Blunk-electronic/TRAIN-Z/README.md

# TRAIN-Z
A open hardware and software embedded Z80 computer
Please find more colorful details at
http://www.blunk-electronic.de/train-z/
