Blunk-electronic/TRAIN-Z/hardware/bus_monitor/verilog/ise/main_summary.html

Z80_IF Project Status
Project File: | Z80_IF.ise | Implementation State: | Fitted
Module Name: | main | Errors: | No Errors
Target Device: | xc3s400-5pq208 | Warnings: | 7 Warnings
Product Version: | ISE 11.1 | Routing Results:
Design Goal: | Balanced | Timing Constraints:
Design Strategy: | Xilinx Default (unlocked) | Final Timing Score:

Detailed Reports | | | | | | [-]
Report Name | Status | Generated | Errors | Warnings | Infos
Synthesis Report | Current | Tue Sep 25 10:21:02 2012 | 0 | 7 Warnings | 0
Translation Report | Current | Tue Sep 25 10:21:07 2012 | 0 | 0 | 0
CPLD Fitter Report (Text) | Current | Tue Sep 25 10:21:10 2012 | 0 | 1 Warning | 0
Power Report

Secondary Reports | | | [-]
Report Name | Status | Generated
Post-Fit Simulation Model Report

Date Generated: 01/20/2015 - 09:17:47
