Blunk-electronic/TRAIN-Z/doc/pdf/um_bm_en.pdf

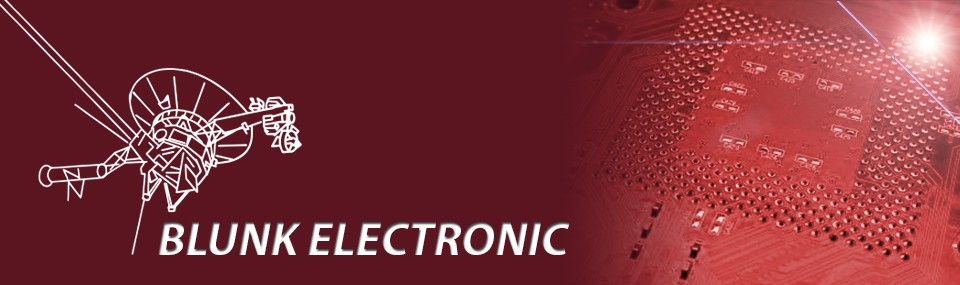
[picture p53: figure]

### PRODUCT BRIEF Self-Assembly Kit

# Z80 Bus Monitor & Cycle Stepper User Manual

## Please read carefully before power up !

Doc. Version 2013-10-28-1
Author: Mario Blunk

Firmware Version: V1.1
Hardware Version: V1.1

Blunk electronic at www.trainz.de (http://www.train-z.de/)

## Table of Contents

### 1 Preface

With the objective of improving System TRAIN-Z (http://www.train-z.de/train-z) toward a development system a bus monitor in connection with a cycle stepper circuitry was an immanent user demand. So a peripheral extension with these components has been designed. The whole unit, further on just referred to as Bus Monitor, fits on a single euro sized fourlayer board (160 x 100 mm). See Photo 1. It is fully programmable via any hardware description language like Verilog or VHDL. The HDL-design presented here has been written in Verilog on the Xilinx (http://www.xilinx.com/) System ISE.

System TRAIN-Z does not aim to compete with the

powerful and sophisticated embedded computer systems of today.

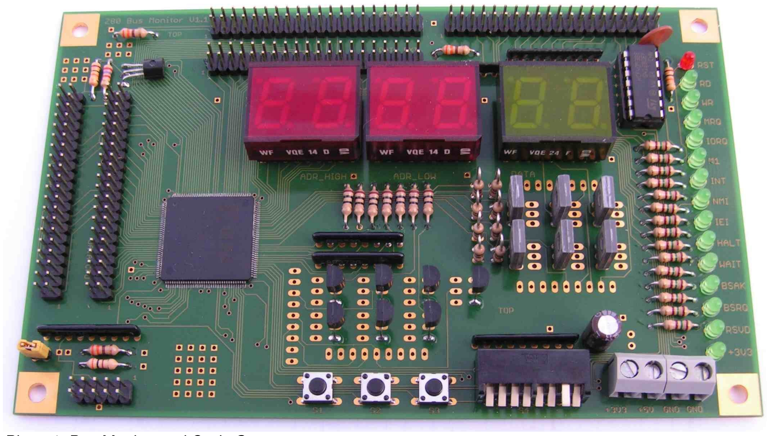
[picture p54: figure]

Blunk electronic at www.trainz.de (http://www.train-z.de/) | 3

Photo 1: Bus Monitor and Cycle Stepper

What is the Bus Monitor good for ?

Single Step Z80 mnemonics execution (Please have the listfile handy.)

Address, Data and Control signal Debugging

PIO mode to control user specific hardware

Level-Shifter from 5V Z80 world to 3,3V peripheral world

Direct mounting on top of System TRAIN-Z via standoffs.

### 2 Hardware

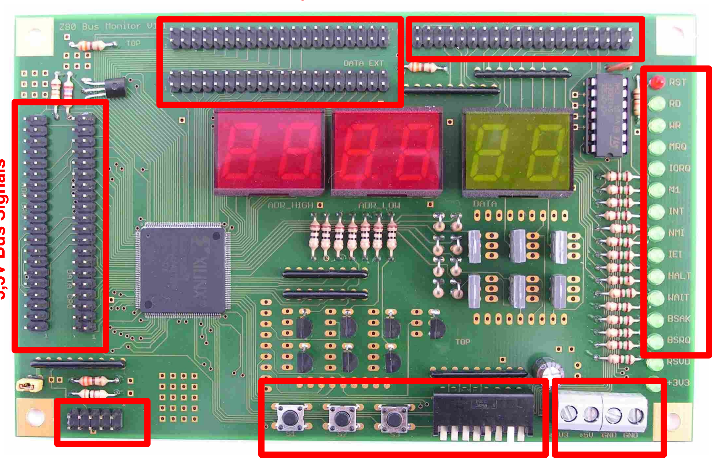
[picture p55: figure]

4 | Blunk electronic at www.trainz.de (http://www.train-z.de/)

Photo 2: Bus Monitor Top View

3,3V Bus Signals | PIO & DEBUG
Push-Buttons & Mode Switch | 3,3V power in JTAG

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
ntrol L

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
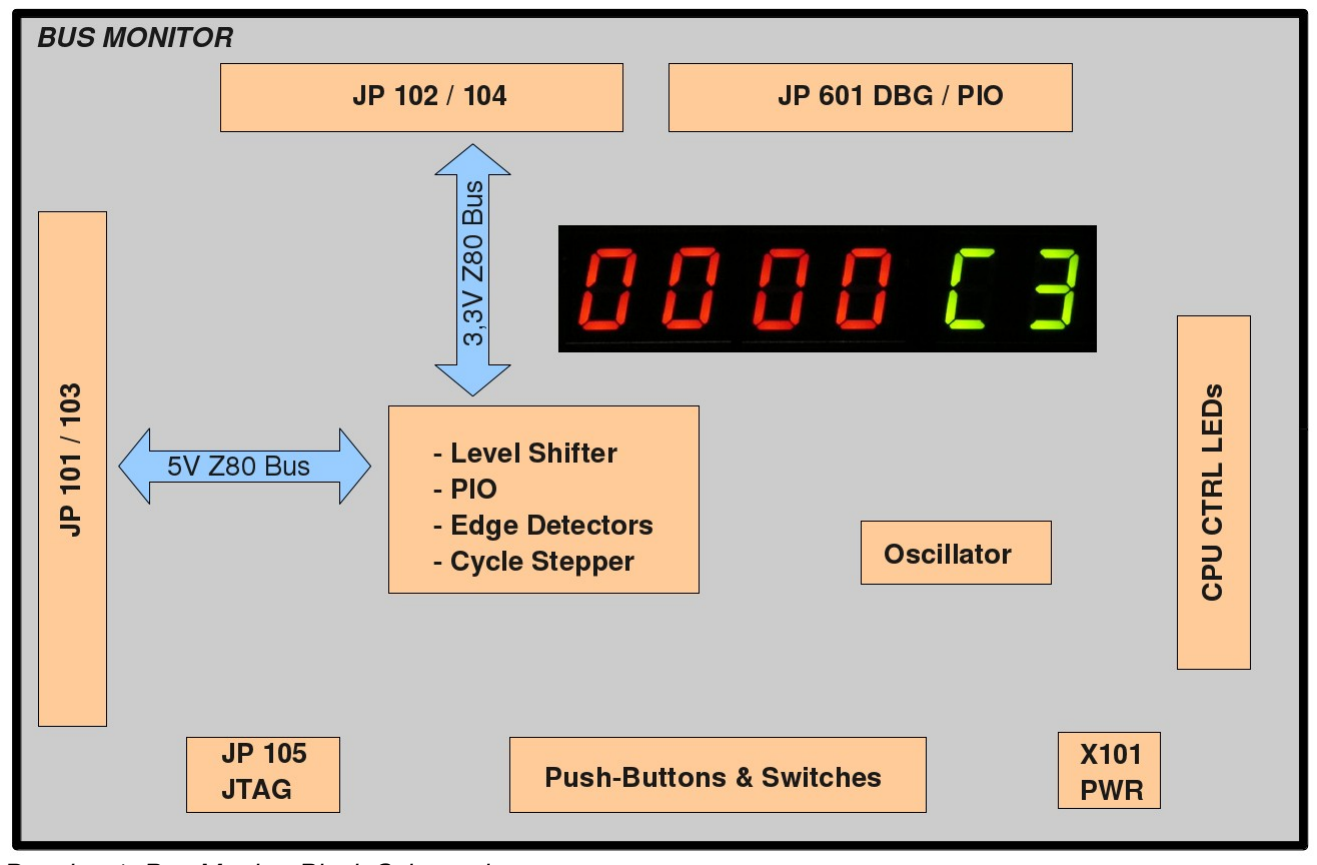
[picture p56: figure]

Drawing 1: Bus Monitor Block Schematic

2.1 Z80-System Bus Connectors

All 5V-signals of the system bus coming from the Z80 CPU are connected to JP101 and JP103. JP101 holds the data bus D[7..0], JP103 holds the address bus A[15..0]. The control signals are distributed on both JP101 and JP103. Drawing 2 shows the their pins. If ribbon cables get plugged on both of them the result is a GND signal between two bus signals. Most suitable are IDE-ribbon cables used in many PCs (Photo 3 page 6). Table 1 on page 7 and Table 2 on page 8 give the signals connected to JP101 and JP103.

All 3,3V-signals of the system bus going to the peripherals are connected to JP102 and JP104.

If not noted otherwise, the DC input/output specifications of these pins are to be found in the XC95288XL datasheet at www.xilinx.com.

Note: All wires of the IDE-ribbon cables must be accessible.

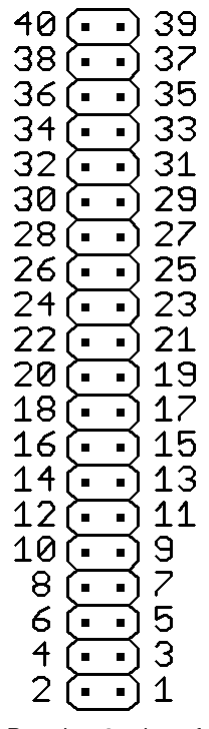
[picture p57: figure]

Drawing 2: pins of
JP101 / JP102 and
JP103 / JP104

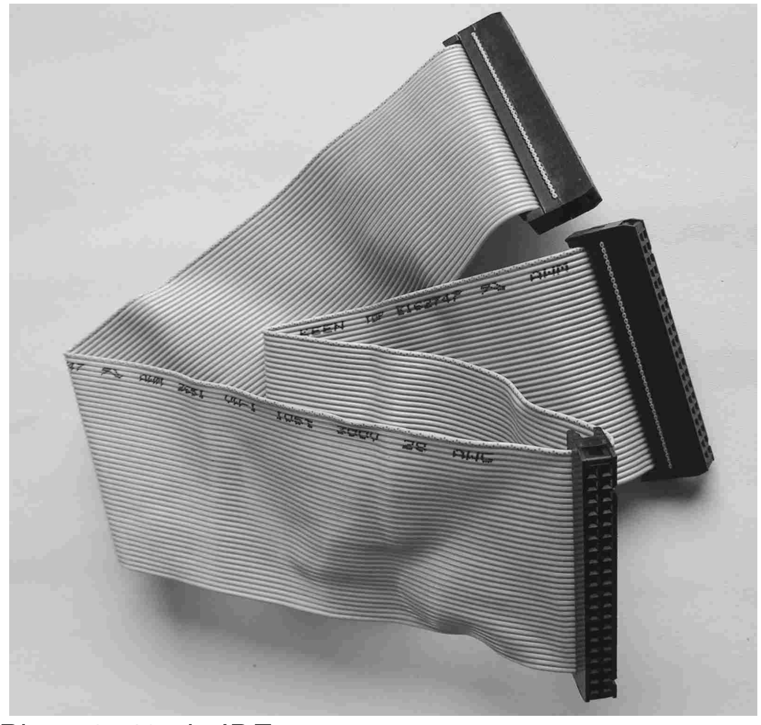
[picture p58: figure]

Photo 3: 40 pin IDE connector

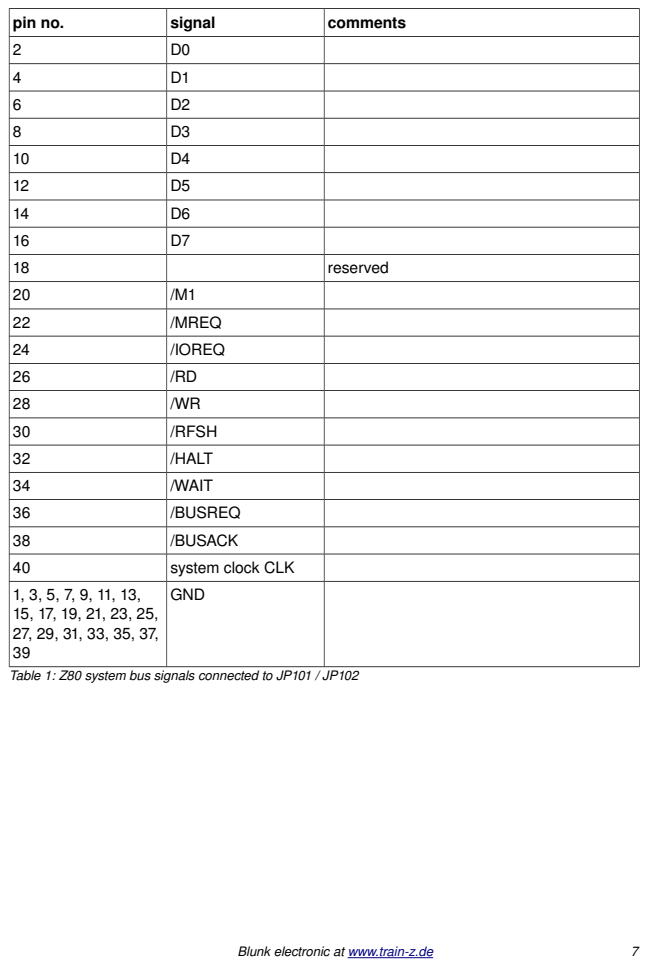
[picture p59: page 7]

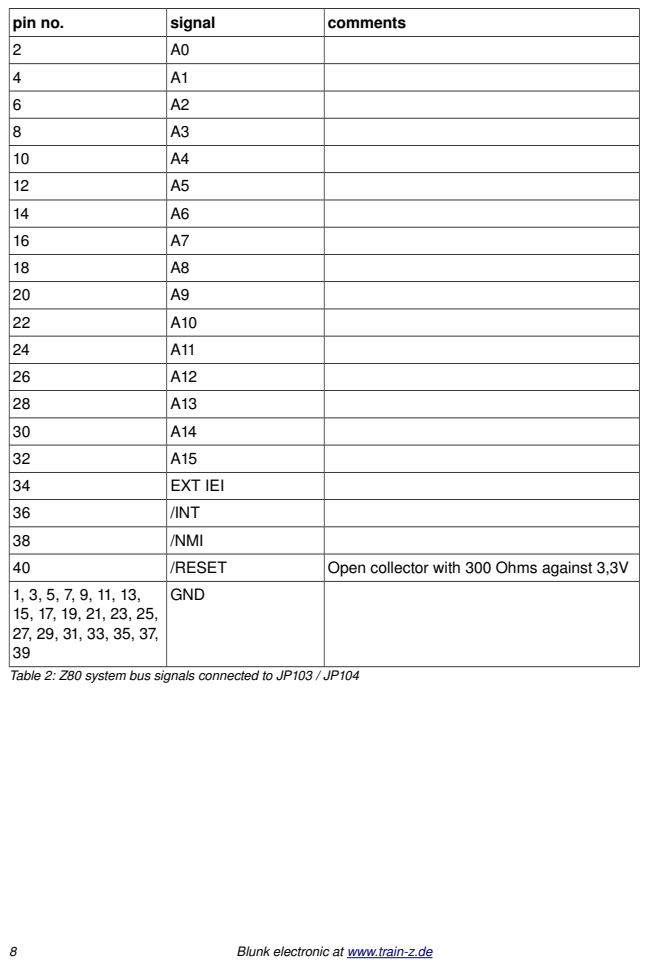
[picture p60: page 8]
pin no.; signal; comments; EXT IEI; /INT; /NMI; /RESET; Open collector with 300 Ohms against 3,3V; GND; Table 2: Z80 system bus signals connected to JP103 / JP104

2.2 PIO and Debug Connector

The eight 3,3V PIO channels are to be found at JP601. Furtheron signals for debugging, schmitttrigger in/outputs and
/CPU_RESET are accessible there.

If not noted otherwise, the DC input/output specifications of these pins are to be found in the XC95288XL datasheet at www.xilinx.com.

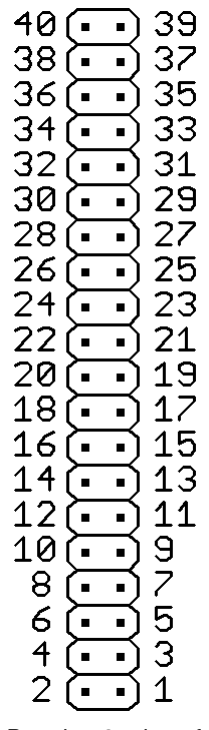
[picture p61: figure]

Drawing 3: pins of
JP601

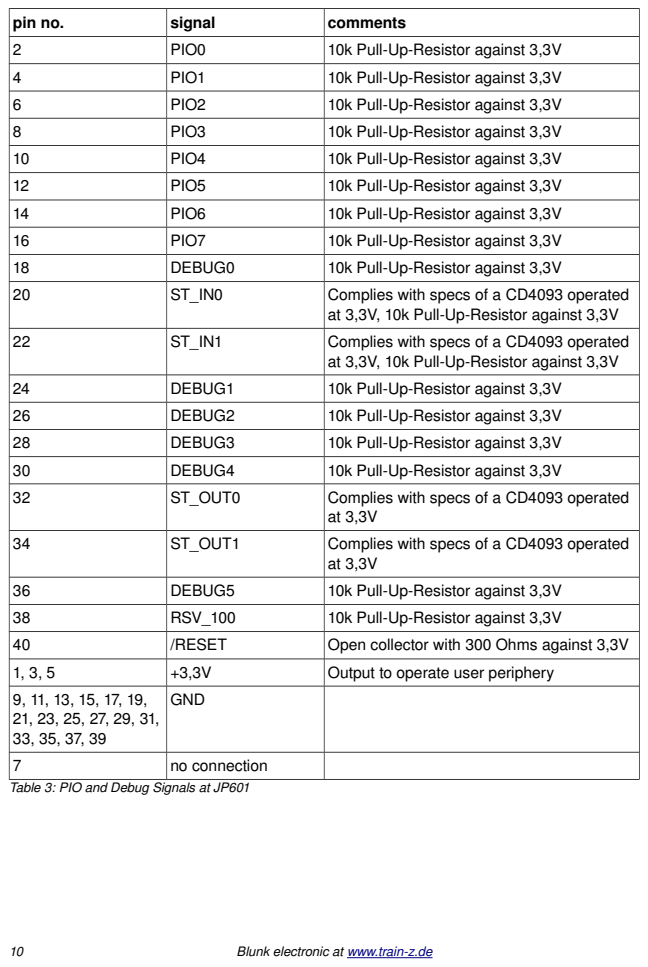
[picture p62: page 10]
pin no.; signal; comments; PIO0; 10k Pull-Up-Resistor against 3,3V; PIO1; PIO2; PIO3; PIO4; PIO5; PIO6; PIO7; DEBUG0; Complies with specs of a CD4093 operated; DEBUG1; DEBUG2; DEBUG3; DEBUG4; ST_OUT0; ST_OUT1; DEBUG5; RSV_100; /RESET; Open collector with 300 Ohms against 3,3V; Output to operate user periphery; GND; no connection

at 3,3V, 10k Pull-Up-Resistor against 3,3V

Table 3: PIO and Debug Signals at JP601

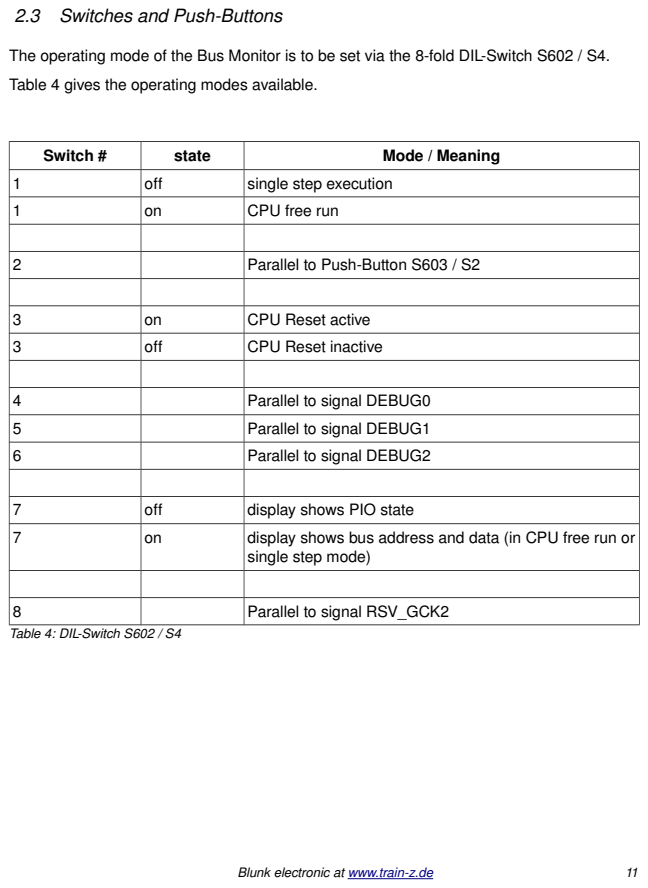
[picture p63: page 11]
Switch #; state; Mode / Meaning; off; single step execution; CPU free run; Parallel to Push-Button S603 / S2; CPU Reset active; CPU Reset inactive; Parallel to signal DEBUG0; Parallel to signal DEBUG1; Parallel to signal DEBUG2; display shows PIO state; display shows bus address and data (in CPU free run or; Parallel to signal RSV_GCK2

2.3 Switches and Push-Buttons

The operating mode of the Bus Monitor is to be set via the 8-fold DIL-Switch S602 / S4.
Table 4 gives the operating modes available.

single step mode)

Table 4: DIL-Switch S602 / S4

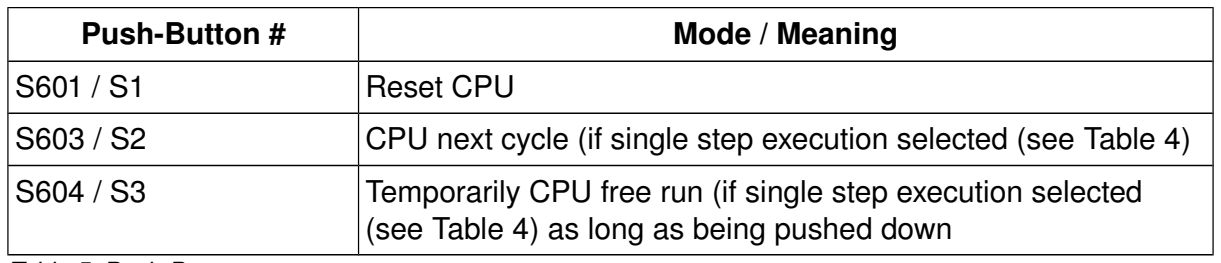
[picture p64: figure]
Push-Button #; Mode / Meaning; Reset CPU

S603 / S2 | CPU next cycle (if single step execution selected (see Table 4)
S604 / S3 | Temporarily CPU free run (if single step execution selected (see Table 4) as long as being pushed down

Table 5: Push-Buttons

2.4 Display

The Z80 Address and Data Bus or the PIO content may be displayed via the 6 digit LED displays DIS302, DIS301 (red) and DIS303 (green). In Bus Monitor mode the red displays show the current state of the address bus while the green display shows the data bus content.

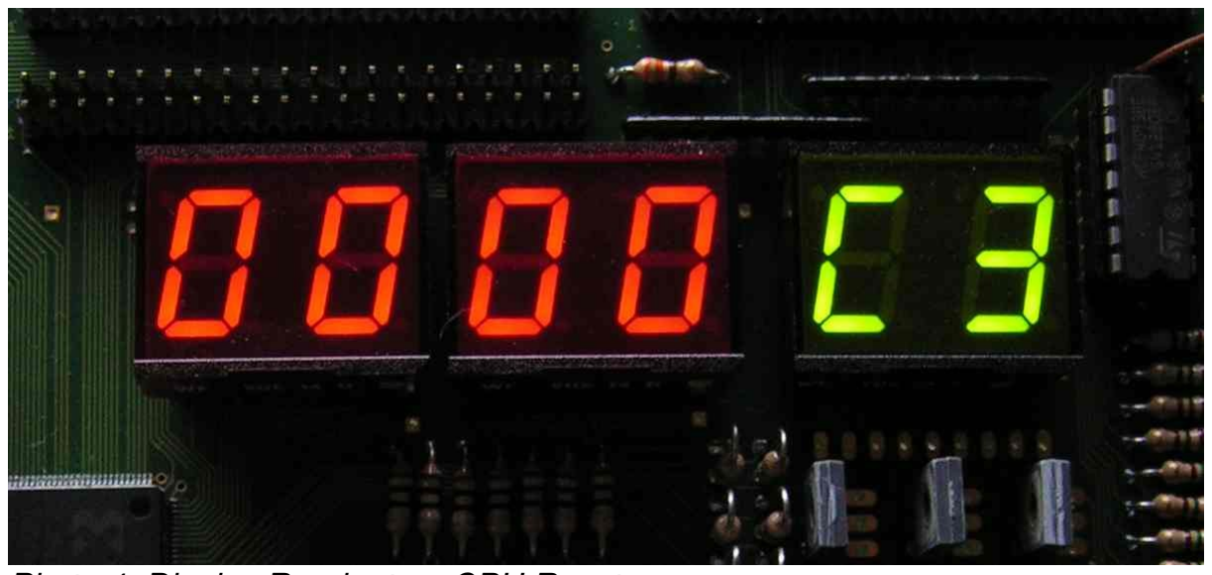
[picture p65: figure]

In PIO mode there are three eight bit wide output registers at I/O addresses 50h through 52h. They can be written at by CPU OUT commands any time. If switch 7 of S602 / S4 is off, the register content is displayed (see Table 4). Reading from these locations via the CPU IN commands is also possible any time. DIS302 and DIS301 show the content of the I/O addresses 51h and 52h.

Photo 4: Display Readout on CPU Reset

Adr[15:8] or
I/O Adr. 52h

Adr[7:0] or
I/O Adr. 51h

Data[7:0] or
I/O Adr. 50h

The output of the register at location 50h is of opendrain characteristic and is connected to JP601 (see Table 3 on page 10). The very bit of this register set to H may serve as input channel to read the status of the PIO signals at JP601. DIS303 (green) shows the content of that register.

As this is a selfassembly kit, the displays need to be soldered or plugged by the user.

2.5 CPU control LEDs

These green LEDs indicate High-Low transitions (or negative edges) occurring on the Z80 control signals. On edge detection the LED affected flashes for about 0,1 seconds. See Photo 2 on page 4. The meaning of the LEDs is self explaining.

Note: The status of the CPU REFRESH signal is not displayed via an LED.

2.6 JTAG / IEEE 1149.1

To program the CPLD the IEEE1149.1 signals are accessible via JP105 .SeeTable 6.


Pin | Meaning | comments
1 | TCK
3 | TMS
5 | TDI | default
7 | TDO
10 | Vref | Required Xilinx Programming Cable

2, 4, 6, 8 GND
Table 6: JTAG signals

NOTE: Some boundary scan masters may not require a reference voltage or may even get damaged if this voltage is provided by the Bus Monitor.

To disconnect the reference voltage provided by the Bus Monitor from JP105, please

Drawing 4: pins of
JP105 remove the jumper from JP106.

2.7 Schematics and Assembly Drawings

As these drawings are updated from time to time they are not included in this document. Please find them at:

# http://www.trainz.de/trainz/hw (http://www.train-z.de/train-z/hw)

2.8 Power Supply

The operating voltage of +3,3V into X101. Please refer to the assembly drawing for labeling of X101. The green LED D101 displays the presence of the operating voltage.

Table 7: power consumption MMU

## Warning:

The board does NOT provide any protection against overvoltage or wrong connecting of the power lines !

The tolerance of the +3,3V operating voltage must meet the specifications given in the Xilinx XC95288XL datasheet !
Beyond this limits malfunctions or damage of the board may occur.

### 3 Self Assembly Shipment Option

You may order just the bare boards of the Bus Monitor without any devices soldered on it.

### 4 RoHS conformity

The Bus Monitor board without the displays is RoHS compliant.

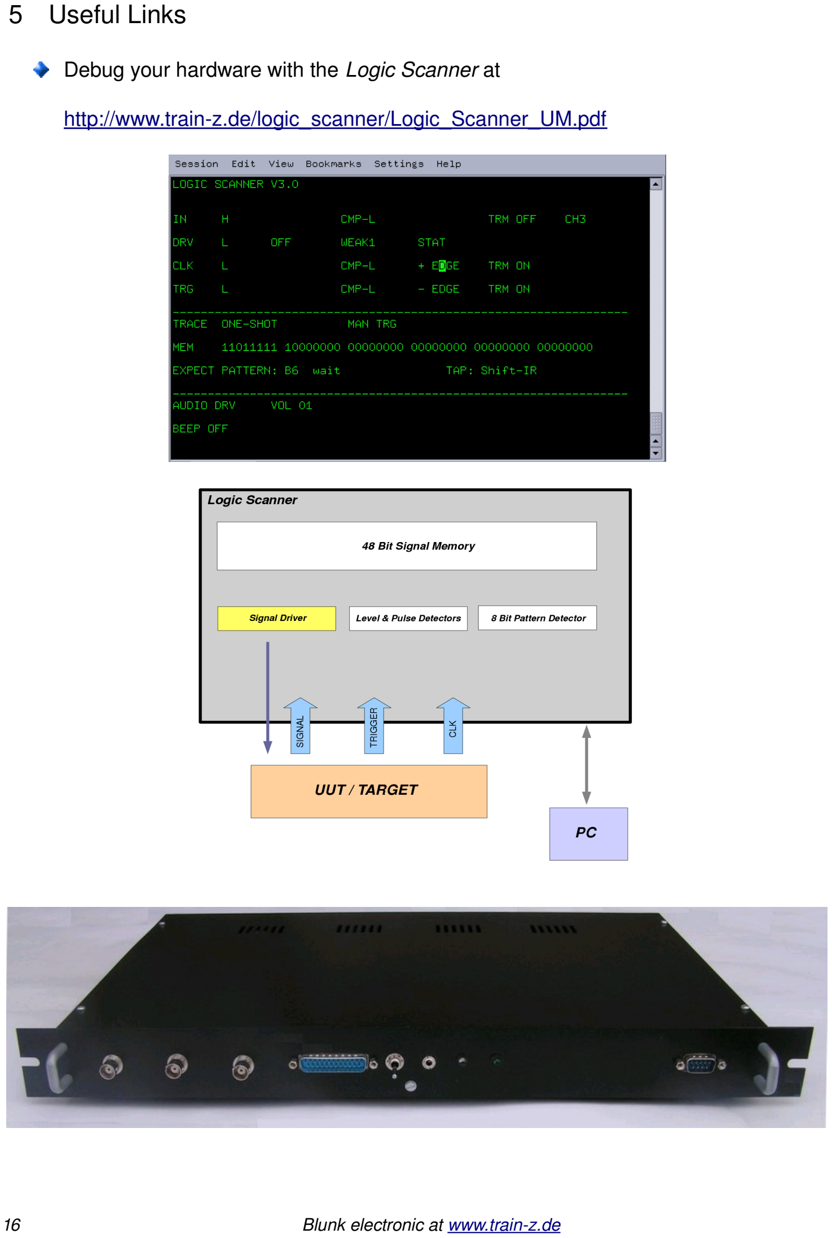
[picture p66: page 16]

### 5 Useful Links

Debug your hardware with the Logic Scanner at

http://www.trainz.de/logic_scanner/Logic_Scanner_UM.pdf (http://www.train-z.de/logic_scanner/Logic_Scanner_UM.pdf)

A complete embedded Z80 system can be found at

http://www.trainz.de/trainz (http://www.train-z.de/train-z)

The Free and Open Productivity

Suite LibreOffice at http://www.libreoffice.org

Z80 Verilog and VHDL Cores at http://www.castinc.com (http://www.cast-inc.com/) and http://opencores.org

Z80 Application Notes at http://www.trainz.de/trainz/index.html (http://www.train-z.de/train-z/index.html)

EAGLE an affordable and very efficient
schematics and layout tool at
http://www.cadsoftusa.com/

### 6 Disclaimer

This manual is believed to be accurate and reliable. I do not assume responsibility for any errors which may appear in this document. I reserve the right to change devices or specifications detailed herein at any time without notice, and do not make any commitment to update the information contained herein. I do not assume responsibility for any design errors which may appear in the hardware nor in the software of this product nor for modifications made by the user. This product is not authorized for use as critical component in life support devices or systems.

Specifications mentioned in this manual are subject to change without notice.

My Boss is a Jewish Carpenter

Blunk electronic / Oolder Mario Blunk / Buchfinkenweg 5 / 99097 Erfurt / Germany +49 (0) 176 2904 5855 / http://www.trainz.de (http://www.train-z.de/)

© 2013 Mario Blunk | Printed in Germany
