Blunk-electronic/TRAIN-Z/doc/drawings/bus_monitor.jpg

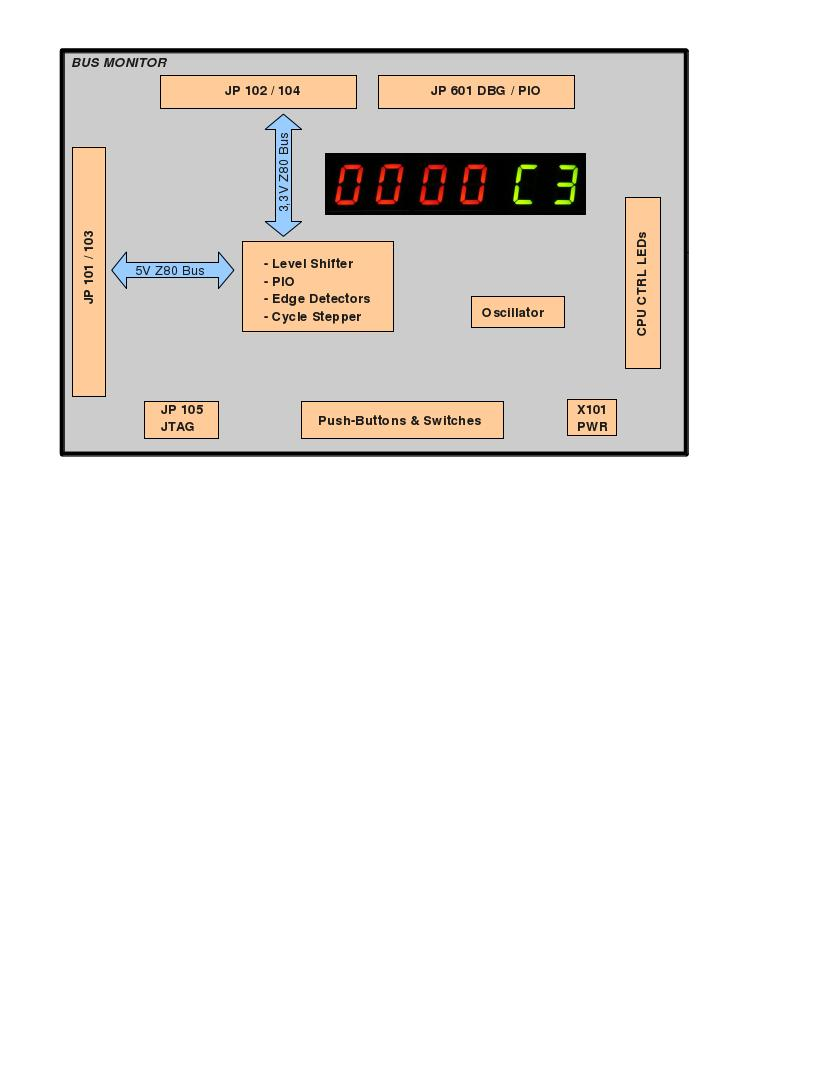
doc/drawings/bus_monitor.jpg
