Blunk-electronic/TRAIN-Z/doc/drawings/jp_2x7.png

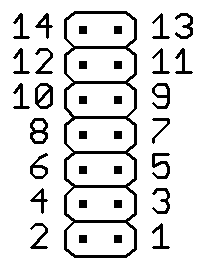
doc/drawings/jp_2x7.png
