Blunk-electronic/TRAIN-Z/doc/drawings/jp_2x8.png

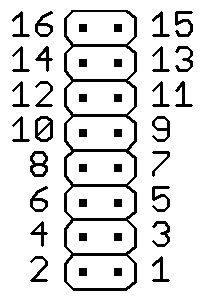
doc/drawings/jp_2x8.png
