Blunk-electronic/TRAIN-Z/doc/drawings/jp_2x9.png

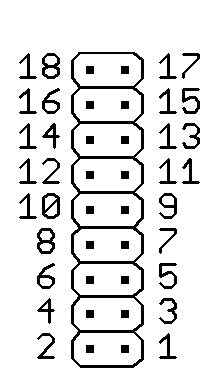
doc/drawings/jp_2x9.png
