Blunk-electronic/TRAIN-Z/doc/drawings/jp_2x10.png

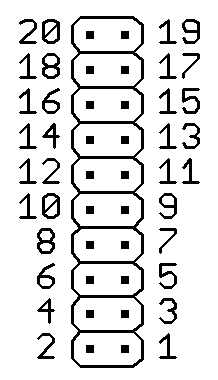
doc/drawings/jp_2x10.png
