Blunk-electronic/TRAIN-Z/doc/drawings/jp_2x17.png

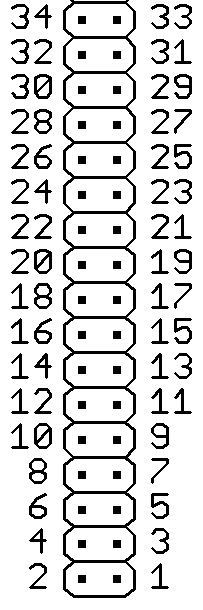
doc/drawings/jp_2x17.png
