Blunk-electronic/TRAIN-Z/hardware/bus_monitor/pdf/Z80_BMO_V1.2.pdf

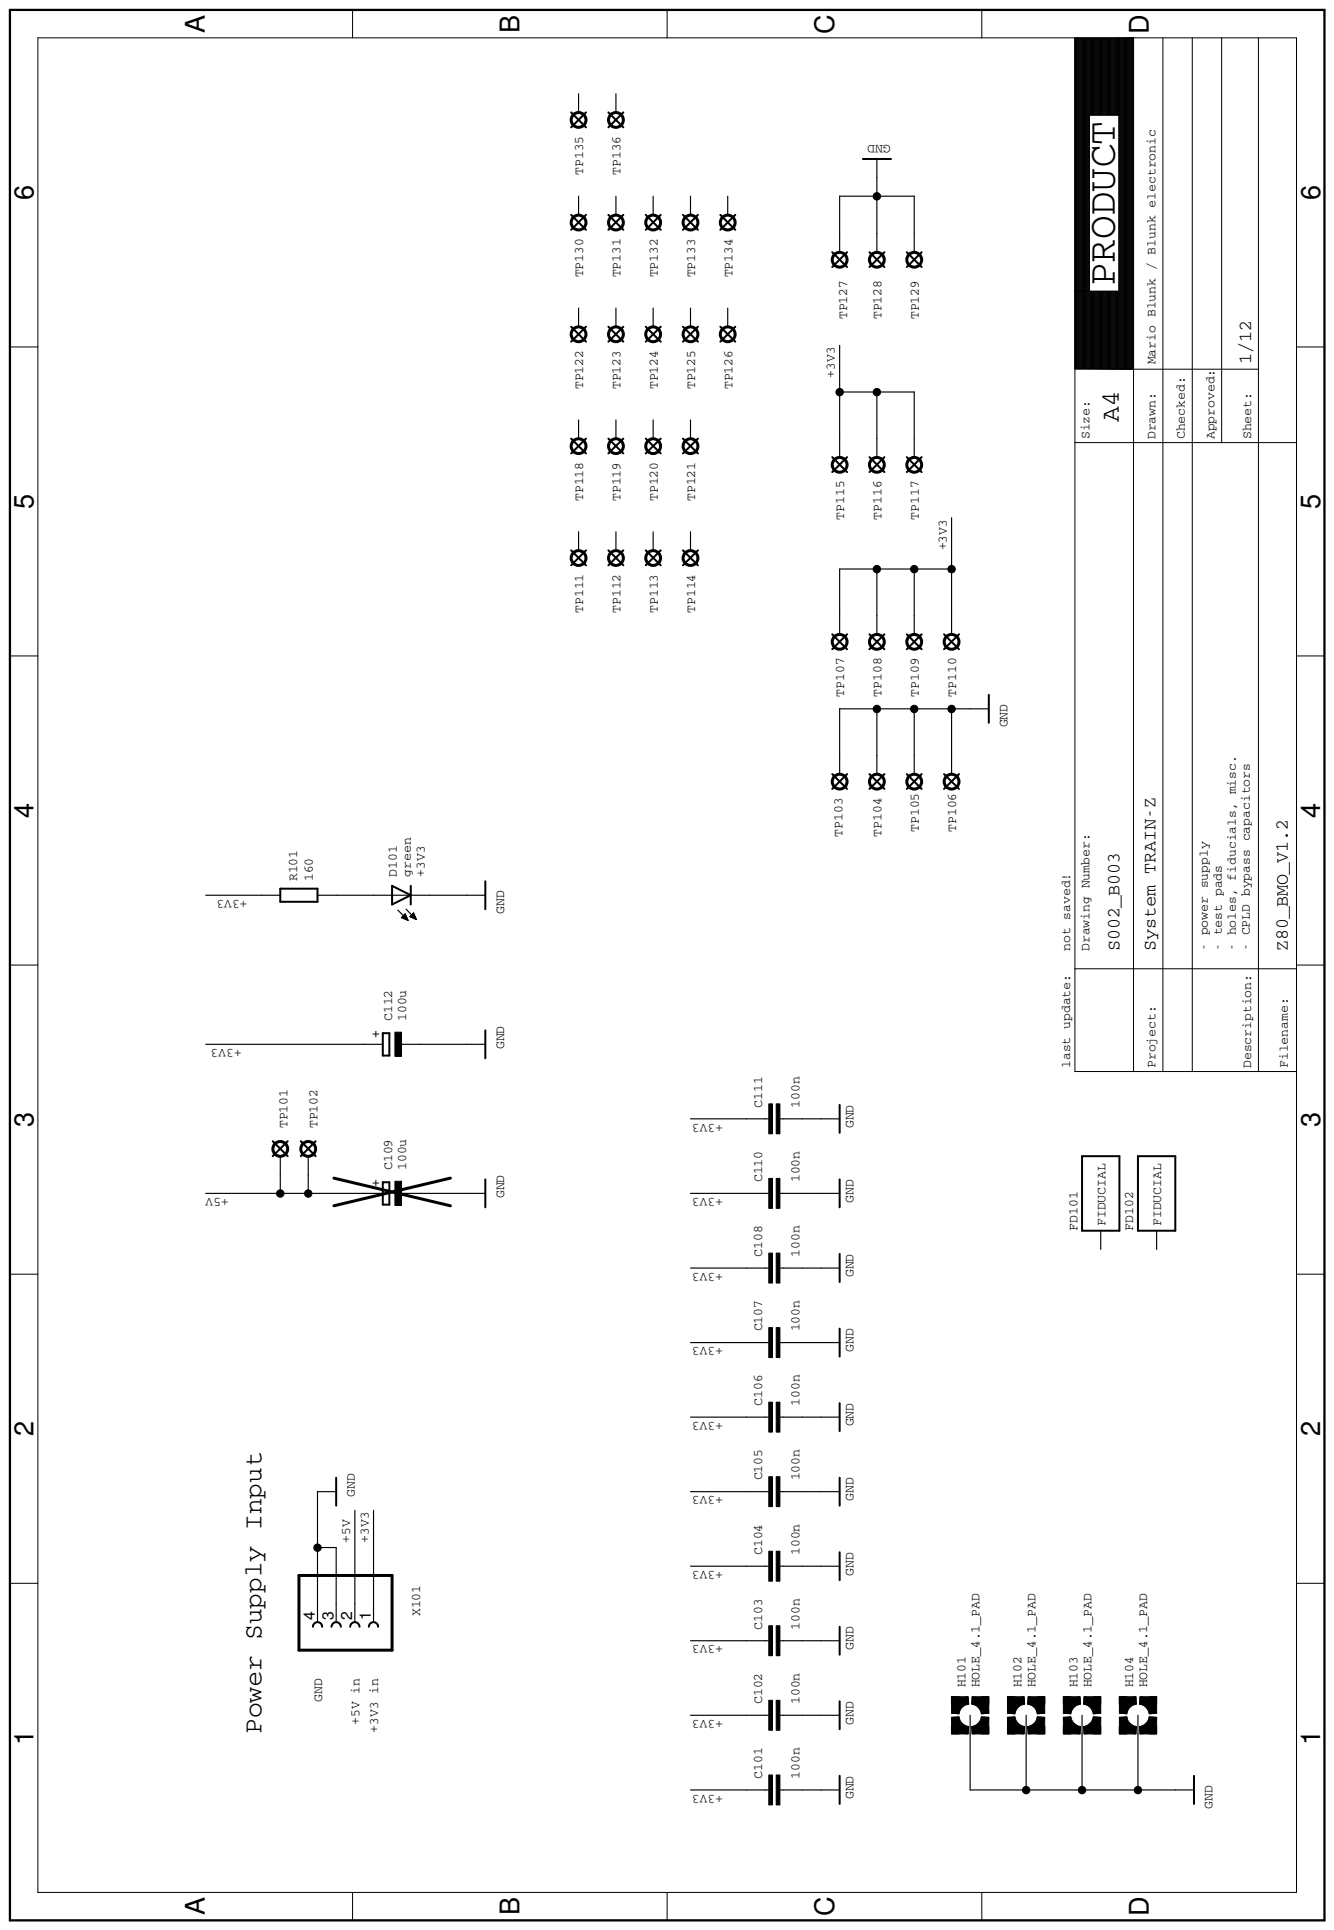
[picture p73: page 1]

+3V3 in +5V in GND 100u GND 100u GND HOLE_4.1_PAD HOLE_4.1_PAD HOLE_4.1_PAD HOLE_4.1_PAD GND green +3V3 160 GND DNG GND Power Supply Input GND 100n GND 100n GND 100n GND 100n GND 100n GND 100n GND 100n GND 100n GND 100n GND 100n GND C112 C109 H101 H102 H103 H104 D101 R101 TP115 TP116 TP117 TP112 TP113 TP118 TP119 TP120 TP121 TP122 TP123 TP124 TP125 TP126 TP130 TP131 TP132 TP133 TP134 TP128 TP127 TP111 TP129 TP114 TP135 TP136 TP103 TP104 TP105 TP106 TP107 TP108 TP109 TP110 TP102 TP101 FD102 FD101 X101 4321C103 C104 C105 C106 C107 C108 C101 C102 C110 C111 3V3+ 3V3+ +3V3 +3V3 +3V3 3V3+ 3V3+ 3V3+ 3V3+ 3V3+ 3V3+ 3V3+ 3V3+ 3V3+ 3V3+ V5+ +5V - power supply - test pads - holes, fiducials, misc. - CPLD bypass capacitors ++ Z80_BMO_V1.2 1/12 ABCD 1 2 3 4 5 6 ABCD 1 2 3 4 5 6 Size: A4 Drawing Number: Checked: Description: Filename: Project: Sheet: Approved: System TRAIN-Z PRODUCT Mario Blunk / Blunk electronic Drawn: last update: not saved! S002_B003 FIDUCIAL FIDUCIAL

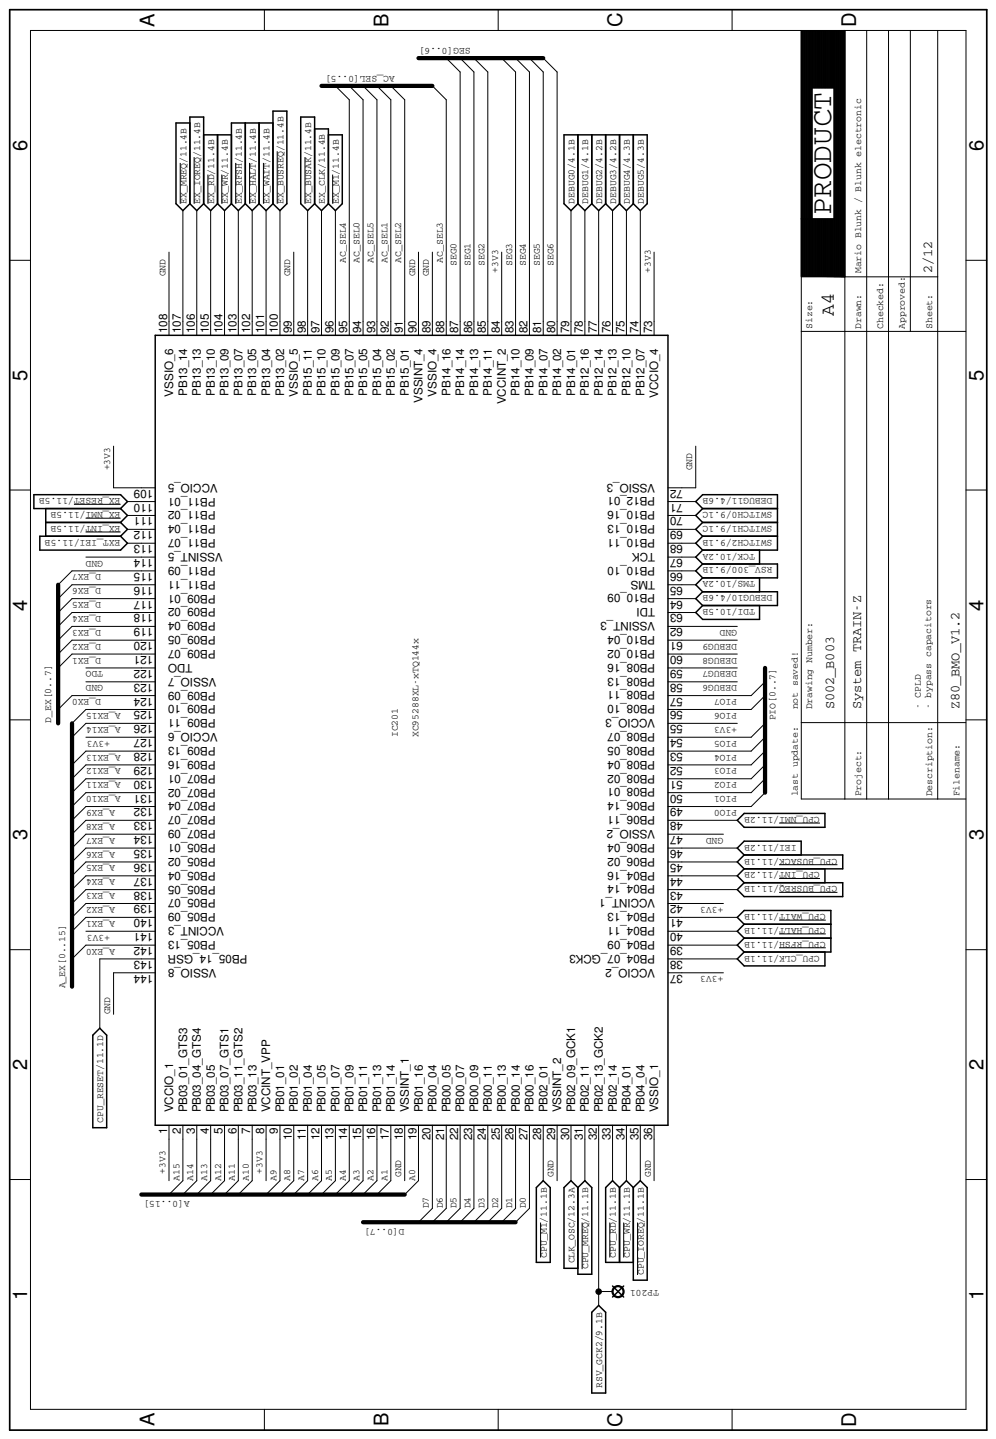
[picture p74: page 2]

Mario Blunk / Blunk electronic Drawn:

last update: not saved! S002_B003

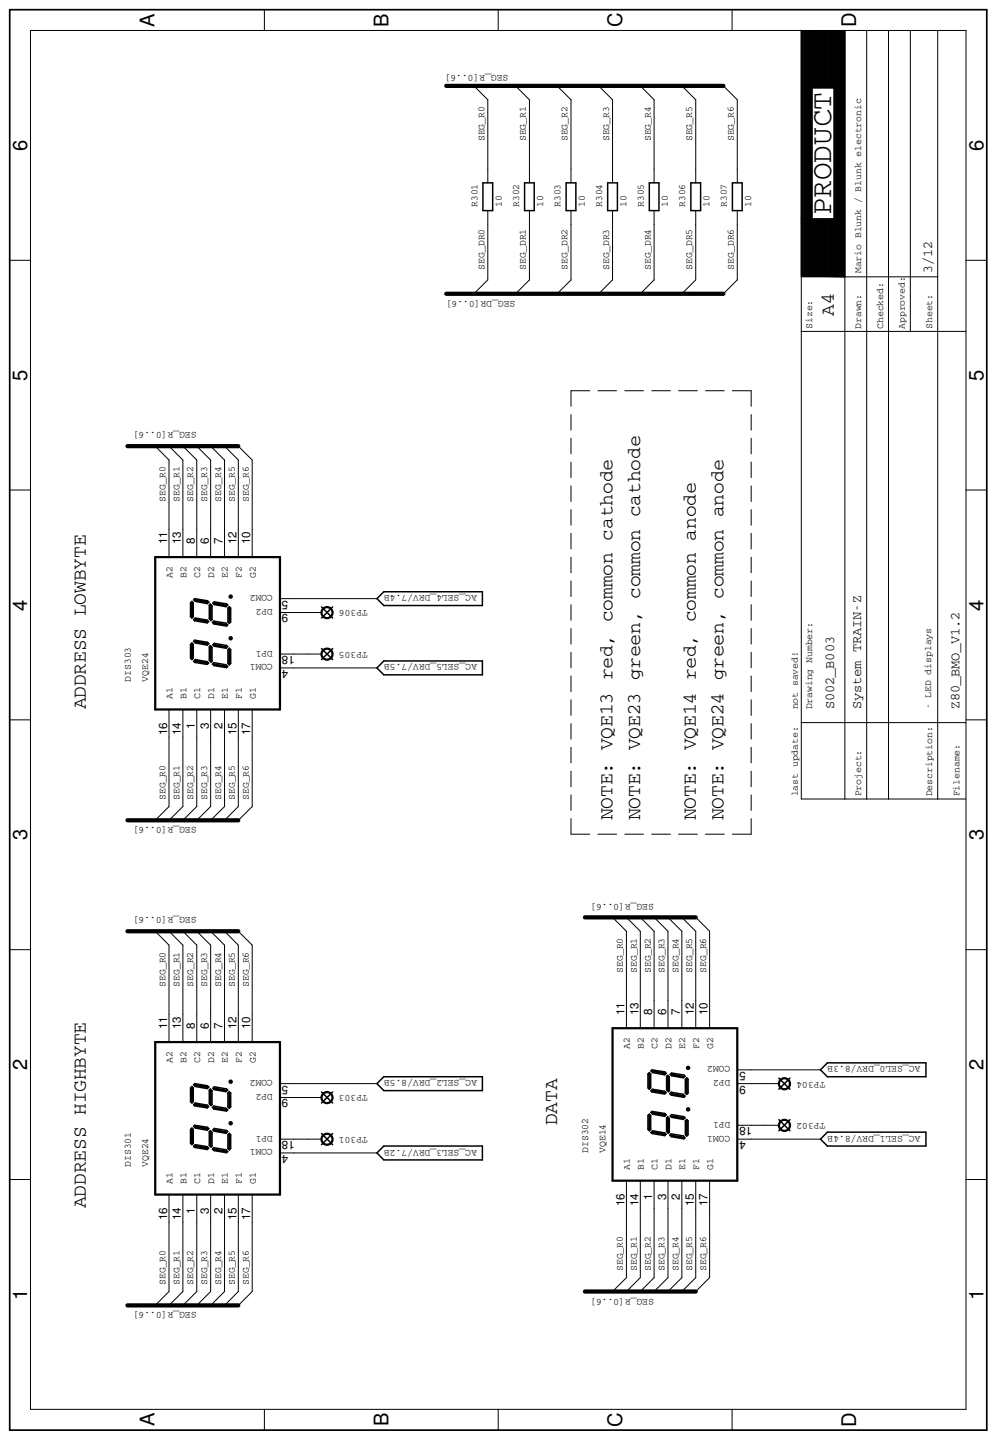
[picture p75: page 3]

Mario Blunk / Blunk electronic Drawn:

last update: not saved! S002_B003

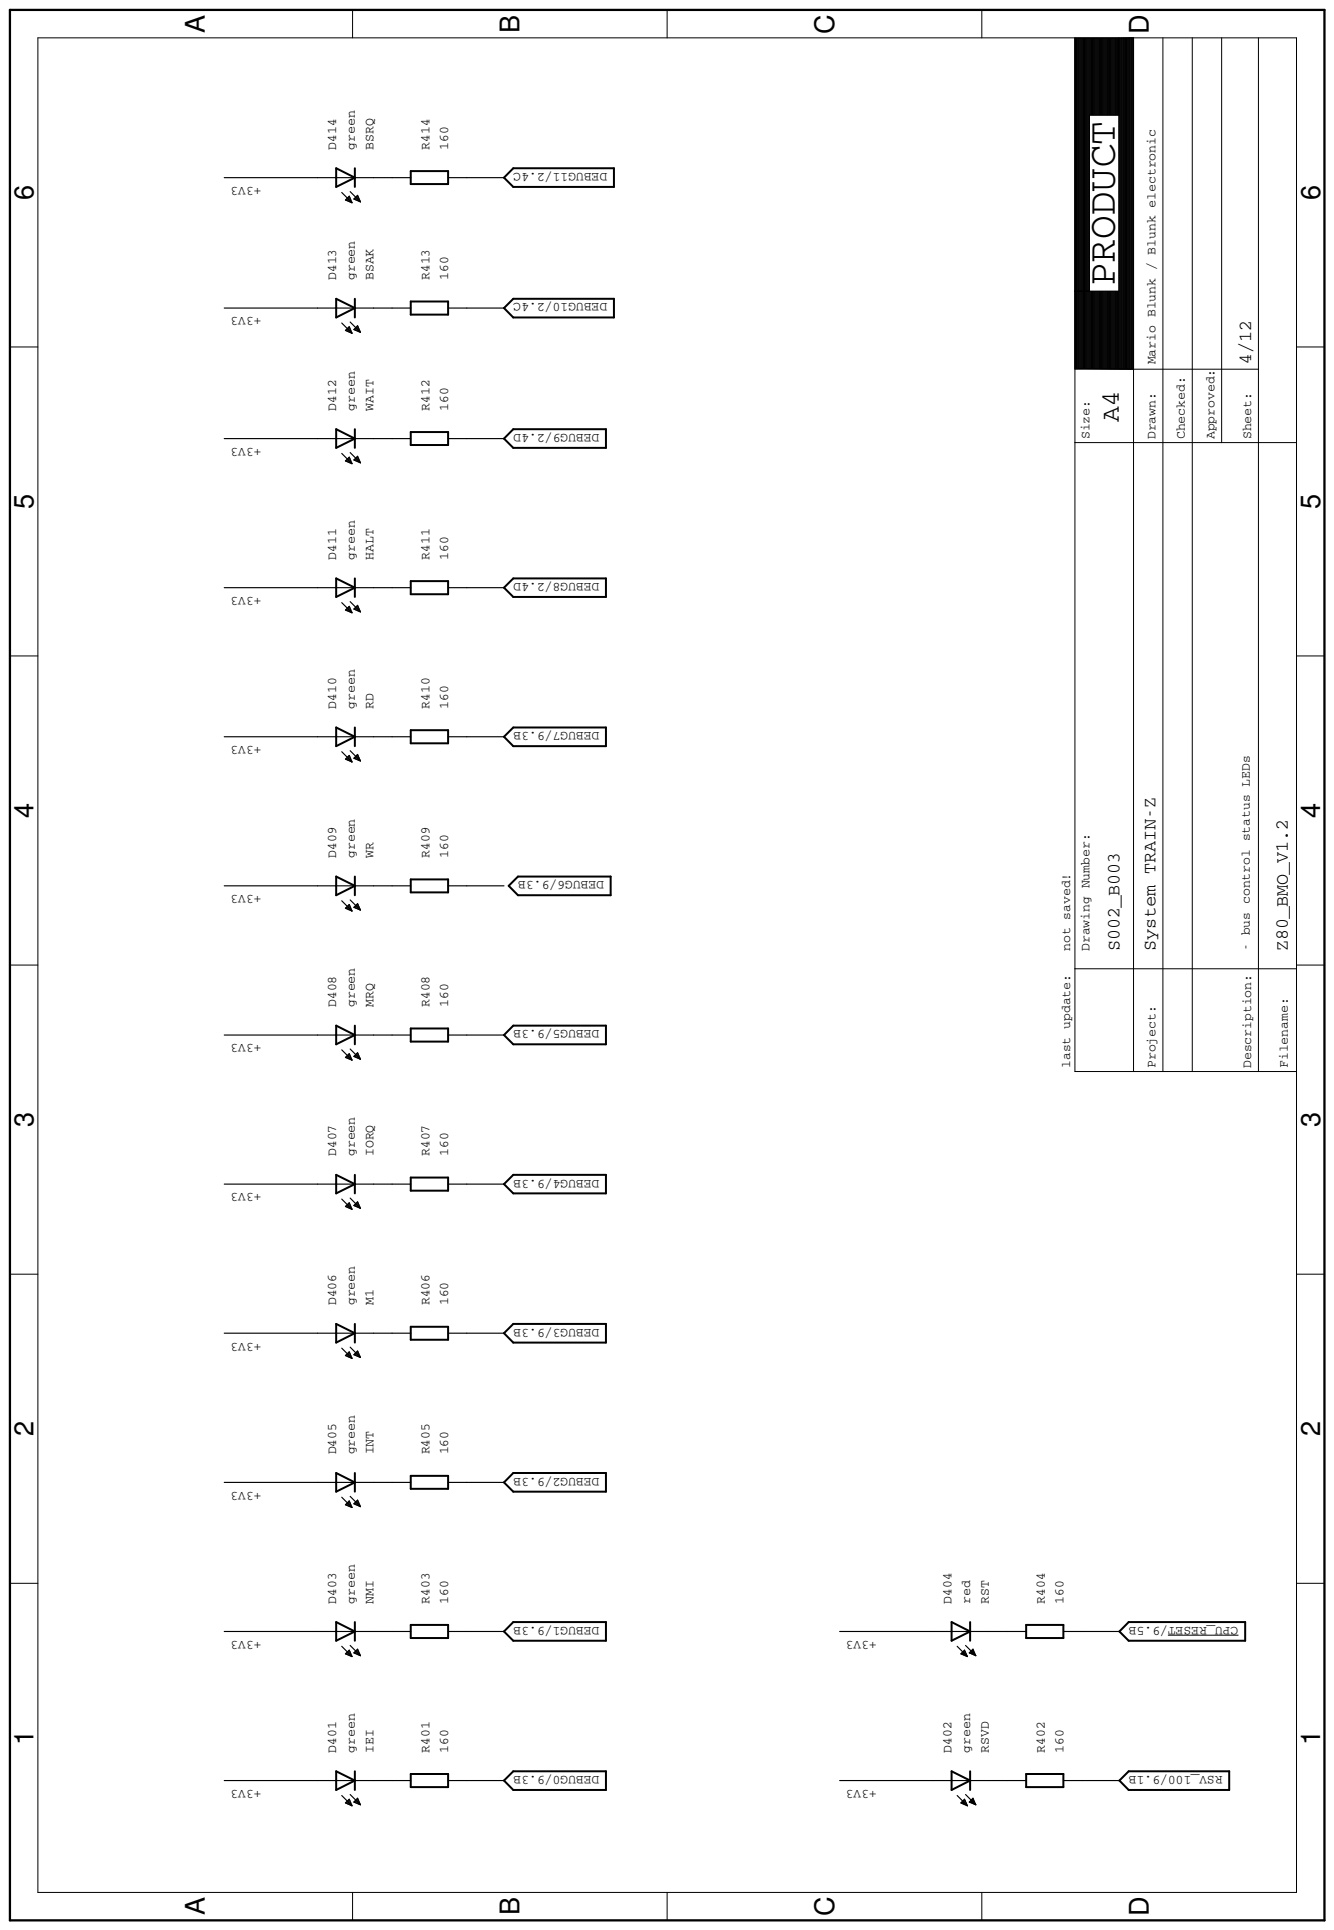
[picture p76: page 4]

160 green IEI 160 green NMI 160 green INT 160 green M1 160 green IORQ 160 green MRQ 160 green WR 160 green RD 160 green HALT 160 green WAIT 160 green BSAK 160 green BSRQ 160 green RSVD 160 red RST R401 D401 R403 D403 R405 D405 R406 D406 R407 D407 R408 D408 R409 D409 R410 D410 R411 D411 R412 D412 R413 D413 R414 D414 R402 D402 R404 D404 3V3+ 3V3+ 3V3+ 3V3+ 3V3+ 3V3+ 3V3+ 3V3+ 3V3+ 3V3+ 3V3+ 3V3+ 3V3+ 3V3+ B3.9/0GUBED B3.9/1GUBED B3.9/2GUBED B3.9/3GUBED B3.9/4GUBED B3.9/5GUBED B3.9/6GUBED B3.9/7GUBED D4.2/8GUBED D4.2/9GUBED C4.2/01GUBED C4.2/11GUBED B1.9/001_VSR B5.9/TESER_UPC - bus control status LEDs Z80_BMO_V1.2 4/12 ABCD 1 2 3 4 5 6 ABCD 1 2 3 4 5 6 Size: A4 Drawing Number: Checked: Description: Filename: Project: Sheet: Approved: System TRAIN-Z PRODUCT Mario Blunk / Blunk electronic Drawn: last update: not saved! S002_B003

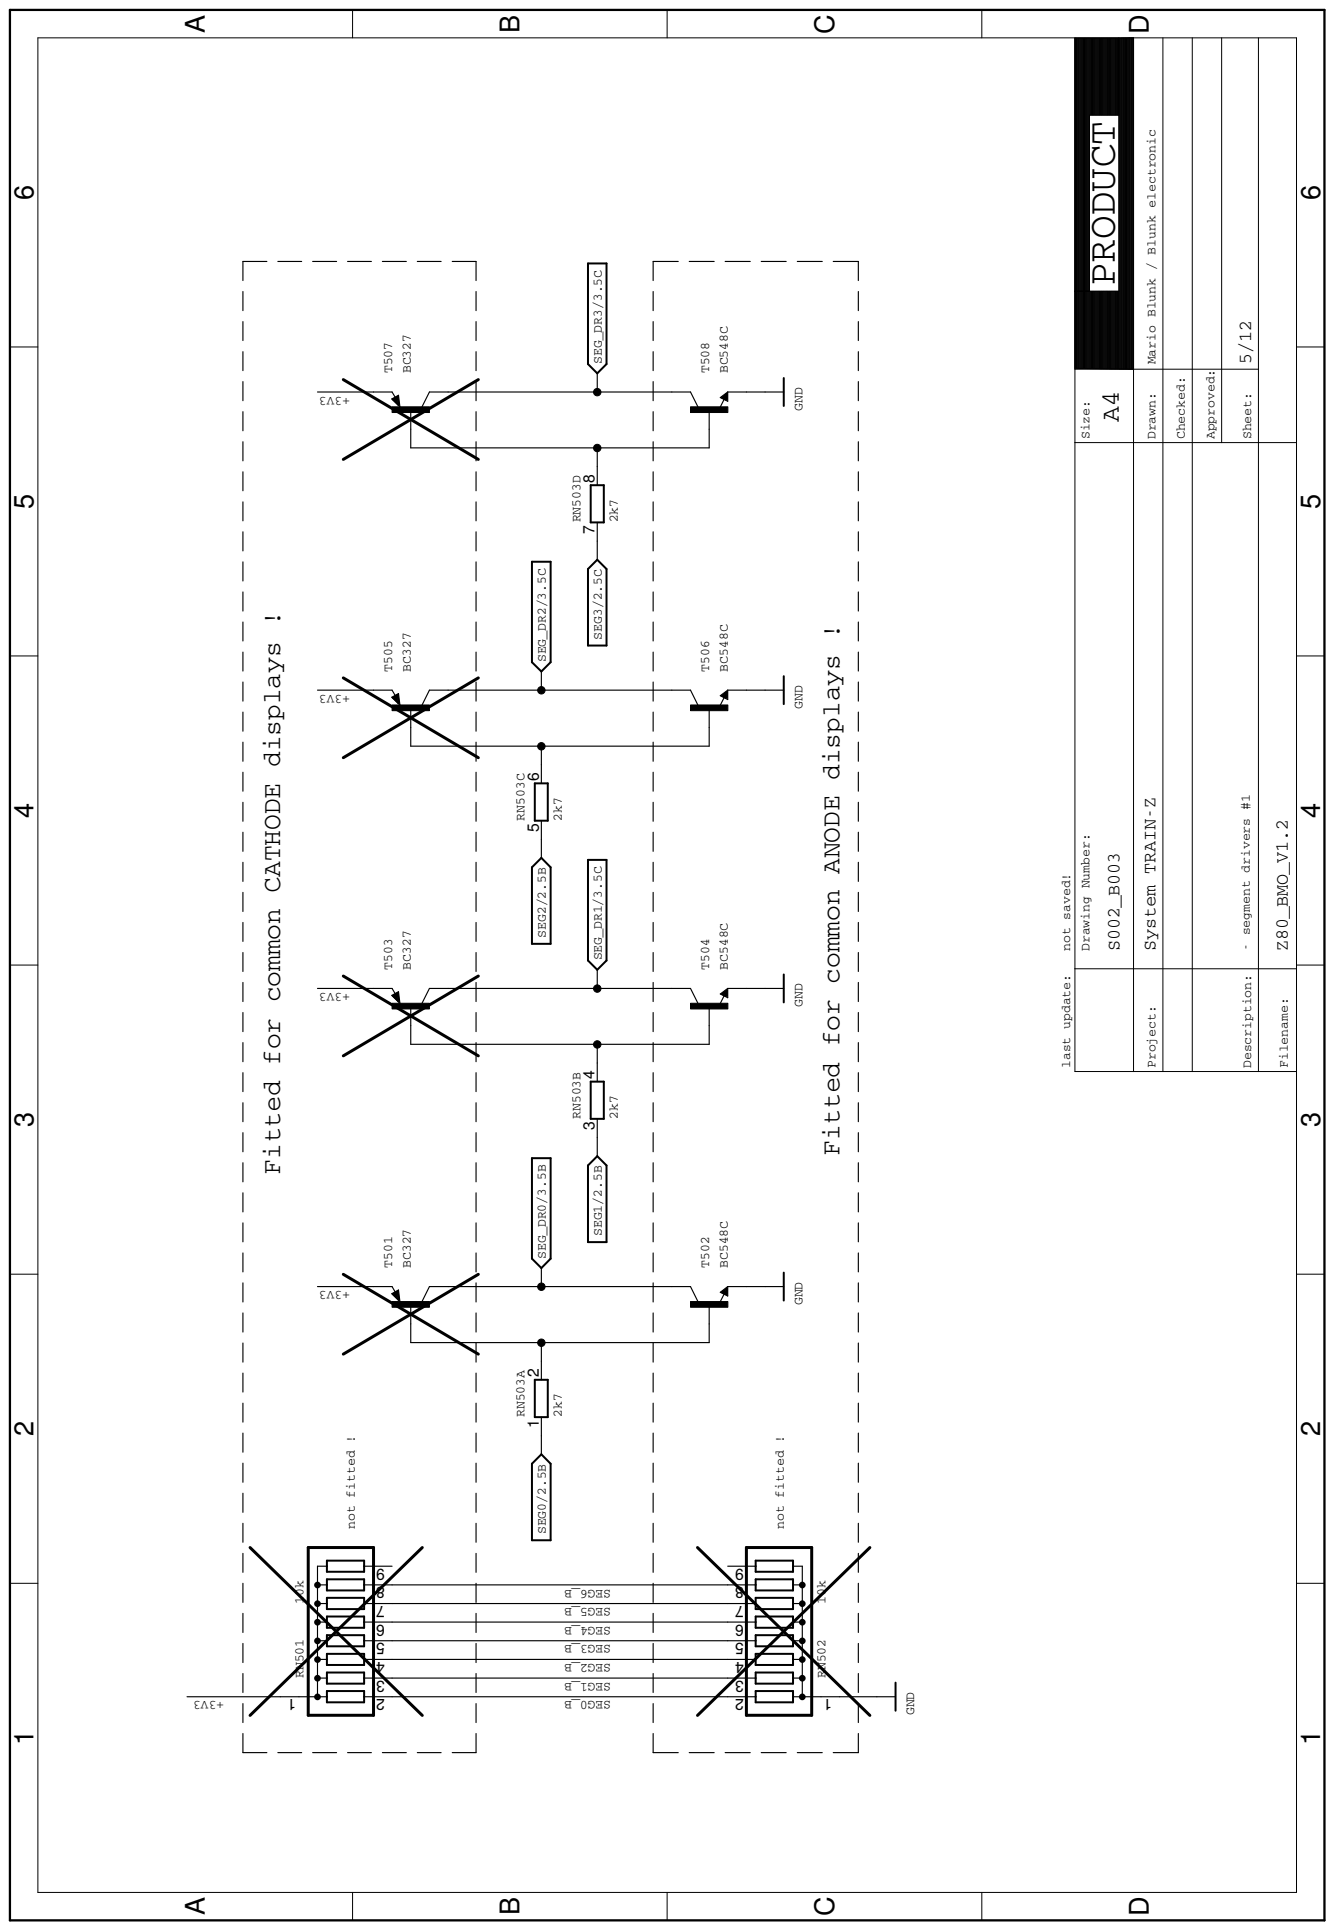
[picture p77: page 5]

Fitted for com on ANODE displays ! Fitted for com on CATHODE displays ! not fitted ! not fitted ! BC548C BC327 GND 2k7 2k7 2k7 2k7 10k 10k GND BC548C BC327 GND BC548C BC327 GND BC548C BC327 GND T502 T501 1 2 RN503A 3 4 RN503B 5 6 RN503C 7 8 RN503D 1 23456789 RN501 2 1 3456789 RN502 T504 T503 T506 T505 T508 T507 SEG_DR3/3.5C SEG_DR2/3.5C SEG_DR1/3.5C SEG_DR0/3.5B B_0GES 3V3+ 3V3+ 3V3+ 3V3+ 3V3+ SEG0/2.5B B_1GES B_2GES B_3GES B_4GES B_5GES B_6GESSEG1/2.5B SEG2/2.5B SEG3/2.5C - segment drivers #1 Z80_BMO_V1.2 5/12 ABCD 1 2 3 4 5 6 ABCD 1 2 3 4 5 6 Size: A4 Drawing Number: Checked: Description: Filename: Project: Sheet: Approved: System TRAIN-Z PRODUCT Mario Blunk / Blunk electronic Drawn: last update: not saved! S002_B003

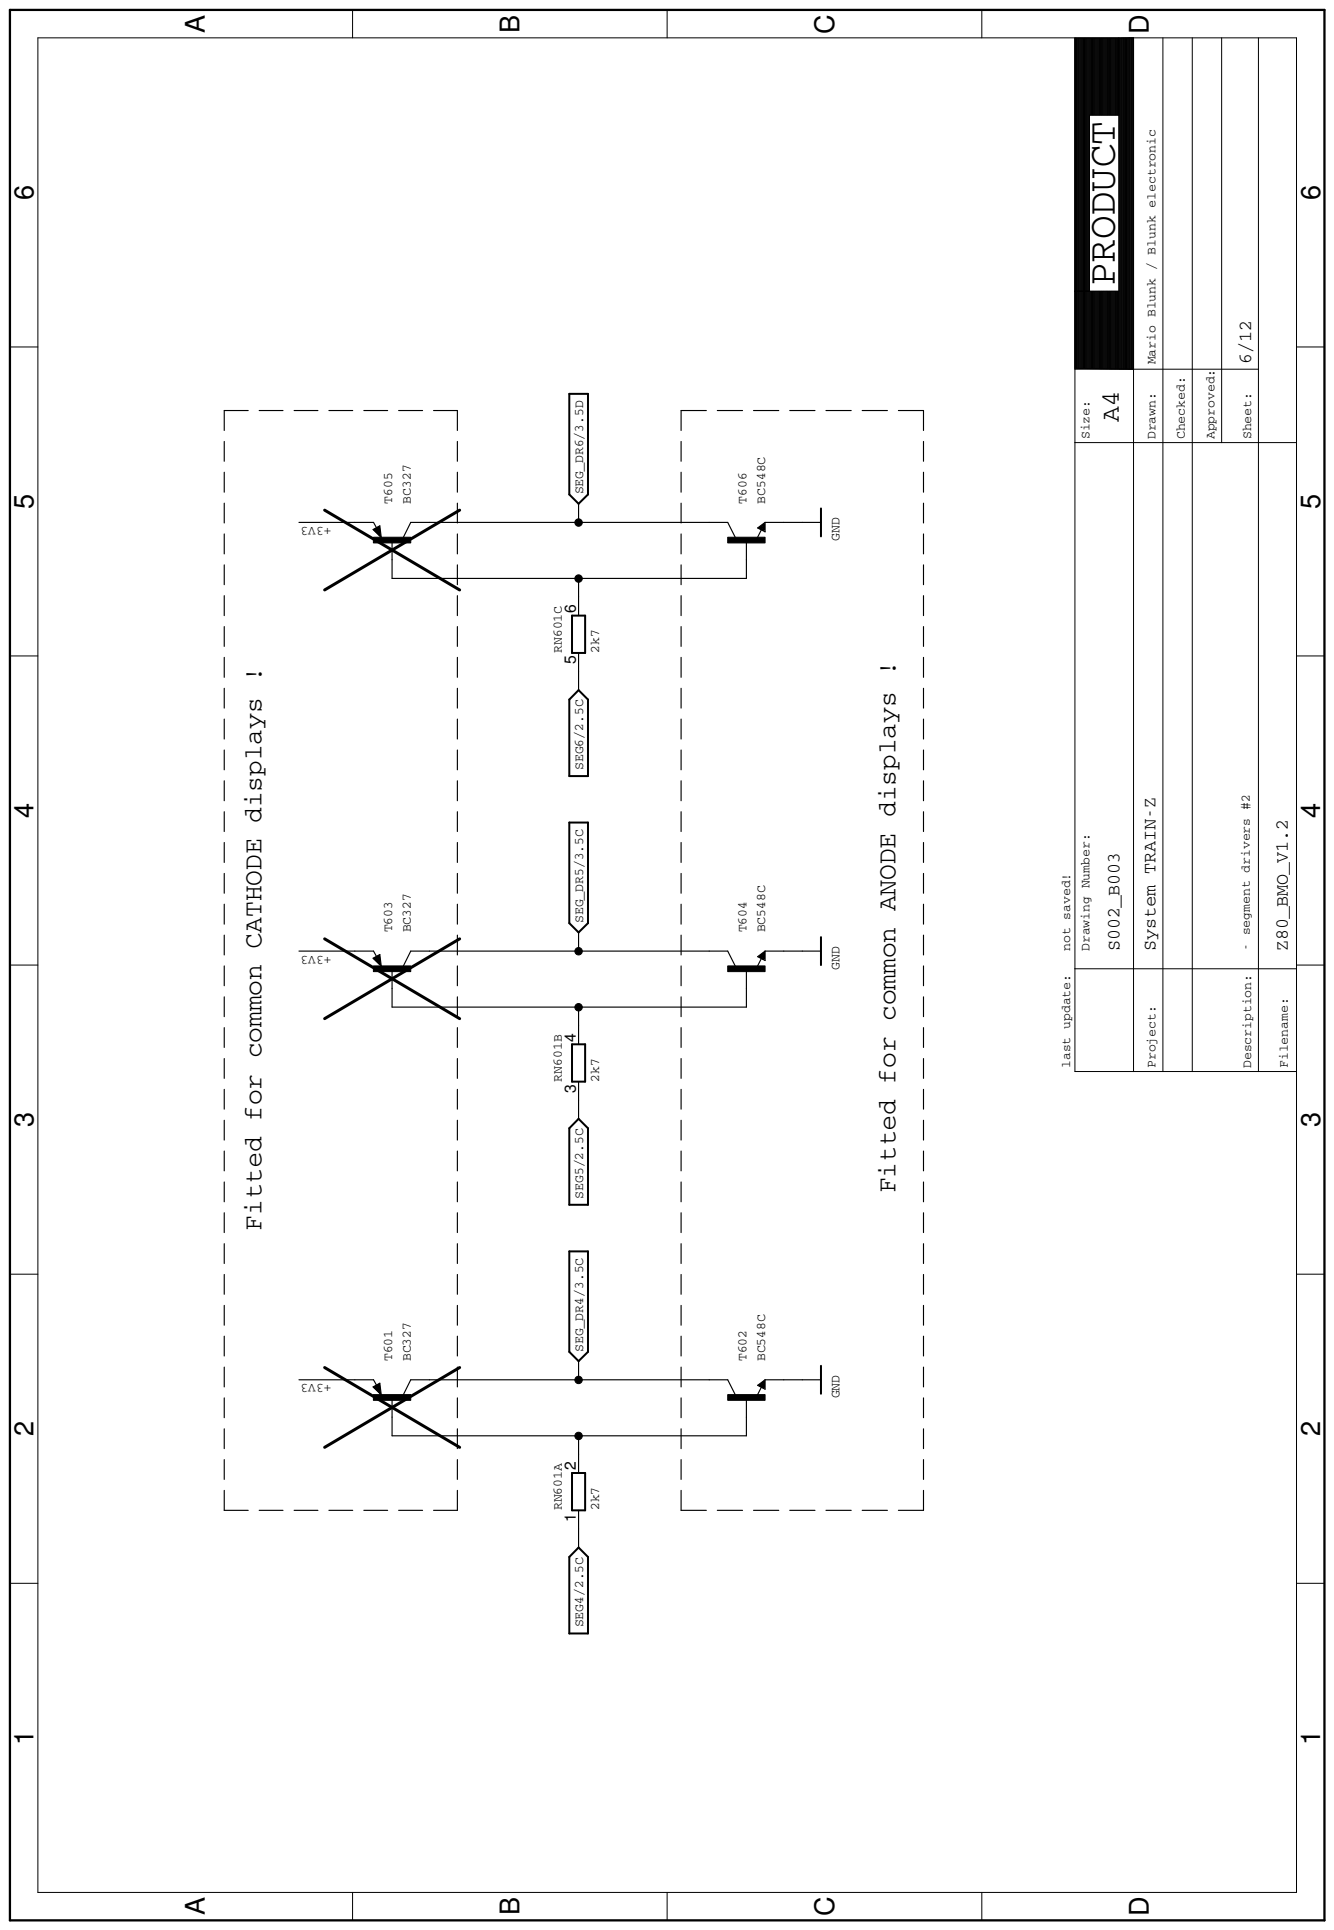
[picture p78: page 6]

Fitted for com on ANODE displays ! Fitted for com on CATHODE displays ! BC548C BC327 GND 2k7 BC548C BC327 GND BC548C BC327 GND 2k7 2k7 T602 T601 1 2 RN601A T604 T603 T606 T605 3 4 RN601B 5 6 RN601C SEG_DR6/3.5D SEG_DR5/3.5C SEG_DR4/3.5C 3V3+ 3V3+ 3V3+ SEG4/2.5C SEG5/2.5C SEG6/2.5C - segment drivers #2 Z80_BMO_V1.2 6/12 ABCD 1 2 3 4 5 6 ABCD 1 2 3 4 5 6 Size: A4 Drawing Number: Checked: Description: Filename: Project: Sheet: Approved: System TRAIN-Z PRODUCT Mario Blunk / Blunk electronic Drawn: last update: not saved! S002_B003

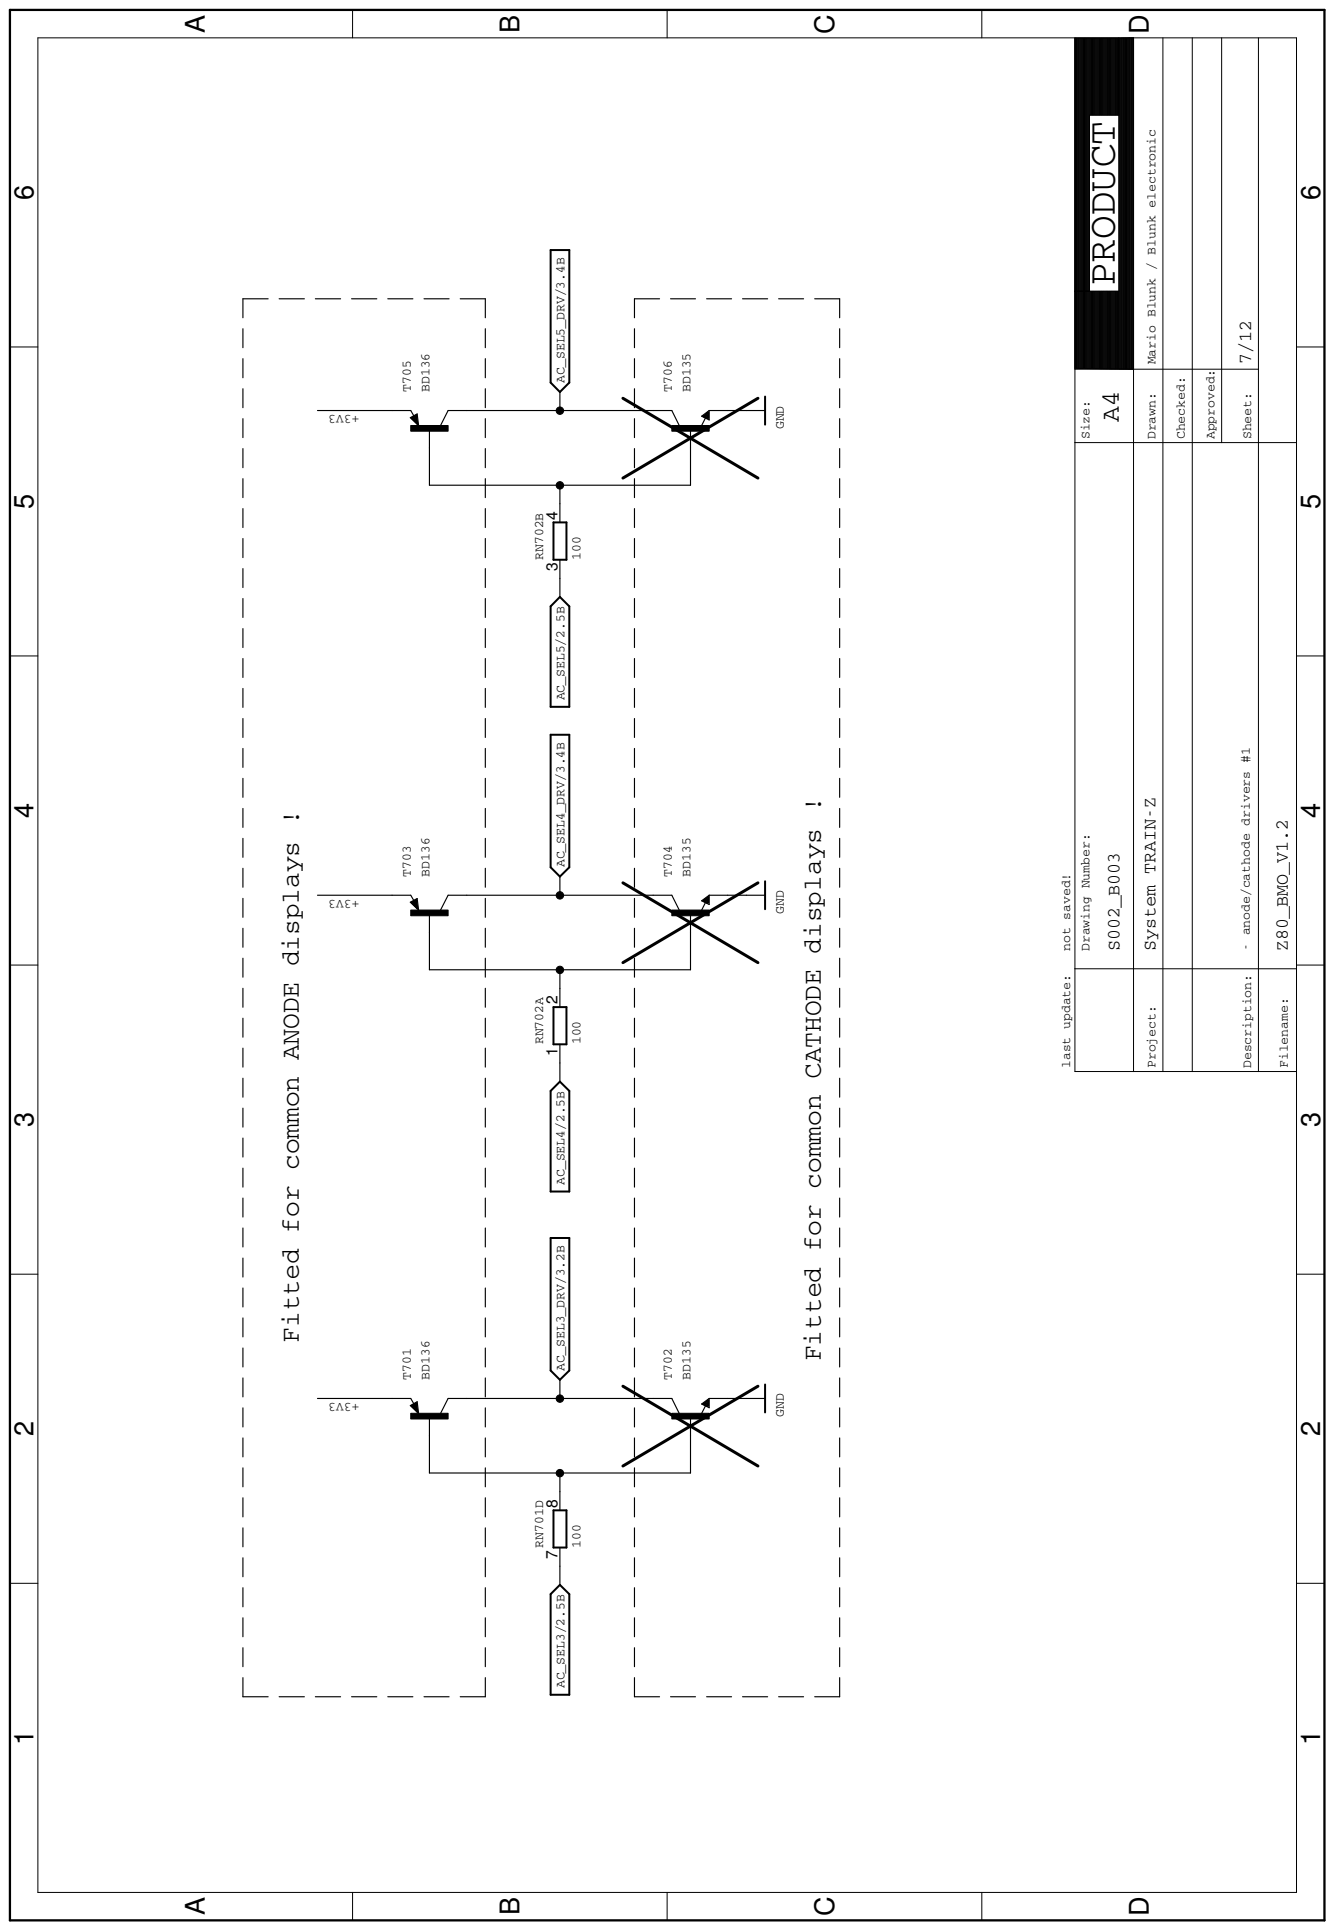
[picture p79: page 7]

Fitted for com on ANODE displays ! Fitted for com on CATHODE displays ! 100 BD135 BD136 GND BD135 BD136 GND BD135 BD136 GND 100 100 7 8 RN701D T702 T701 T704 T703 T706 T705 1 2 RN702A 3 4 RN702B 3V3+ 3V3+ 3V3+ AC_SEL3/2.5B AC_SEL4/2.5B AC_SEL5/2.5B AC_SEL3_DRV/3.2B AC_SEL4_DRV/3.4B AC_SEL5_DRV/3.4B - anode/cathode drivers #1 Z80_BMO_V1.2 7/12 ABCD 1 2 3 4 5 6 ABCD 1 2 3 4 5 6 Size: A4 Drawing Number: Checked: Description: Filename: Project: Sheet: Approved: System TRAIN-Z PRODUCT Mario Blunk / Blunk electronic Drawn: last update: not saved! S002_B003

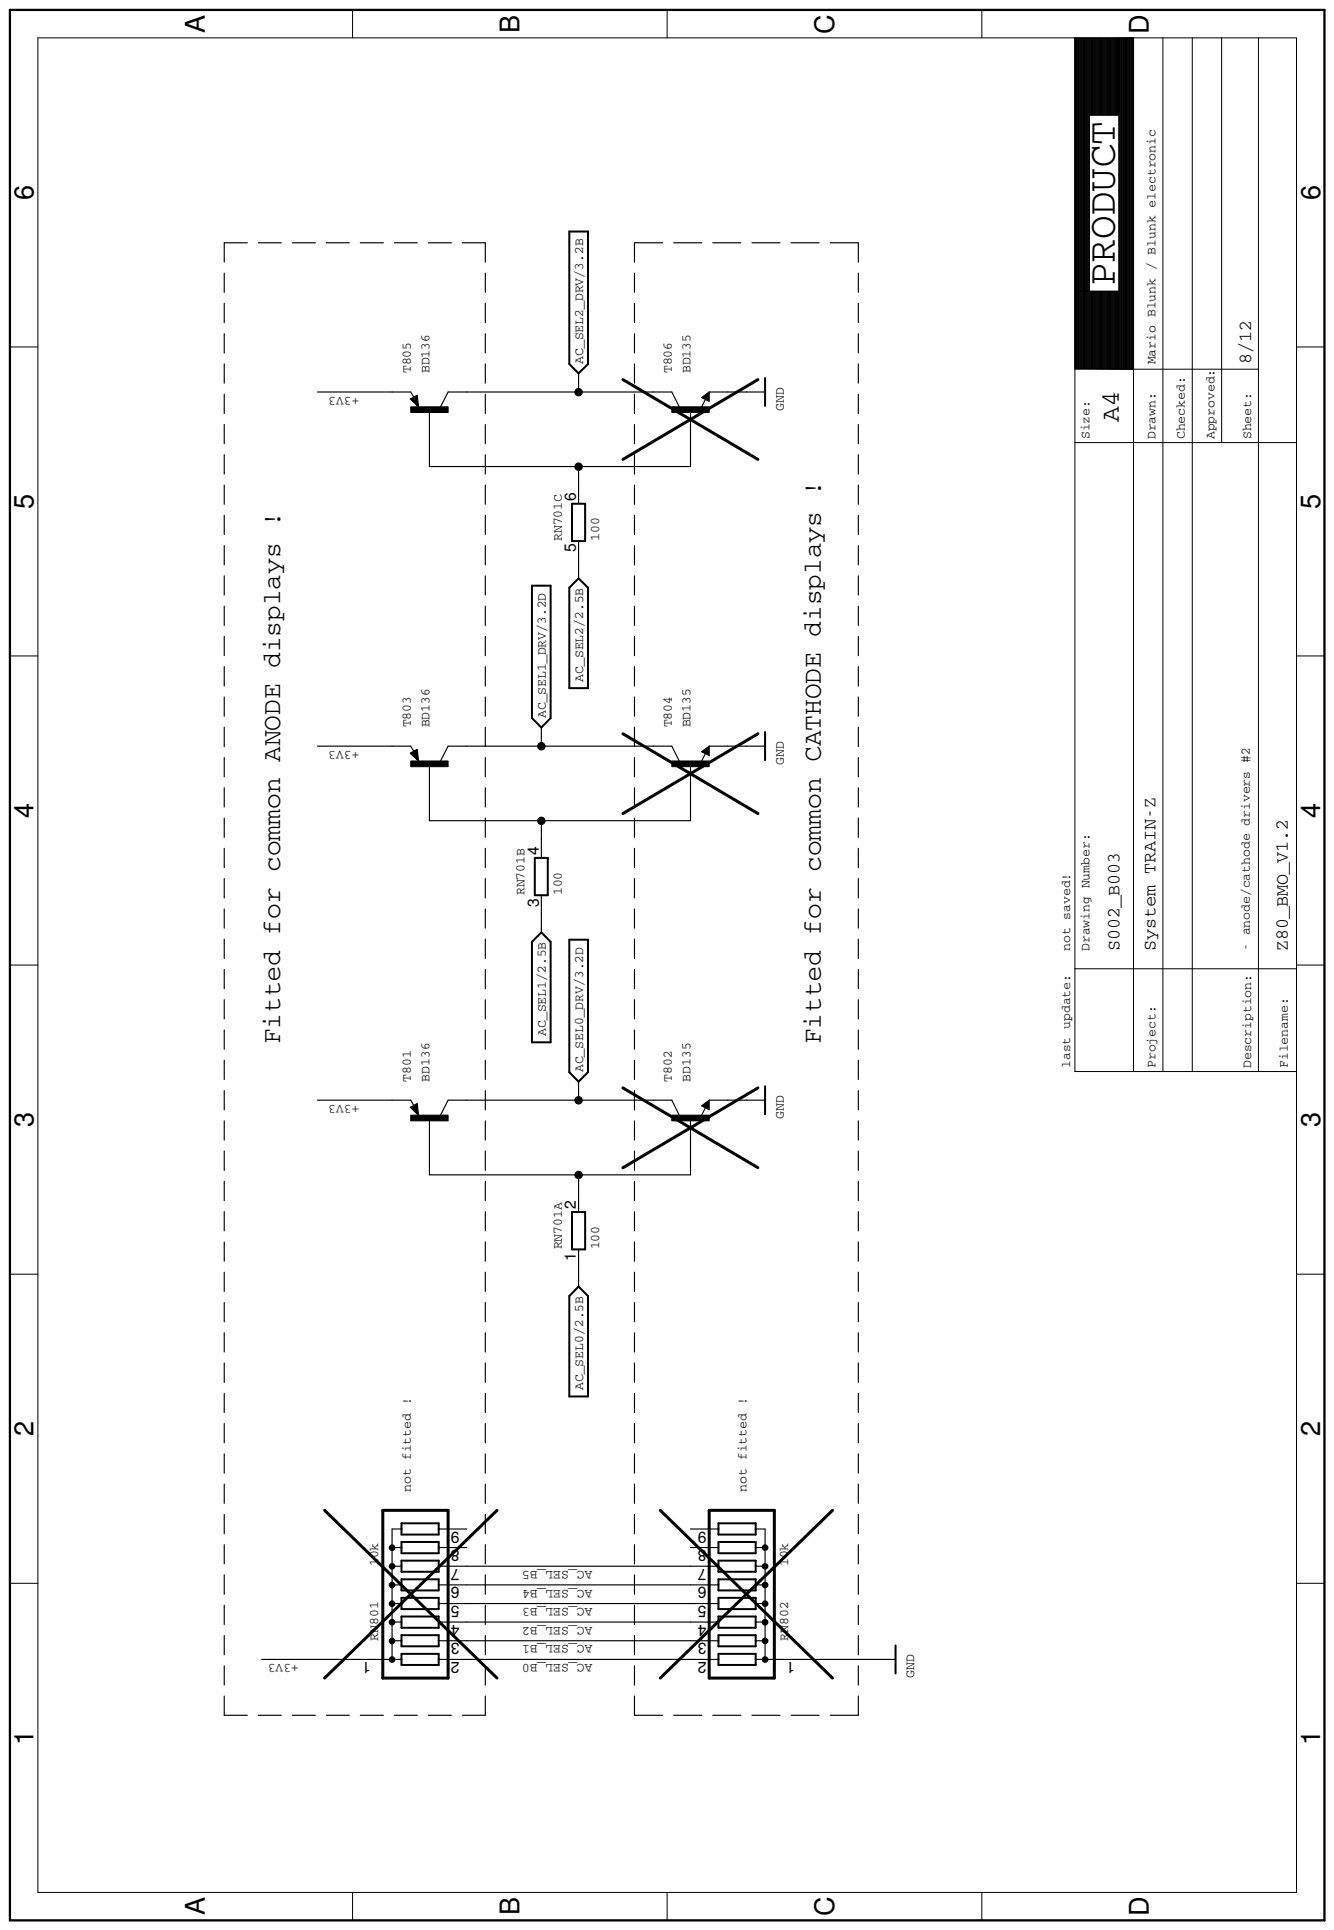
[picture p80: page 8]

Fitted for com on ANODE displays ! Fitted for com on CATHODE displays ! BD135 BD136 GND 100 100 100 10k 10k GND BD135 BD136 GND BD135 BD136 GND T802 T801 1 2 RN701A 3 4 RN701B 5 6 RN701C 1 23456789 RN801 2 1 3456789 RN802 T804 T803 T806 T805 3V3+ 3V3+ 3V3+ 3V3+ AC_SEL0_DRV/3.2D 0B_LES_CAAC_SEL0/2.5B AC_SEL1/2.5B AC_SEL2/2.5B 1B_LES_CA 2B_LES_CA 3B_LES_CA 4B_LES_CA 5B_LES_CA AC_SEL1_DRV/3.2D AC_SEL2_DRV/3.2B - anode/cathode drivers #2 Z80_BMO_V1.2 8/12 ABCD 1 2 3 4 5 6 ABCD 1 2 3 4 5 6 Size: A4 Drawing Number: Checked: Description: Filename: Project: Sheet: Approved: System TRAIN-Z PRODUCT Mario Blunk / Blunk electronic Drawn: last update: not saved! S002_B003 not fitted ! not fitted !

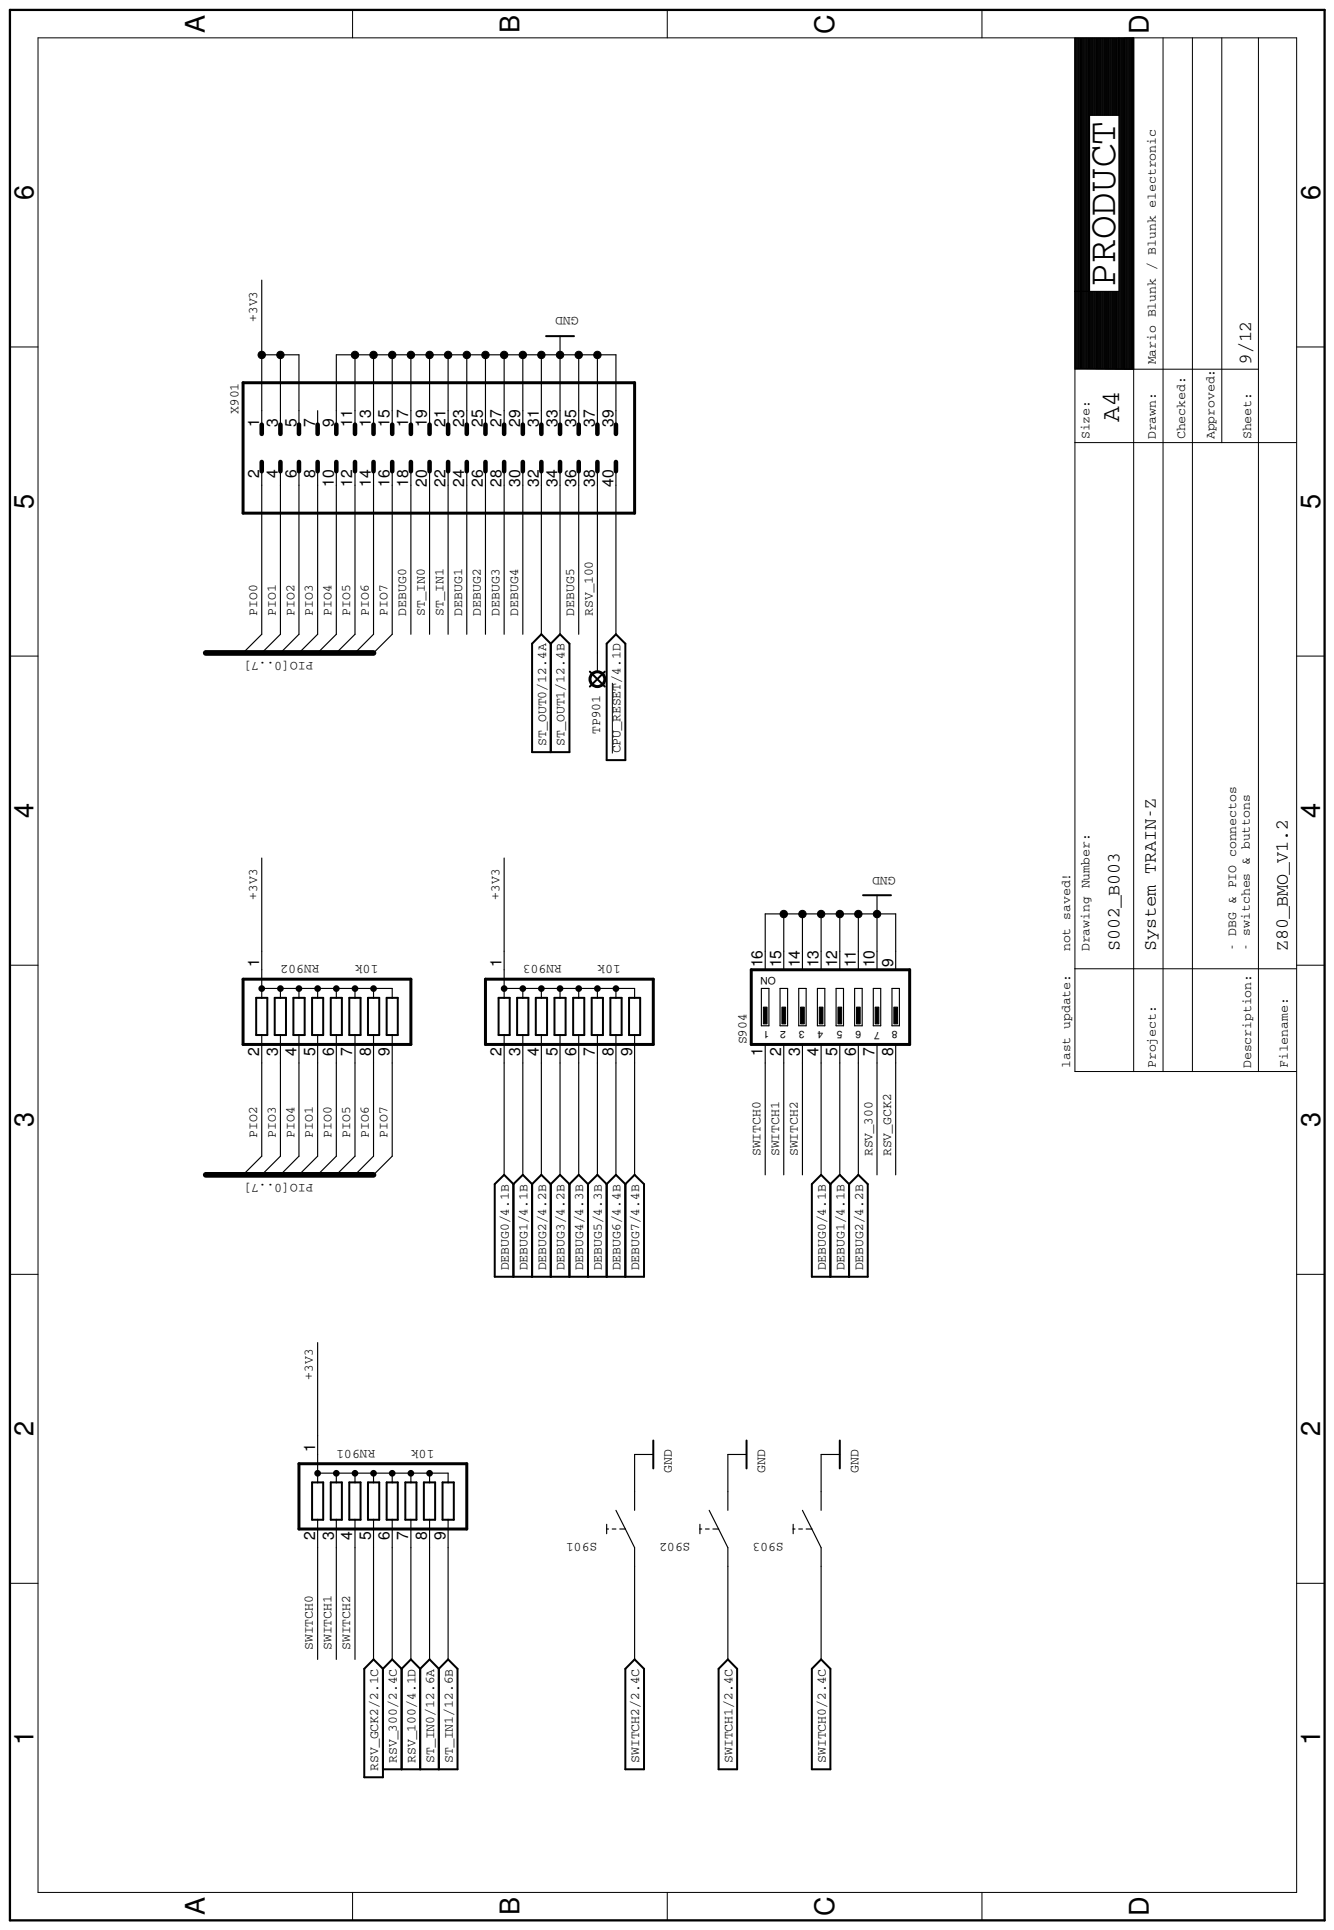
[picture p81: page 9]

GND GND GNDk01 DNG k01 k01 DNG 1 23456789 109NR 1 2 3 4 5 6 7 8 9 10 11 12 13 14 15 16 17 18 19 20 21 22 23 24 25 26 27 28 29 30 31 32 33 34 35 36 37 38 39 40 X901 TP901 1 23456789 209NR 1 23456789 309NR 12345678 190111213141516 S904 109S 209S 309S ]7..0[OIP ]7..0[OIP SWITCH2/2.4C SWITCH2 SWITCH2 SWITCH1/2.4C SWITCH1 SWITCH1 SWITCH0/2.4C SWITCH0 SWITCH0 +3V3 +3V3 +3V3 +3V3 PIO0 PIO0 PIO1 PIO1 PIO2 PIO2 PIO3 PIO3 PIO4 PIO4 PIO5 PIO5 PIO6 PIO6 PIO7 PIO7 DEBUG0 DEBUG0/4.1B DEBUG0/4.1B DEBUG1/4.1B DEBUG1 DEBUG1/4.1B DEBUG2/4.2B DEBUG2 DEBUG2/4.2B DEBUG3/4.2B DEBUG3 DEBUG4/4.3B DEBUG4 DEBUG5/4.3B DEBUG5 DEBUG6/4.4B DEBUG7/4.4B CPU_RESET/4.1D ST_IN0 ST_IN0/12.6A ST_IN1 ST_IN1/12.6B RSV_100 RSV_100/4.1D ST_OUT0/12.4A ST_OUT1/12.4B RSV_GCK2 RSV_GCK2/2.1C RSV_300 RSV_300/2.4C - DBG & PIO connectos - switches & buttons NO1 2 3 4 5 6 7 8 Z80_BMO_V1.2 9/12 ABCD 1 2 3 4 5 6 ABCD 1 2 3 4 5 6 Size: A4 Drawing Number: Checked: Description: Filename: Project: Sheet: Approved: System TRAIN-Z PRODUCT Mario Blunk / Blunk electronic Drawn: last update: not saved! S002_B003

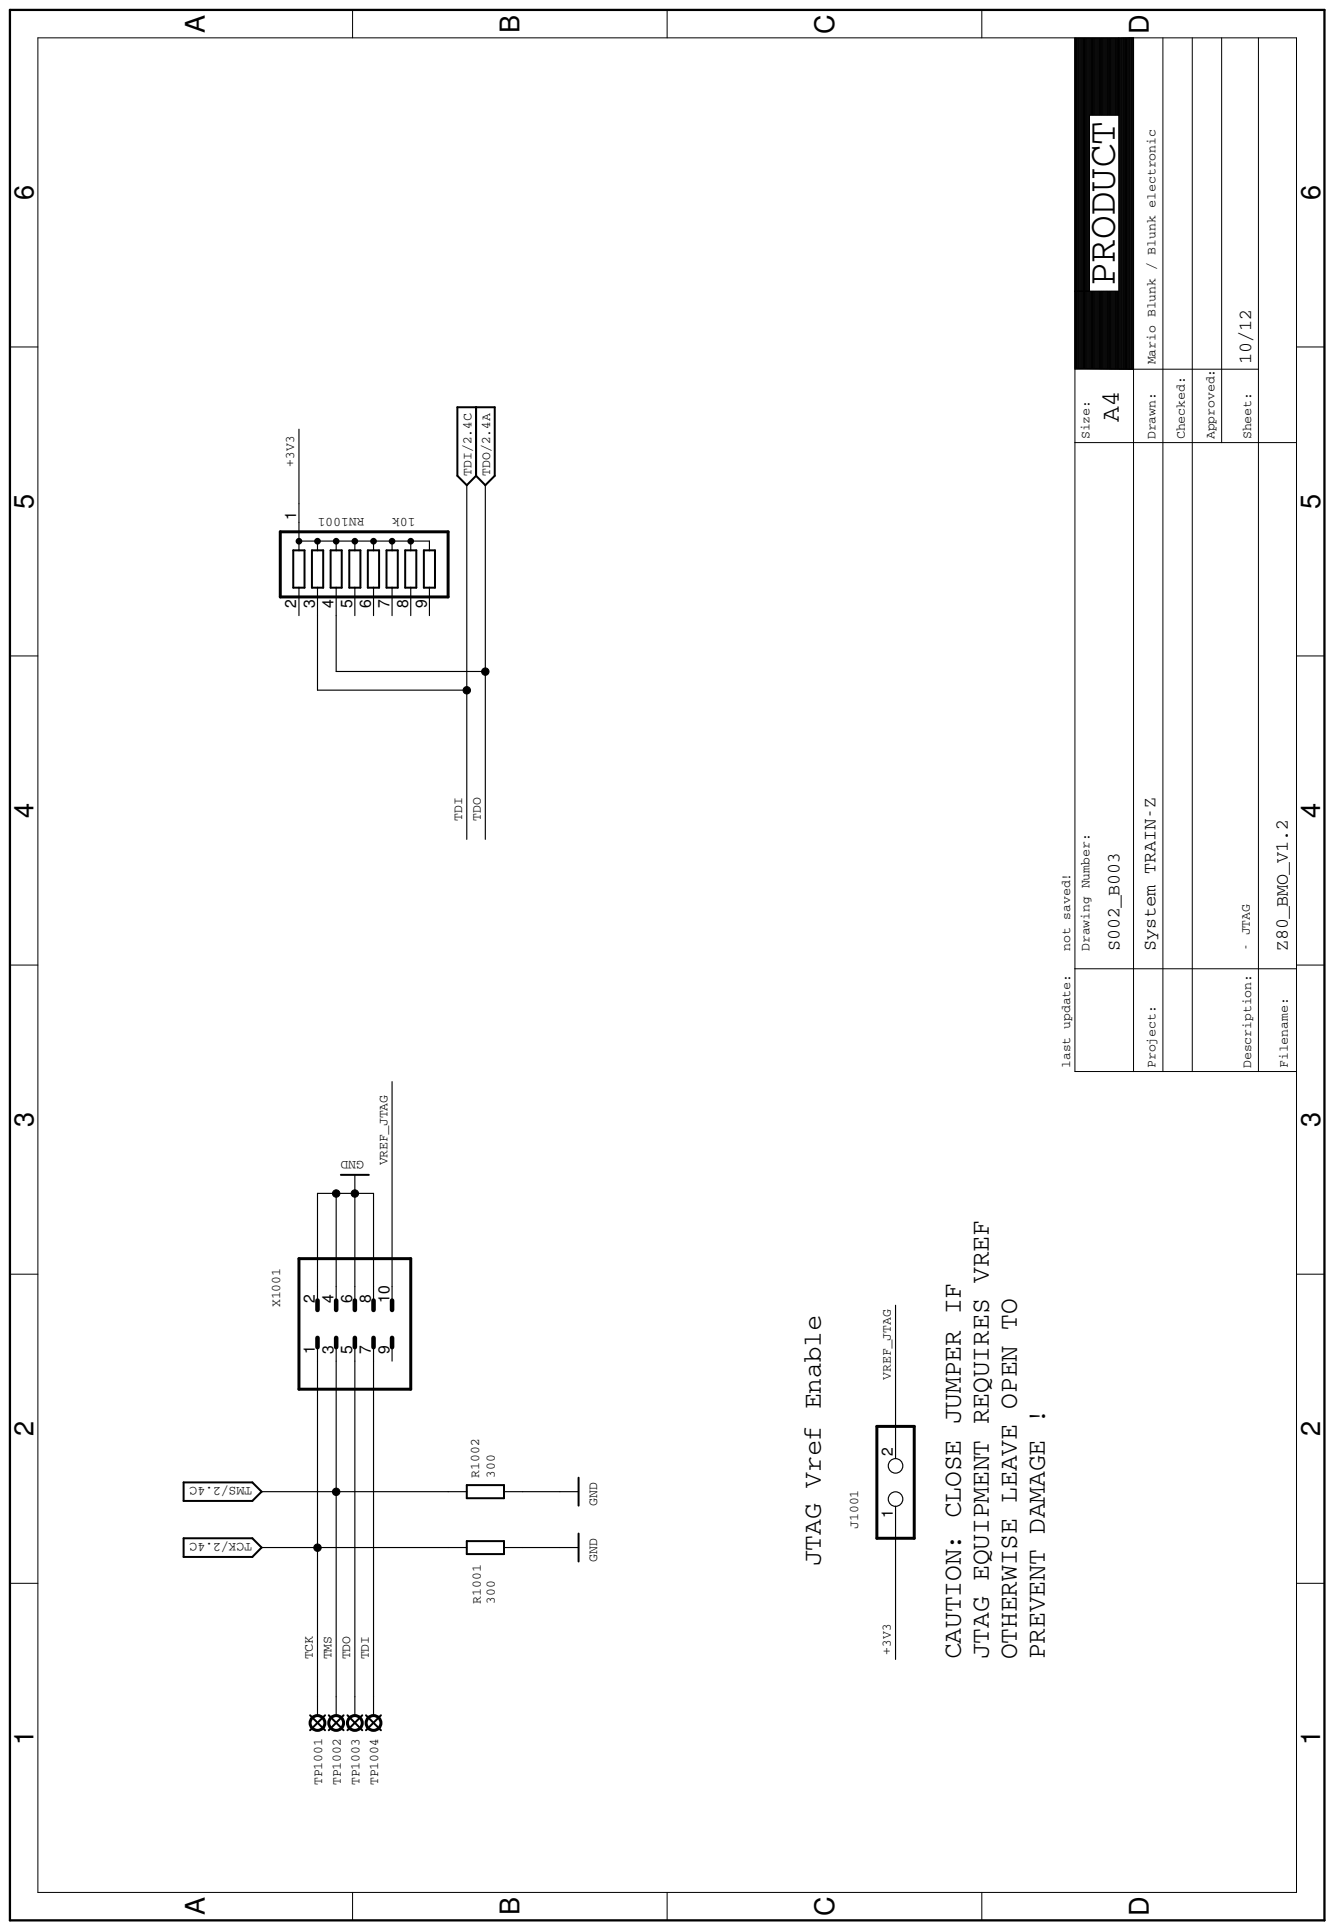
[picture p82: page 10]

CAUTION: CLOSE JUMPER IF JTAG EQUIPMENT REQUIRES VREF OTHERWISE LEAVE OPEN TO PREVENT DAMAGE ! DNG 300 300 GND GND k01 JTAG Vref Enable R1001 R1002 1 23456789 1001NR TP1001 TP1002 TP1003 TP1004 X1001 1 2 3 4 5 6 7 8 9 10 J1001 1 2 TDO TDO TDO/2.4A TCK C4.2/KCT TMS C4.2/SMT VREF_JTAG VREF_JTAG +3V3 +3V3 TDI TDI TDI/2.4C - JTAG Z80_BMO_V1.2 10/12 ABCD 1 2 3 4 5 6 ABCD 1 2 3 4 5 6 Size: A4 Drawing Number: Checked: Description: Filename: Project: Sheet: Approved: System TRAIN-Z PRODUCT Mario Blunk / Blunk electronic Drawn: last update: not saved! S002_B003

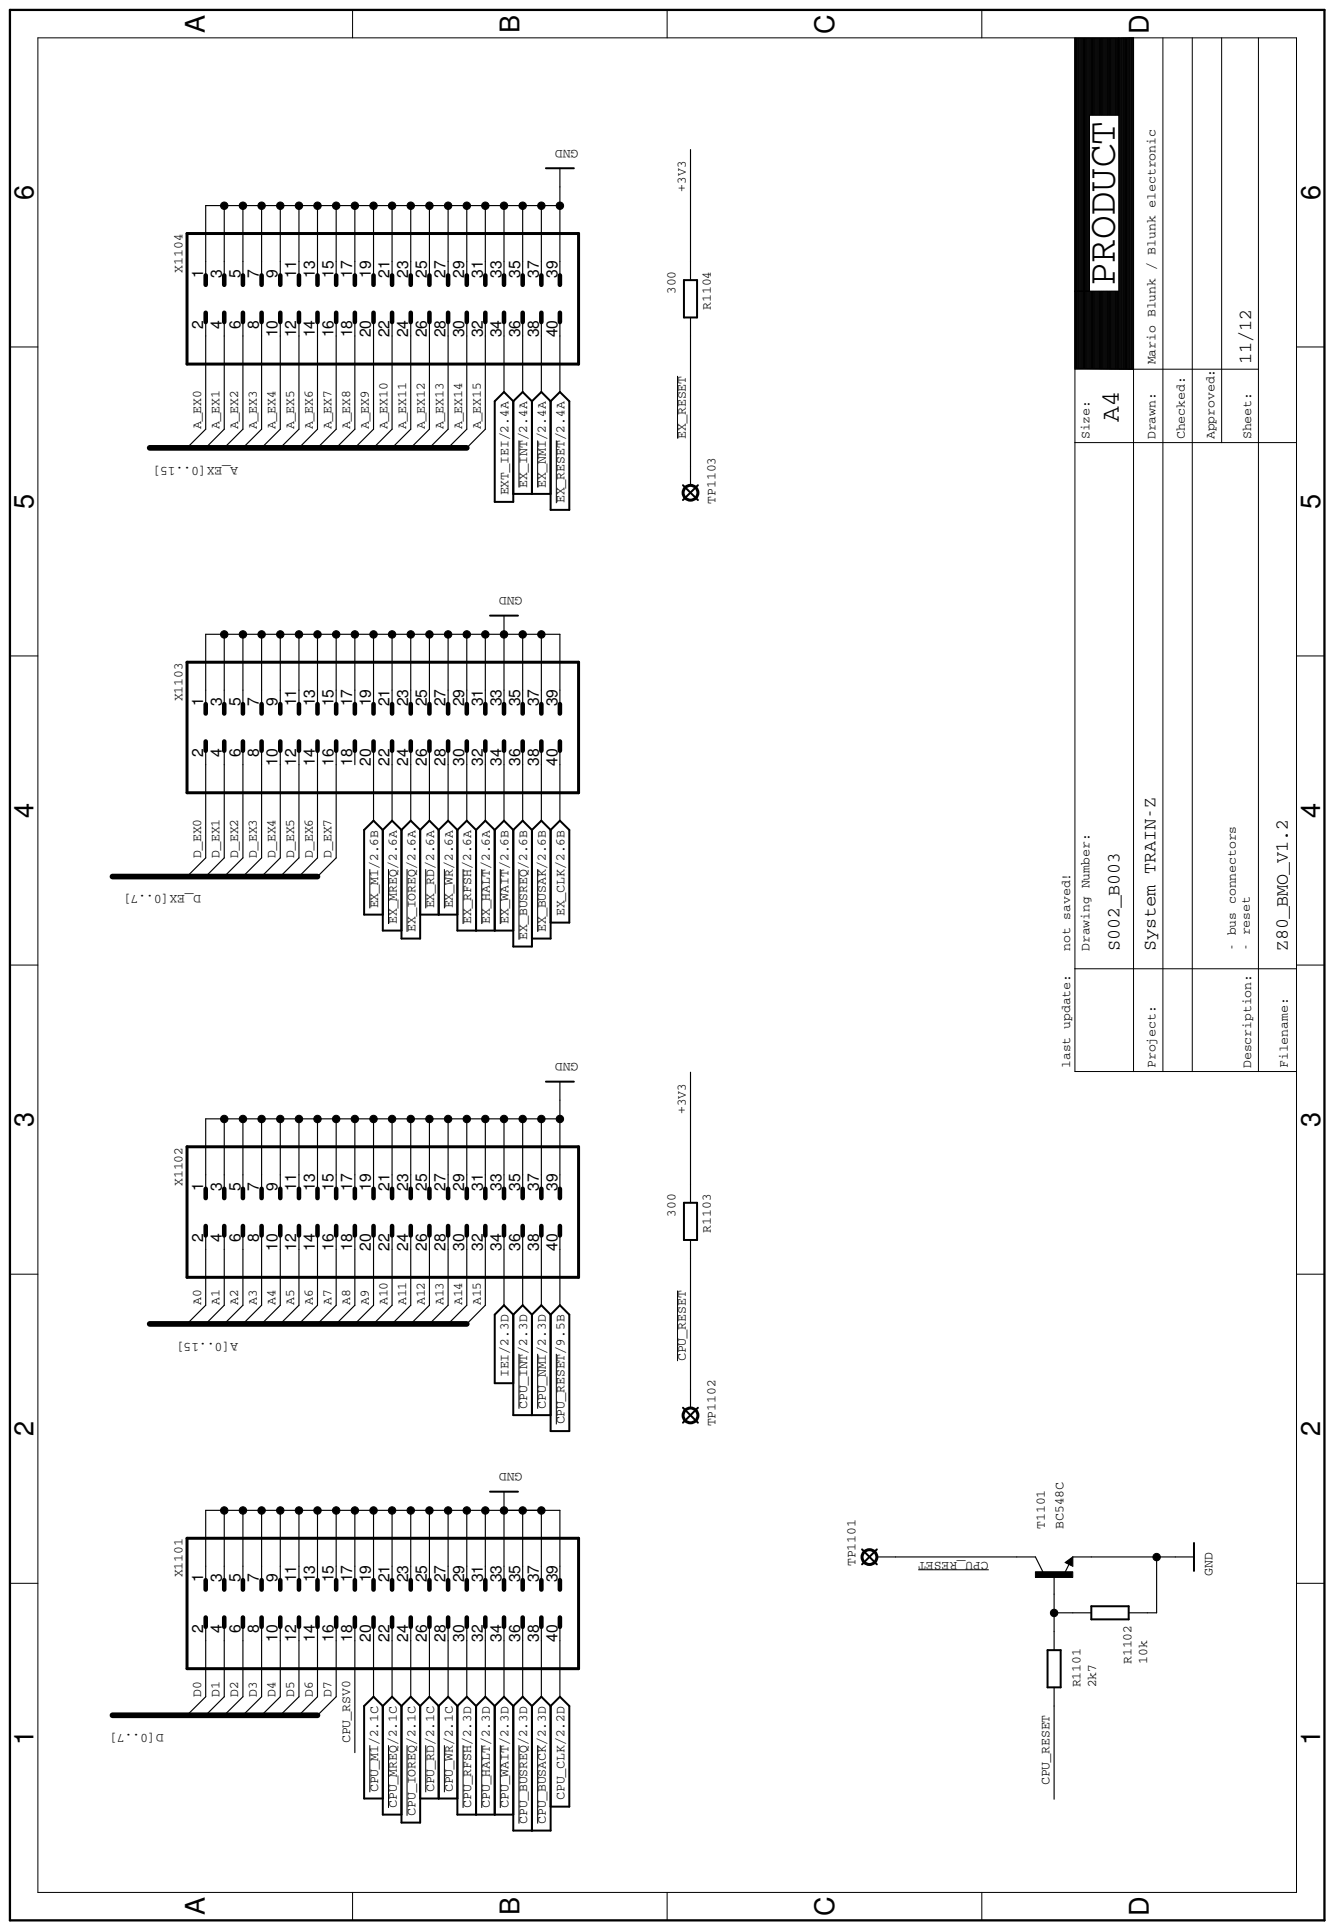
[picture p83: page 11]

DNG DNG DNG DNG 300 GND 2k710k BC548C 300 1 2 3 4 5 6 7 8 9 10 11 12 13 14 15 16 17 18 19 20 21 22 23 24 25 26 27 28 29 30 31 32 33 34 35 36 37 38 39 40 X1102 1 2 3 4 5 6 7 8 9 10 11 12 13 14 15 16 17 18 19 20 21 22 23 24 25 26 27 28 29 30 31 32 33 34 35 36 37 38 39 40 X1101 1 2 3 4 5 6 7 8 9 10 11 12 13 14 15 16 17 18 19 20 21 22 23 24 25 26 27 28 29 30 31 32 33 34 35 36 37 38 39 40 X1104 1 2 3 4 5 6 7 8 9 10 11 12 13 14 15 16 17 18 19 20 21 22 23 24 25 26 27 28 29 30 31 32 33 34 35 36 37 38 39 40 X1103 R1104 R1101R1102 TP1101 TP1103 T1101 R1103 TP1102 ]7..0[D ]51..0[A ]7..0[XE_D ]51..0[XE_A D0D1D2D3D4D5D6D7 A0A1A2A3A4A5A6A7A8A9A10 CPU_IOREQ/2.1C CPU_M1/2.1C CPU_MREQ/2.1C CPU_RD/2.1C CPU_WR/2.1C CPU_RFSH/2.3D CPU_HALT/2.3D CPU_WAIT/2.3D CPU_INT/2.3D CPU_NMI/2.3D CPU_RESET/9.5B TESER_UPC CPU_RESET CPU_BUSREQ/2.3D CPU_BUSACK/2.3D CPU_CLK/2.2D EXT_IEI/2.4A A15 A14 A13 A12 A11 CPU_RSV0 +3V3 +3V3 D_EX0 D_EX1 D_EX2 D_EX3 D_EX4 D_EX5 D_EX6 D_EX7 EX_M1/2.6B EX_MREQ/2.6A EX_IOREQ/2.6A EX_RD/2.6A EX_WR/2.6A EX_RFSH/2.6A EX_HALT/2.6A EX_WAIT/2.6B EX_BUSREQ/2.6B EX_BUSAK/2.6B EX_CLK/2.6B A_EX0 A_EX1 A_EX2 A_EX3 A_EX4 A_EX5 A_EX6 A_EX7 A_EX8 A_EX9 A_EX10 A_EX11 A_EX12 A_EX13 A_EX14 A_EX15 EX_INT/2.4A EX_NMI/2.4A EX_RESET/2.4A EX_RESET IEI/2.3D CPU_RESET - bus connectors - reset Z80_BMO_V1.2 11/12 ABCD 1 2 3 4 5 6 ABCD 1 2 3 4 5 6 Size: A4 Drawing Number: Checked: Description: Filename: Project: Sheet: Approved: System TRAIN-Z PRODUCT Mario Blunk / Blunk electronic Drawn: last update: not saved! S002_B003

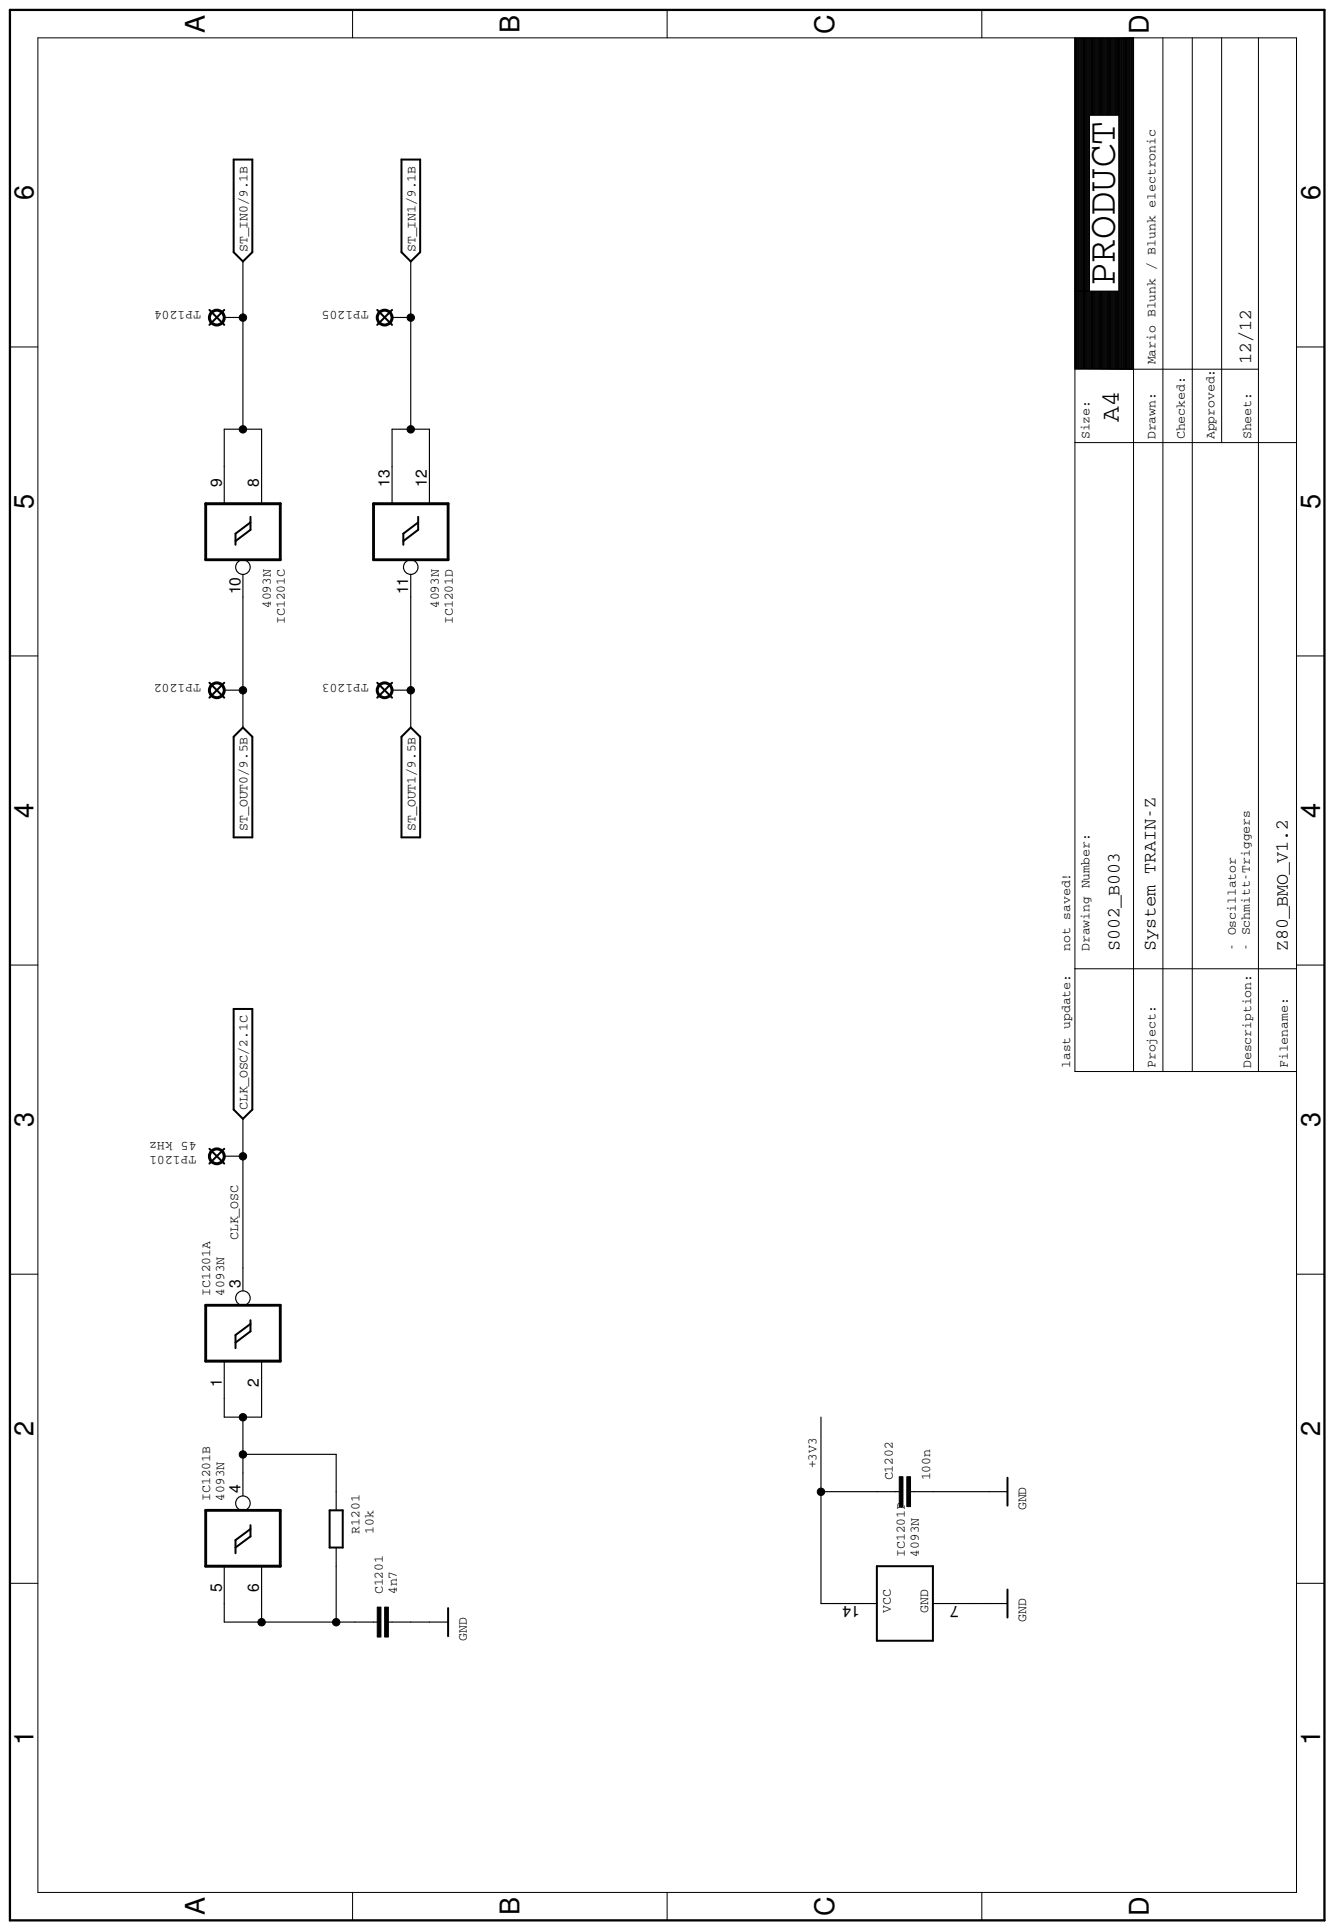
[picture p84: page 12]

zHk 54 GND 100n GND 10k GND 4n7 4093N 4093N 4093N 4093N 4093N C1202 2021PT 3021PT 4021PT 5021PTR1201 1021PT C1201 12 3IC1201A 56 4IC1201B 98 10 IC1201C 1213 11 IC1201D 41 7 IC1201P +3V3 ST_IN0/9.1B ST_IN1/9.1B ST_OUT0/9.5B ST_OUT1/9.5B CLK_OSC CLK_OSC/2.1C - Oscillator - Schmitt-Triggers VCC GND Z80_BMO_V1.2 12/12 ABCD 1 2 3 4 5 6 ABCD 1 2 3 4 5 6 Size: A4 Drawing Number: Checked: Description: Filename: Project: Sheet: Approved: System TRAIN-Z PRODUCT Mario Blunk / Blunk electronic Drawn: last update: not saved! S002_B003
