Blunk-electronic/TRAIN-Z/hardware/computer/pdf/MAIN_V093r3_bot_assy.pdf

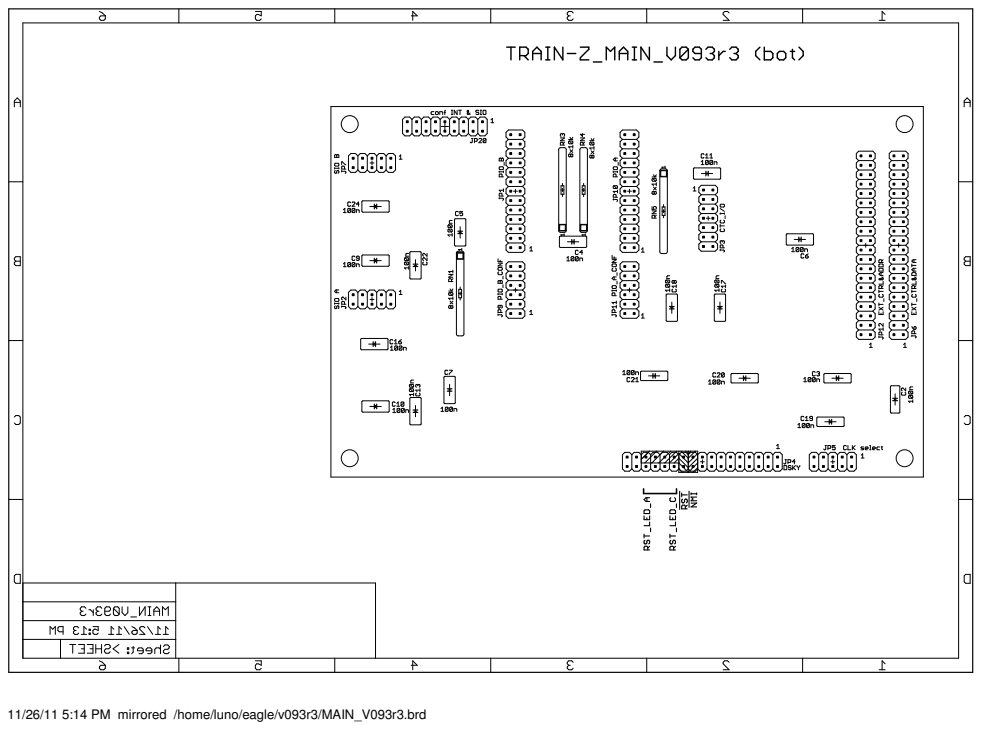
[picture p85: page 1]

11/26/11 5:14 PM mirrored /home/luno/eagle/v093r3/MAIN_V093r3.brd
