Blunk-electronic/TRAIN-Z/hardware/computer/pdf/MAIN_V093r3_sch.pdf

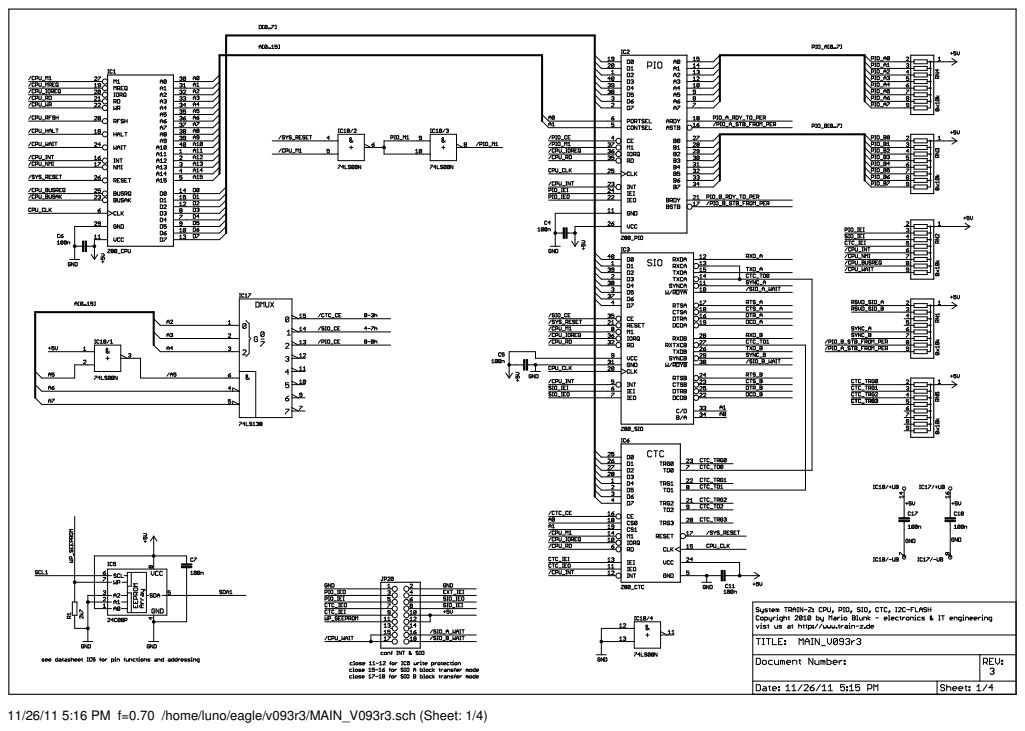
[picture p86: page 1]

11/26/11 5:16 PM f=0.70 /home/luno/eagle/v093r3/MAIN_V093r3.sch (Sheet: 1/4)

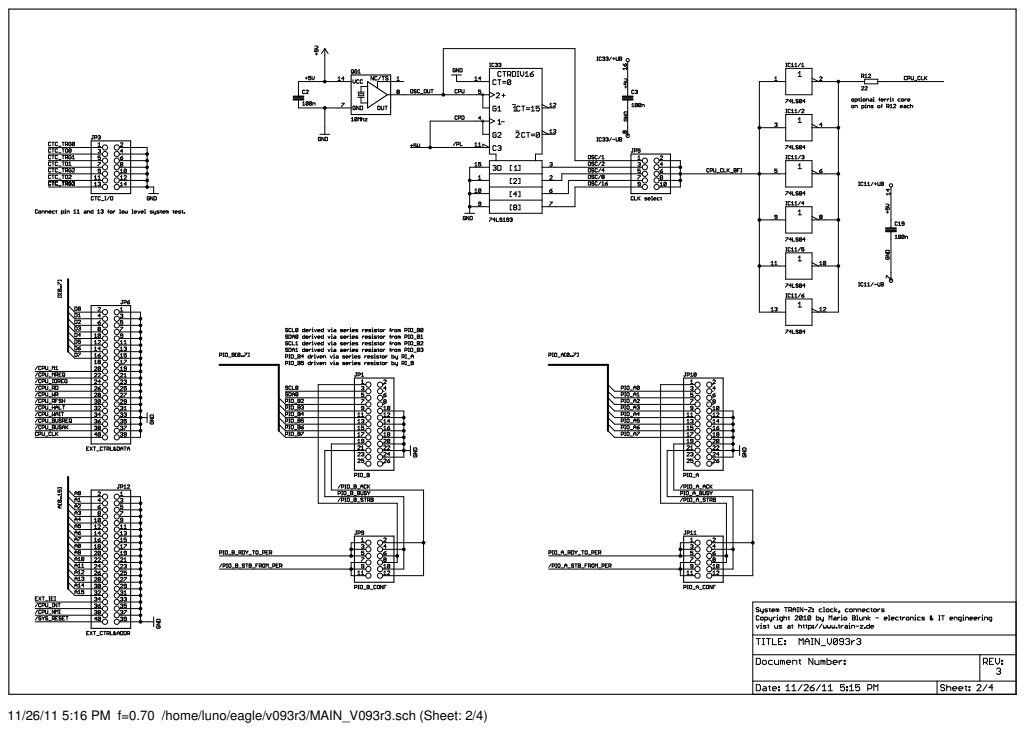
[picture p87: page 2]

11/26/11 5:16 PM f=0.70 /home/luno/eagle/v093r3/MAIN_V093r3.sch (Sheet: 2/4)

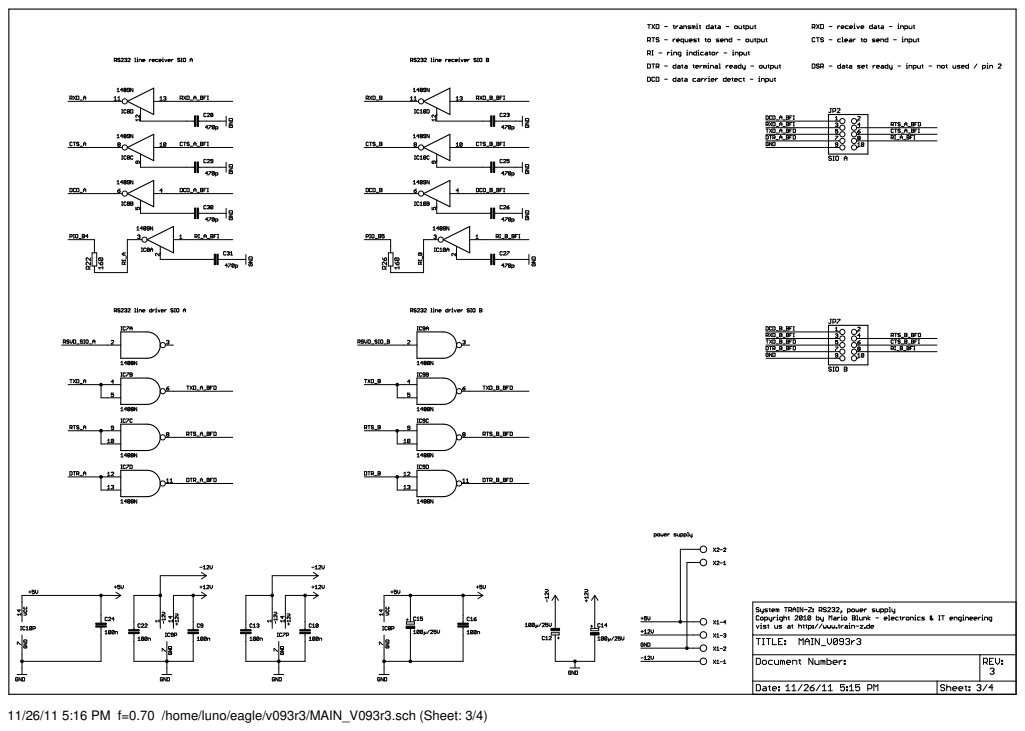
[picture p88: page 3]

11/26/11 5:16 PM f=0.70 /home/luno/eagle/v093r3/MAIN_V093r3.sch (Sheet: 3/4)

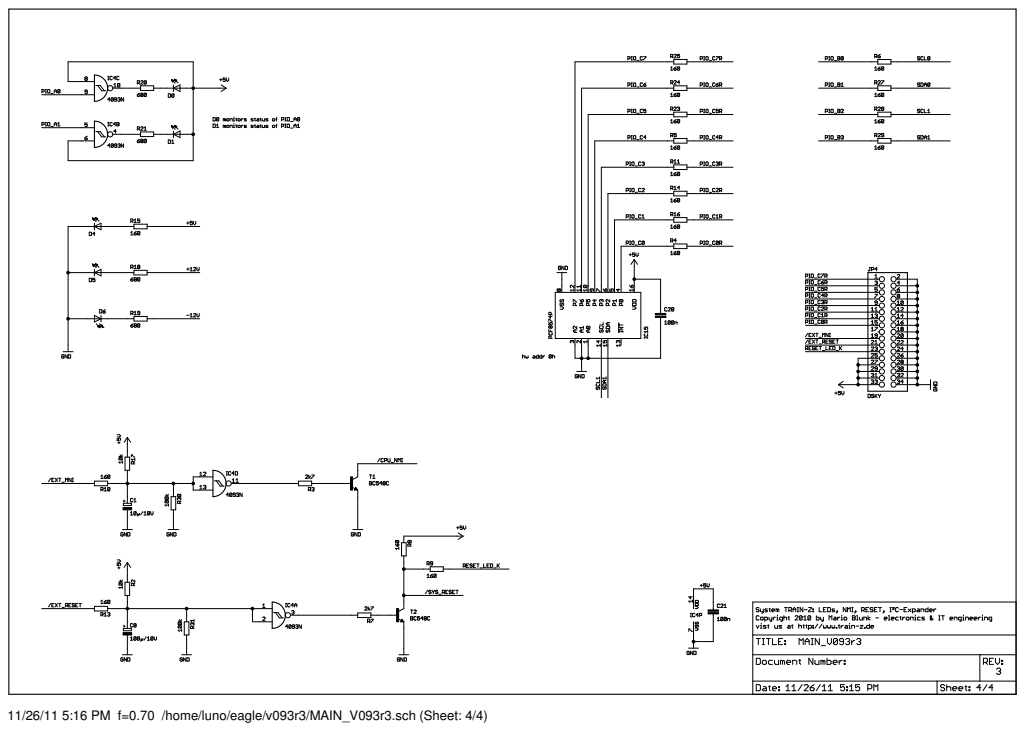
[picture p89: page 4]

11/26/11 5:16 PM f=0.70 /home/luno/eagle/v093r3/MAIN_V093r3.sch (Sheet: 4/4)
