Blunk-electronic/TRAIN-Z/hardware/computer/pdf/MAIN_V093r3_top_assy.pdf

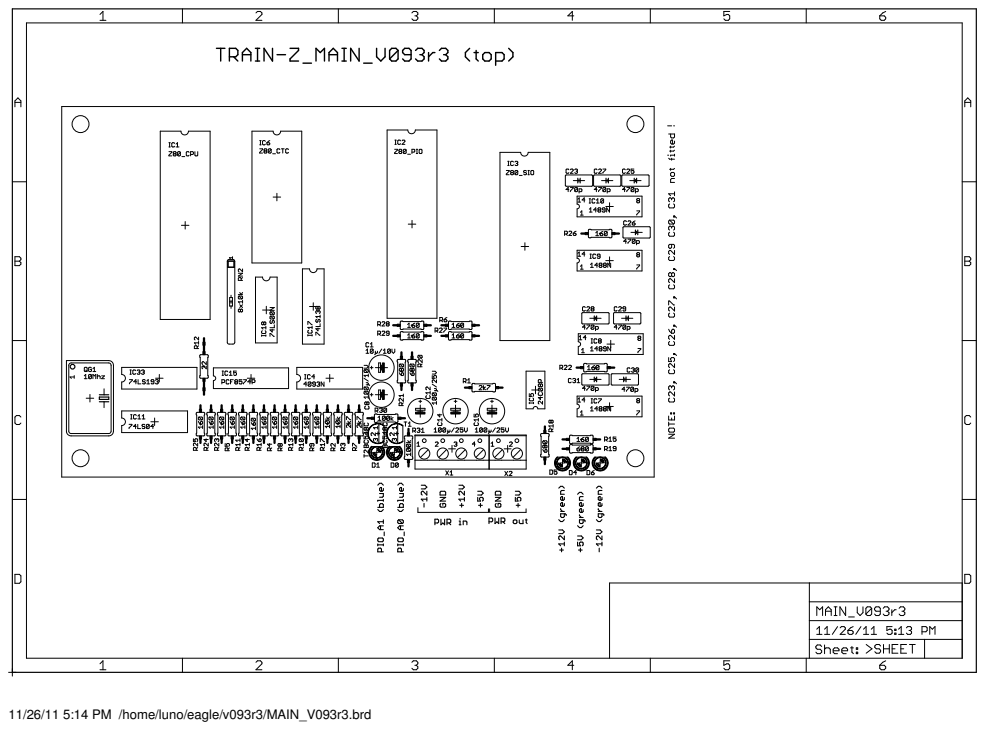
[picture p90: page 1]

11/26/11 5:14 PM /home/luno/eagle/v093r3/MAIN_V093r3.brd
