Blunk-electronic/TRAIN-Z/hardware/computer/pdf/MAIN_V093r4_bot_assy.pdf

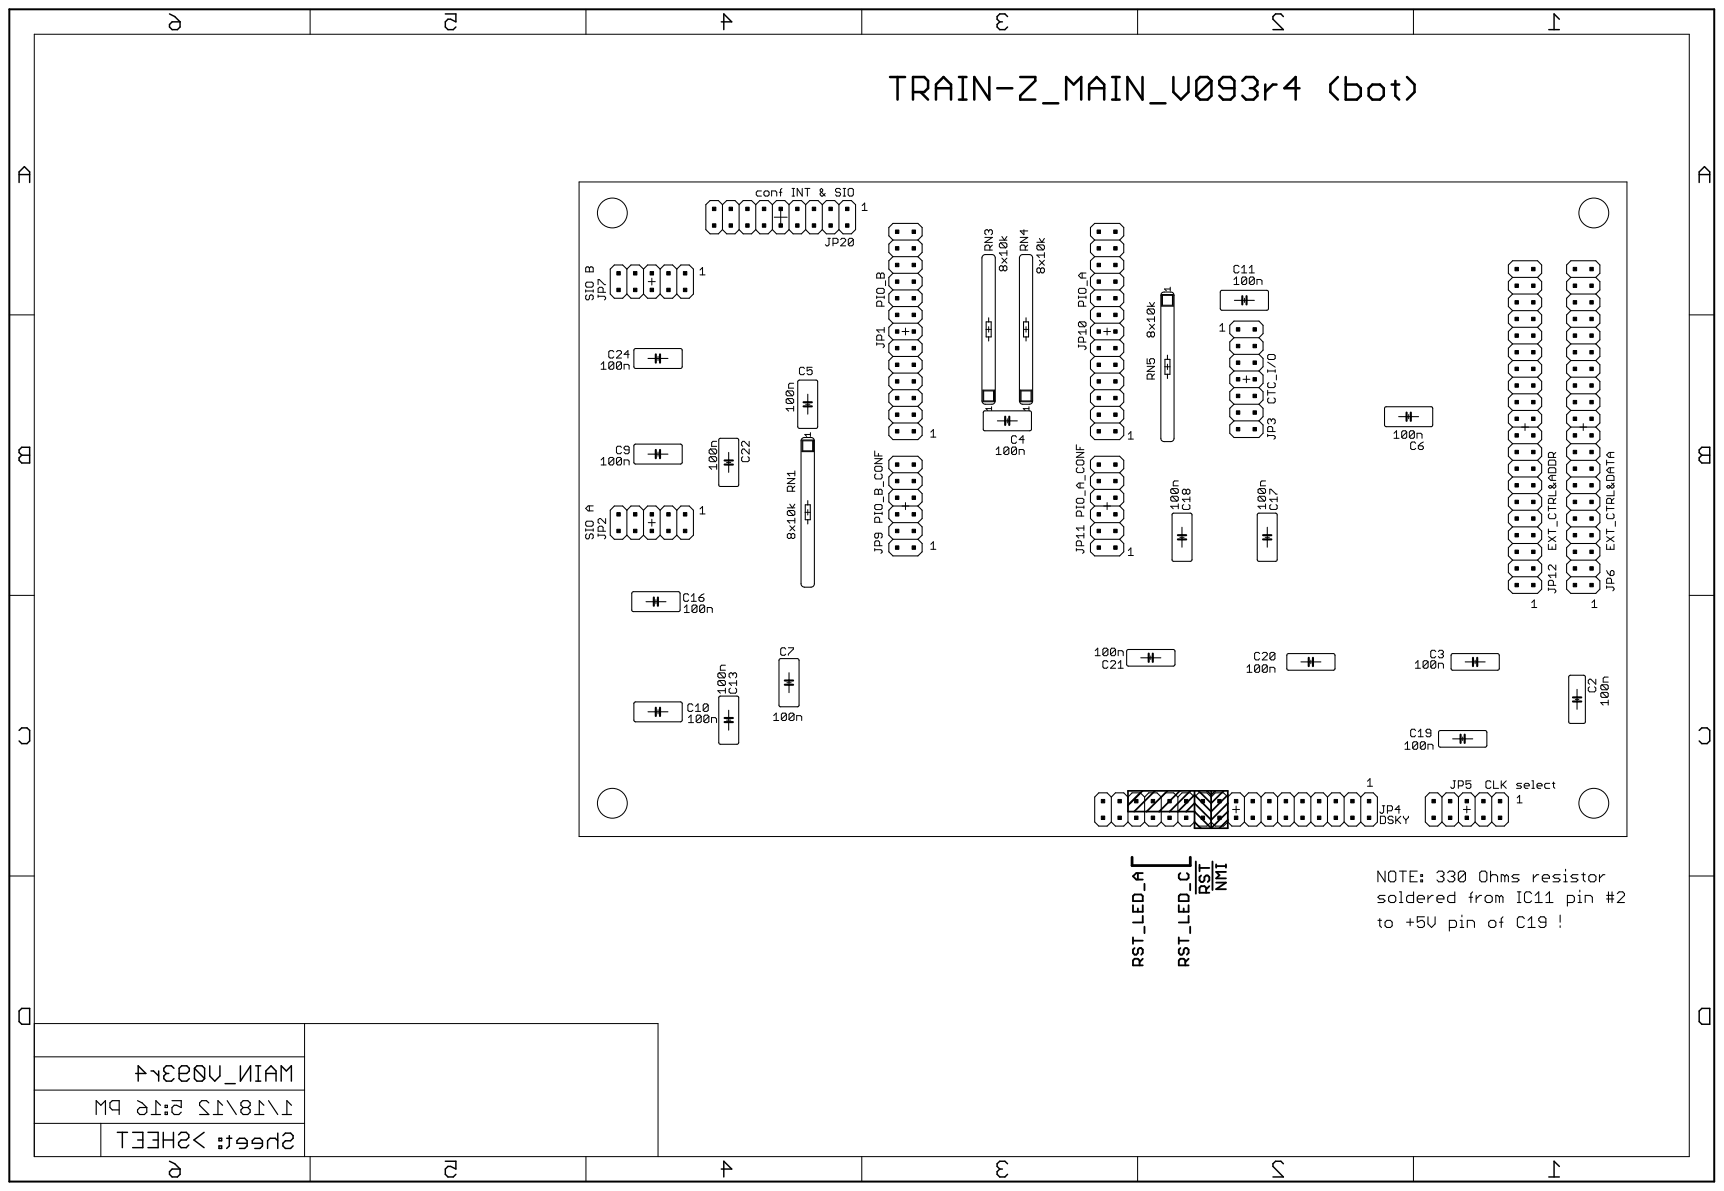
[picture p91: page 1]
