Blunk-electronic/TRAIN-Z/hardware/computer/pdf/MAIN_V093r4_sch.pdf

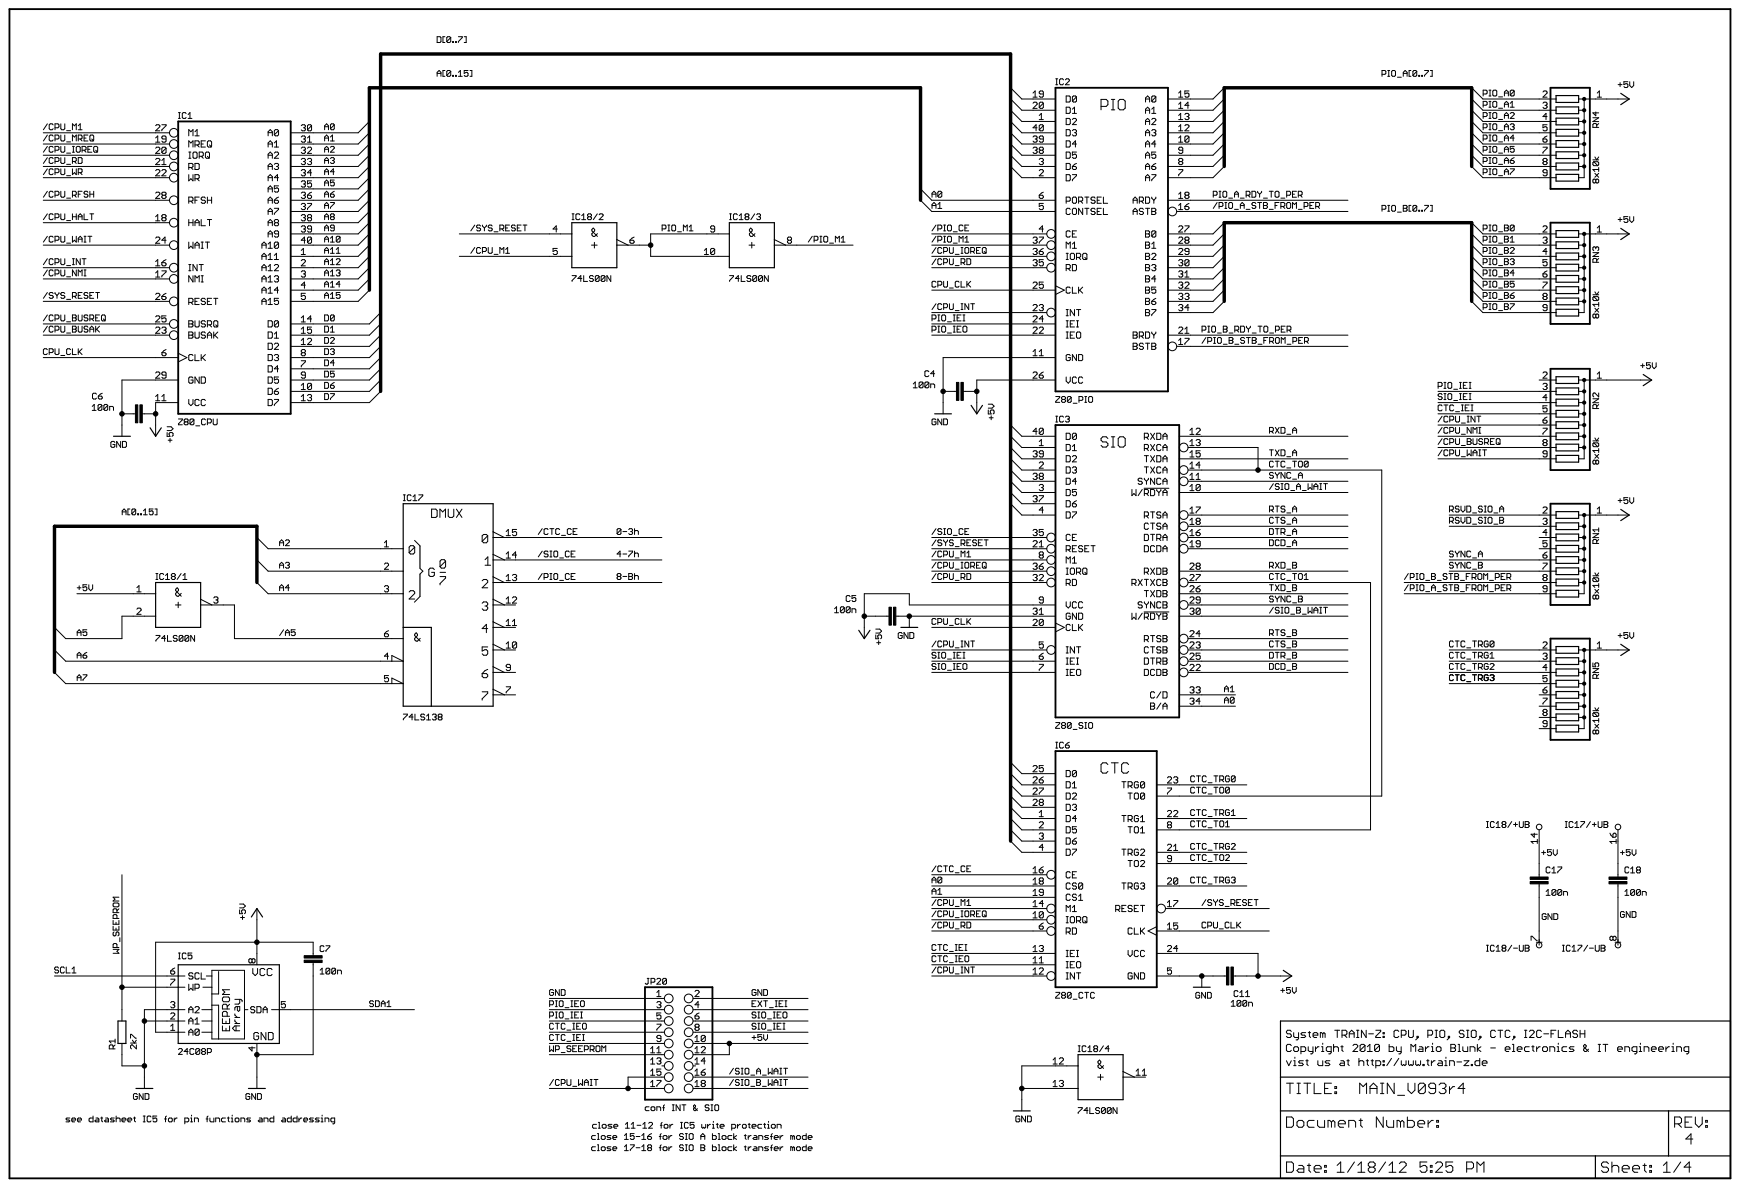
[picture p92: page 1]

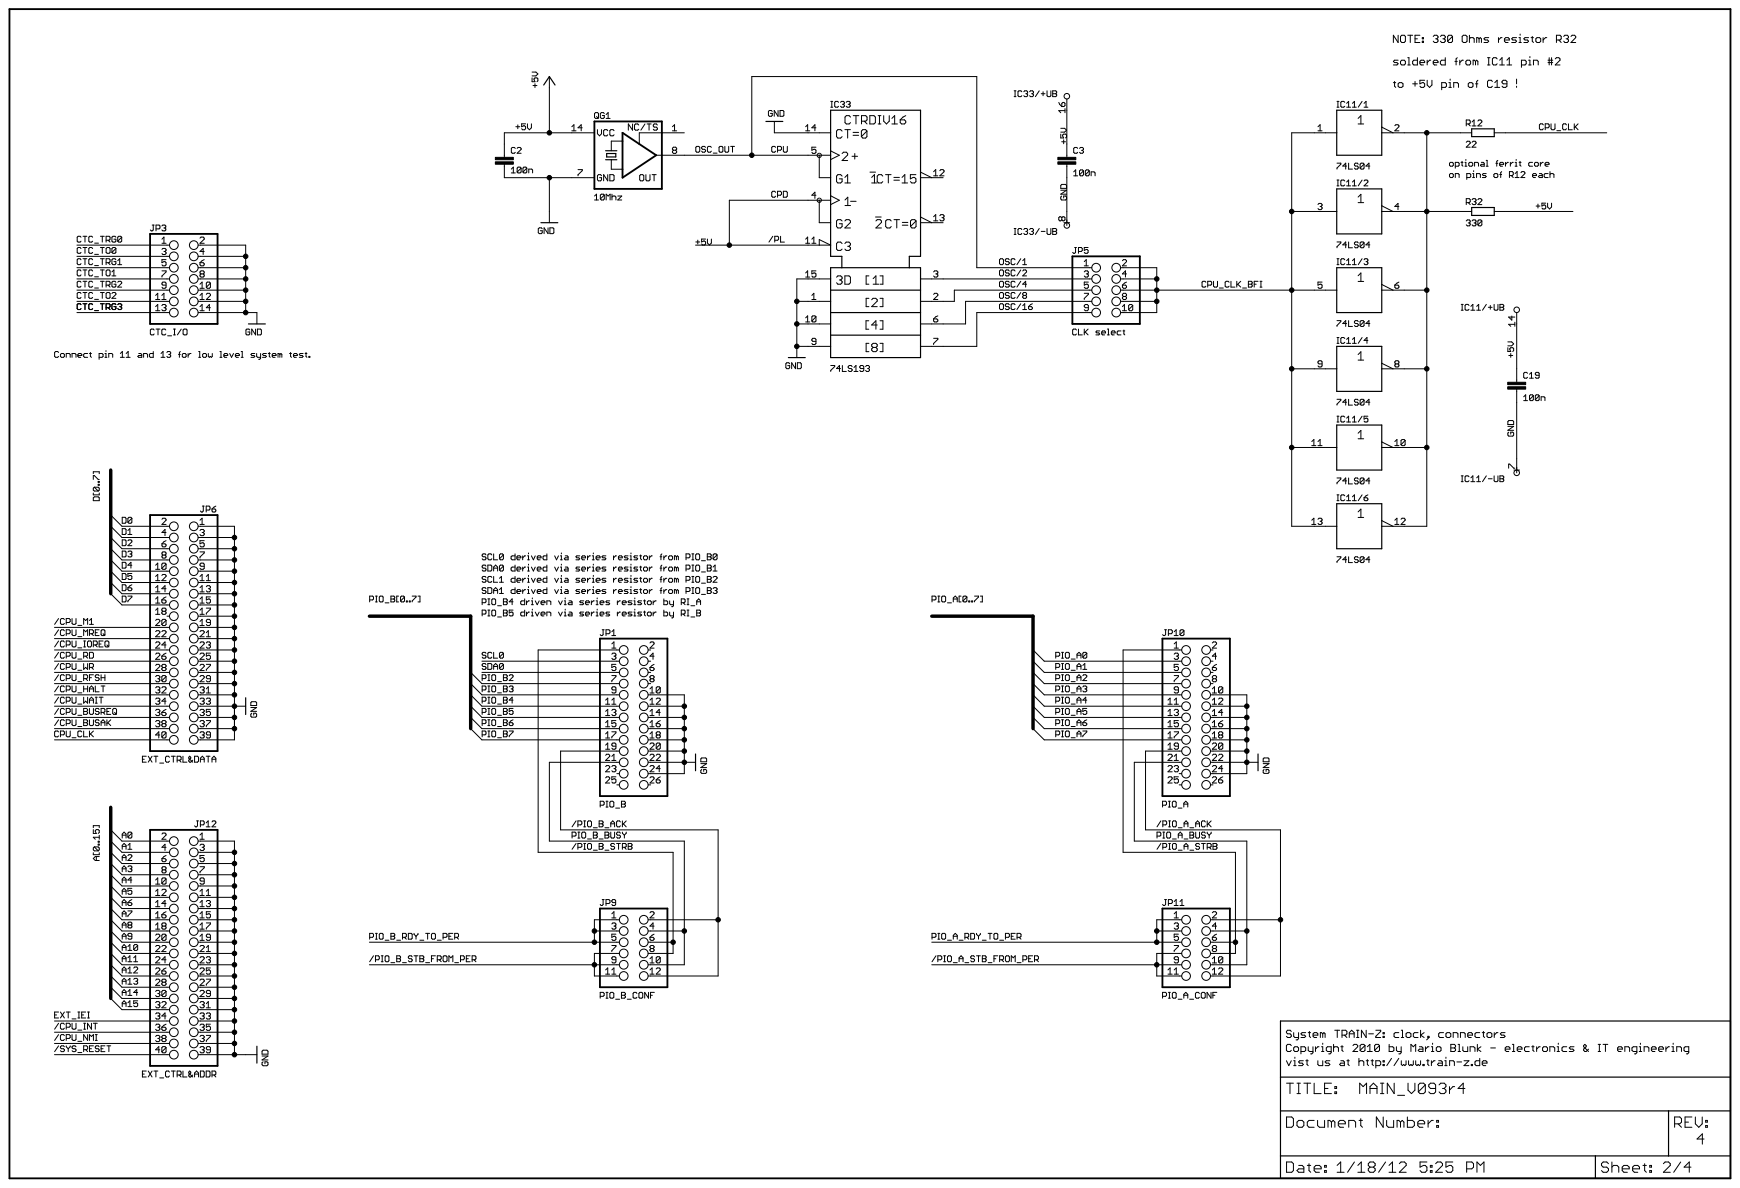
[picture p93: page 2]

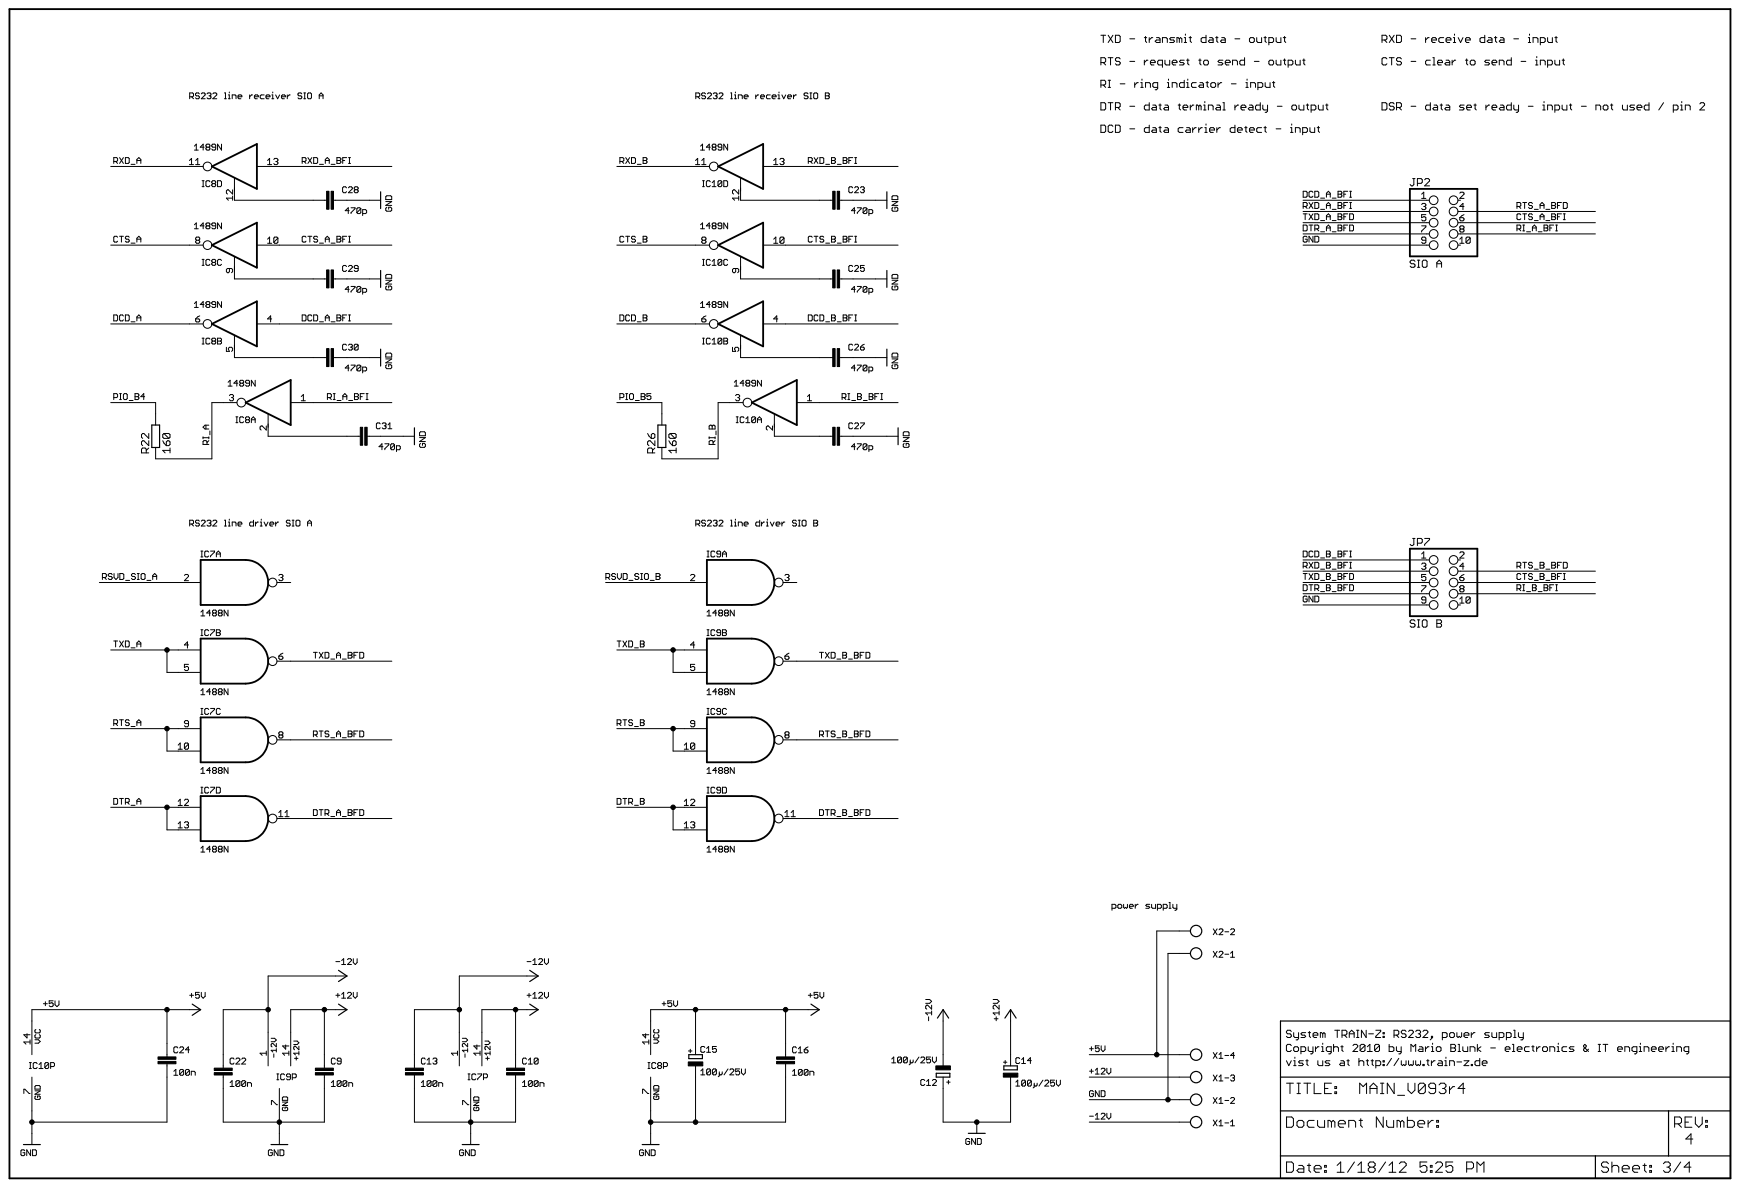
[picture p94: page 3]

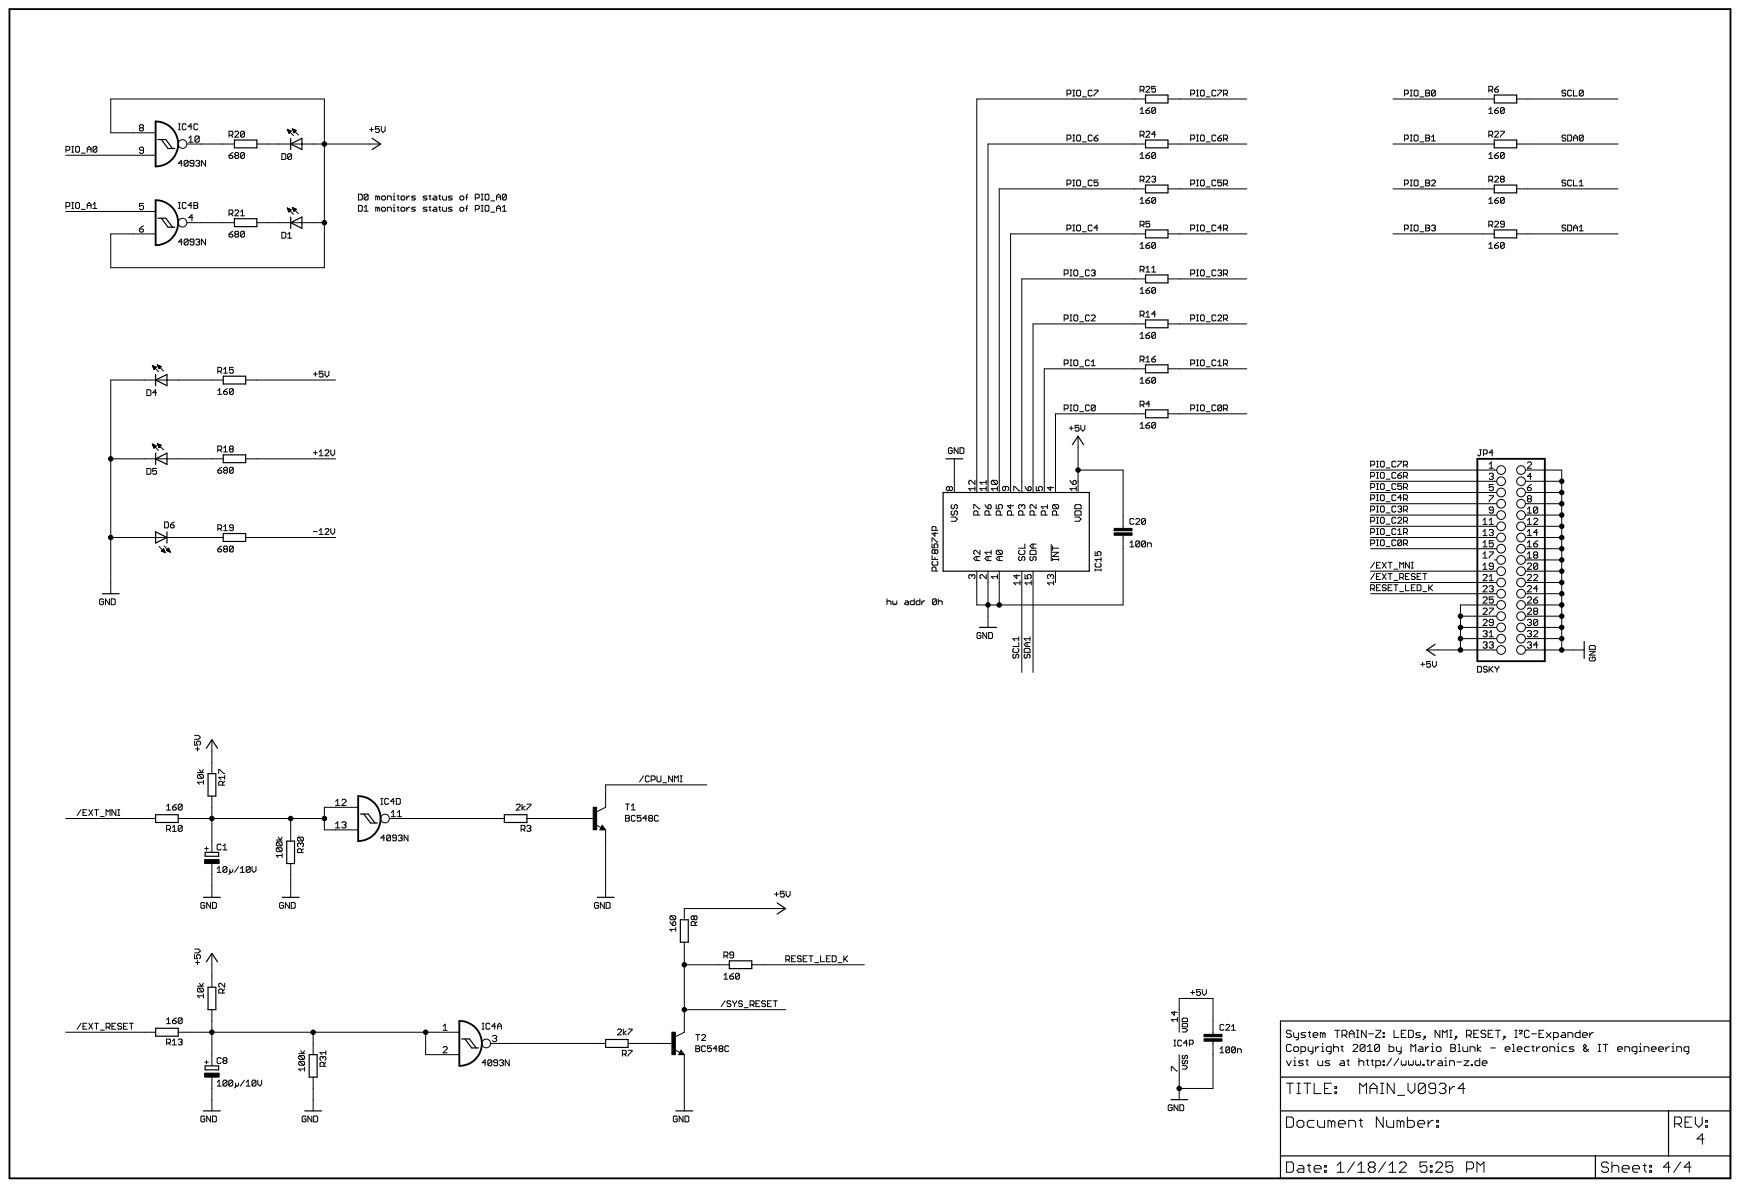
[picture p95: page 4]
