Blunk-electronic/TRAIN-Z/hardware/computer/pdf/MAIN_V093r4_top_assy.pdf

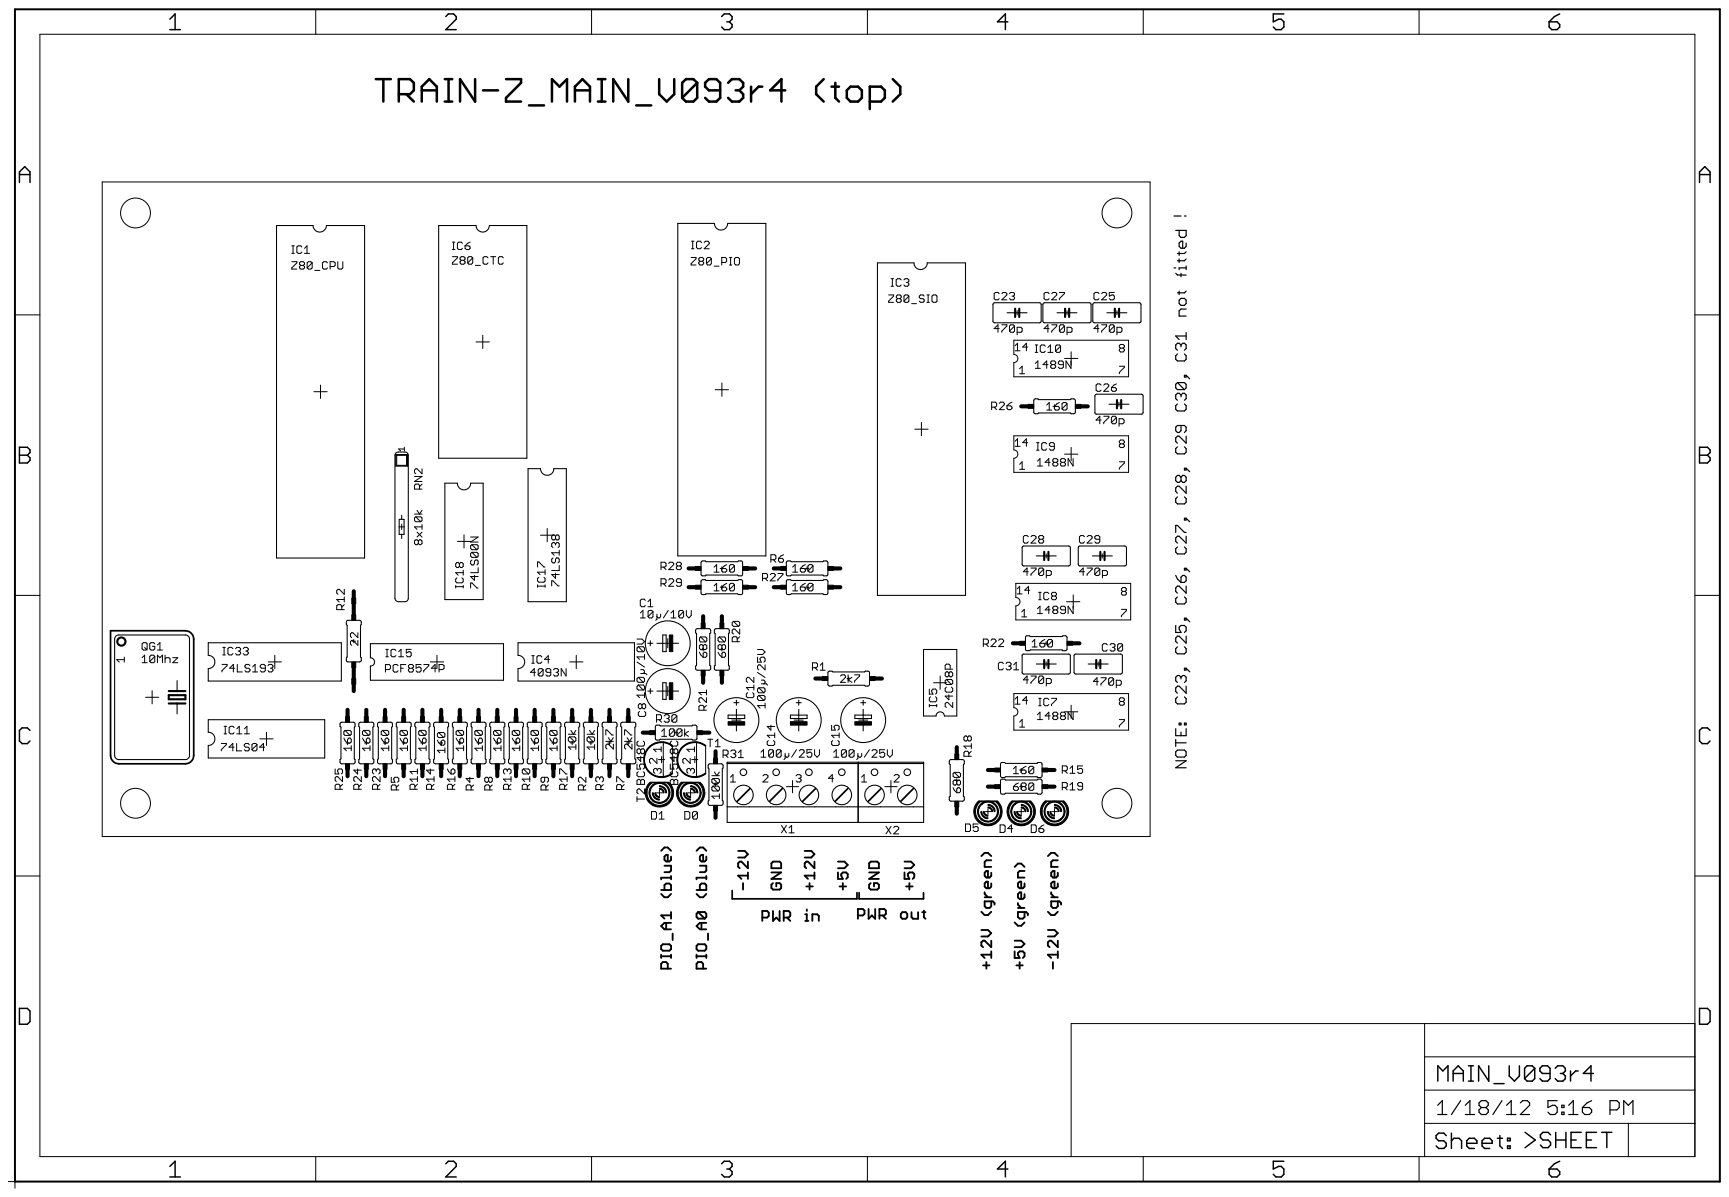
[picture p96: page 1]
