Blunk-electronic/TRAIN-Z/hardware/computer/pdf/MMU_V101r3_bot_assy.pdf

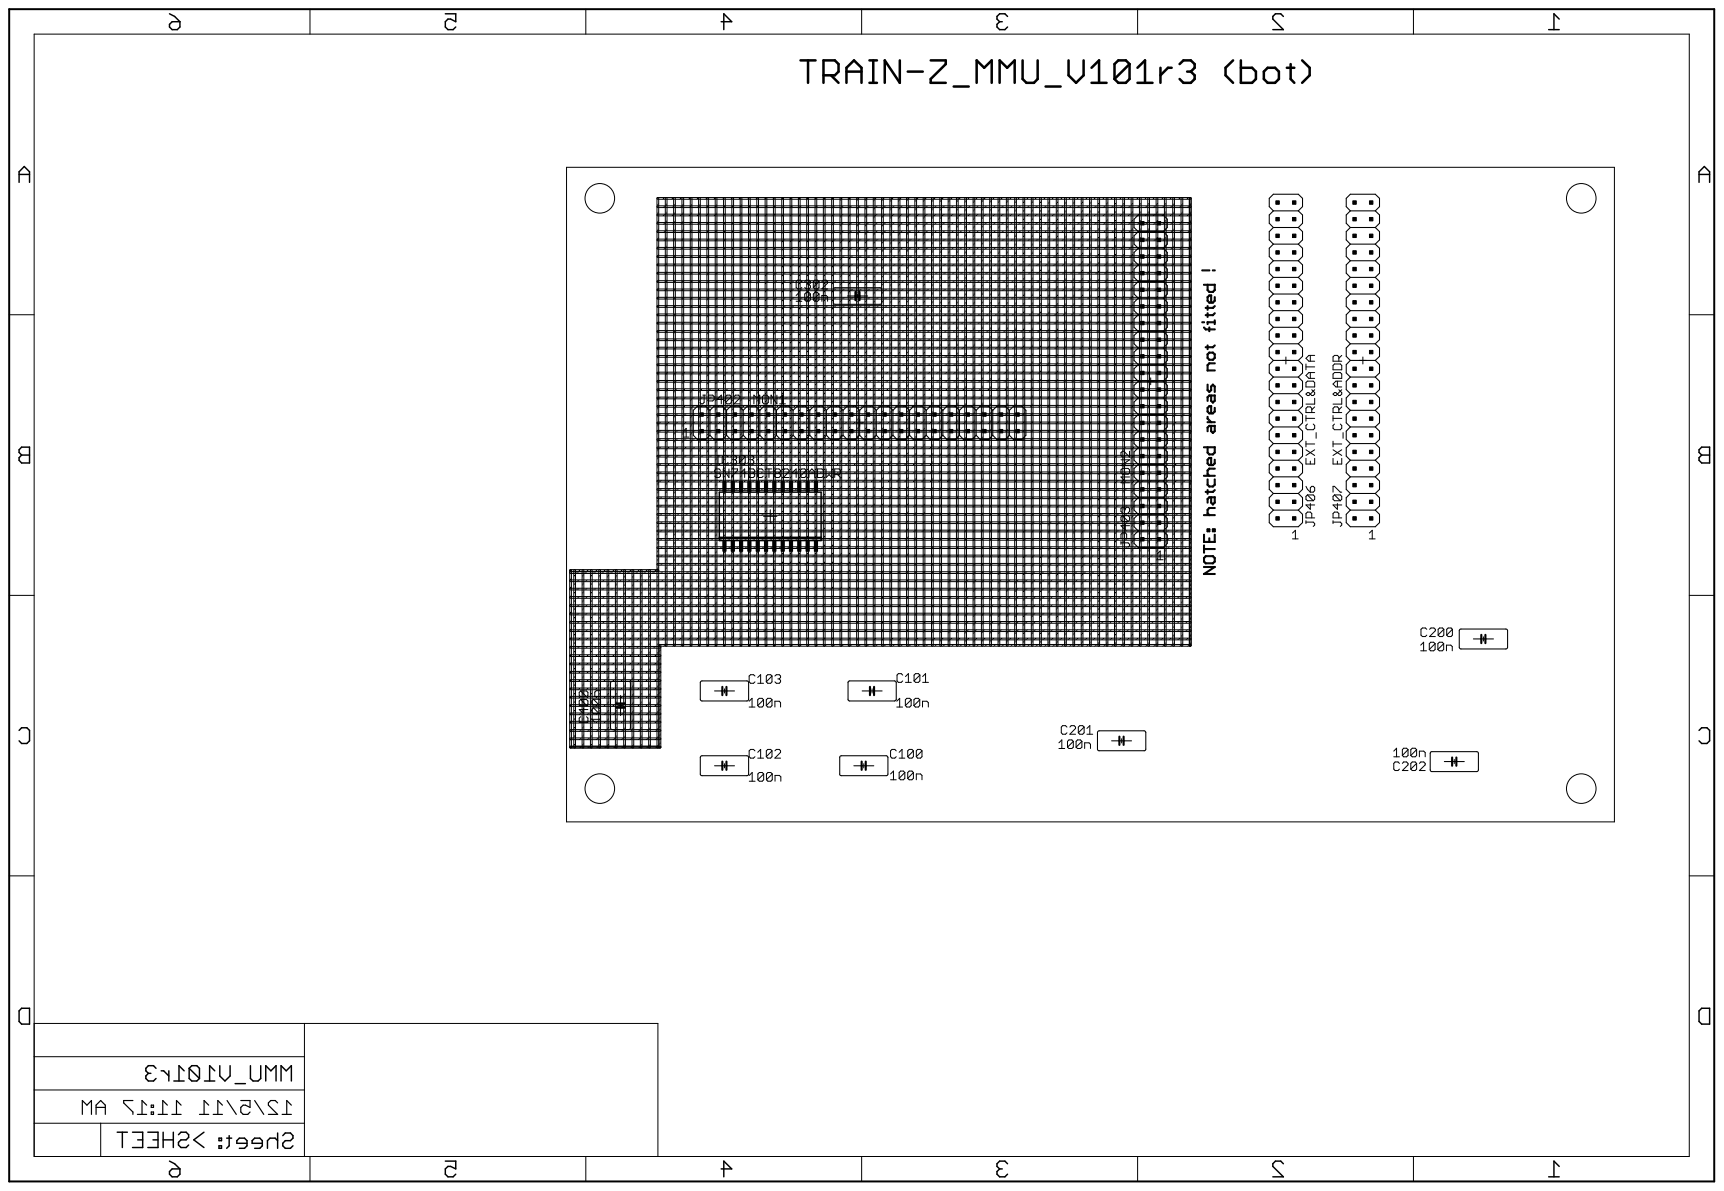
[picture p97: page 1]
