Blunk-electronic/TRAIN-Z/hardware/computer/pdf/MMU_V101r3_sch.pdf

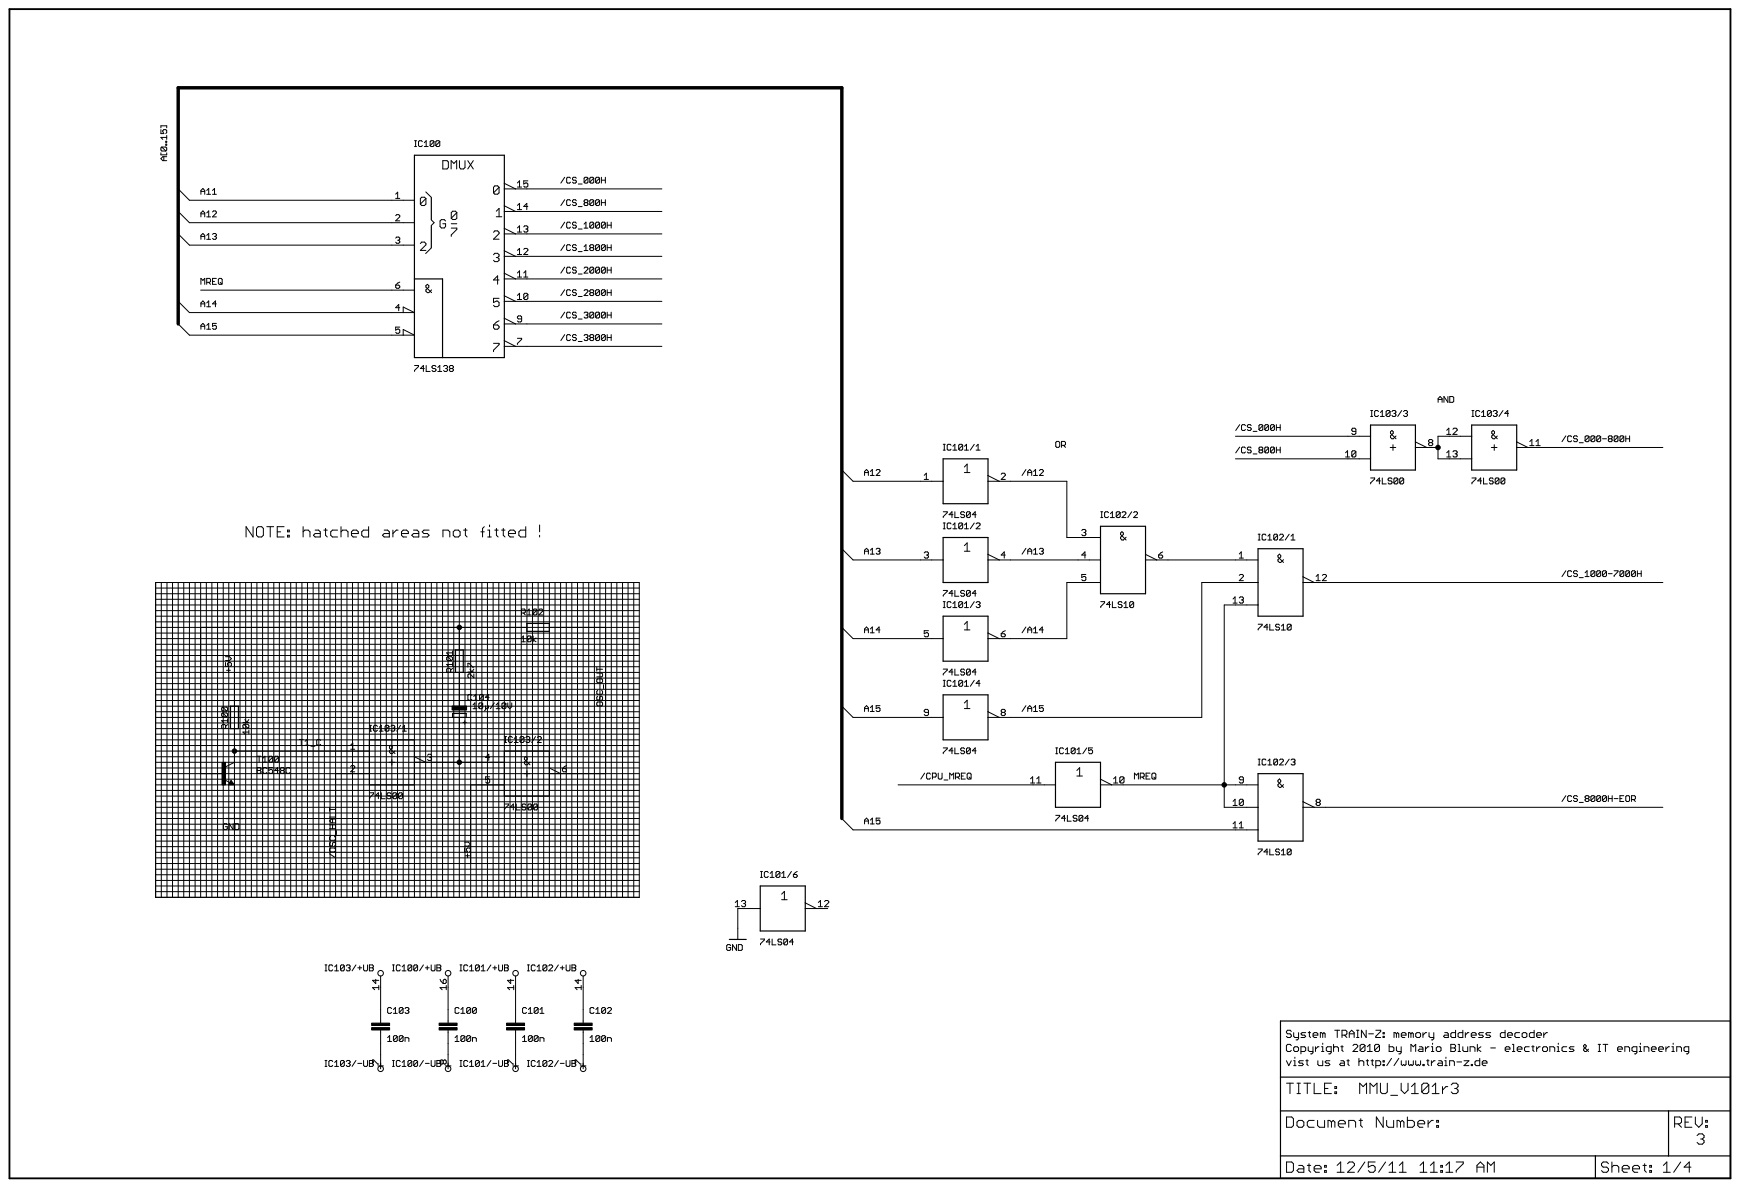
[picture p98: page 1]

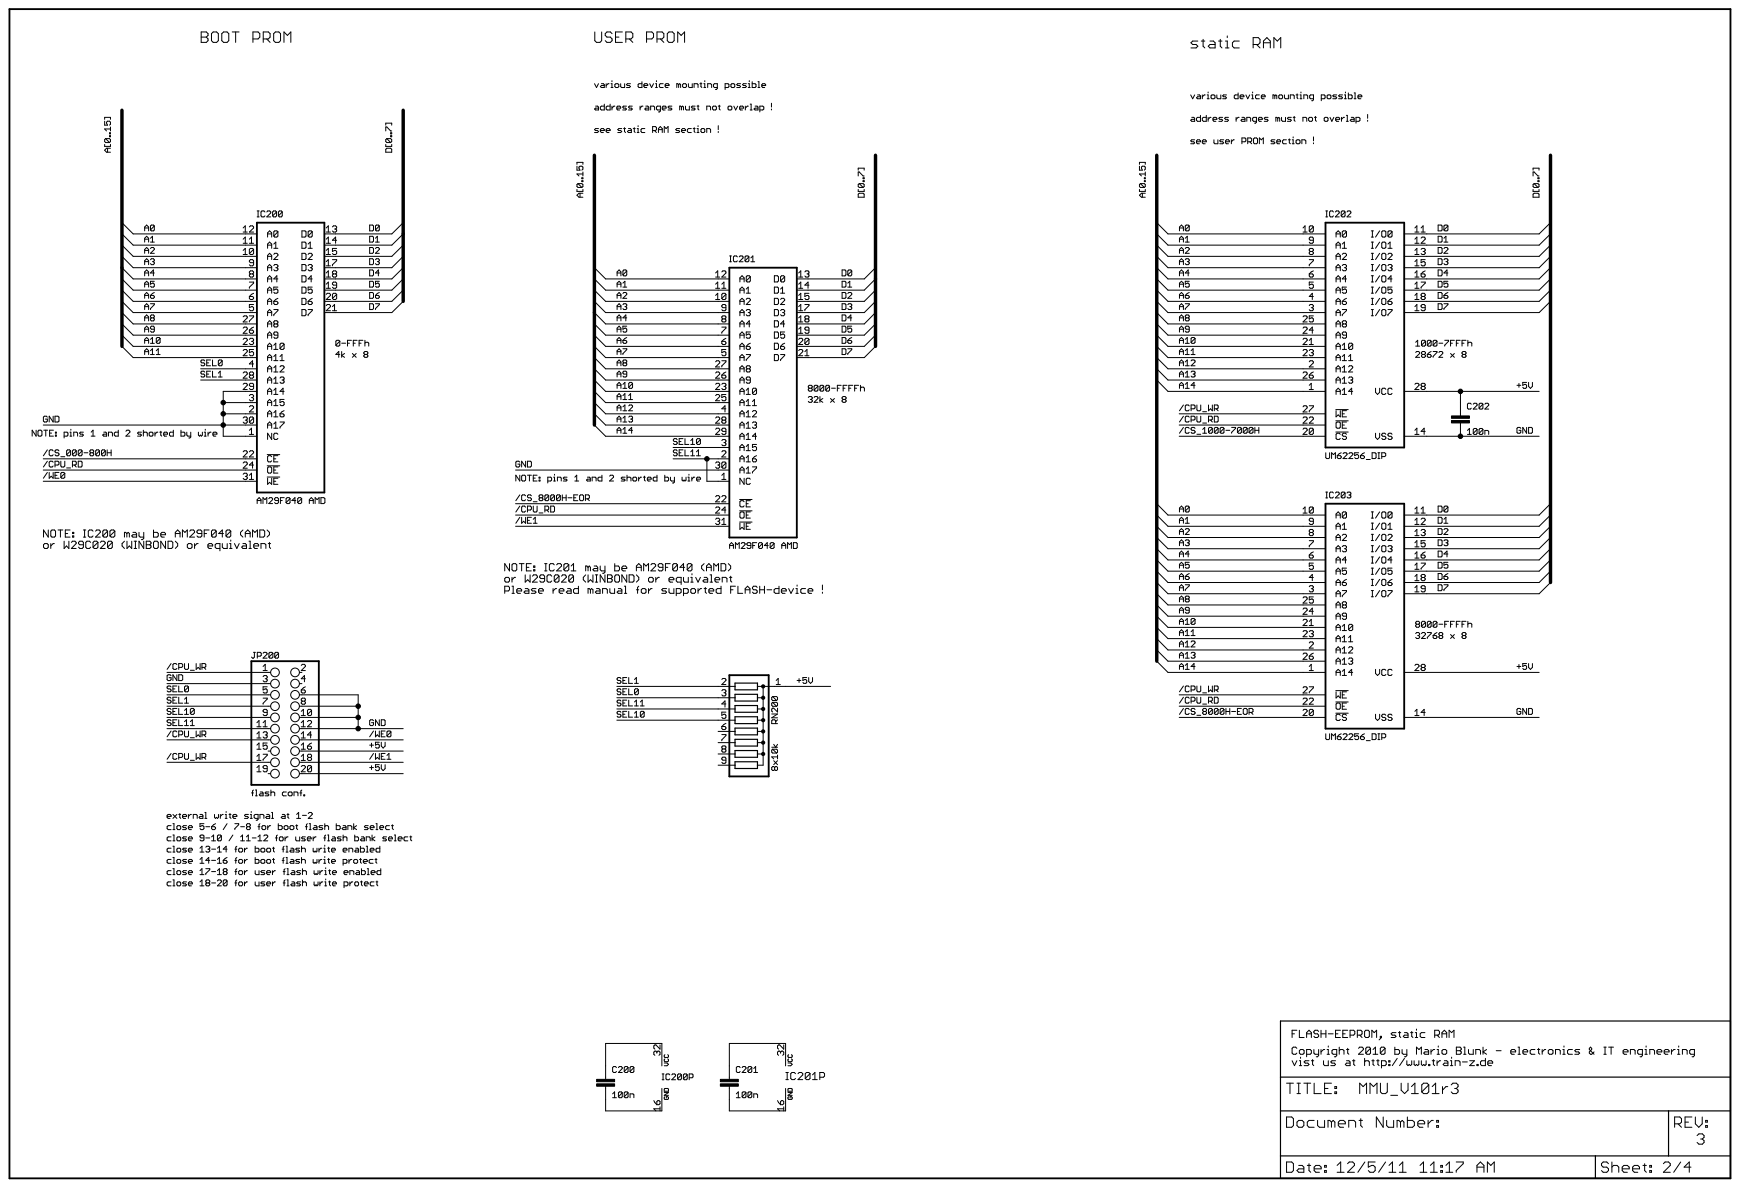
[picture p99: page 2]

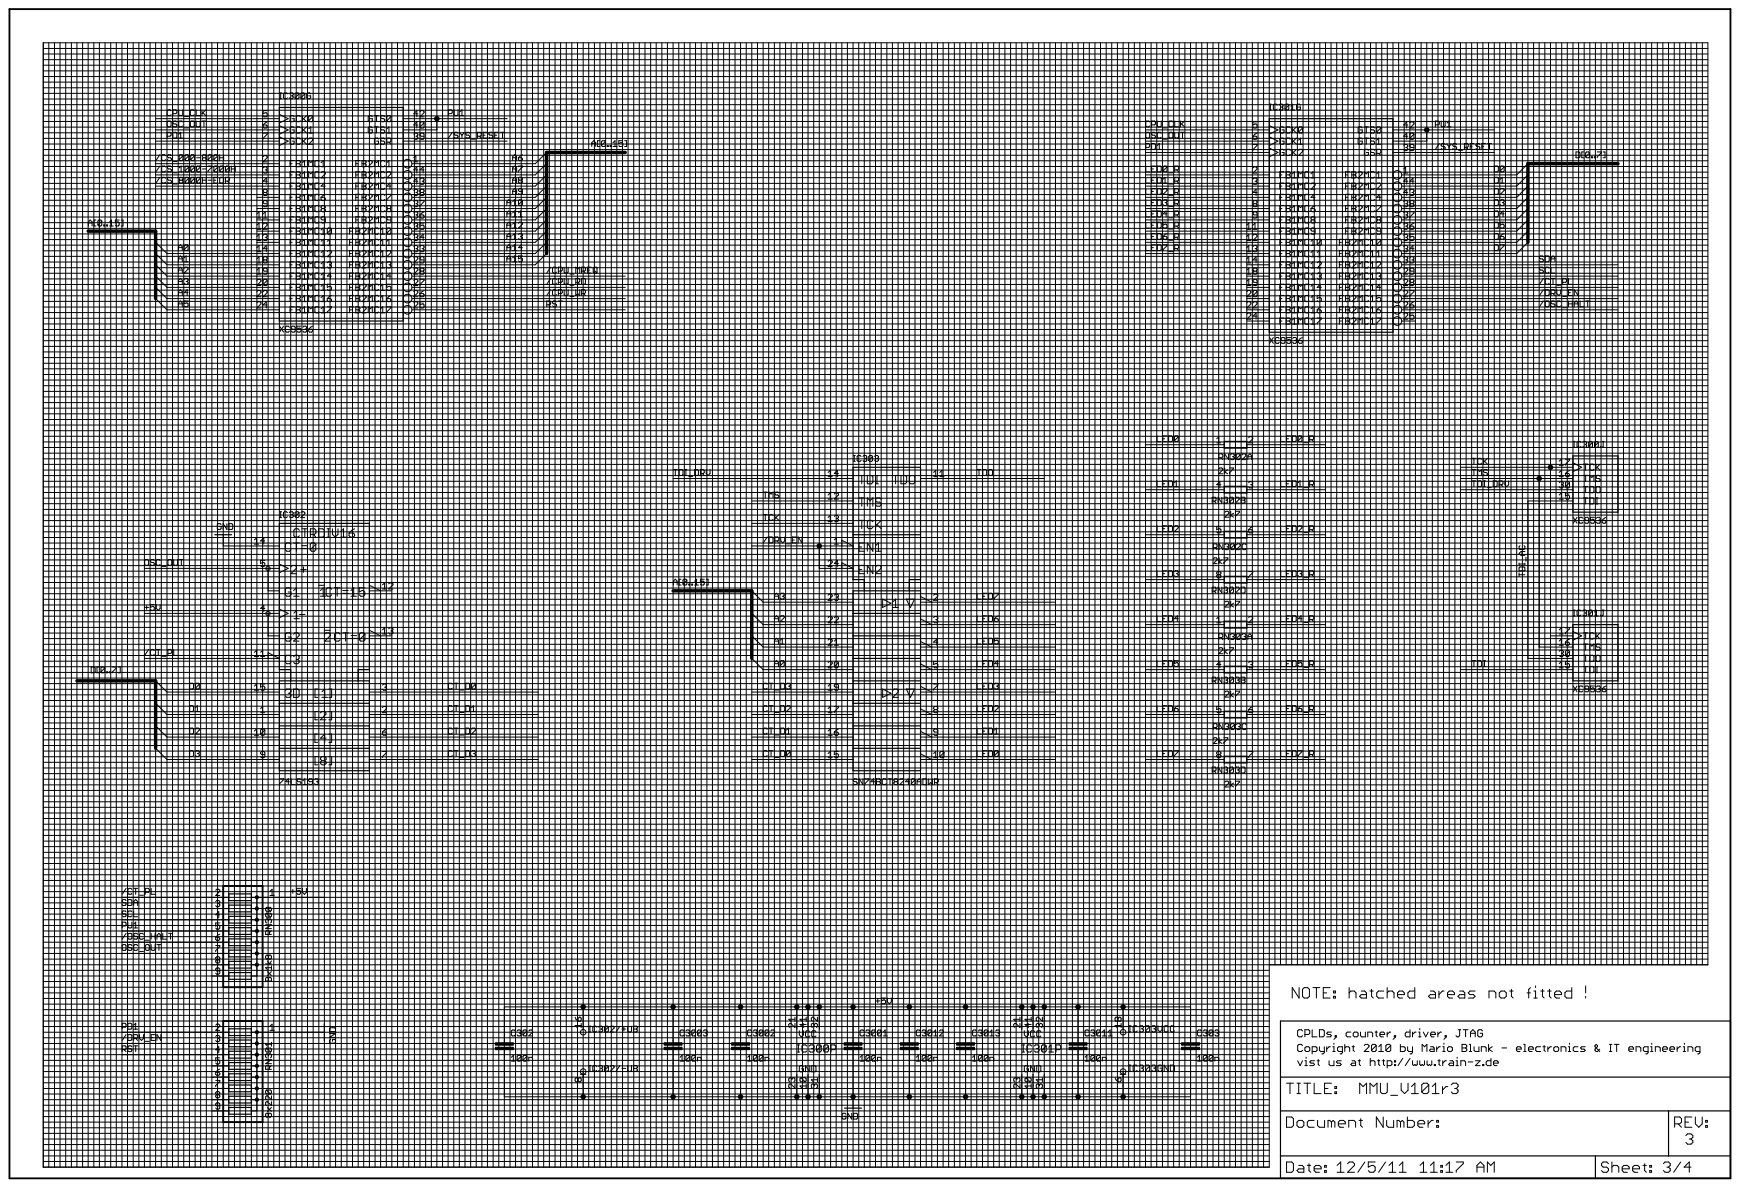
[picture p100: page 3]

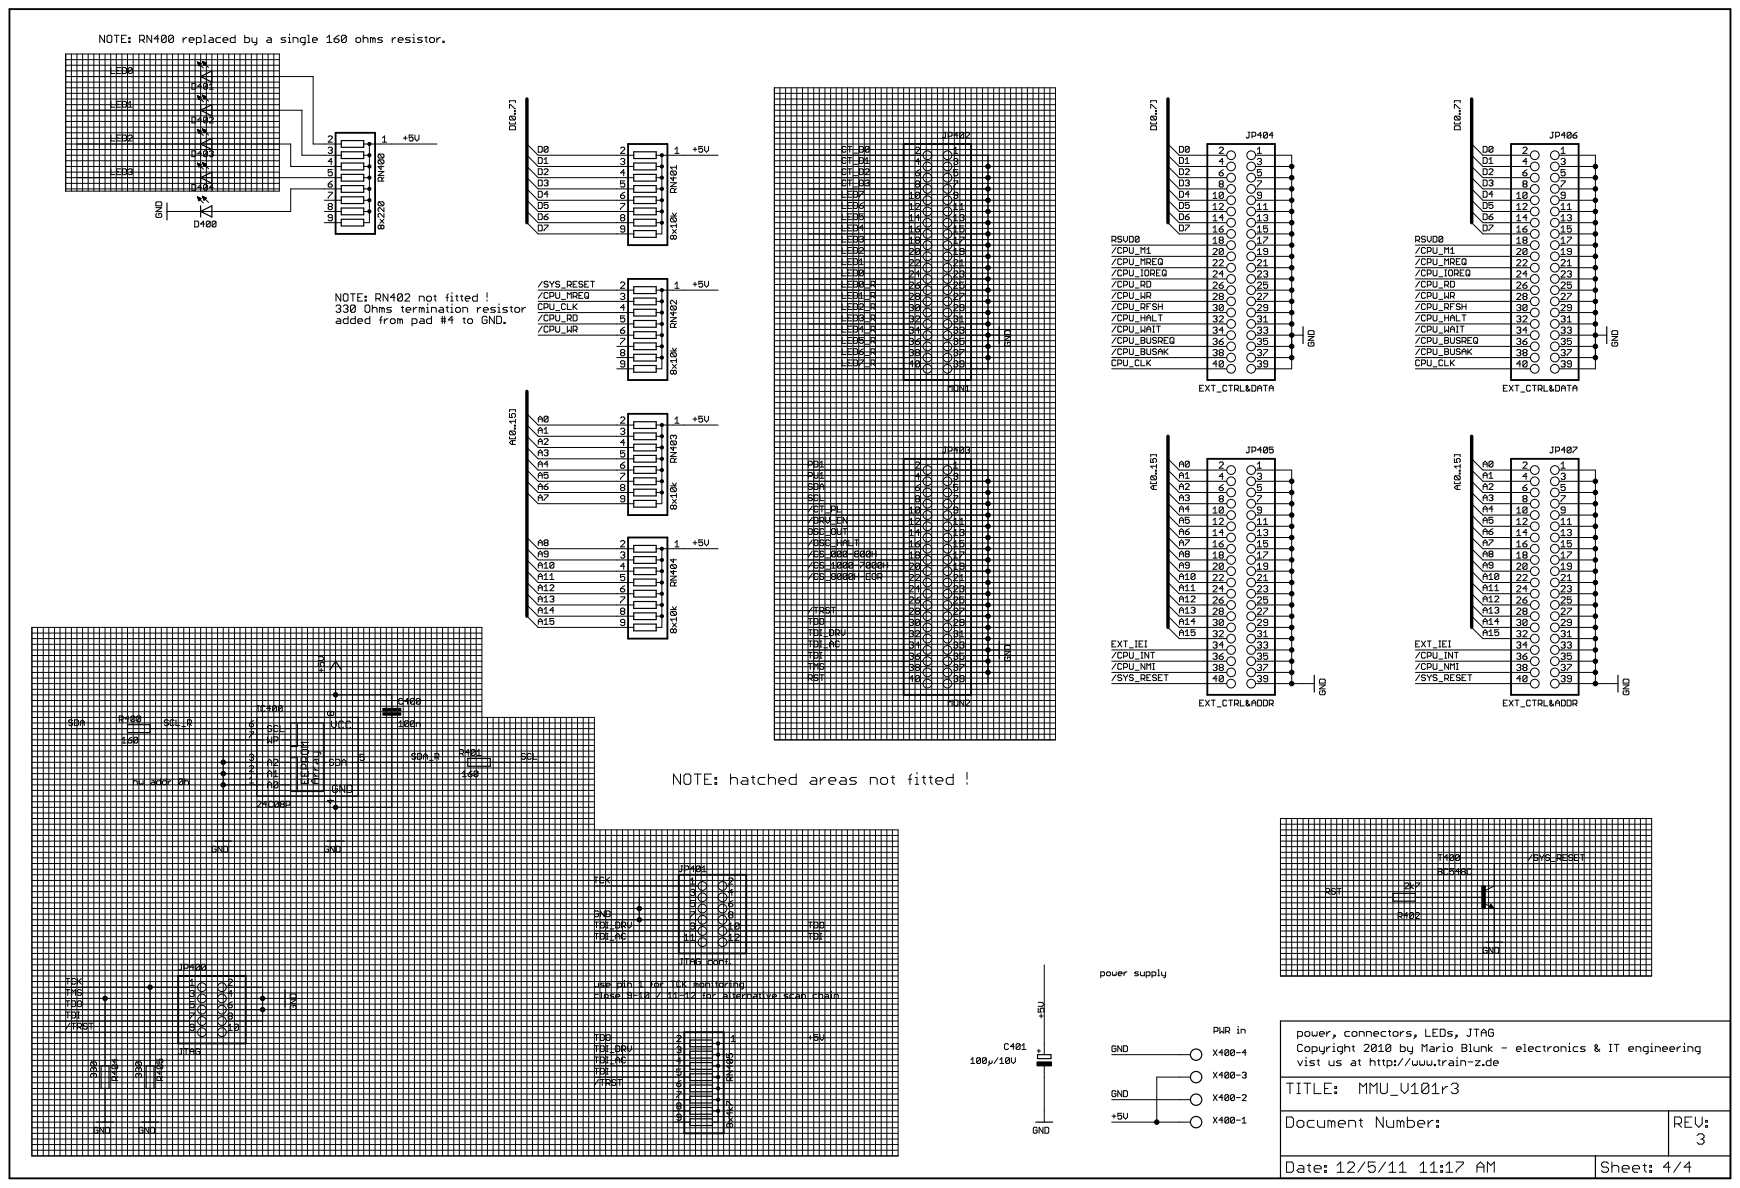
[picture p101: page 4]
