Blunk-electronic/TRAIN-Z/hardware/computer/pdf/MMU_V101r3_top_assy.pdf

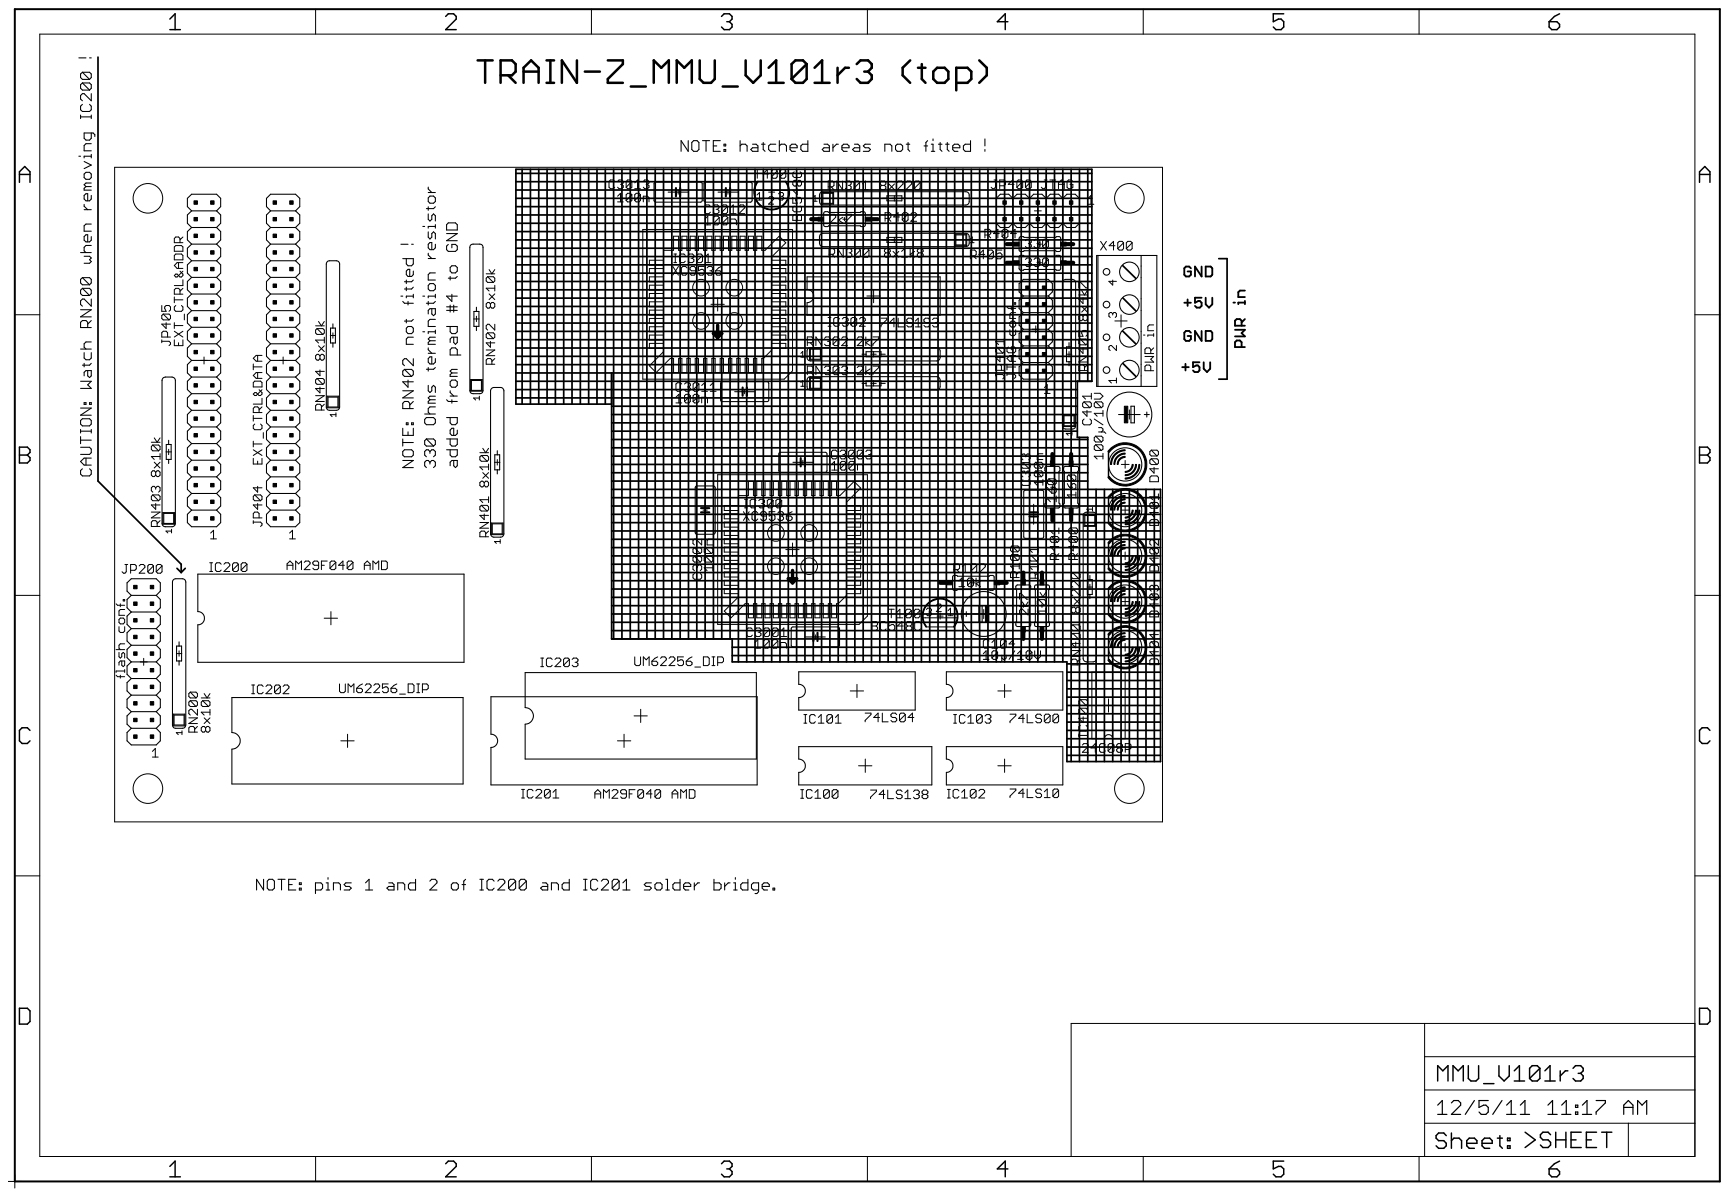
[picture p102: page 1]
