Blunk-electronic/TRAIN-Z/hardware/computer/pdf/MMU_V101r4_bot_assy.pdf

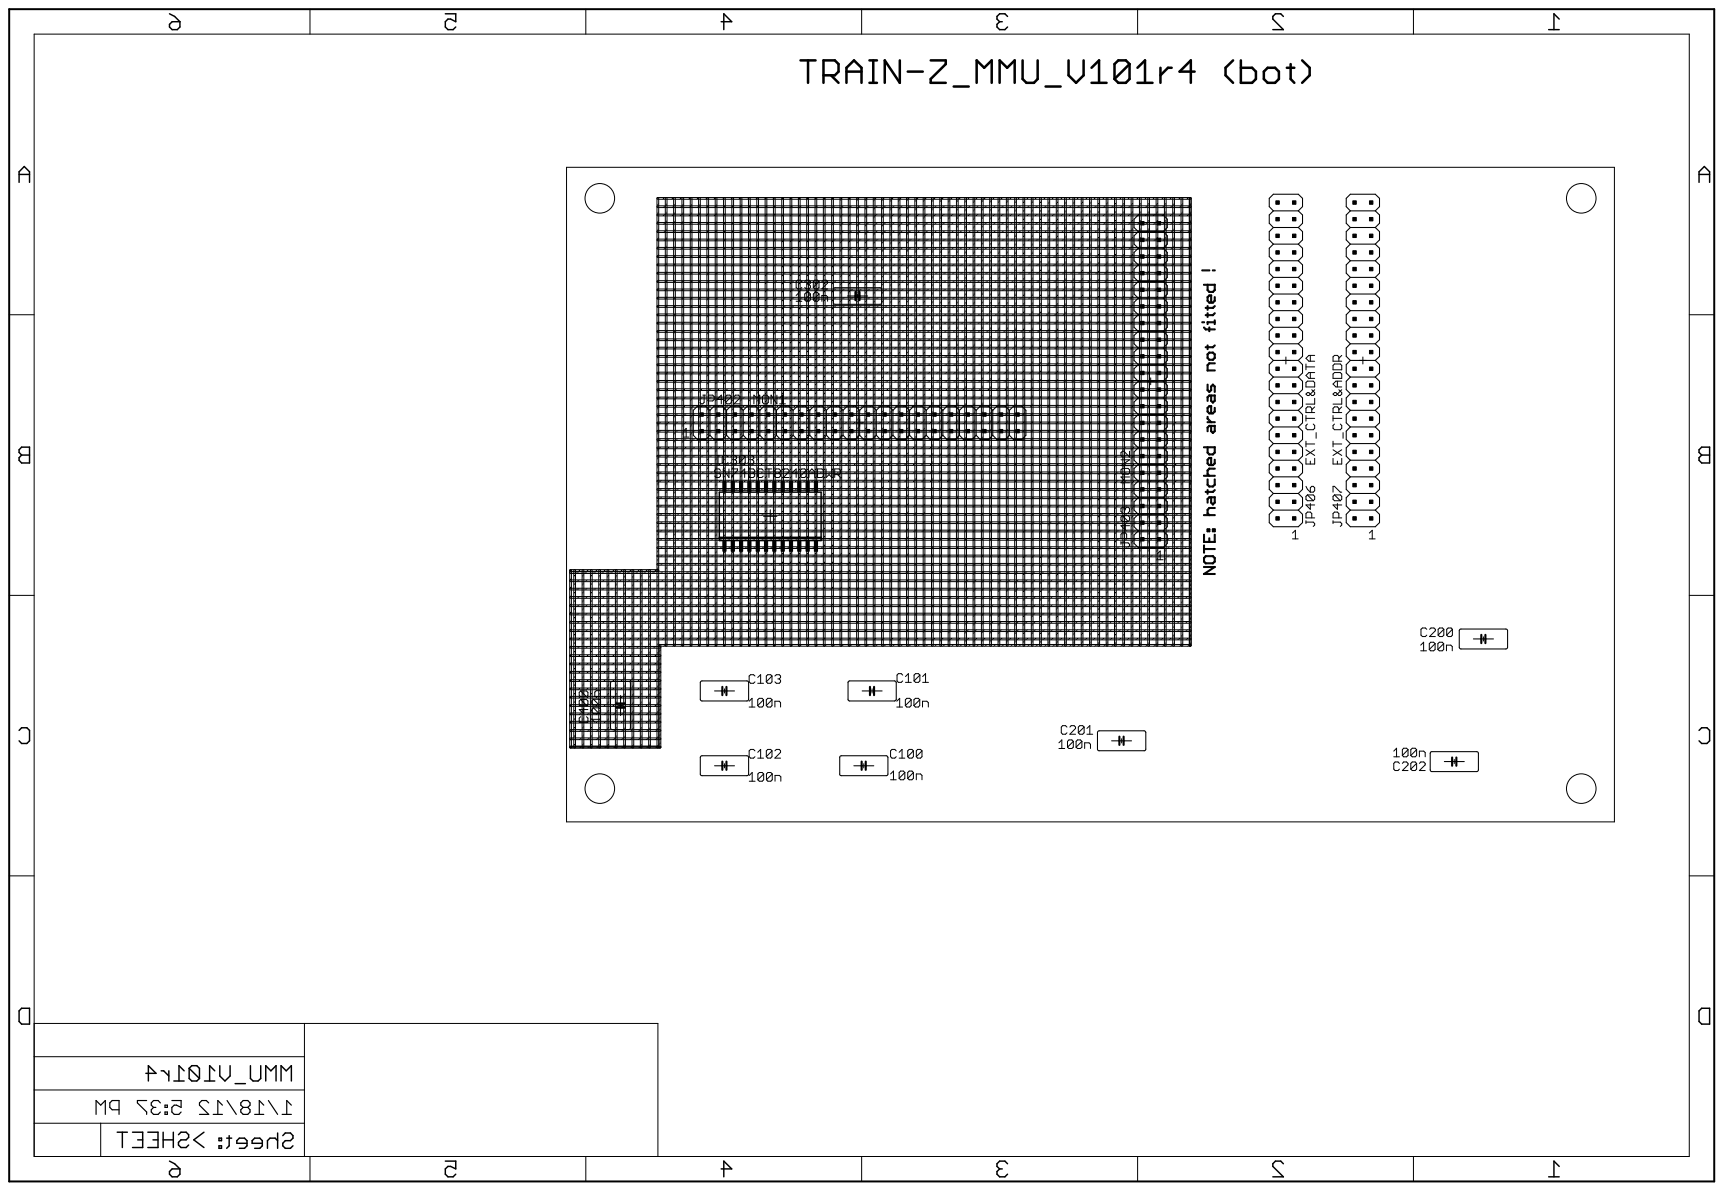
[picture p103: page 1]
