Blunk-electronic/TRAIN-Z/hardware/computer/pdf/MMU_V101r4_sch.pdf

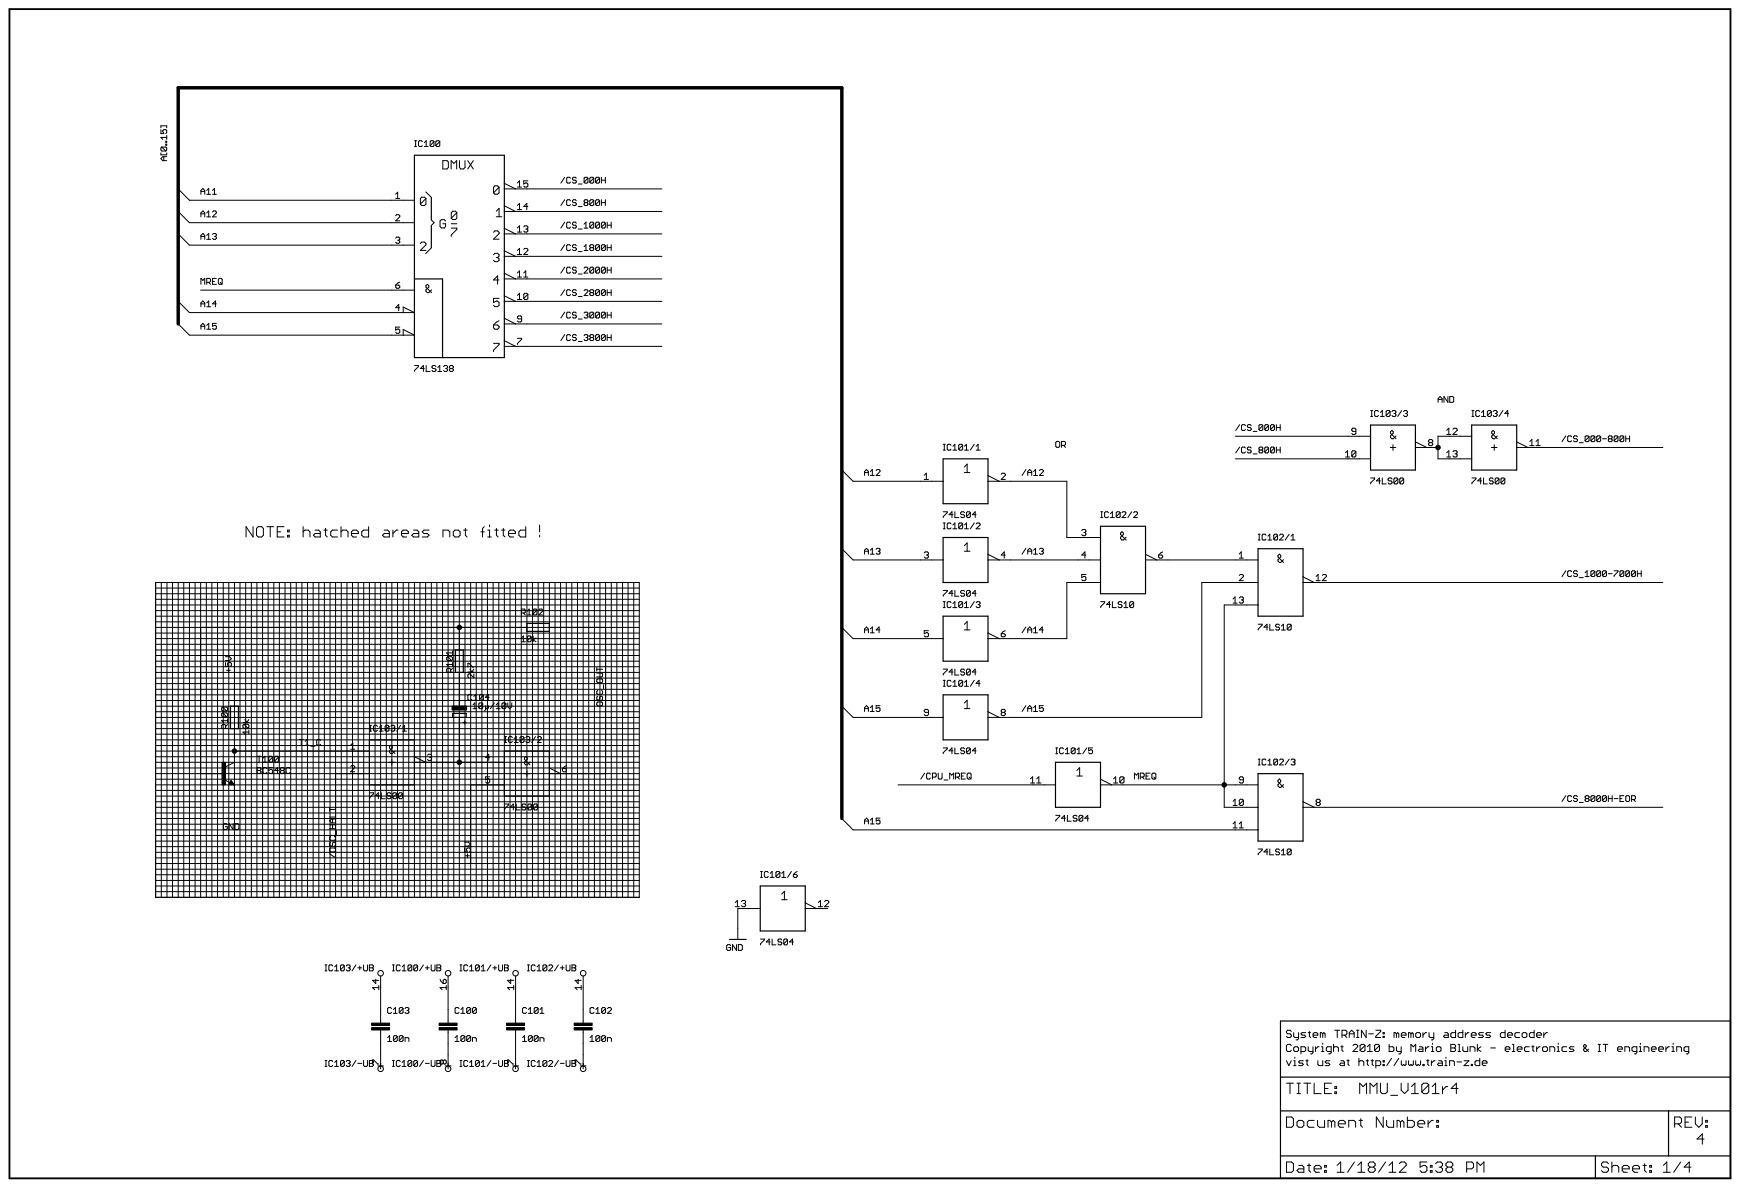
[picture p104: page 1]

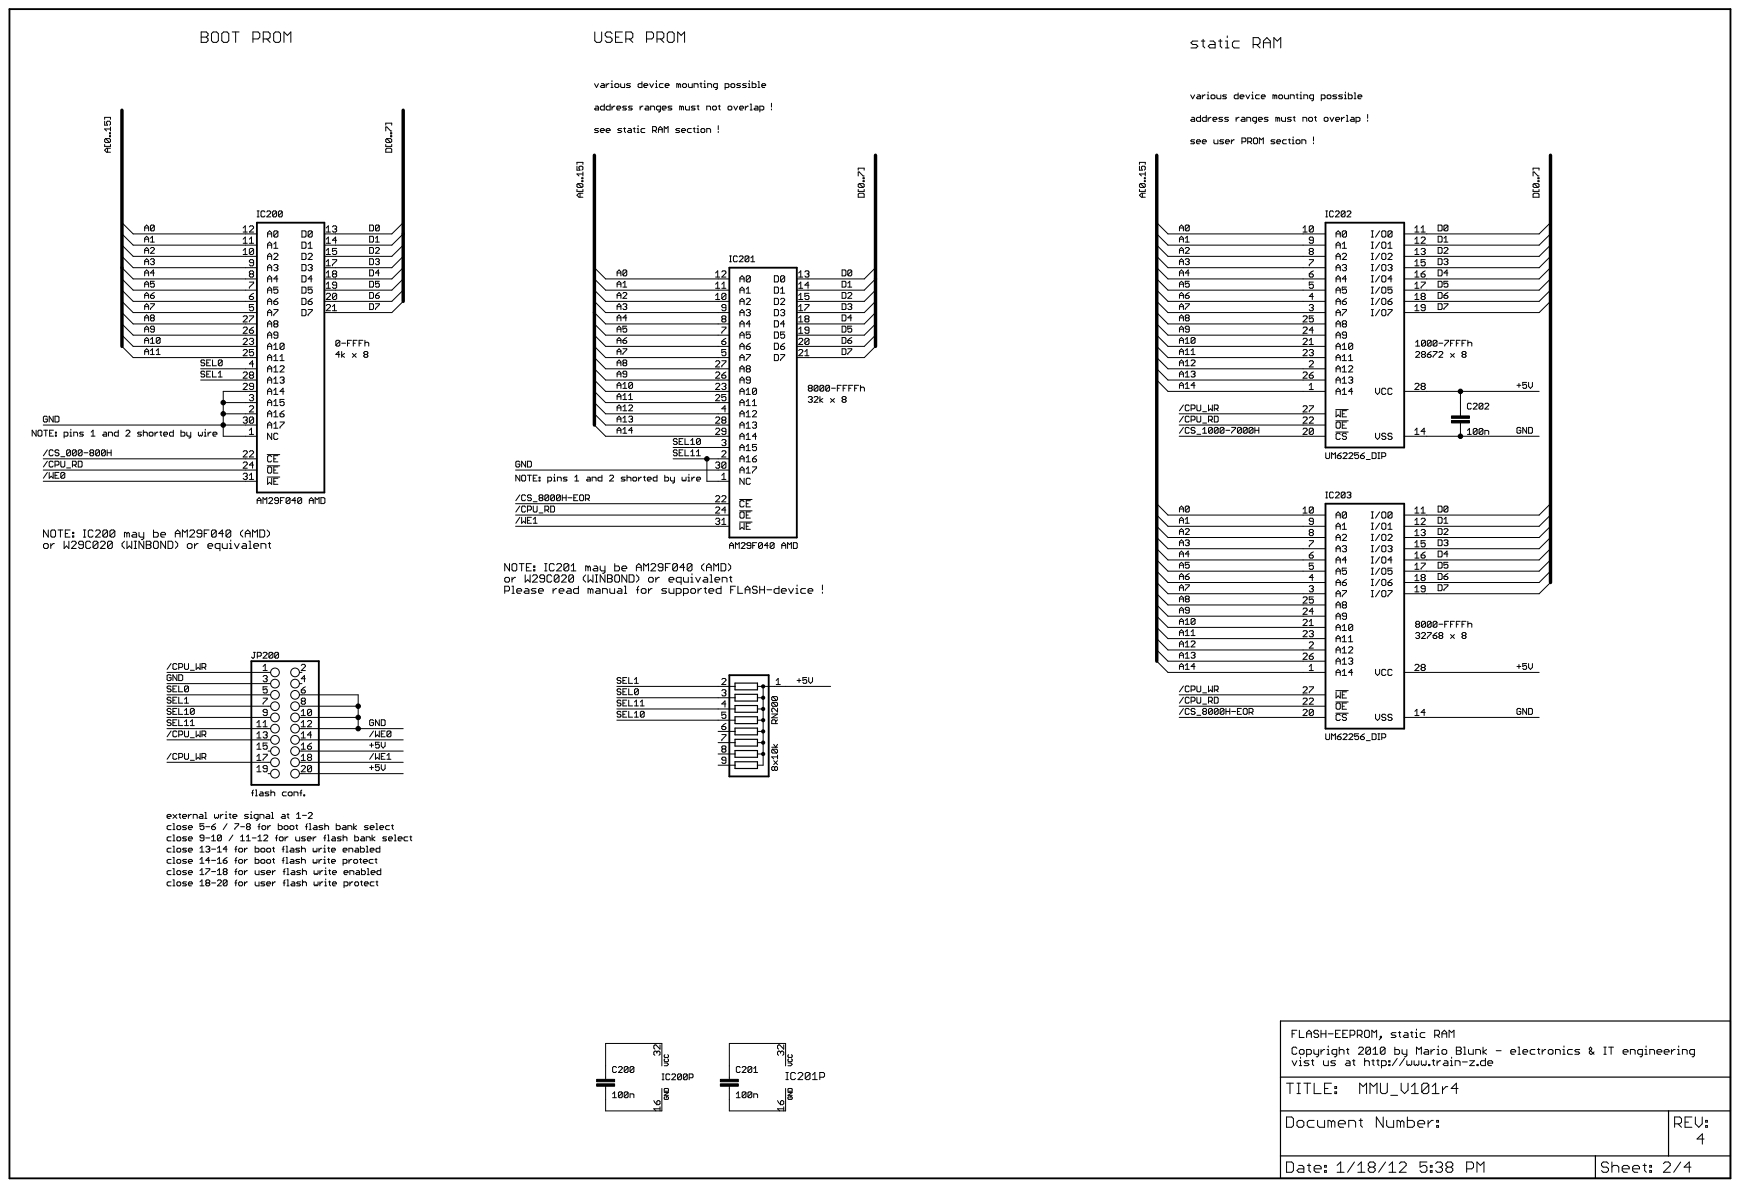
[picture p105: page 2]

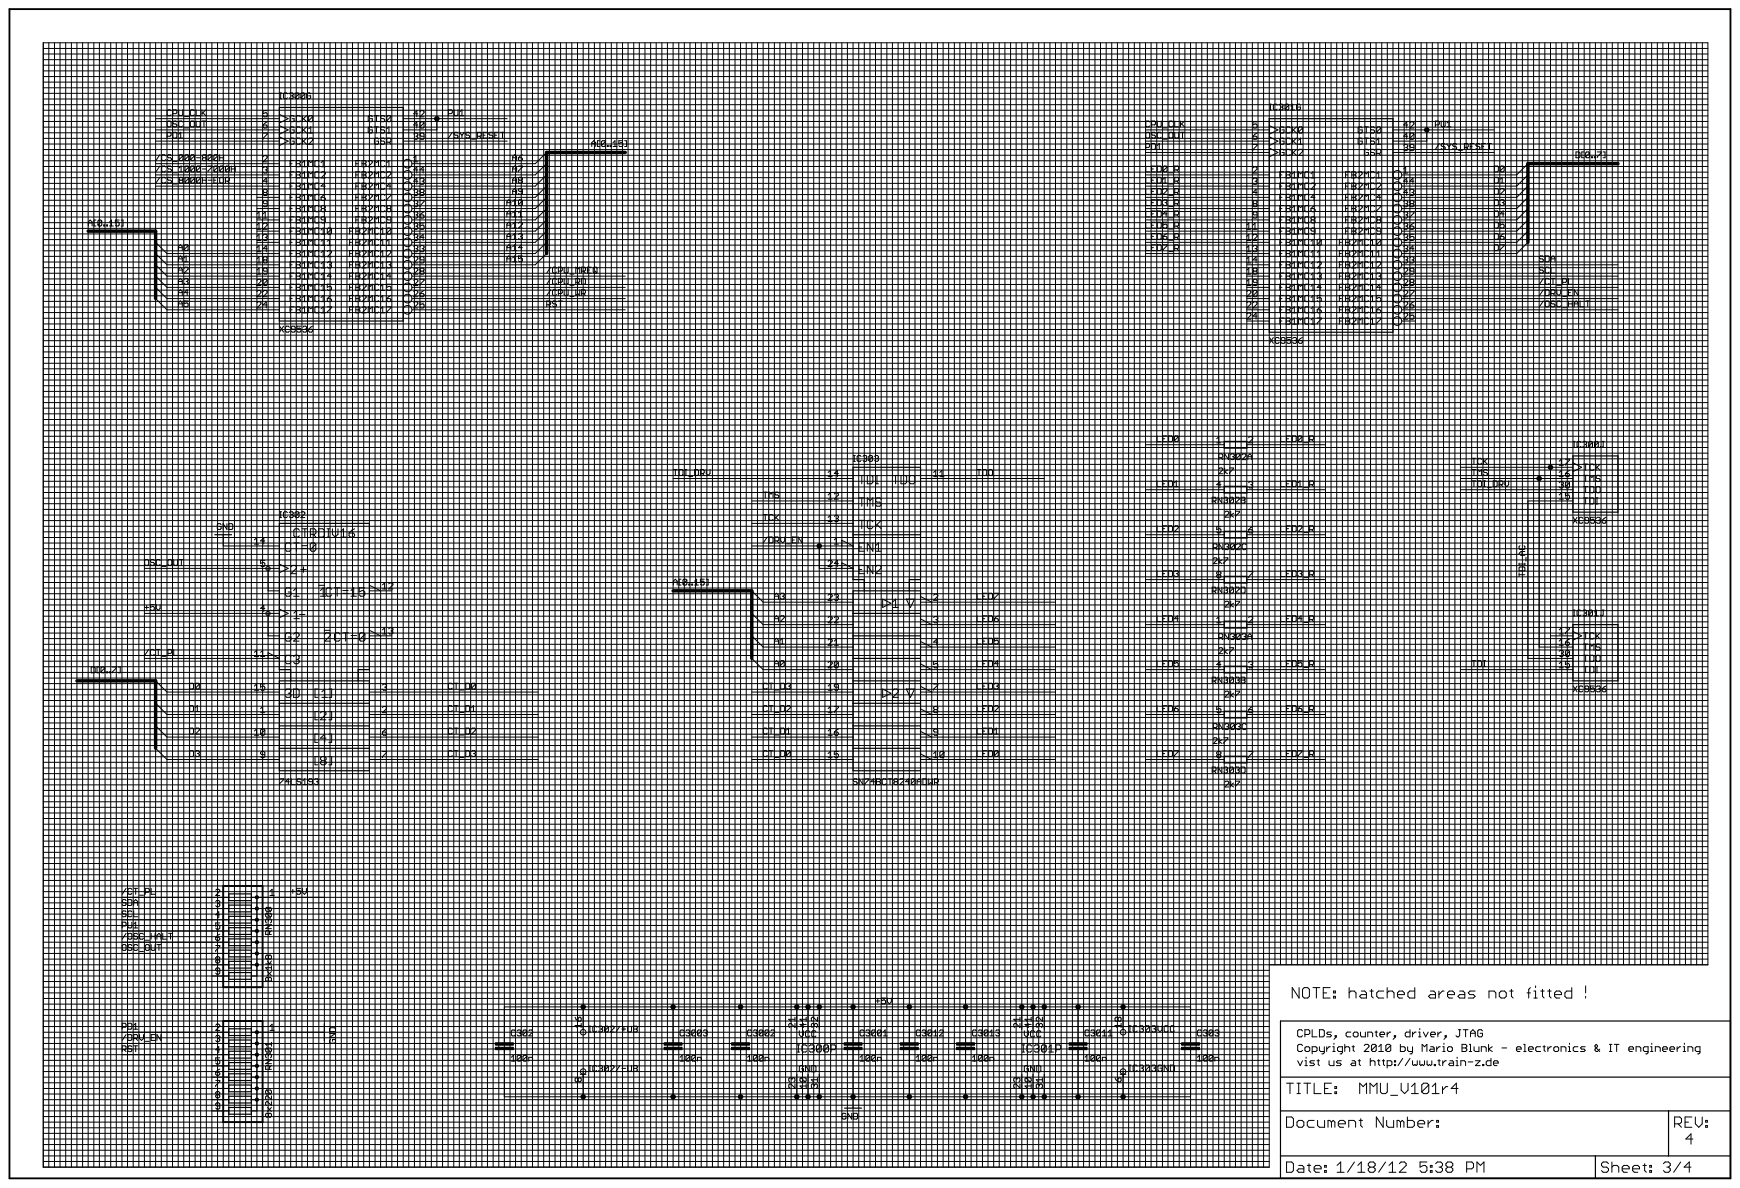
[picture p106: page 3]

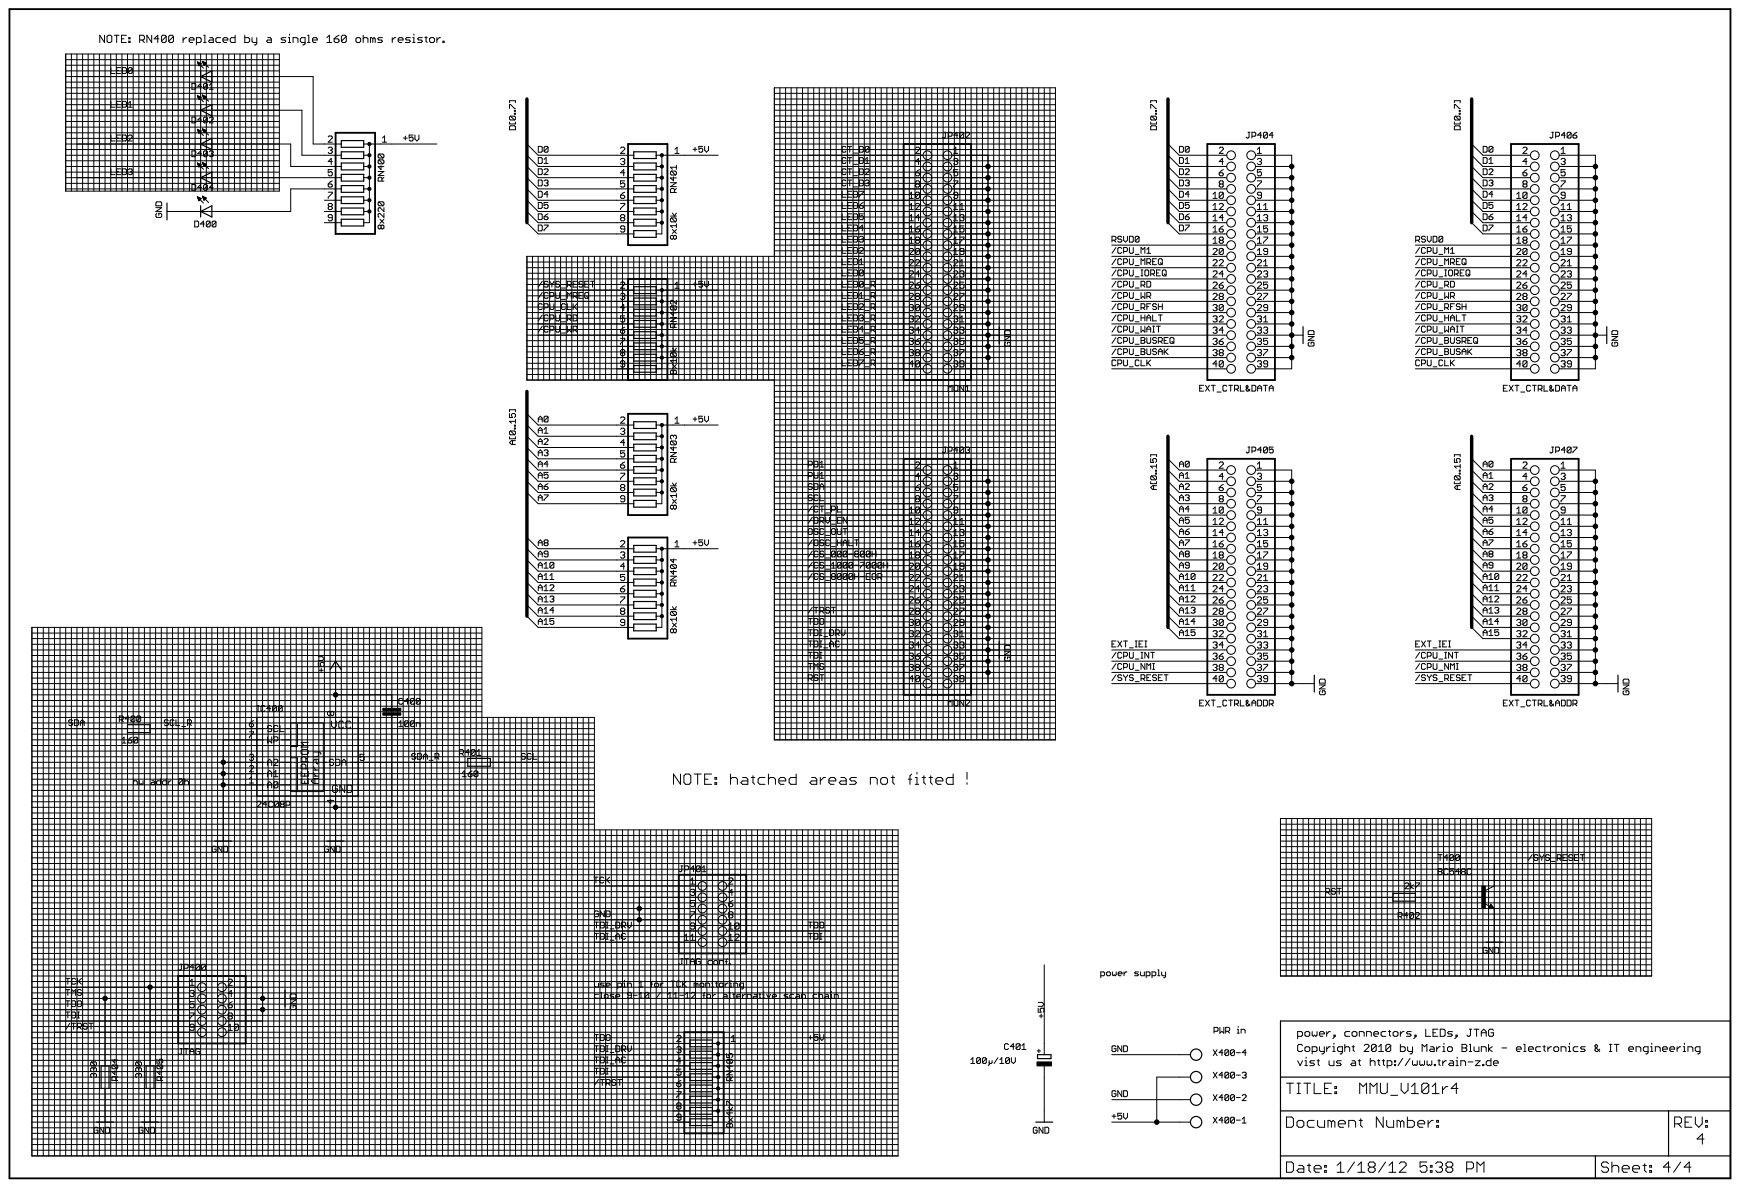
[picture p107: page 4]
