Blunk-electronic/TRAIN-Z/hardware/computer/pdf/MMU_V101r4_top_assy.pdf

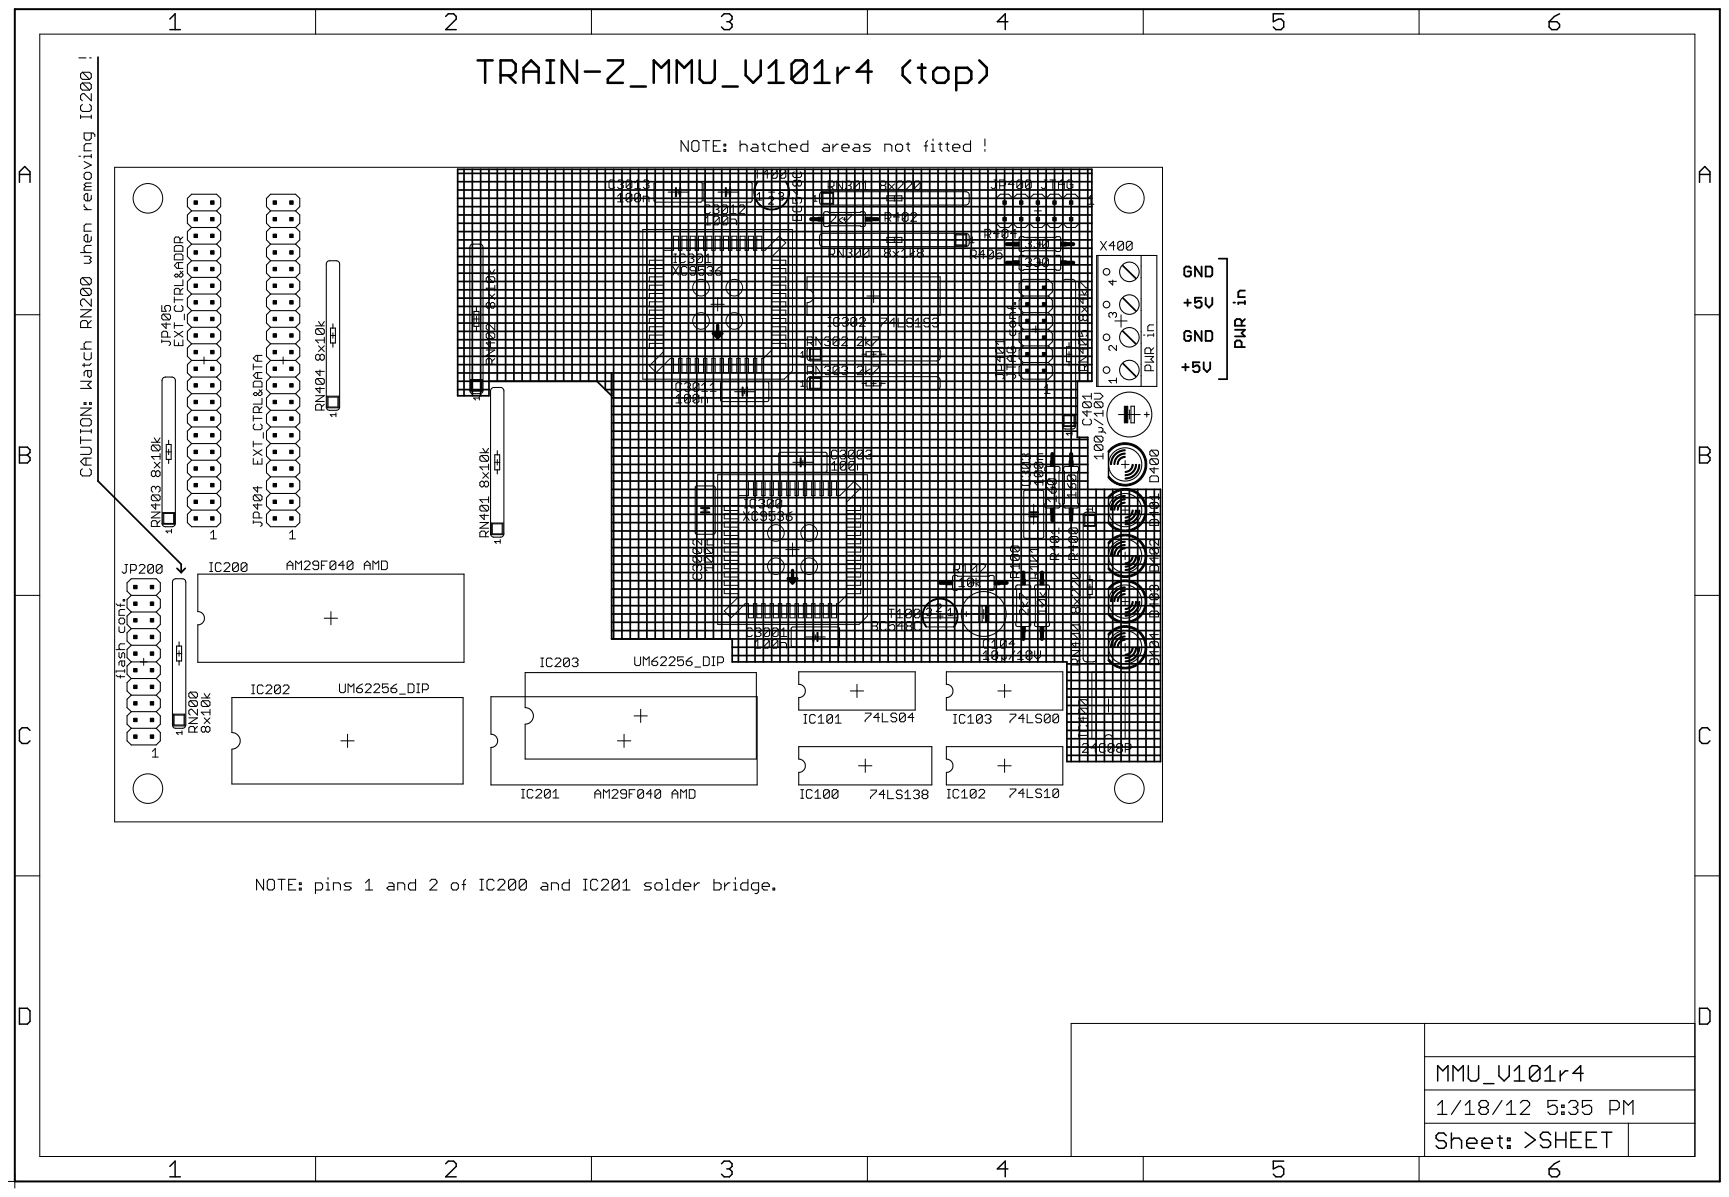
[picture p108: page 1]
