Blunk-electronic/TRAIN-Z/hardware/computer/eagle/mmu/v101r4/MMU_V101r4.brd

## EAGLE design hardware/computer/eagle/mmu/v101r4/MMU_V101r4.brd (2015-09-25)

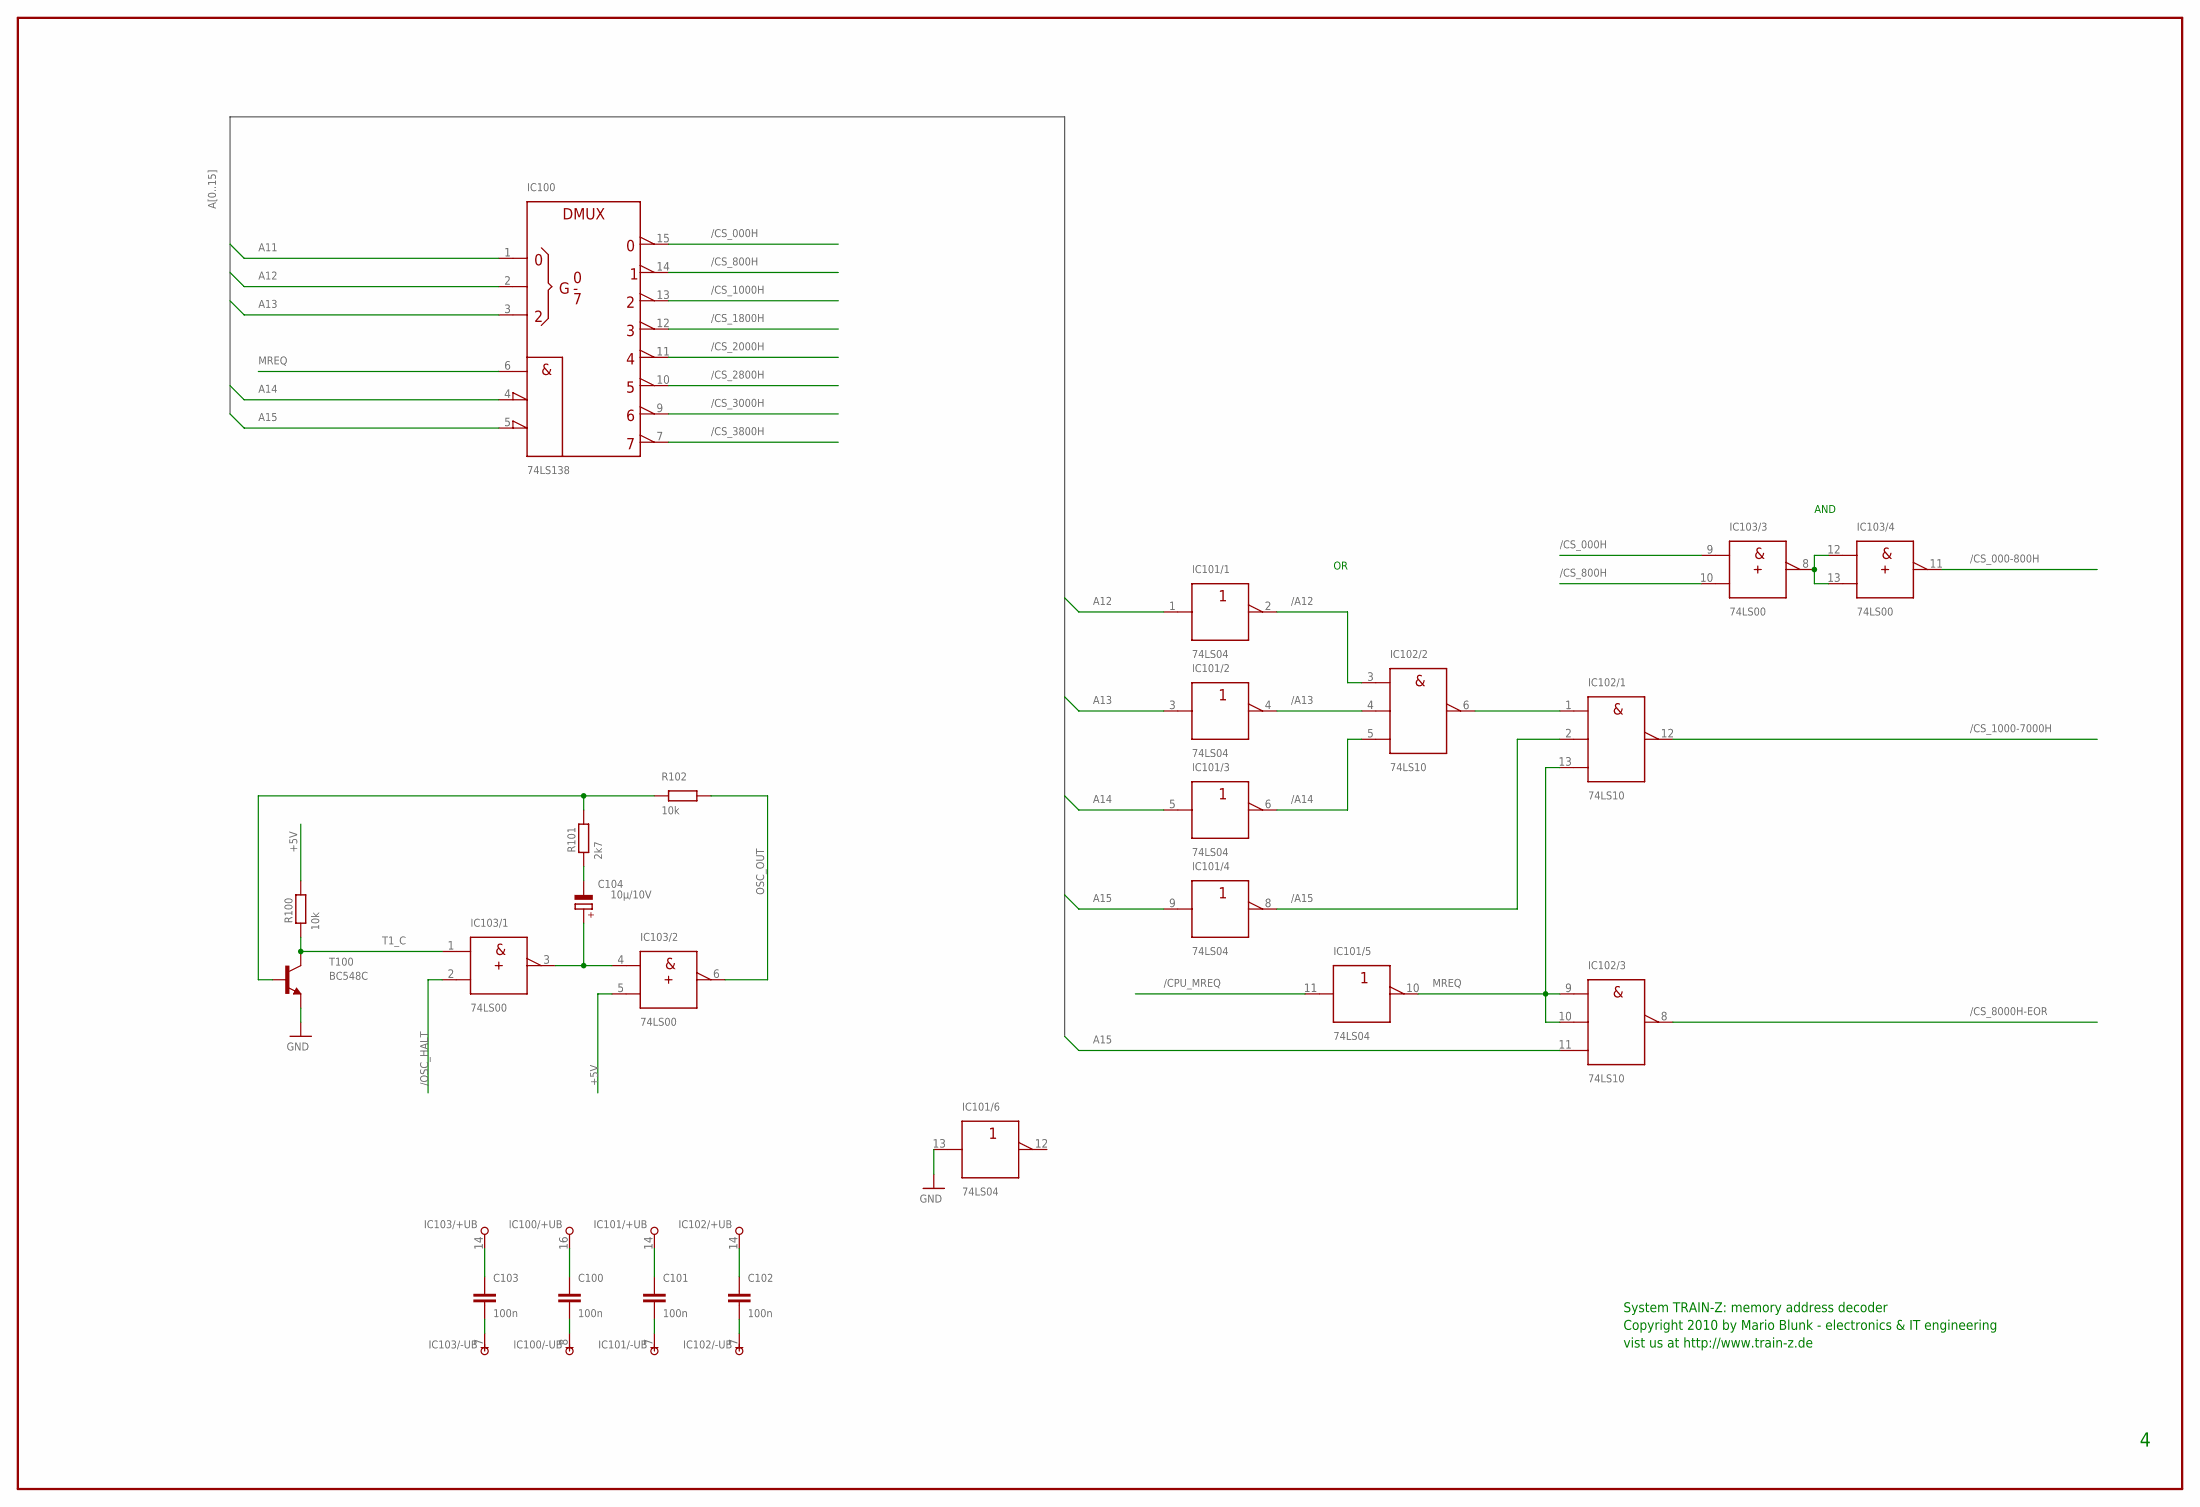
[picture p109: schematic MMU_V101r4.sch, sheet 1]

Parts:
C100, C101, C102, C103: 100n; C050-030X075
C104: 10µ/10V; E2,5-7
IC100: 74LS138; DIL16
IC101: 74LS04; DIL14
IC102: 74LS10; DIL14
IC103: 74LS00; DIL14
R100, R102: 10k; 0207/10
R101: 2k7; 0207/10
T100: BC548C; TO92

Connections:
+5V: C100.1, C101.1, C102.1, C103.1, IC100.16 (+UB), IC101.14 (+UB), IC102.14 (+UB), IC103.5 (B), IC103.14 (+UB), R100.2; also elsewhere on the board
/A12: IC101.2 (Y), IC102.3 (A)
/A13: IC101.4 (Y), IC102.4 (B)
/A14: IC101.6 (Y), IC102.5 (C)
/A15: IC101.8 (Y), IC102.2 (B)
/CPU_MREQ: IC101.11 (A); also elsewhere on the board
/CS_000-800H: IC103.11 (Y); also elsewhere on the board
/CS_000H: IC100.15 (Y0), IC103.9 (A)
/CS_800H: IC100.14 (Y1), IC103.10 (B)
/CS_1000-7000H: IC102.12 (Y); also elsewhere on the board
/CS_1000H: IC100.13 (Y2)
/CS_1800H: IC100.12 (Y3)
/CS_2000H: IC100.11 (Y4)
/CS_2800H: IC100.10 (Y5)
/CS_3000H: IC100.9 (Y6)
/CS_3800H: IC100.7 (Y7)
/CS_8000H-EOR: IC102.8 (Y); also elsewhere on the board
/OSC_HALT: IC103.2 (B); also elsewhere on the board
A11: IC100.1 (A); also elsewhere on the board
A12: IC100.2 (B), IC101.1 (A); also elsewhere on the board
A12ORA13ORA14: IC102.1 (A), IC102.6 (Y)
A13: IC100.3 (C), IC101.3 (A); also elsewhere on the board
A14: IC100.4 (!G2A), IC101.5 (A); also elsewhere on the board
A15: IC100.5 (!G2B), IC101.9 (A), IC102.11 (C); also elsewhere on the board
C14+: C104.+, IC103.3 (Y), IC103.4 (A)
C14-: C104.-, R101.1
CS_000-800H: IC103.8 (Y), IC103.12 (A), IC103.13 (B)
GND: C100.2, C101.2, C102.2, C103.2, IC100.8 (-UB), IC101.7 (-UB), IC101.13 (A), IC102.7 (-UB), IC103.7 (-UB), T100.1 (E); also elsewhere on the board
MREQ: IC100.6 (G1), IC101.10 (Y), IC102.9 (A), IC102.10 (B), IC102.13 (C)
OSC_OUT: IC103.6 (Y), R102.2; also elsewhere on the board
T1_B: R101.2, R102.1, T100.2 (B)
T1_C: IC103.1 (A), R100.1, T100.3 (C)

Notes on the sheet:
AND
System TRAIN-Z: memory address decoder
Copyright 2010 by Mario Blunk - electronics & IT engineering
vist us at http://www.train-z.de

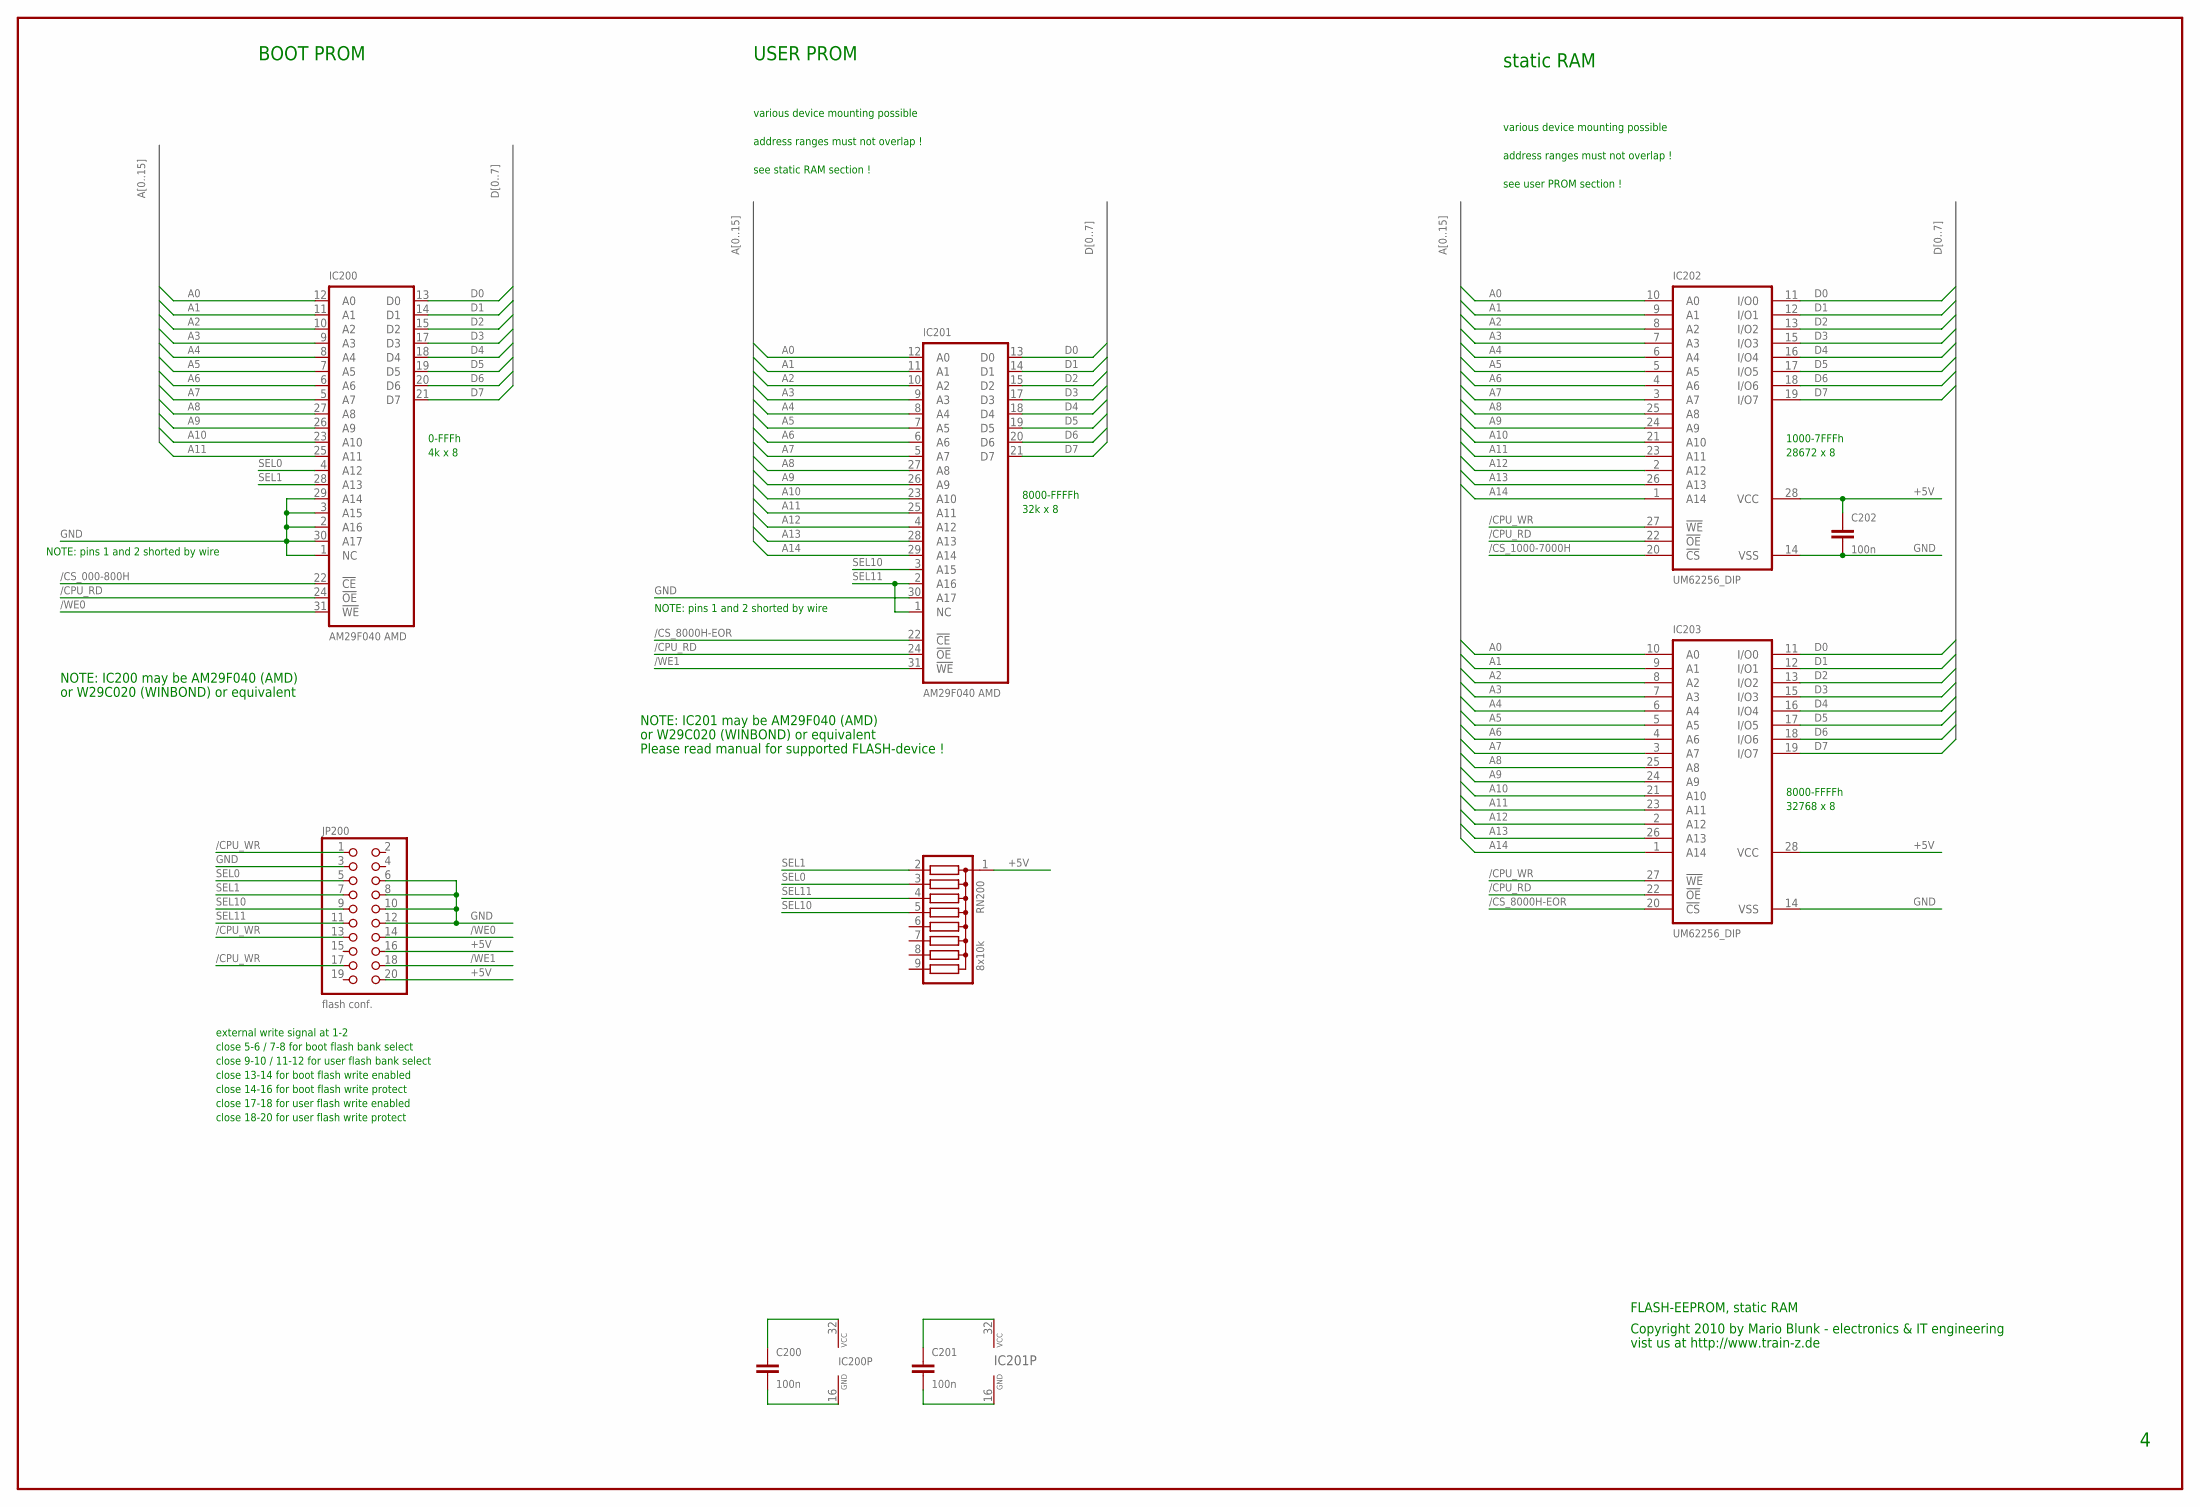
[picture p110: schematic MMU_V101r4.sch, sheet 2]

Parts:
C200, C201, C202: 100n; C050-030X075
IC200, IC201: AM29F040 AMD; DIL32
IC202, IC203: UM62256_DIP; DIL28-6
JP200: flash conf.; 2X10
RN200: 8x10k; SIL9

Connections:
+5V: C200.1, C201.1, C202.1, IC200.32 (VCC), IC201.32 (VCC), IC202.28 (VCC), IC203.28 (VCC), JP200.16, JP200.20, RN200.1; also elsewhere on the board
/CPU_RD: IC200.24 (!OE), IC201.24 (!OE), IC202.22 (!OE), IC203.22 (!OE); also elsewhere on the board
/CPU_WR: IC202.27 (!WE), IC203.27 (!WE), JP200.1, JP200.13, JP200.17; also elsewhere on the board
/CS_000-800H: IC200.22 (!CE); also elsewhere on the board
/CS_1000-7000H: IC202.20 (!CS); also elsewhere on the board
/CS_8000H-EOR: IC201.22 (!CE), IC203.20 (!CS); also elsewhere on the board
/WE0: IC200.31 (!WE), JP200.14
/WE1: IC201.31 (!WE), JP200.18
A0: IC200.12 (A0), IC201.12 (A0), IC202.10 (A0), IC203.10 (A0); also elsewhere on the board
A1: IC200.11 (A1), IC201.11 (A1), IC202.9 (A1), IC203.9 (A1); also elsewhere on the board
A2: IC200.10 (A2), IC201.10 (A2), IC202.8 (A2), IC203.8 (A2); also elsewhere on the board
A3: IC200.9 (A3), IC201.9 (A3), IC202.7 (A3), IC203.7 (A3); also elsewhere on the board
A4: IC200.8 (A4), IC201.8 (A4), IC202.6 (A4), IC203.6 (A4); also elsewhere on the board
A5: IC200.7 (A5), IC201.7 (A5), IC202.5 (A5), IC203.5 (A5); also elsewhere on the board
A6: IC200.6 (A6), IC201.6 (A6), IC202.4 (A6), IC203.4 (A6); also elsewhere on the board
A7: IC200.5 (A7), IC201.5 (A7), IC202.3 (A7), IC203.3 (A7); also elsewhere on the board
A8: IC200.27 (A8), IC201.27 (A8), IC202.25 (A8), IC203.25 (A8); also elsewhere on the board
A9: IC200.26 (A9), IC201.26 (A9), IC202.24 (A9), IC203.24 (A9); also elsewhere on the board
A10: IC200.23 (A10), IC201.23 (A10), IC202.21 (A10), IC203.21 (A10); also elsewhere on the board
A11: IC200.25 (A11), IC201.25 (A11), IC202.23 (A11), IC203.23 (A11); also elsewhere on the board
A12: IC201.4 (A12), IC202.2 (A12), IC203.2 (A12); also elsewhere on the board
A13: IC201.28 (A13), IC202.26 (A13), IC203.26 (A13); also elsewhere on the board
A14: IC201.29 (A14), IC202.1 (A14), IC203.1 (A14); also elsewhere on the board
D0: IC200.13 (D0), IC201.13 (D0), IC202.11 (I/O0), IC203.11 (I/O0); also elsewhere on the board
D1: IC200.14 (D1), IC201.14 (D1), IC202.12 (I/O1), IC203.12 (I/O1); also elsewhere on the board
D2: IC200.15 (D2), IC201.15 (D2), IC202.13 (I/O2), IC203.13 (I/O2); also elsewhere on the board
D3: IC200.17 (D3), IC201.17 (D3), IC202.15 (I/O3), IC203.15 (I/O3); also elsewhere on the board
D4: IC200.18 (D4), IC201.18 (D4), IC202.16 (I/O4), IC203.16 (I/O4); also elsewhere on the board
D5: IC200.19 (D5), IC201.19 (D5), IC202.17 (I/O5), IC203.17 (I/O5); also elsewhere on the board
D6: IC200.20 (D6), IC201.20 (D6), IC202.18 (I/O6), IC203.18 (I/O6); also elsewhere on the board
D7: IC200.21 (D7), IC201.21 (D7), IC202.19 (I/O7), IC203.19 (I/O7); also elsewhere on the board
GND: C200.2, C201.2, C202.2, IC200.1 (NC), IC200.2 (A16), IC200.3 (A15), IC200.16 (GND), IC200.29 (A14), IC200.30 (A17), IC201.16 (GND), IC201.30 (A17), IC202.14 (VSS), IC203.14 (VSS), JP200.3, JP200.6, JP200.8, JP200.10, JP200.12; also elsewhere on the board
SEL0: IC200.4 (A12), JP200.5, RN200.3
SEL1: IC200.28 (A13), JP200.7, RN200.2
SEL10: IC201.3 (A15), JP200.9, RN200.5
SEL11: IC201.1 (NC), IC201.2 (A16), JP200.11, RN200.4

Notes on the sheet:
0-FFFh
4k x 8
BOOT PROM
USER PROM
various device mounting possible
address ranges must not overlap !
see static RAM section !
FLASH-EEPROM, static RAM
close 9-10 / 11-12 for user flash bank select
8000-FFFFh
32k x 8
see user PROM section !
1000-7FFFh
28672 x 8
32768 x 8
close 5-6 / 7-8 for boot flash bank select
static RAM
external write signal at 1-2
close 13-14 for boot flash write enabled
close 14-16 for boot flash write protect
close 17-18 for user flash write enabled
close 18-20 for user flash write protect
NOTE: pins 1 and 2 shorted by wire
Please read manual for supported FLASH-device !
NOTE: IC200 may be AM29F040 (AMD)
or W29C020 (WINBOND) or equivalent
NOTE: IC201 may be AM29F040 (AMD)
Copyright 2010 by Mario Blunk - electronics & IT engineering
vist us at http://www.train-z.de

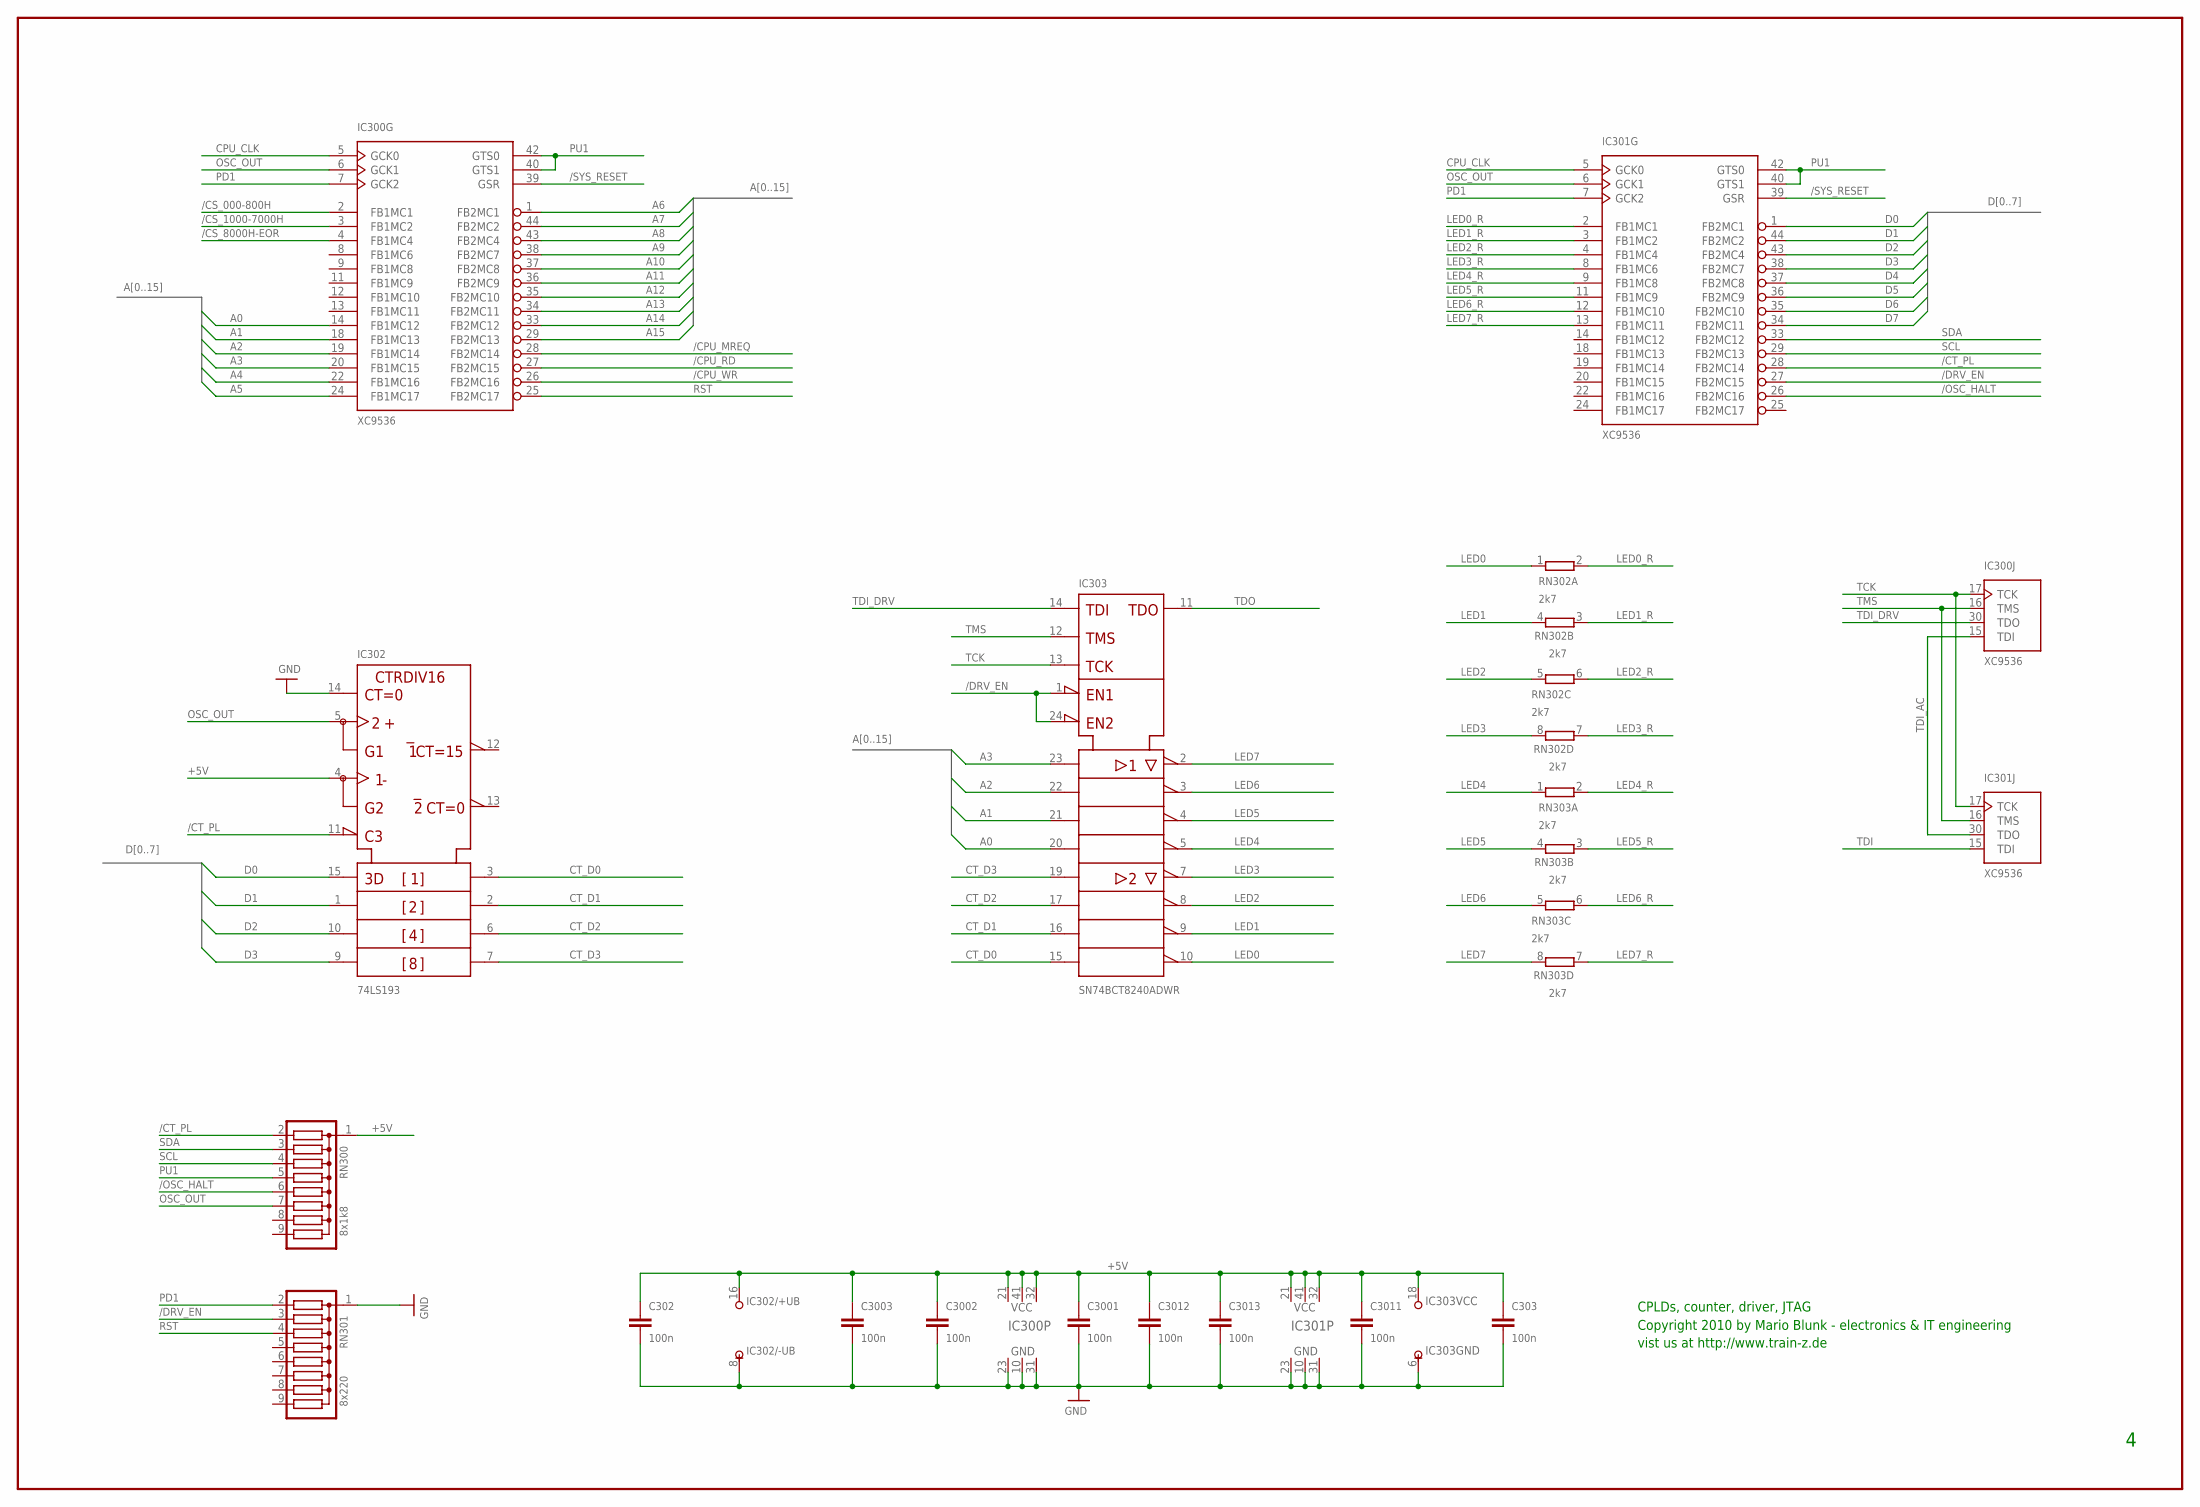
[picture p111: schematic MMU_V101r4.sch, sheet 3]

Parts:
C302: 100n; C050-025X075
C303, C3001, C3002, C3003, C3011, C3012, C3013: 100n; C050-030X075
IC300, IC301: XC9536; PLCC-S44
IC302: 74LS193; DIL16
IC303: SN74BCT8240ADWR; SOIC24
RN300: 8x1k8; SIL9
RN301: 8x220; SIL9
RN302, RN303: 2k7; SIL8

Connections:
+5V: C302.1, C303.1, C3001.1, C3002.1, C3003.1, C3011.1, C3012.1, C3013.1, IC300.21 (VCC), IC300.32 (VCC), IC300.41 (VCC), IC301.21 (VCC), IC301.32 (VCC), IC301.41 (VCC), IC302.4 (DOWN), IC302.16 (+UB), IC303.18 (+UB), RN300.1; also elsewhere on the board
/CPU_MREQ: IC300.28 (FB2MC14); also elsewhere on the board
/CPU_RD: IC300.27 (FB2MC15); also elsewhere on the board
/CPU_WR: IC300.26 (FB2MC16); also elsewhere on the board
/CS_000-800H: IC300.2 (FB1MC1); also elsewhere on the board
/CS_1000-7000H: IC300.3 (FB1MC2); also elsewhere on the board
/CS_8000H-EOR: IC300.4 (FB1MC4); also elsewhere on the board
/CT_PL: IC301.28 (FB2MC14), IC302.11 (!LOAD), RN300.2; also elsewhere on the board
/DRV_EN: IC301.27 (FB2MC15), IC303.1 (/EN1), IC303.24 (/EN2), RN301.3; also elsewhere on the board
/OSC_HALT: IC301.26 (FB2MC16), RN300.6; also elsewhere on the board
/SYS_RESET: IC300.39 (GSR), IC301.39 (GSR); also elsewhere on the board
A0: IC300.14 (FB1MC12), IC303.20 (A4); also elsewhere on the board
A1: IC300.18 (FB1MC13), IC303.21 (A3); also elsewhere on the board
A2: IC300.19 (FB1MC14), IC303.22 (A2); also elsewhere on the board
A3: IC300.20 (FB1MC15), IC303.23 (A1); also elsewhere on the board
A4: IC300.22 (FB1MC16); also elsewhere on the board
A5: IC300.24 (FB1MC17); also elsewhere on the board
A6: IC300.1 (FB2MC1); also elsewhere on the board
A7: IC300.44 (FB2MC2); also elsewhere on the board
A8: IC300.43 (FB2MC4); also elsewhere on the board
A9: IC300.38 (FB2MC7); also elsewhere on the board
A10: IC300.37 (FB2MC8); also elsewhere on the board
A11: IC300.36 (FB2MC9); also elsewhere on the board
A12: IC300.35 (FB2MC10); also elsewhere on the board
A13: IC300.34 (FB2MC11); also elsewhere on the board
A14: IC300.33 (FB2MC12); also elsewhere on the board
A15: IC300.29 (FB2MC13); also elsewhere on the board
CPU_CLK: IC300.5 (GCK0), IC301.5 (GCK0); also elsewhere on the board
CT_D0: IC302.3 (QA), IC303.15 (A8); also elsewhere on the board
CT_D1: IC302.2 (QB), IC303.16 (A7); also elsewhere on the board
CT_D2: IC302.6 (QC), IC303.17 (A6); also elsewhere on the board
CT_D3: IC302.7 (QD), IC303.19 (A5); also elsewhere on the board
D0: IC301.1 (FB2MC1), IC302.15 (A); also elsewhere on the board
D1: IC301.44 (FB2MC2), IC302.1 (B); also elsewhere on the board
D2: IC301.43 (FB2MC4), IC302.10 (C); also elsewhere on the board
D3: IC301.38 (FB2MC7), IC302.9 (D); also elsewhere on the board
D4: IC301.37 (FB2MC8); also elsewhere on the board
D5: IC301.36 (FB2MC9); also elsewhere on the board
D6: IC301.35 (FB2MC10); also elsewhere on the board
D7: IC301.34 (FB2MC11); also elsewhere on the board
GND: C302.2, C303.2, C3001.2, C3002.2, C3003.2, C3011.2, C3012.2, C3013.2, IC300.10 (GND), IC300.23 (GND), IC300.31 (GND), IC301.10 (GND), IC301.23 (GND), IC301.31 (GND), IC302.8 (-UB), IC302.14 (CLR), IC303.6 (-UB), RN301.1; also elsewhere on the board
LED0: IC303.10 (/Y8), RN302.1; also elsewhere on the board
LED0_R: IC301.2 (FB1MC1), RN302.2; also elsewhere on the board
LED1: IC303.9 (/Y7), RN302.4 (2); also elsewhere on the board
LED1_R: IC301.3 (FB1MC2), RN302.3 (1); also elsewhere on the board
LED2: IC303.8 (/Y6), RN302.5 (1); also elsewhere on the board
LED2_R: IC301.4 (FB1MC4), RN302.6 (2); also elsewhere on the board
LED3: IC303.7 (/Y5), RN302.8 (2); also elsewhere on the board
LED3_R: IC301.8 (FB1MC6), RN302.7 (1); also elsewhere on the board
LED4: IC303.5 (/Y4), RN303.1; also elsewhere on the board
LED4_R: IC301.9 (FB1MC8), RN303.2; also elsewhere on the board
LED5: IC303.4 (/Y3), RN303.4 (2); also elsewhere on the board
LED5_R: IC301.11 (FB1MC9), RN303.3 (1); also elsewhere on the board
LED6: IC303.3 (/Y2), RN303.5 (1); also elsewhere on the board
LED6_R: IC301.12 (FB1MC10), RN303.6 (2); also elsewhere on the board
LED7: IC303.2 (/Y1), RN303.8 (2); also elsewhere on the board
LED7_R: IC301.13 (FB1MC11), RN303.7 (1); also elsewhere on the board
OSC_OUT: IC300.6 (GCK1), IC301.6 (GCK1), IC302.5 (UP), RN300.7; also elsewhere on the board
PD1: IC300.7 (GCK2), IC301.7 (GCK2), RN301.2; also elsewhere on the board
PU1: IC300.40 (GTS1), IC300.42 (GTS0), IC301.40 (GTS1), IC301.42 (GTS0), RN300.5; also elsewhere on the board
RST: IC300.25 (FB2MC17), RN301.4; also elsewhere on the board
SCL: IC301.29 (FB2MC13), RN300.4; also elsewhere on the board
SDA: IC301.33 (FB2MC12), RN300.3; also elsewhere on the board
TCK: IC300.17 (TCK), IC301.17 (TCK), IC303.13 (TCK); also elsewhere on the board
TDI: IC301.15 (TDI); also elsewhere on the board
TDI_AC: IC300.15 (TDI), IC301.30 (TDO); also elsewhere on the board
TDI_DRV: IC300.30 (TDO), IC303.14 (TDI); also elsewhere on the board
TDO: IC303.11 (TDO); also elsewhere on the board
TMS: IC300.16 (TMS), IC301.16 (TMS), IC303.12 (TMS); also elsewhere on the board

Notes on the sheet:
CPLDs, counter, driver, JTAG
Copyright 2010 by Mario Blunk - electronics & IT engineering
vist us at http://www.train-z.de
