Blunk-electronic/TRAIN-Z/hardware/computer/eagle/mmu/v101r4/MMU_V101r4.brd

## EAGLE design hardware/computer/eagle/mmu/v101r4/MMU_V101r4.brd (continued)

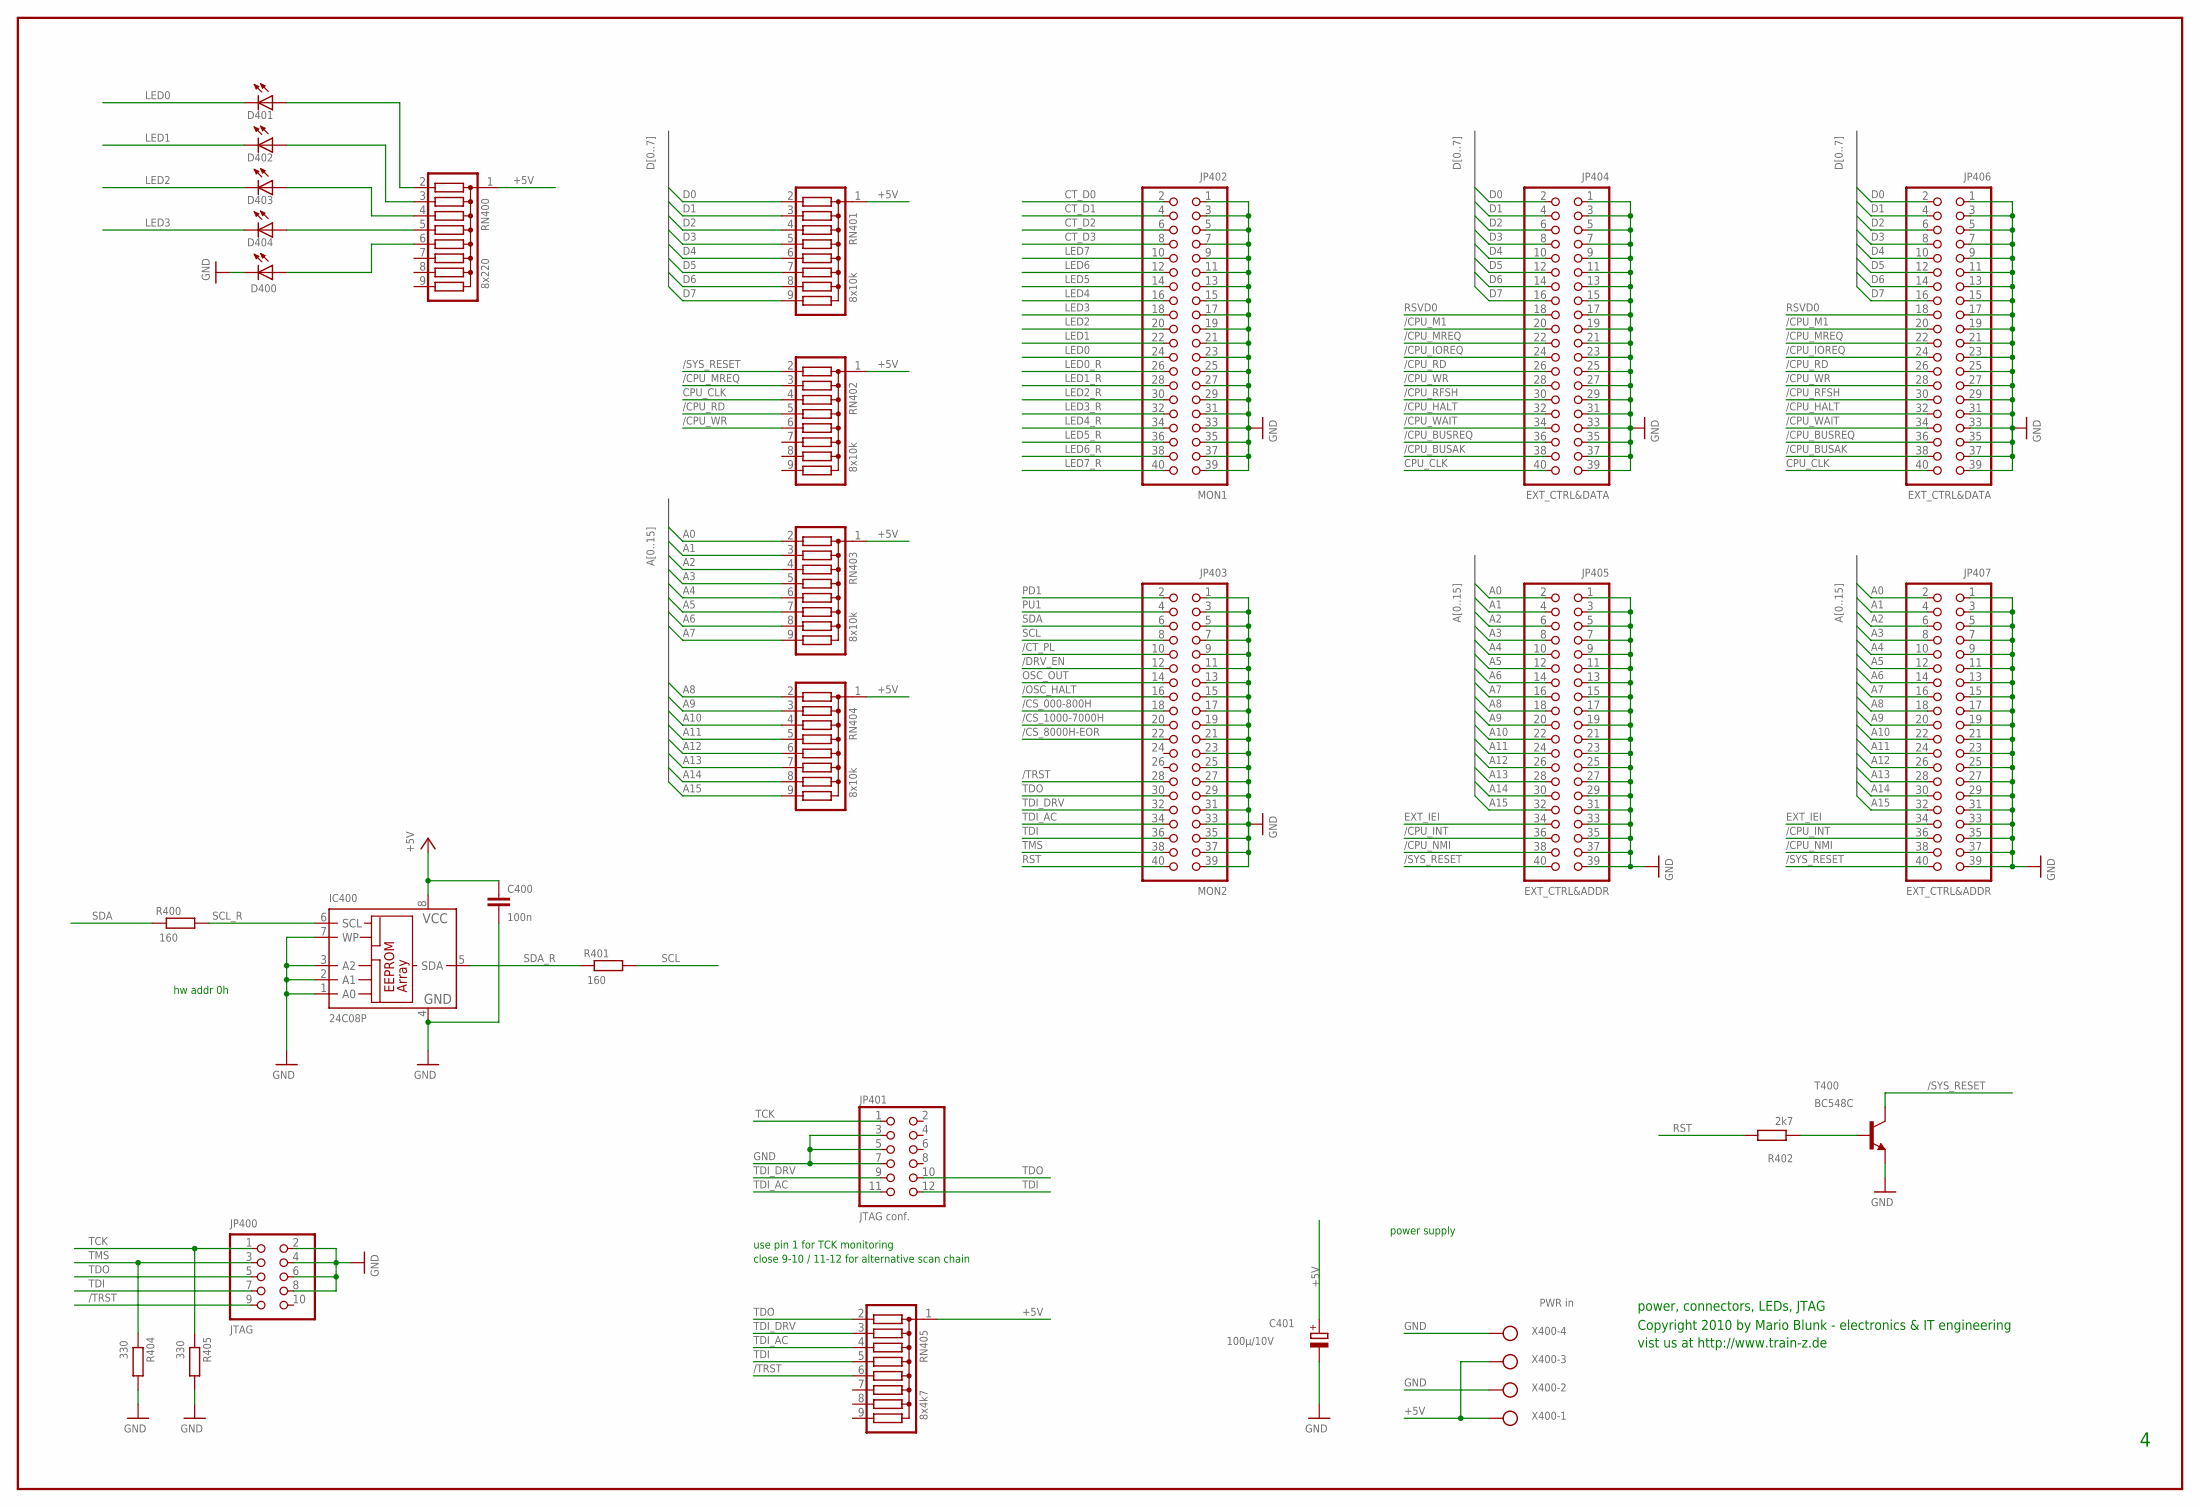
[picture p112: schematic MMU_V101r4.sch, sheet 4]

Parts:
C400: 100n; C050-030X075
C401: 100µ/10V; E2,5-7
D400, D401, D402, D403, D404: LED5MM
IC400: 24C08P; DIL8
JP400: JTAG; 2X05
JP401: JTAG conf.; 2X06
JP402: MON1; 2X20
JP403: MON2; 2X20
JP404, JP406: EXT_CTRL&DATA; 2X20
JP405, JP407: EXT_CTRL&ADDR; 2X20
R400, R401: 160; 0207/10
R402: 2k7; 0207/10
R404, R405: 330; 0207/10
RN400: 8x220; SIL9
RN401, RN402, RN403, RN404: 8x10k; SIL9
RN405: 8x4k7; SIL9
T400: BC548C; TO92
X400: PWR in; W237-4

Connections:
+5V: C400.1, C401.+, IC400.8 (VCC), RN400.1, RN401.1, RN402.1, RN403.1, RN404.1, RN405.1, X400.1, X400.3; also elsewhere on the board
/CPU_BUSAK: JP404.38, JP406.38
/CPU_BUSREQ: JP404.36, JP406.36
/CPU_HALT: JP404.32, JP406.32
/CPU_INT: JP405.36, JP407.36
/CPU_IOREQ: JP404.24, JP406.24
/CPU_M1: JP404.20, JP406.20
/CPU_MREQ: JP404.22, JP406.22, RN402.3; also elsewhere on the board
/CPU_NMI: JP405.38, JP407.38
/CPU_RD: JP404.26, JP406.26, RN402.5; also elsewhere on the board
/CPU_RFSH: JP404.30, JP406.30
/CPU_WAIT: JP404.34, JP406.34
/CPU_WR: JP404.28, JP406.28, RN402.6; also elsewhere on the board
/CS_000-800H: JP403.18; also elsewhere on the board
/CS_1000-7000H: JP403.20; also elsewhere on the board
/CS_8000H-EOR: JP403.22; also elsewhere on the board
/CT_PL: JP403.10; also elsewhere on the board
/DRV_EN: JP403.12; also elsewhere on the board
/OSC_HALT: JP403.16; also elsewhere on the board
/SYS_RESET: JP405.40, JP407.40, RN402.2, T400.3 (C); also elsewhere on the board
/TRST: JP400.9, JP403.28, RN405.6
A0: JP405.2, JP407.2, RN403.2; also elsewhere on the board
A1: JP405.4, JP407.4, RN403.3; also elsewhere on the board
A2: JP405.6, JP407.6, RN403.4; also elsewhere on the board
A3: JP405.8, JP407.8, RN403.5; also elsewhere on the board
A4: JP405.10, JP407.10, RN403.6; also elsewhere on the board
A5: JP405.12, JP407.12, RN403.7; also elsewhere on the board
A6: JP405.14, JP407.14, RN403.8; also elsewhere on the board
A7: JP405.16, JP407.16, RN403.9; also elsewhere on the board
A8: JP405.18, JP407.18, RN404.2; also elsewhere on the board
A9: JP405.20, JP407.20, RN404.3; also elsewhere on the board
A10: JP405.22, JP407.22, RN404.4; also elsewhere on the board
A11: JP405.24, JP407.24, RN404.5; also elsewhere on the board
A12: JP405.26, JP407.26, RN404.6; also elsewhere on the board
A13: JP405.28, JP407.28, RN404.7; also elsewhere on the board
A14: JP405.30, JP407.30, RN404.8; also elsewhere on the board
A15: JP405.32, JP407.32, RN404.9; also elsewhere on the board
CPU_CLK: JP404.40, JP406.40, RN402.4; also elsewhere on the board
CT_D0: JP402.2; also elsewhere on the board
CT_D1: JP402.4; also elsewhere on the board
CT_D2: JP402.6; also elsewhere on the board
CT_D3: JP402.8; also elsewhere on the board
D0: JP404.2, JP406.2, RN401.2; also elsewhere on the board
D1: JP404.4, JP406.4, RN401.3; also elsewhere on the board
D2: JP404.6, JP406.6, RN401.4; also elsewhere on the board
D3: JP404.8, JP406.8, RN401.5; also elsewhere on the board
D4: JP404.10, JP406.10, RN401.6; also elsewhere on the board
D4_A: D400.A, RN400.6
D5: JP404.12, JP406.12, RN401.7; also elsewhere on the board
D6: JP404.14, JP406.14, RN401.8; also elsewhere on the board
D7: JP404.16, JP406.16, RN401.9; also elsewhere on the board
EXT_IEI: JP405.34, JP407.34
GND: C400.2, C401.-, D400.K (C), IC400.1 (A0), IC400.2 (A1), IC400.3 (A2), IC400.4 (GND), IC400.7 (WP), JP400.2, JP400.4, JP400.6, JP400.8, JP401.3, JP401.5, JP401.7, JP402.1, JP402.3, JP402.5, JP402.7, JP402.9, JP402.11, JP402.13, JP402.15, JP402.17, JP402.19, JP402.21, JP402.23, JP402.25, JP402.27, JP402.29, JP402.31, JP402.33, JP402.35, JP402.37, JP402.39, JP403.1, JP403.3, JP403.5, JP403.7, JP403.9, JP403.11, JP403.13, JP403.15, JP403.17, JP403.19, JP403.21, JP403.23, JP403.25, JP403.27, JP403.29, JP403.31, JP403.33, JP403.35, JP403.37, JP403.39, JP404.1, JP404.3, JP404.5, JP404.7, JP404.9, JP404.11, JP404.13, JP404.15, JP404.17, JP404.19, JP404.21, JP404.23, JP404.25, JP404.27, JP404.29, JP404.31, JP404.33, JP404.35, JP404.37, JP404.39, JP405.1, JP405.3, JP405.5, JP405.7, JP405.9, JP405.11, JP405.13, JP405.15, JP405.17, JP405.19, JP405.21, JP405.23, JP405.25, JP405.27, JP405.29, JP405.31, JP405.33, JP405.35, JP405.37, JP405.39, JP406.1, JP406.3, JP406.5, JP406.7, JP406.9, JP406.11, JP406.13, JP406.15, JP406.17, JP406.19, JP406.21, JP406.23, JP406.25, JP406.27, JP406.29, JP406.31, JP406.33, JP406.35, JP406.37, JP406.39, JP407.1, JP407.3, JP407.5, JP407.7, JP407.9, JP407.11, JP407.13, JP407.15, JP407.17, JP407.19, JP407.21, JP407.23, JP407.25, JP407.27, JP407.29, JP407.31, JP407.33, JP407.35, JP407.37, JP407.39, R404.2, R405.2, T400.1 (E), X400.2, X400.4; also elsewhere on the board
LED0: D401.K (C), JP402.24; also elsewhere on the board
LED0_K: D401.A, RN400.2
LED0_R: JP402.26; also elsewhere on the board
LED1: D402.K (C), JP402.22; also elsewhere on the board
LED1_K: D402.A, RN400.3
LED1_R: JP402.28; also elsewhere on the board
LED2: D403.K (C), JP402.20; also elsewhere on the board
LED2_K: D403.A, RN400.4
LED2_R: JP402.30; also elsewhere on the board
LED3: D404.K (C), JP402.18; also elsewhere on the board
LED3_K: D404.A, RN400.5
LED3_R: JP402.32; also elsewhere on the board
LED4: JP402.16; also elsewhere on the board
LED4_R: JP402.34; also elsewhere on the board
LED5: JP402.14; also elsewhere on the board
LED5_R: JP402.36; also elsewhere on the board
LED6: JP402.12; also elsewhere on the board
LED6_R: JP402.38; also elsewhere on the board
LED7: JP402.10; also elsewhere on the board
LED7_R: JP402.40; also elsewhere on the board
OSC_OUT: JP403.14; also elsewhere on the board
PD1: JP403.2; also elsewhere on the board
PU1: JP403.4; also elsewhere on the board
RST: JP403.40, R402.2; also elsewhere on the board
RSVD0: JP404.18, JP406.18
SCL: JP403.8, R401.2; also elsewhere on the board
SCL_R: IC400.6 (SCL), R400.2
SDA: JP403.6, R400.1; also elsewhere on the board
SDA_R: IC400.5 (SDA), R401.1
T2_B: R402.1, T400.2 (B)
TCK: JP400.1, JP401.1, R405.1; also elsewhere on the board
TDI: JP400.7, JP401.12, JP403.36, RN405.5; also elsewhere on the board
TDI_AC: JP401.11, JP403.34, RN405.4; also elsewhere on the board
TDI_DRV: JP401.9, JP403.32, RN405.3; also elsewhere on the board
TDO: JP400.5, JP401.10, JP403.30, RN405.2; also elsewhere on the board
TMS: JP400.3, JP403.38, R404.1; also elsewhere on the board

Notes on the sheet:
power, connectors, LEDs, JTAG
power supply
hw addr 0h
close 9-10 / 11-12 for alternative scan chain
use pin 1 for TCK monitoring
Copyright 2010 by Mario Blunk - electronics & IT engineering
vist us at http://www.train-z.de

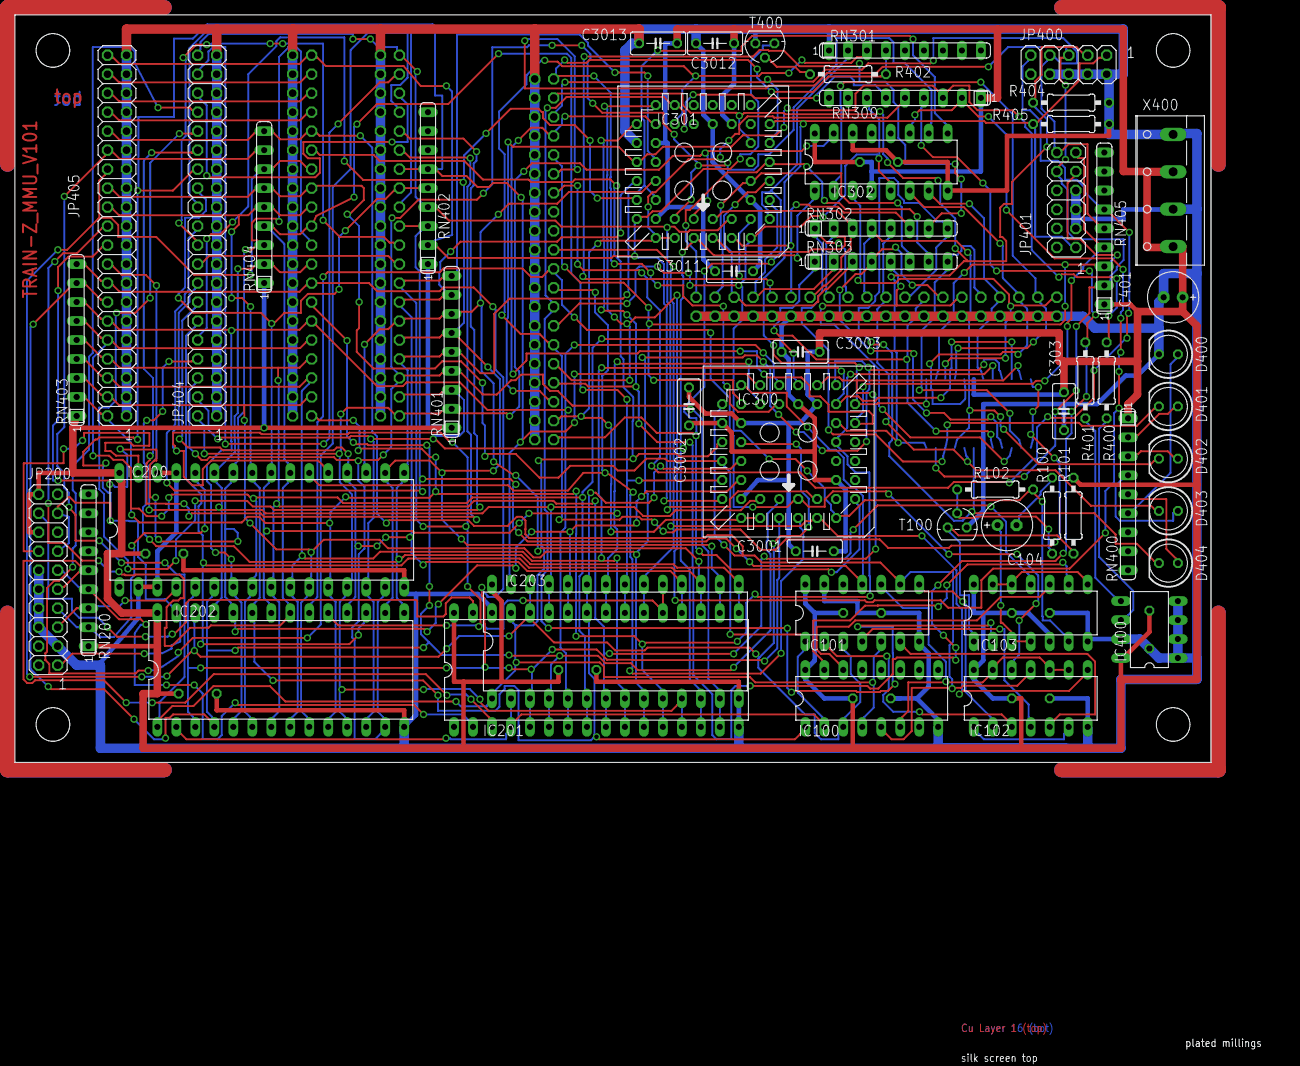
[picture p113: board MMU_V101r4.brd from above]

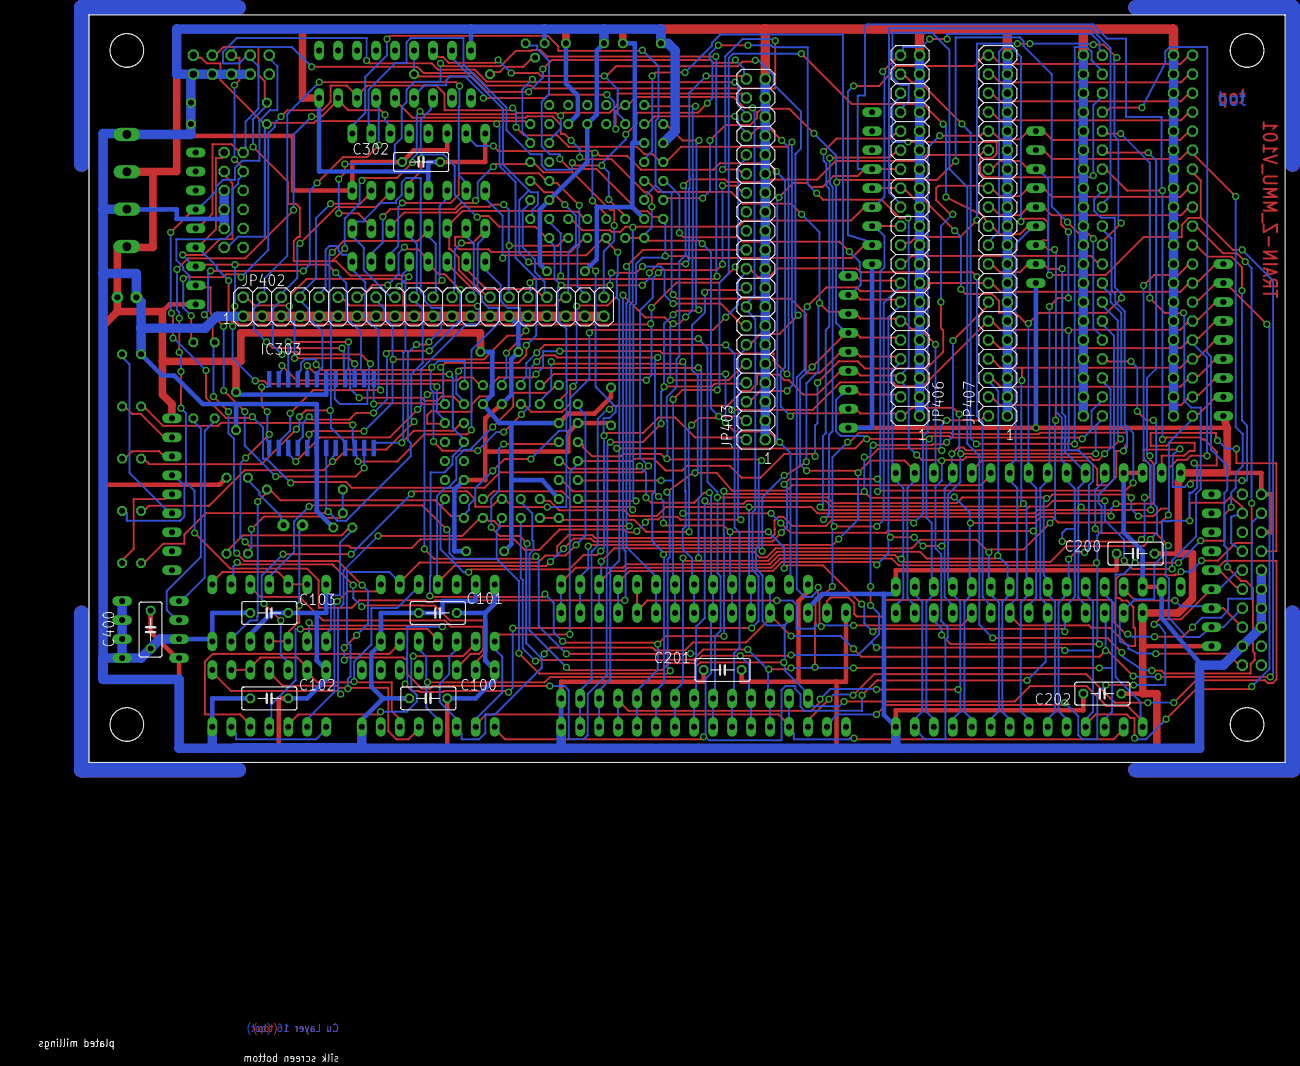
[picture p114: board MMU_V101r4.brd from below]

Board: 2 copper layers, 160.0 x 100.0 mm, 68 parts (14 on the bottom side), 108 nets.

Other parts of the board:
U$1: A4_LANDSCAPE
