Blunk-electronic/TRAIN-Z/hardware/bus_monitor/eagle/Z80_BMO_V1.2.brd

## EAGLE design hardware/bus_monitor/eagle/Z80_BMO_V1.2.brd (2015-09-27)

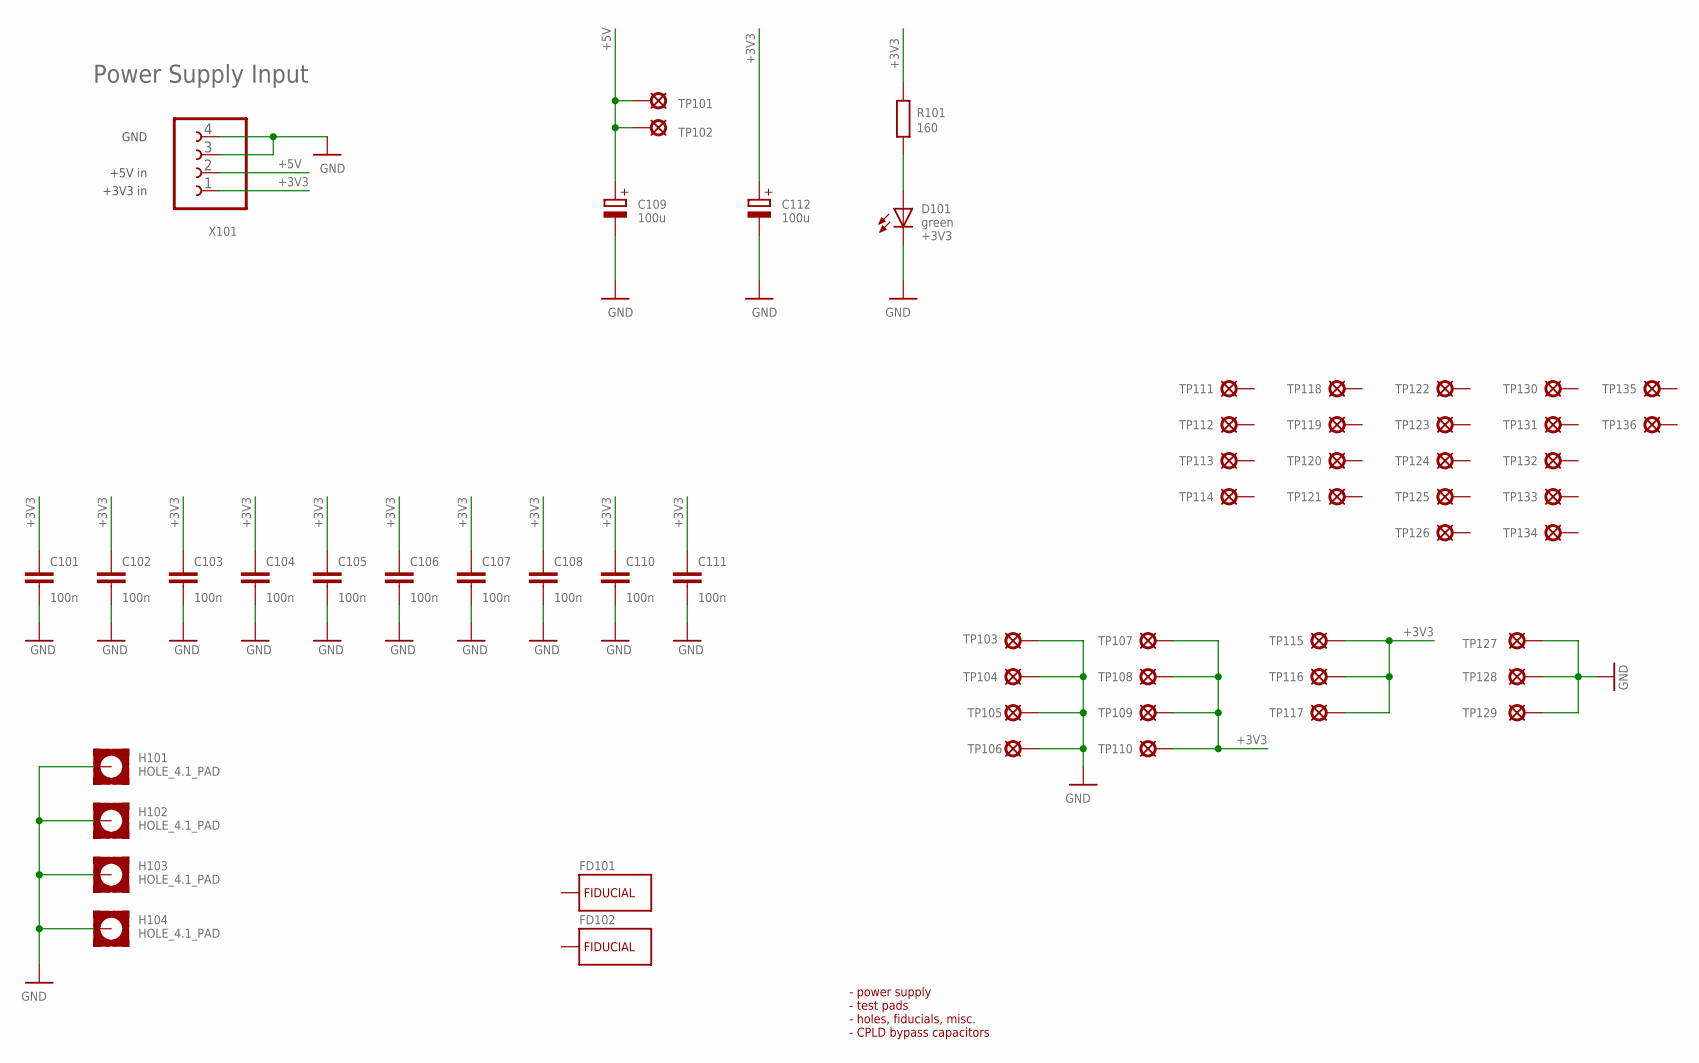
[picture p115: schematic Z80_BMO_V1.2.sch, sheet 1]

Parts:
C101, C102, C103, C104, C105, C106, C107, C108, C110, C111: 100n; S_0805; PART_CODE_BEL C_PAC_S_0805_VAL_100n
C109, C112: 100u; T_RADIAL_7MM_GRID_2.54MM; PART_CODE_BEL C_PAC_T_RADIAL_7mm_GRID_2.54mm_VAL_100u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
D101: green; T_LED_3MM; PART_CODE_BEL LED_PAC_T_3mm_VAL_green
FD101, FD102: FIDUCIAL_CROSSHAIR; CROSSHAIR
H101, H102, H103, H104: HOLE_4.1_PAD; 4.1_PAD
R101: 160; T_0207_GRID10MM; PART_CODE_BEL R_PAC_T_0207_GRID10mm_VAL_160
TP101, TP102, TP103, TP104, TP105, TP106, TP107, TP108, TP109, TP110, TP111, TP112, TP113, TP114, TP115, TP116, TP117, TP118, TP119, TP120, TP121, TP122, TP123, TP124, TP125, TP126, TP127, TP128, TP129, TP130, TP131, TP132, TP133, TP134, TP135, TP136: TEST_POINT_T_SMALL; T_TEST_POINT_SMALL
X101: CLAMP_1X4-T-5MM; T_WIRE_CLAMP_1X4_5MM

Connections:
3V3_LED_A: D101.A, R101.1
+3V3: C101.1, C102.1, C103.1, C104.1, C105.1, C106.1, C107.1, C108.1, C110.1, C111.1, C112.+, R101.2, TP107.1, TP108.1, TP109.1, TP110.1, TP115.1, TP116.1, TP117.1, X101.1; also elsewhere on the board
+5V: C109.+, TP101.1, TP102.1, X101.2
GND: C101.2, C102.2, C103.2, C104.2, C105.2, C106.2, C107.2, C108.2, C109.-, C110.2, C111.2, C112.-, D101.C, H101.H1, H102.H1, H103.H1, H104.H1, TP103.1, TP104.1, TP105.1, TP106.1, TP127.1, TP128.1, TP129.1, X101.3, X101.4; also elsewhere on the board

Notes on the sheet:
+3V3 in
+5V in
GND
- power supply - test pads - holes, fiducials, misc. - CPLD bypass capacitors

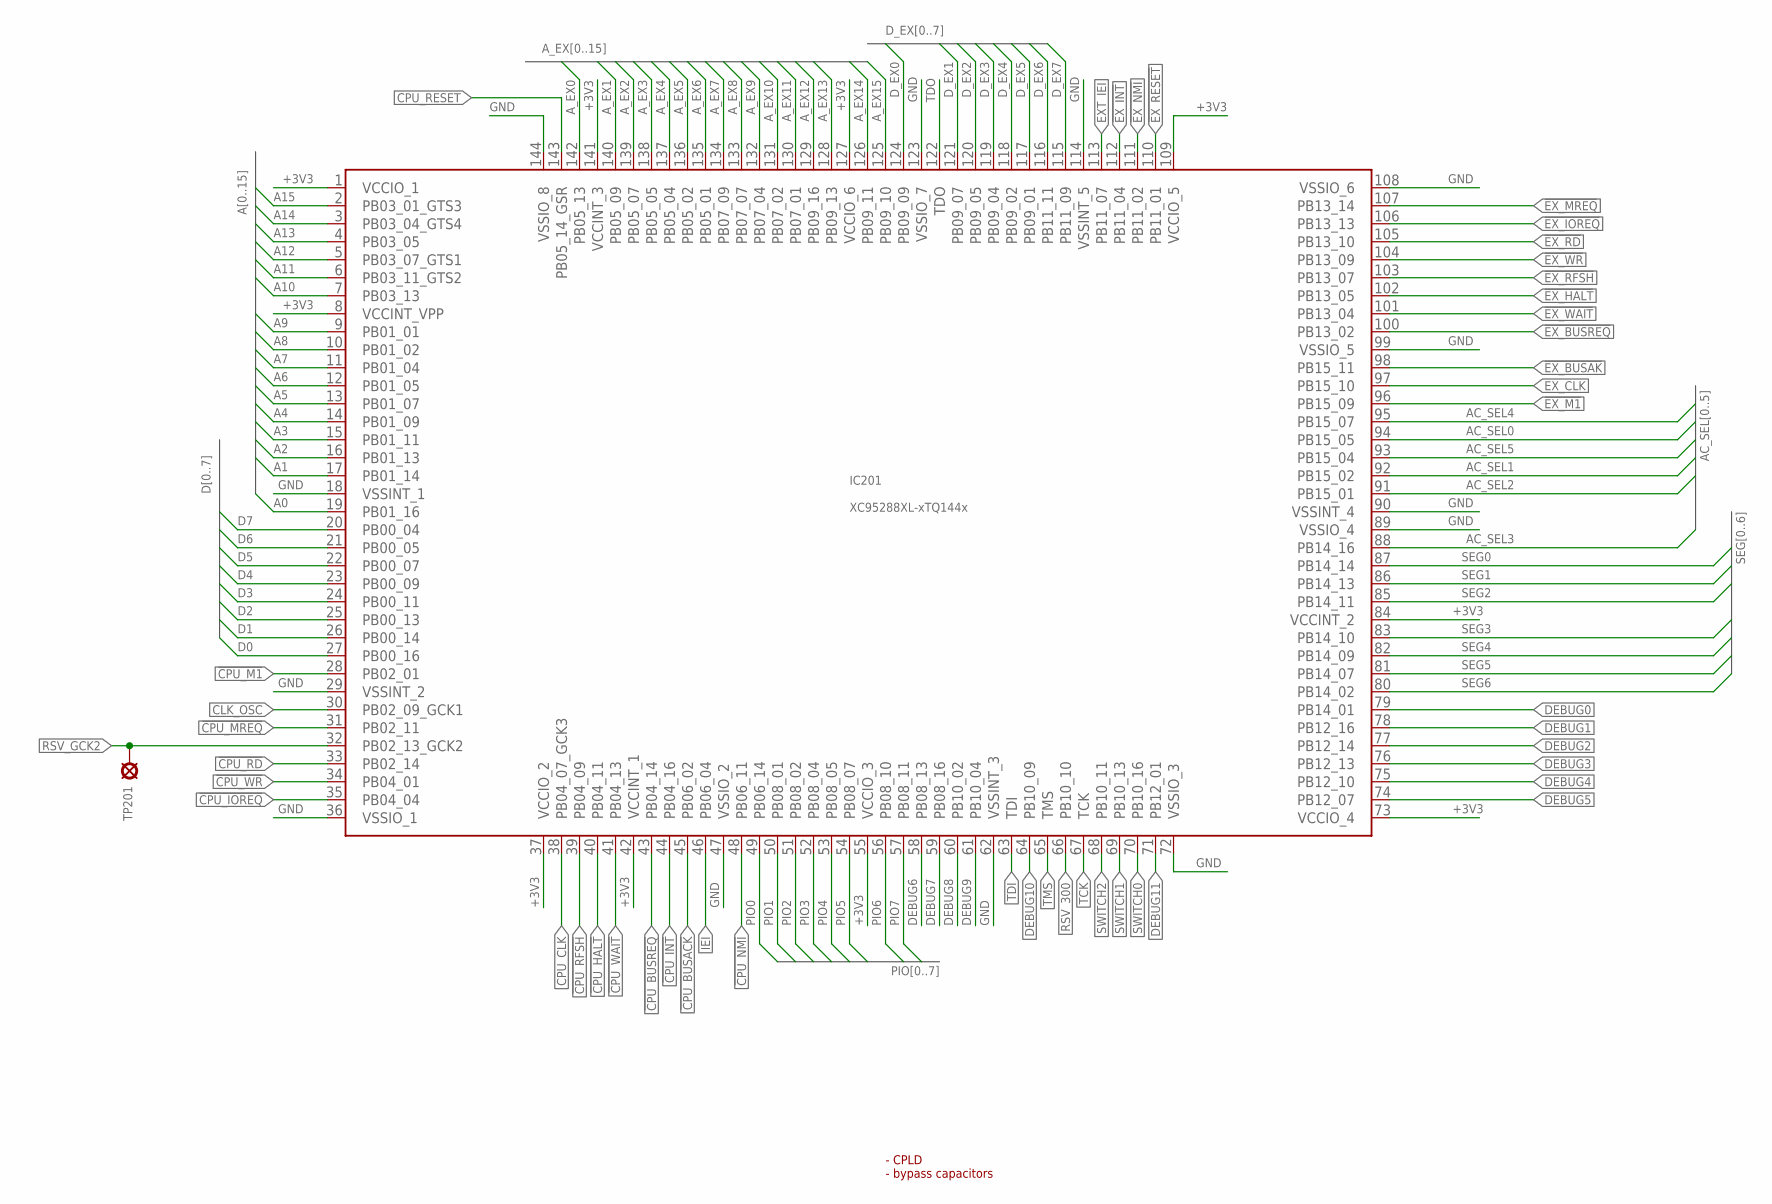
[picture p116: schematic Z80_BMO_V1.2.sch, sheet 2]

Parts:
IC201: XC95288XL-xTQ144x; S_TQFP144
TP201: TEST_POINT_T_SMALL; T_TEST_POINT_SMALL

Connections:
!CPU_BUSACK: IC201.45 (PB06_02); also elsewhere on the board
!CPU_BUSREQ: IC201.43 (PB04_14); also elsewhere on the board
!CPU_HALT: IC201.40 (PB04_11); also elsewhere on the board
!CPU_INT: IC201.44 (PB04_16); also elsewhere on the board
!CPU_IOREQ: IC201.35 (PB04_04); also elsewhere on the board
!CPU_M1: IC201.28 (PB02_01); also elsewhere on the board
!CPU_MREQ: IC201.31 (PB02_11); also elsewhere on the board
!CPU_NMI: IC201.48 (PB06_11); also elsewhere on the board
!CPU_RD: IC201.33 (PB02_14); also elsewhere on the board
!CPU_RFSH: IC201.39 (PB04_09); also elsewhere on the board
!CPU_WAIT: IC201.41 (PB04_13); also elsewhere on the board
!CPU_WR: IC201.34 (PB04_01); also elsewhere on the board
!EX_BUSAK: IC201.98 (PB15_11); also elsewhere on the board
!EX_BUSREQ: IC201.100 (PB13_02); also elsewhere on the board
!EX_HALT: IC201.102 (PB13_05); also elsewhere on the board
!EX_INT: IC201.112 (PB11_04); also elsewhere on the board
!EX_IOREQ: IC201.106 (PB13_13); also elsewhere on the board
!EX_M1: IC201.96 (PB15_09); also elsewhere on the board
!EX_MREQ: IC201.107 (PB13_14); also elsewhere on the board
!EX_NMI: IC201.111 (PB11_02); also elsewhere on the board
!EX_RD: IC201.105 (PB13_10); also elsewhere on the board
!EX_RESET: IC201.110 (PB11_01); also elsewhere on the board
!EX_RFSH: IC201.103 (PB13_07); also elsewhere on the board
!EX_WAIT: IC201.101 (PB13_04); also elsewhere on the board
!EX_WR: IC201.104 (PB13_09); also elsewhere on the board
+3V3: IC201.1 (VCCIO_1), IC201.8 (VCCINT_VPP), IC201.37 (VCCIO_2), IC201.42 (VCCINT_1), IC201.55 (VCCIO_3), IC201.73 (VCCIO_4), IC201.84 (VCCINT_2), IC201.109 (VCCIO_5), IC201.127 (VCCIO_6), IC201.141 (VCCINT_3); also elsewhere on the board
A0: IC201.19 (PB01_16); also elsewhere on the board
A1: IC201.17 (PB01_14); also elsewhere on the board
A2: IC201.16 (PB01_13); also elsewhere on the board
A3: IC201.15 (PB01_11); also elsewhere on the board
A4: IC201.14 (PB01_09); also elsewhere on the board
A5: IC201.13 (PB01_07); also elsewhere on the board
A6: IC201.12 (PB01_05); also elsewhere on the board
A7: IC201.11 (PB01_04); also elsewhere on the board
A8: IC201.10 (PB01_02); also elsewhere on the board
A9: IC201.9 (PB01_01); also elsewhere on the board
A10: IC201.7 (PB03_13); also elsewhere on the board
A11: IC201.6 (PB03_11_GTS2); also elsewhere on the board
A12: IC201.5 (PB03_07_GTS1); also elsewhere on the board
A13: IC201.4 (PB03_05); also elsewhere on the board
A14: IC201.3 (PB03_04_GTS4); also elsewhere on the board
A15: IC201.2 (PB03_01_GTS3); also elsewhere on the board
AC_SEL0: IC201.94 (PB15_05); also elsewhere on the board
AC_SEL1: IC201.92 (PB15_02); also elsewhere on the board
AC_SEL2: IC201.91 (PB15_01); also elsewhere on the board
AC_SEL3: IC201.88 (PB14_16); also elsewhere on the board
AC_SEL4: IC201.95 (PB15_07); also elsewhere on the board
AC_SEL5: IC201.93 (PB15_04); also elsewhere on the board
A_EX0: IC201.142 (PB05_13); also elsewhere on the board
A_EX1: IC201.140 (PB05_09); also elsewhere on the board
A_EX2: IC201.139 (PB05_07); also elsewhere on the board
A_EX3: IC201.138 (PB05_05); also elsewhere on the board
A_EX4: IC201.137 (PB05_04); also elsewhere on the board
A_EX5: IC201.136 (PB05_02); also elsewhere on the board
A_EX6: IC201.135 (PB05_01); also elsewhere on the board
A_EX7: IC201.134 (PB07_09); also elsewhere on the board
A_EX8: IC201.133 (PB07_07); also elsewhere on the board
A_EX9: IC201.132 (PB07_04); also elsewhere on the board
A_EX10: IC201.131 (PB07_02); also elsewhere on the board
A_EX11: IC201.130 (PB07_01); also elsewhere on the board
A_EX12: IC201.129 (PB09_16); also elsewhere on the board
A_EX13: IC201.128 (PB09_13); also elsewhere on the board
A_EX14: IC201.126 (PB09_11); also elsewhere on the board
A_EX15: IC201.125 (PB09_10); also elsewhere on the board
CLK_OSC: IC201.30 (PB02_09_GCK1); also elsewhere on the board
CPU_CLK: IC201.38 (PB04_07_GCK3); also elsewhere on the board
CPU_RESET: IC201.143 (PB05_14_GSR); also elsewhere on the board
D0: IC201.27 (PB00_16); also elsewhere on the board
D1: IC201.26 (PB00_14); also elsewhere on the board
D2: IC201.25 (PB00_13); also elsewhere on the board
D3: IC201.24 (PB00_11); also elsewhere on the board
D4: IC201.23 (PB00_09); also elsewhere on the board
D5: IC201.22 (PB00_07); also elsewhere on the board
D6: IC201.21 (PB00_05); also elsewhere on the board
D7: IC201.20 (PB00_04); also elsewhere on the board
DEBUG0: IC201.79 (PB14_01); also elsewhere on the board
DEBUG1: IC201.78 (PB12_16); also elsewhere on the board
DEBUG2: IC201.77 (PB12_14); also elsewhere on the board
DEBUG3: IC201.76 (PB12_13); also elsewhere on the board
DEBUG4: IC201.75 (PB12_10); also elsewhere on the board
DEBUG5: IC201.74 (PB12_07); also elsewhere on the board
DEBUG6: IC201.58 (PB08_13); also elsewhere on the board
DEBUG7: IC201.59 (PB08_16); also elsewhere on the board
DEBUG8: IC201.60 (PB10_02); also elsewhere on the board
DEBUG9: IC201.61 (PB10_04); also elsewhere on the board
DEBUG10: IC201.64 (PB10_09); also elsewhere on the board
DEBUG11: IC201.71 (PB12_01); also elsewhere on the board
D_EX0: IC201.124 (PB09_09); also elsewhere on the board
D_EX1: IC201.121 (PB09_07); also elsewhere on the board
D_EX2: IC201.120 (PB09_05); also elsewhere on the board
D_EX3: IC201.119 (PB09_04); also elsewhere on the board
D_EX4: IC201.118 (PB09_02); also elsewhere on the board
D_EX5: IC201.117 (PB09_01); also elsewhere on the board
D_EX6: IC201.116 (PB11_11); also elsewhere on the board
D_EX7: IC201.115 (PB11_09); also elsewhere on the board
EXT_IEI: IC201.113 (PB11_07); also elsewhere on the board
EX_CLK: IC201.97 (PB15_10); also elsewhere on the board
GND: IC201.18 (VSSINT_1), IC201.29 (VSSINT_2), IC201.36 (VSSIO_1), IC201.47 (VSSIO_2), IC201.62 (VSSINT_3), IC201.72 (VSSIO_3), IC201.89 (VSSIO_4), IC201.90 (VSSINT_4), IC201.99 (VSSIO_5), IC201.108 (VSSIO_6), IC201.114 (VSSINT_5), IC201.123 (VSSIO_7), IC201.144 (VSSIO_8); also elsewhere on the board
IEI: IC201.46 (PB06_04); also elsewhere on the board
PIO0: IC201.49 (PB06_14); also elsewhere on the board
PIO1: IC201.50 (PB08_01); also elsewhere on the board
PIO2: IC201.51 (PB08_02); also elsewhere on the board
PIO3: IC201.52 (PB08_04); also elsewhere on the board
PIO4: IC201.53 (PB08_05); also elsewhere on the board
PIO5: IC201.54 (PB08_07); also elsewhere on the board
PIO6: IC201.56 (PB08_10); also elsewhere on the board
PIO7: IC201.57 (PB08_11); also elsewhere on the board
RSV_300: IC201.66 (PB10_10); also elsewhere on the board
RSV_GCK2: IC201.32 (PB02_13_GCK2), TP201.1; also elsewhere on the board
SEG0: IC201.87 (PB14_14); also elsewhere on the board
SEG1: IC201.86 (PB14_13); also elsewhere on the board
SEG2: IC201.85 (PB14_11); also elsewhere on the board
SEG3: IC201.83 (PB14_10); also elsewhere on the board
SEG4: IC201.82 (PB14_09); also elsewhere on the board
SEG5: IC201.81 (PB14_07); also elsewhere on the board
SEG6: IC201.80 (PB14_02); also elsewhere on the board
SWITCH0: IC201.70 (PB10_16); also elsewhere on the board
SWITCH1: IC201.69 (PB10_13); also elsewhere on the board
SWITCH2: IC201.68 (PB10_11); also elsewhere on the board
TCK: IC201.67 (TCK); also elsewhere on the board
TDI: IC201.63 (TDI); also elsewhere on the board
TDO: IC201.122 (TDO); also elsewhere on the board
TMS: IC201.65 (TMS); also elsewhere on the board

Notes on the sheet:
- CPLD - bypass capacitors

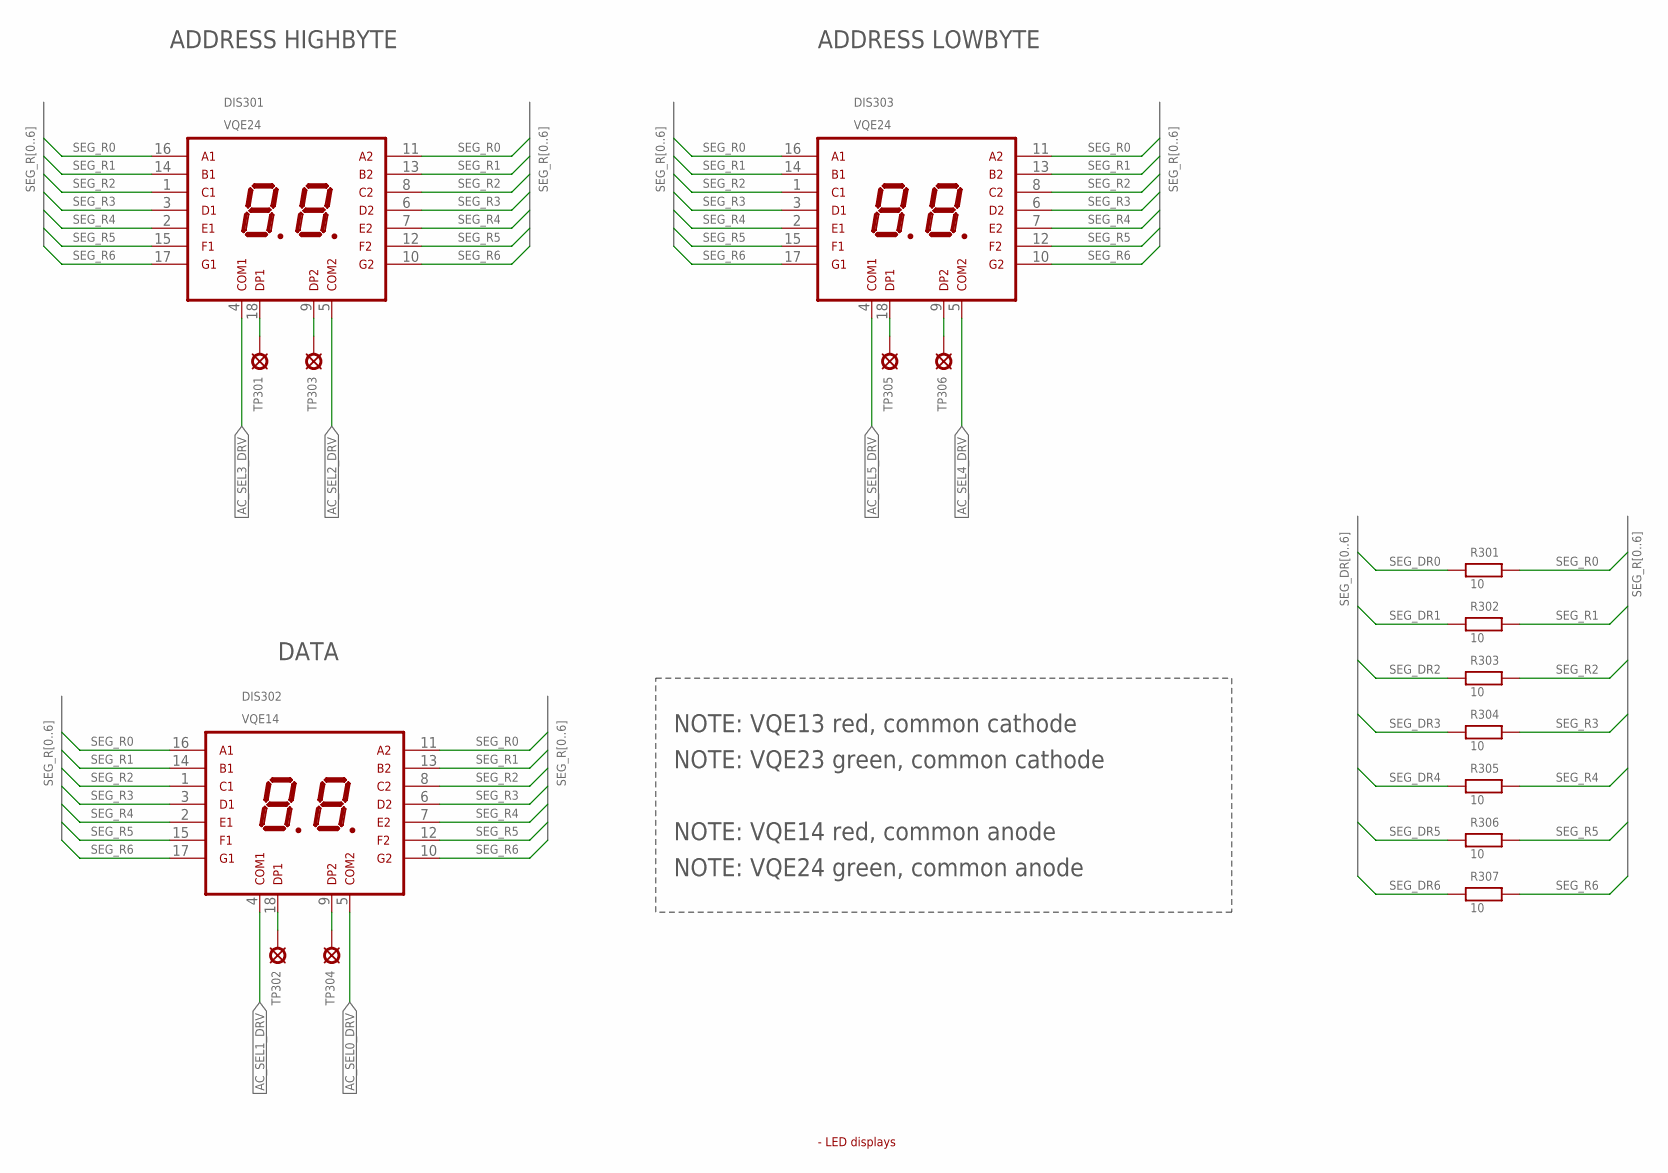
[picture p117: schematic Z80_BMO_V1.2.sch, sheet 3]

Parts:
DIS301, DIS303: VQE24; T_VQE_XX_2DIGIT; PART_CODE_BEL DIS_T_PAC_VQExx_2DIGIT_VAL_VQE24
DIS302: VQE14; T_VQE_XX_2DIGIT; PART_CODE_BEL DIS_T_PAC_VQExx_2DIGIT_VAL_VQE14
R301, R302, R303, R304, R305, R306, R307: 10; T_0207_GRID10MM; PART_CODE_BEL R_PAC_T_0207_GRID10mm_VAL_10
TP301, TP302, TP303, TP304, TP305, TP306: TEST_POINT_T_SMALL; T_TEST_POINT_SMALL

Connections:
AC_SEL0_DRV: DIS302.5 (COM2); also elsewhere on the board
AC_SEL1_DRV: DIS302.4 (COM1); also elsewhere on the board
AC_SEL2_DRV: DIS301.5 (COM2); also elsewhere on the board
AC_SEL3_DRV: DIS301.4 (COM1); also elsewhere on the board
AC_SEL4_DRV: DIS303.5 (COM2); also elsewhere on the board
AC_SEL5_DRV: DIS303.4 (COM1); also elsewhere on the board
unnamed: DIS303.9 (DP2), TP306.1
unnamed: DIS303.18 (DP1), TP305.1
unnamed: DIS301.9 (DP2), TP303.1
unnamed: DIS301.18 (DP1), TP301.1
unnamed: DIS302.9 (DP2), TP304.1
unnamed: DIS302.18 (DP1), TP302.1
SEG_DR0: R301.2; also elsewhere on the board
SEG_DR1: R302.2; also elsewhere on the board
SEG_DR2: R303.2; also elsewhere on the board
SEG_DR3: R304.2; also elsewhere on the board
SEG_DR4: R305.2; also elsewhere on the board
SEG_DR5: R306.2; also elsewhere on the board
SEG_DR6: R307.2; also elsewhere on the board
SEG_R0: DIS301.11 (A2), DIS301.16 (A1), DIS302.11 (A2), DIS302.16 (A1), DIS303.11 (A2), DIS303.16 (A1), R301.1
SEG_R1: DIS301.13 (B2), DIS301.14 (B1), DIS302.13 (B2), DIS302.14 (B1), DIS303.13 (B2), DIS303.14 (B1), R302.1
SEG_R2: DIS301.1 (C1), DIS301.8 (C2), DIS302.1 (C1), DIS302.8 (C2), DIS303.1 (C1), DIS303.8 (C2), R303.1
SEG_R3: DIS301.3 (D1), DIS301.6 (D2), DIS302.3 (D1), DIS302.6 (D2), DIS303.3 (D1), DIS303.6 (D2), R304.1
SEG_R4: DIS301.2 (E1), DIS301.7 (E2), DIS302.2 (E1), DIS302.7 (E2), DIS303.2 (E1), DIS303.7 (E2), R305.1
SEG_R5: DIS301.12 (F2), DIS301.15 (F1), DIS302.12 (F2), DIS302.15 (F1), DIS303.12 (F2), DIS303.15 (F1), R306.1
SEG_R6: DIS301.10 (G2), DIS301.17 (G1), DIS302.10 (G2), DIS302.17 (G1), DIS303.10 (G2), DIS303.17 (G1), R307.1

Notes on the sheet:
DATA
ADDRESS HIGHBYTE
ADDRESS LOWBYTE
NOTE: VQE13 red, common cathode
NOTE: VQE23 green, common cathode
NOTE: VQE14 red, common anode
NOTE: VQE24 green, common anode
- LED displays
