Blunk-electronic/TRAIN-Z/hardware/bus_monitor/eagle/Z80_BMO_V1.2.brd

## EAGLE design hardware/bus_monitor/eagle/Z80_BMO_V1.2.brd (continued)

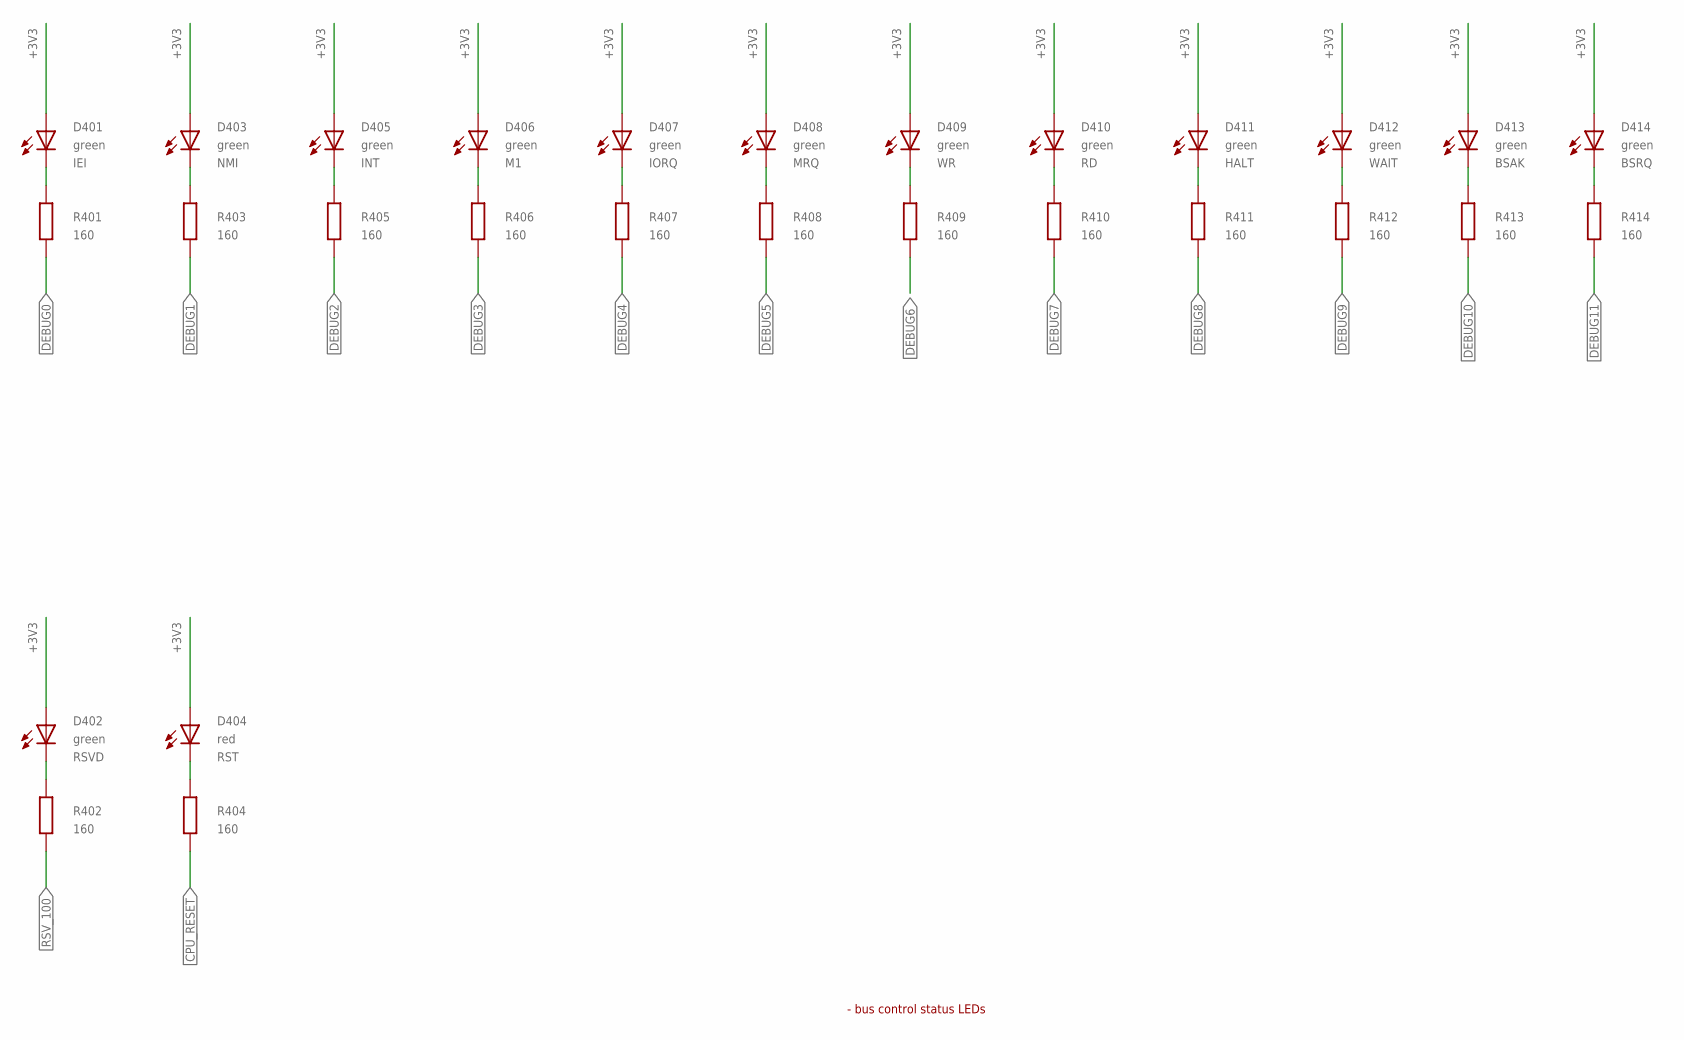
[picture p118: schematic Z80_BMO_V1.2.sch, sheet 4]

Parts:
D401, D402, D403, D405, D406, D407, D408, D409, D410, D411, D412, D413, D414: green; T_LED_3MM; PART_CODE_BEL LED_PAC_T_3mm_VAL_green
D404: red; T_LED_3MM; PART_CODE_BEL LED_PAC_T_3mm_VAL_red
R401, R402, R403, R404, R405, R406, R407, R408, R409, R410, R411, R412, R413, R414: 160; T_0207_GRID10MM; PART_CODE_BEL R_PAC_T_0207_GRID10mm_VAL_160

Connections:
!CPU_RESET: R404.2; also elsewhere on the board
+3V3: D401.A, D402.A, D403.A, D404.A, D405.A, D406.A, D407.A, D408.A, D409.A, D410.A, D411.A, D412.A, D413.A, D414.A; also elsewhere on the board
DEBUG0: R401.2; also elsewhere on the board
DEBUG0_LED: D401.C, R401.1
DEBUG1: R403.2; also elsewhere on the board
DEBUG1_LED: D403.C, R403.1
DEBUG2: R405.2; also elsewhere on the board
DEBUG2_LED: D405.C, R405.1
DEBUG3: R406.2; also elsewhere on the board
DEBUG3_LED: D406.C, R406.1
DEBUG4: R407.2; also elsewhere on the board
DEBUG4_LED: D407.C, R407.1
DEBUG5: R408.2; also elsewhere on the board
DEBUG5_LED: D408.C, R408.1
DEBUG6: R409.2; also elsewhere on the board
DEBUG6_LED: D409.C, R409.1
DEBUG7: R410.2; also elsewhere on the board
DEBUG7_LED: D410.C, R410.1
DEBUG8: R411.2; also elsewhere on the board
DEBUG8_LED: D411.C, R411.1
DEBUG9: R412.2; also elsewhere on the board
DEBUG9_LED: D412.C, R412.1
DEBUG10: R413.2; also elsewhere on the board
DEBUG10_LED: D413.C, R413.1
DEBUG11: R414.2; also elsewhere on the board
DEBUG11_LED: D414.C, R414.1
RST_LED_C: D404.C, R404.1
RSV_100: R402.2; also elsewhere on the board
RSV_100_LED: D402.C, R402.1

Notes on the sheet:
- bus control status LEDs

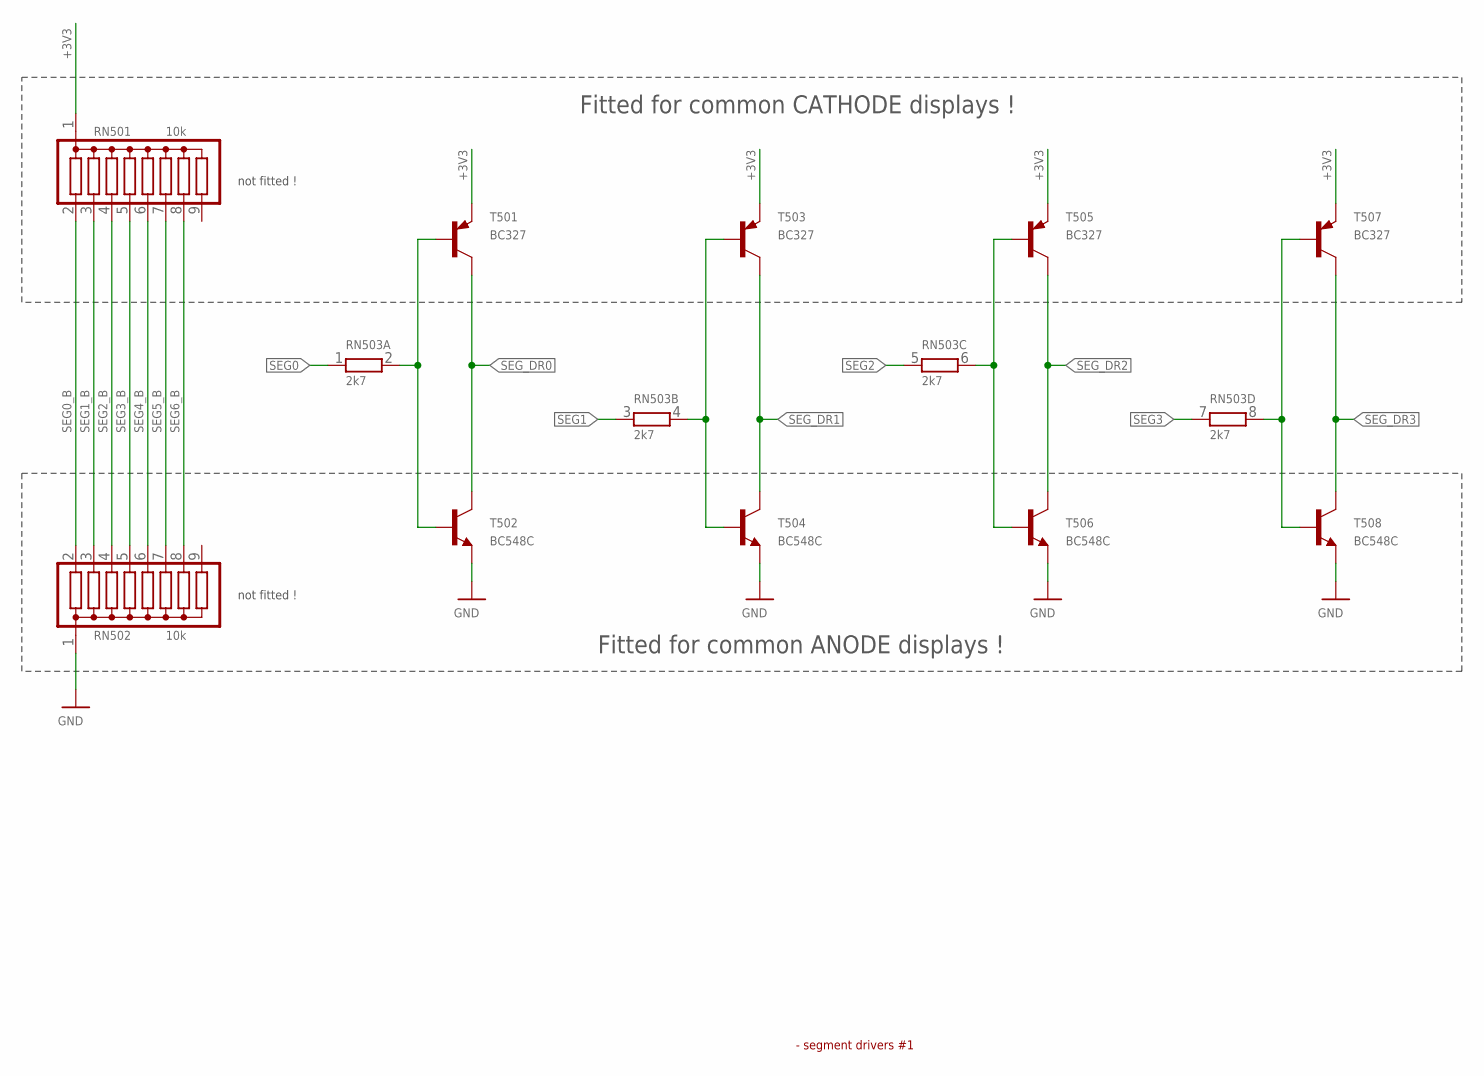
[picture p119: schematic Z80_BMO_V1.2.sch, sheet 5]

Parts:
RN501, RN502: 10k; T_SIL9; PART_CODE_BEL RN_PAC_T_SIL9_VAL_10k
RN503: 2k7; T_SIL8; PART_CODE_BEL RN_PAC_T_SIL8_VAL_2k7
T501, T503, T505, T507: BC327; T_TO92-CBE; PART_CODE_BEL T_PAC_T_TO92-CBE_VAL_BC327
T502, T504, T506, T508: BC548C; T_TO92-CBE; PART_CODE_BEL T_PAC_T_TO92-CBE_VAL_BC548C

Connections:
+3V3: RN501.1, T501.E, T503.E, T505.E, T507.E; also elsewhere on the board
GND: RN502.1, T502.E, T504.E, T506.E, T508.E; also elsewhere on the board
SEG0: RN503.1; also elsewhere on the board
SEG0_B: RN501.2, RN502.2, RN503.2, T501.B, T502.B
SEG1: RN503.3 (1); also elsewhere on the board
SEG1_B: RN501.3, RN502.3, RN503.4 (2), T503.B, T504.B
SEG2: RN503.5 (1); also elsewhere on the board
SEG2_B: RN501.4, RN502.4, RN503.6 (2), T505.B, T506.B
SEG3: RN503.7 (1); also elsewhere on the board
SEG3_B: RN501.5, RN502.5, RN503.8 (2), T507.B, T508.B
SEG4_B: RN501.6, RN502.6; also elsewhere on the board
SEG5_B: RN501.7, RN502.7; also elsewhere on the board
SEG6_B: RN501.8, RN502.8; also elsewhere on the board
SEG_DR0: T501.C, T502.C; also elsewhere on the board
SEG_DR1: T503.C, T504.C; also elsewhere on the board
SEG_DR2: T505.C, T506.C; also elsewhere on the board
SEG_DR3: T507.C, T508.C; also elsewhere on the board

Notes on the sheet:
Fitted for common ANODE displays !
Fitted for common CATHODE displays !
not fitted !
- segment drivers #1

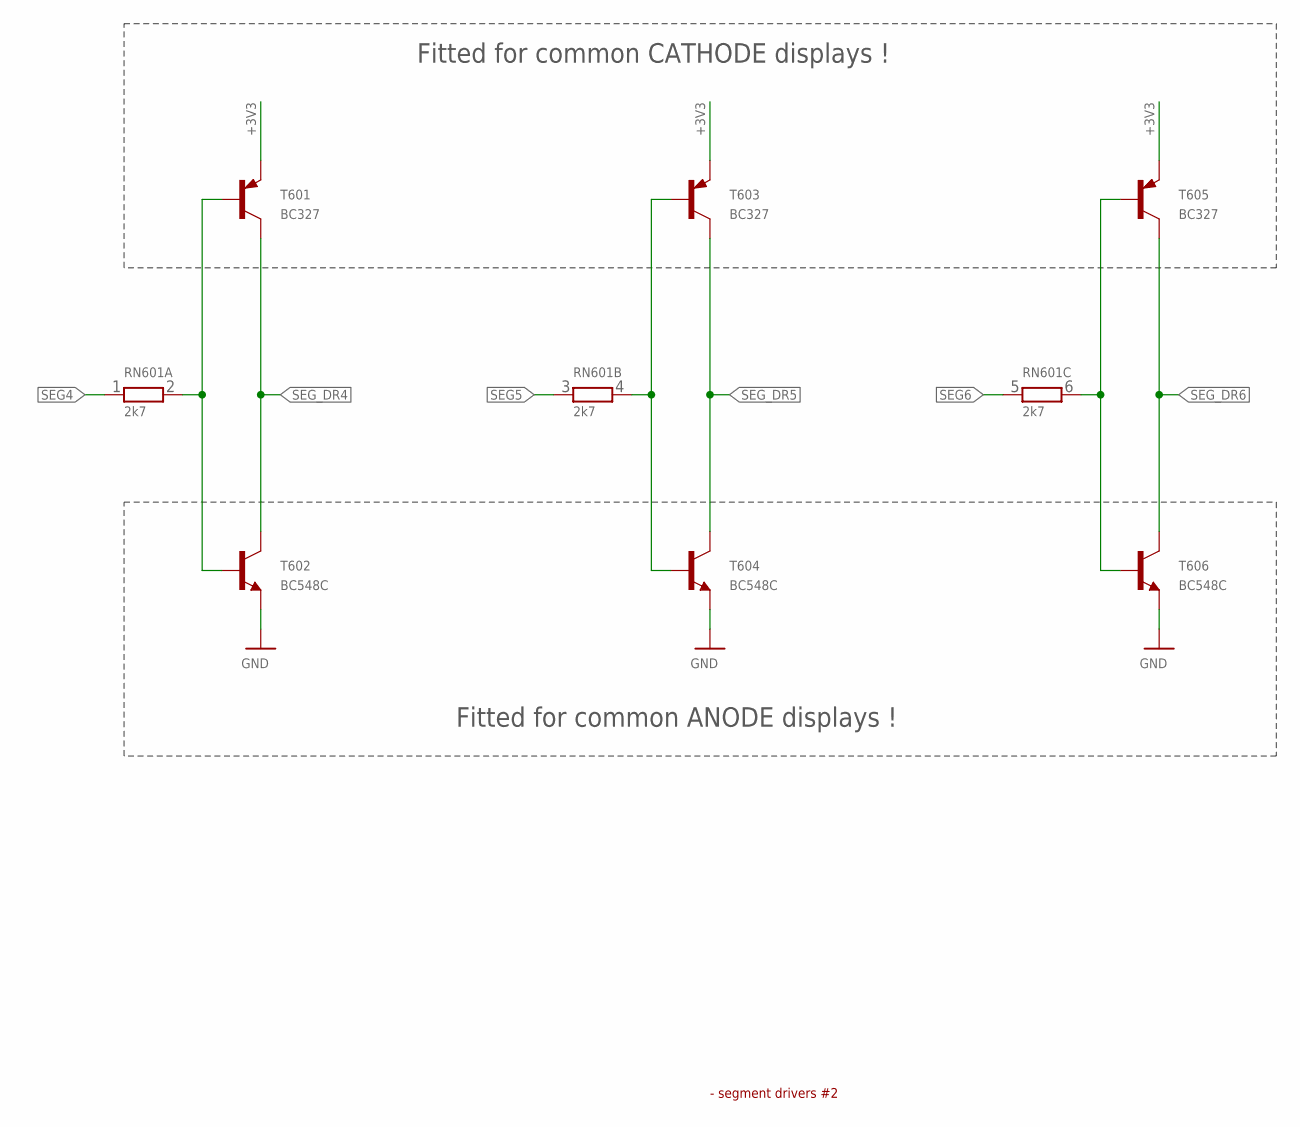
[picture p120: schematic Z80_BMO_V1.2.sch, sheet 6]

Parts:
RN601: 2k7; T_SIL8; PART_CODE_BEL RN_PAC_T_SIL8_VAL_2k7
T601, T603, T605: BC327; T_TO92-CBE; PART_CODE_BEL T_PAC_T_TO92-CBE_VAL_BC327
T602, T604, T606: BC548C; T_TO92-CBE; PART_CODE_BEL T_PAC_T_TO92-CBE_VAL_BC548C

Connections:
+3V3: T601.E, T603.E, T605.E; also elsewhere on the board
GND: T602.E, T604.E, T606.E; also elsewhere on the board
SEG4: RN601.1; also elsewhere on the board
SEG4_B: RN601.2, T601.B, T602.B; also elsewhere on the board
SEG5: RN601.3 (1); also elsewhere on the board
SEG5_B: RN601.4 (2), T603.B, T604.B; also elsewhere on the board
SEG6: RN601.5 (1); also elsewhere on the board
SEG6_B: RN601.6 (2), T605.B, T606.B; also elsewhere on the board
SEG_DR4: T601.C, T602.C; also elsewhere on the board
SEG_DR5: T603.C, T604.C; also elsewhere on the board
SEG_DR6: T605.C, T606.C; also elsewhere on the board

Notes on the sheet:
Fitted for common ANODE displays !
Fitted for common CATHODE displays !
- segment drivers #2

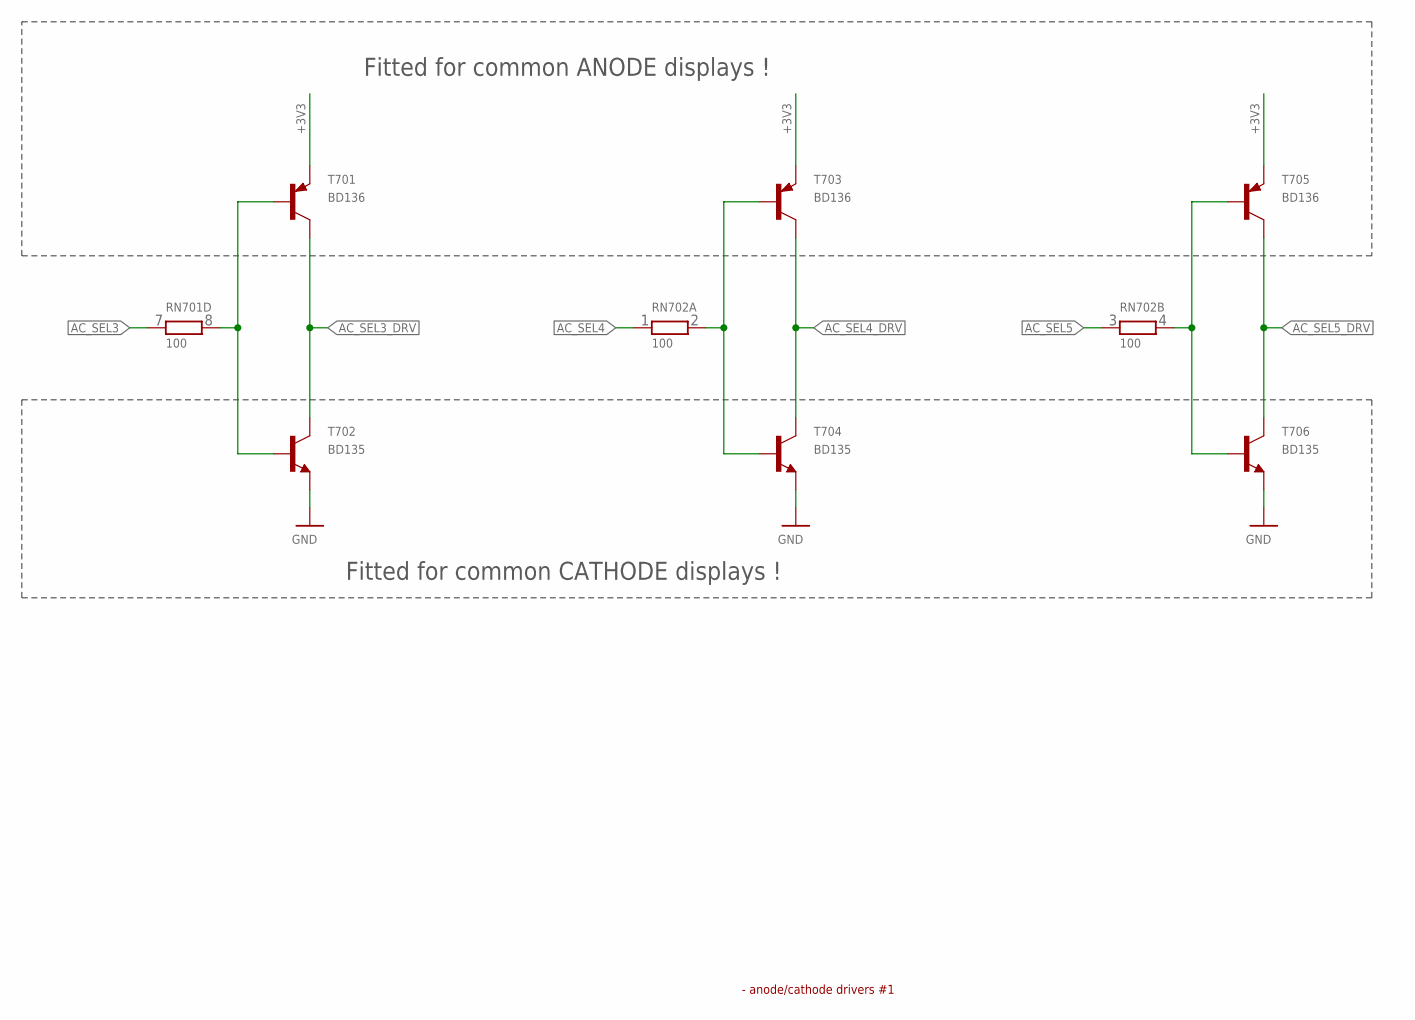
[picture p121: schematic Z80_BMO_V1.2.sch, sheet 7]

Parts:
RN701, RN702: 100; T_SIL8; PART_CODE_BEL RN_PAC_T_SIL8_VAL_100
T701, T703, T705: BD136; T_TO126_VERTICAL; PART_CODE_BEL T_PAC_T_TO126_VERTICAL_VAL_BD136
T702, T704, T706: BD135; T_TO126_VERTICAL; PART_CODE_BEL T_PAC_T_TO126_VERTICAL_VAL_BD135

Connections:
+3V3: T701.E, T703.E, T705.E; also elsewhere on the board
AC_SEL3: RN701.7 (1); also elsewhere on the board
AC_SEL3_DRV: T701.C, T702.C; also elsewhere on the board
AC_SEL4: RN702.1; also elsewhere on the board
AC_SEL4_DRV: T703.C, T704.C; also elsewhere on the board
AC_SEL5: RN702.3 (1); also elsewhere on the board
AC_SEL5_DRV: T705.C, T706.C; also elsewhere on the board
AC_SEL_B3: RN701.8 (2), T701.B, T702.B; also elsewhere on the board
AC_SEL_B4: RN702.2, T703.B, T704.B; also elsewhere on the board
AC_SEL_B5: RN702.4 (2), T705.B, T706.B; also elsewhere on the board
GND: T702.E, T704.E, T706.E; also elsewhere on the board

Notes on the sheet:
Fitted for common ANODE displays !
Fitted for common CATHODE displays !
- anode/cathode drivers #1

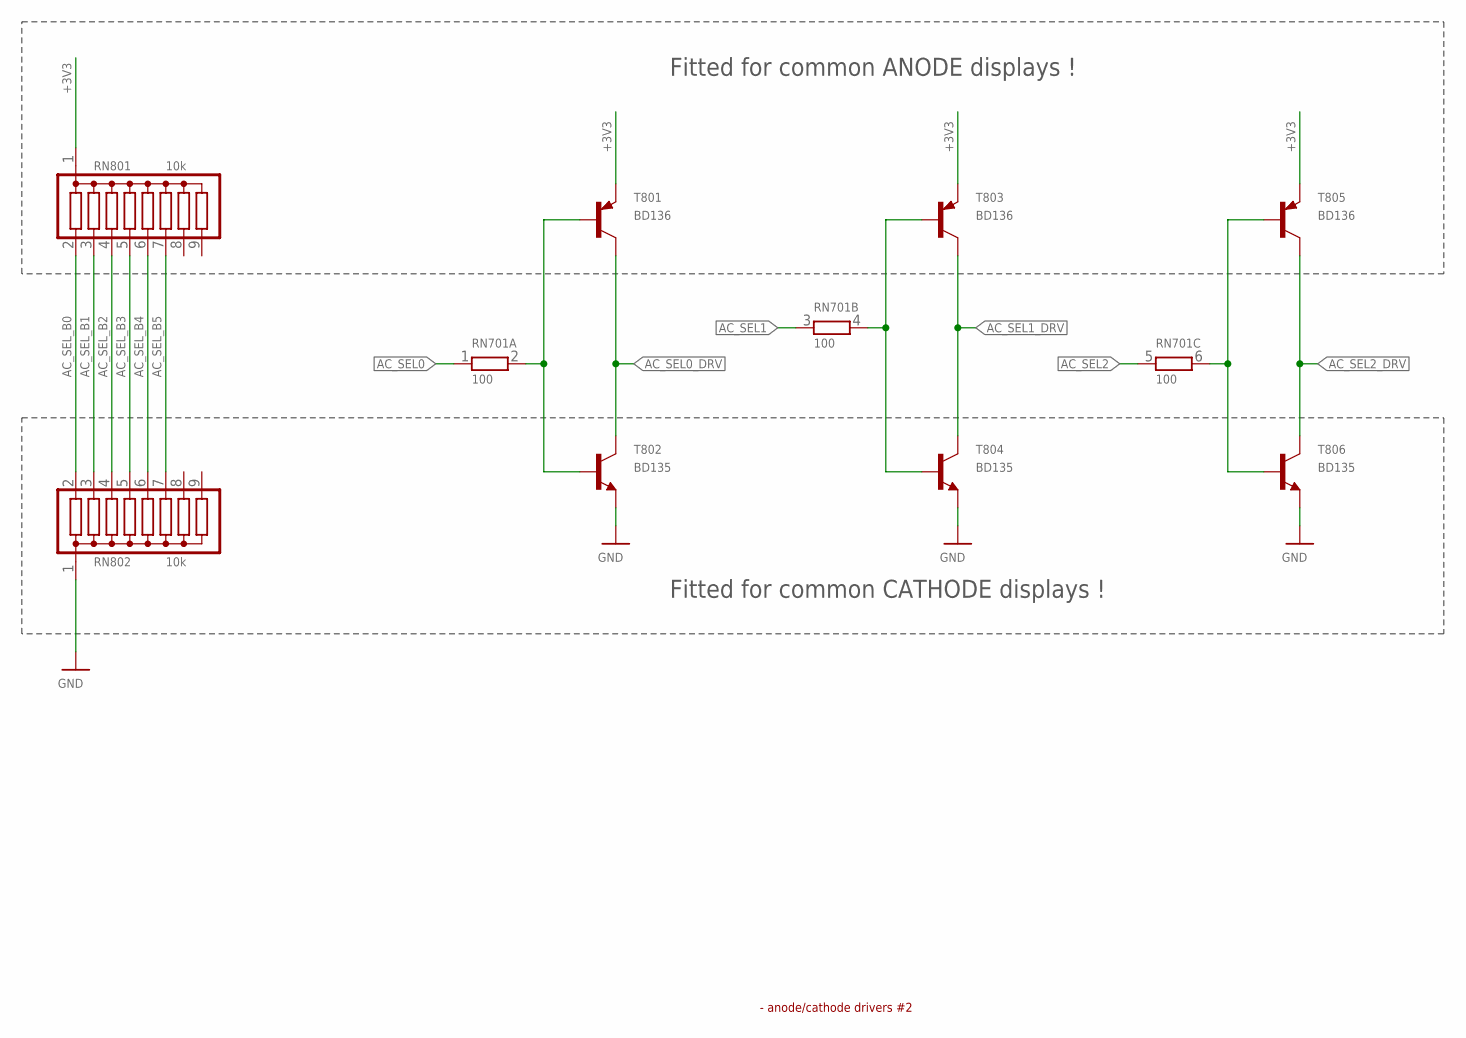
[picture p122: schematic Z80_BMO_V1.2.sch, sheet 8]

Parts:
RN701: 100; T_SIL8; PART_CODE_BEL RN_PAC_T_SIL8_VAL_100
RN801, RN802: 10k; T_SIL9; PART_CODE_BEL RN_PAC_T_SIL9_VAL_10k
T801, T803, T805: BD136; T_TO126_VERTICAL; PART_CODE_BEL T_PAC_T_TO126_VERTICAL_VAL_BD136
T802, T804, T806: BD135; T_TO126_VERTICAL; PART_CODE_BEL T_PAC_T_TO126_VERTICAL_VAL_BD135

Connections:
+3V3: RN801.1, T801.E, T803.E, T805.E; also elsewhere on the board
AC_SEL0: RN701.1; also elsewhere on the board
AC_SEL0_DRV: T801.C, T802.C; also elsewhere on the board
AC_SEL1: RN701.3 (1); also elsewhere on the board
AC_SEL1_DRV: T803.C, T804.C; also elsewhere on the board
AC_SEL2: RN701.5 (1); also elsewhere on the board
AC_SEL2_DRV: T805.C, T806.C; also elsewhere on the board
AC_SEL_B0: RN701.2, RN801.2, RN802.2, T801.B, T802.B
AC_SEL_B1: RN701.4 (2), RN801.3, RN802.3, T803.B, T804.B
AC_SEL_B2: RN701.6 (2), RN801.4, RN802.4, T805.B, T806.B
AC_SEL_B3: RN801.5, RN802.5; also elsewhere on the board
AC_SEL_B4: RN801.6, RN802.6; also elsewhere on the board
AC_SEL_B5: RN801.7, RN802.7; also elsewhere on the board
GND: RN802.1, T802.E, T804.E, T806.E; also elsewhere on the board

Notes on the sheet:
Fitted for common ANODE displays !
Fitted for common CATHODE displays !
- anode/cathode drivers #2

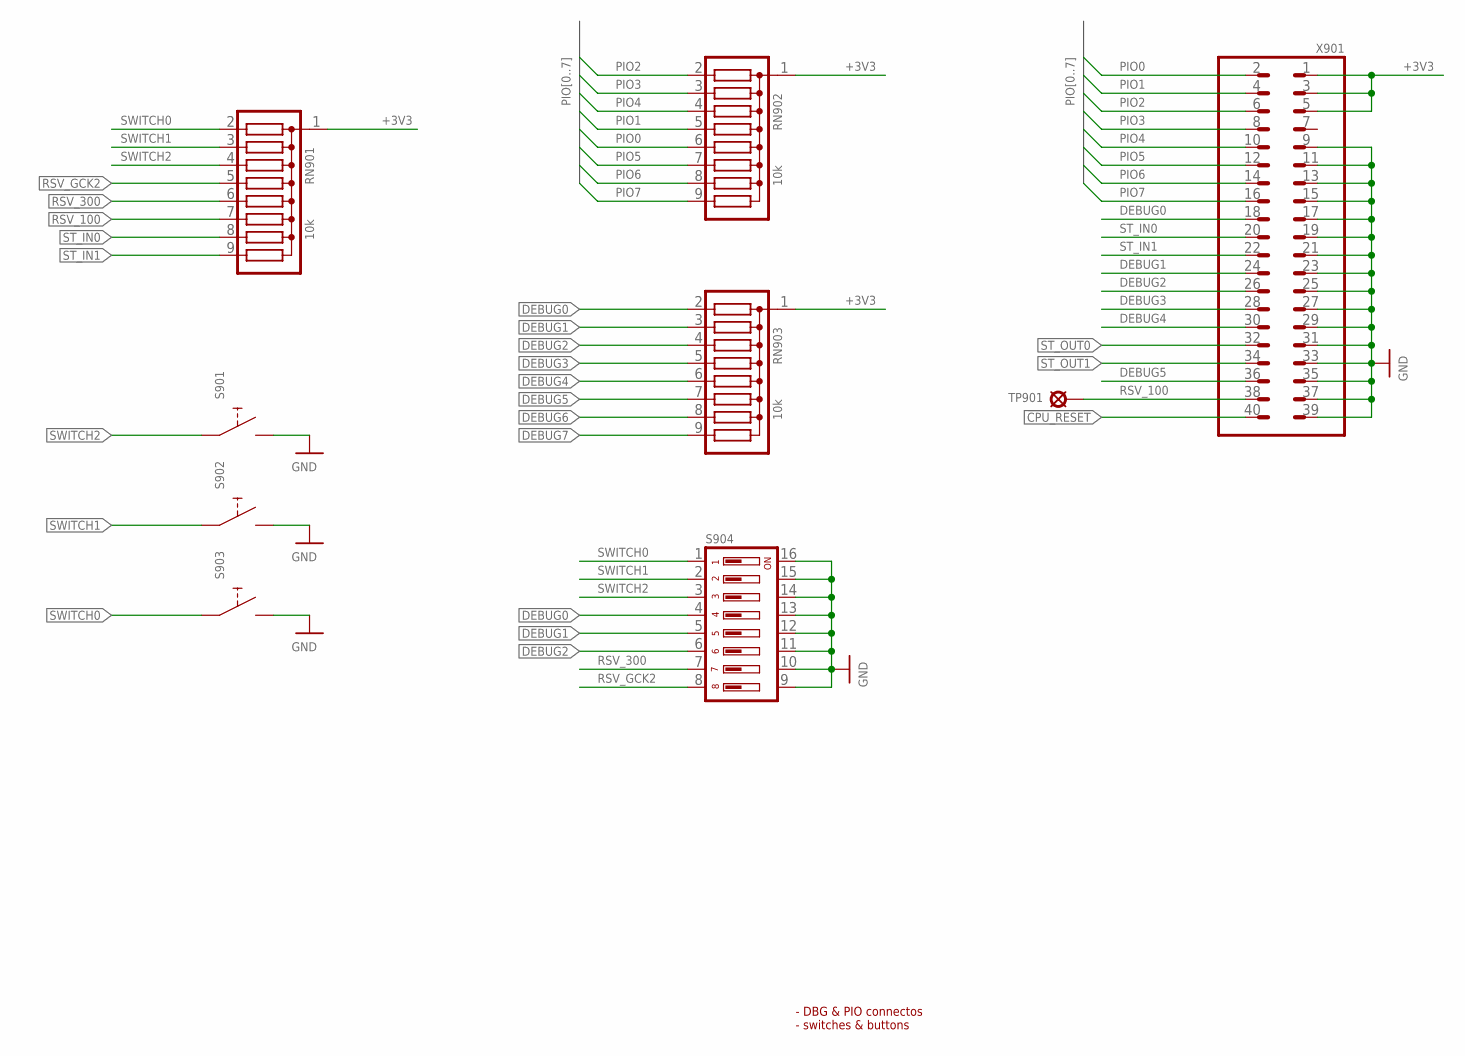
[picture p123: schematic Z80_BMO_V1.2.sch, sheet 9]

Parts:
RN901, RN902, RN903: 10k; T_SIL9; PART_CODE_BEL RN_PAC_T_SIL9_VAL_10k
S901, S902, S903: PUSH_BUTTON_T_6X6MM; T_PUSH_BUTTON_6X6
S904: DIP08; T_DIP08
TP901: TEST_POINT_T_SMALL; T_TEST_POINT_SMALL
X901: MALE_2X20-T-VERTICAL; T_MALE_2X20_VERTICAL

Connections:
!CPU_RESET: X901.40; also elsewhere on the board
+3V3: RN901.1, RN902.1, RN903.1, X901.1, X901.3, X901.5; also elsewhere on the board
DEBUG0: RN903.2, S904.4, X901.18; also elsewhere on the board
DEBUG1: RN903.3, S904.5, X901.24; also elsewhere on the board
DEBUG2: RN903.4, S904.6, X901.26; also elsewhere on the board
DEBUG3: RN903.5, X901.28; also elsewhere on the board
DEBUG4: RN903.6, X901.30; also elsewhere on the board
DEBUG5: RN903.7, X901.36; also elsewhere on the board
DEBUG6: RN903.8; also elsewhere on the board
DEBUG7: RN903.9; also elsewhere on the board
GND: S901.2 (B1), S901.4 (B1), S902.2 (B1), S902.4 (B1), S903.2 (B1), S903.4 (B1), S904.9, S904.10, S904.11, S904.12, S904.13, S904.14, S904.15, S904.16, X901.9, X901.11, X901.13, X901.15, X901.17, X901.19, X901.21, X901.23, X901.25, X901.27, X901.29, X901.31, X901.33, X901.35, X901.37, X901.39; also elsewhere on the board
PIO0: RN902.6, X901.2; also elsewhere on the board
PIO1: RN902.5, X901.4; also elsewhere on the board
PIO2: RN902.2, X901.6; also elsewhere on the board
PIO3: RN902.3, X901.8; also elsewhere on the board
PIO4: RN902.4, X901.10; also elsewhere on the board
PIO5: RN902.7, X901.12; also elsewhere on the board
PIO6: RN902.8, X901.14; also elsewhere on the board
PIO7: RN902.9, X901.16; also elsewhere on the board
RSV_100: RN901.7, TP901.1, X901.38; also elsewhere on the board
RSV_300: RN901.6, S904.7; also elsewhere on the board
RSV_GCK2: RN901.5, S904.8; also elsewhere on the board
ST_IN0: RN901.8, X901.20; also elsewhere on the board
ST_IN1: RN901.9, X901.22; also elsewhere on the board
ST_OUT0: X901.32; also elsewhere on the board
ST_OUT1: X901.34; also elsewhere on the board
SWITCH0: RN901.2, S903.1 (A1), S903.3 (A1), S904.1; also elsewhere on the board
SWITCH1: RN901.3, S902.1 (A1), S902.3 (A1), S904.2; also elsewhere on the board
SWITCH2: RN901.4, S901.1 (A1), S901.3 (A1), S904.3; also elsewhere on the board

Notes on the sheet:
- DBG & PIO connectos - switches & buttons

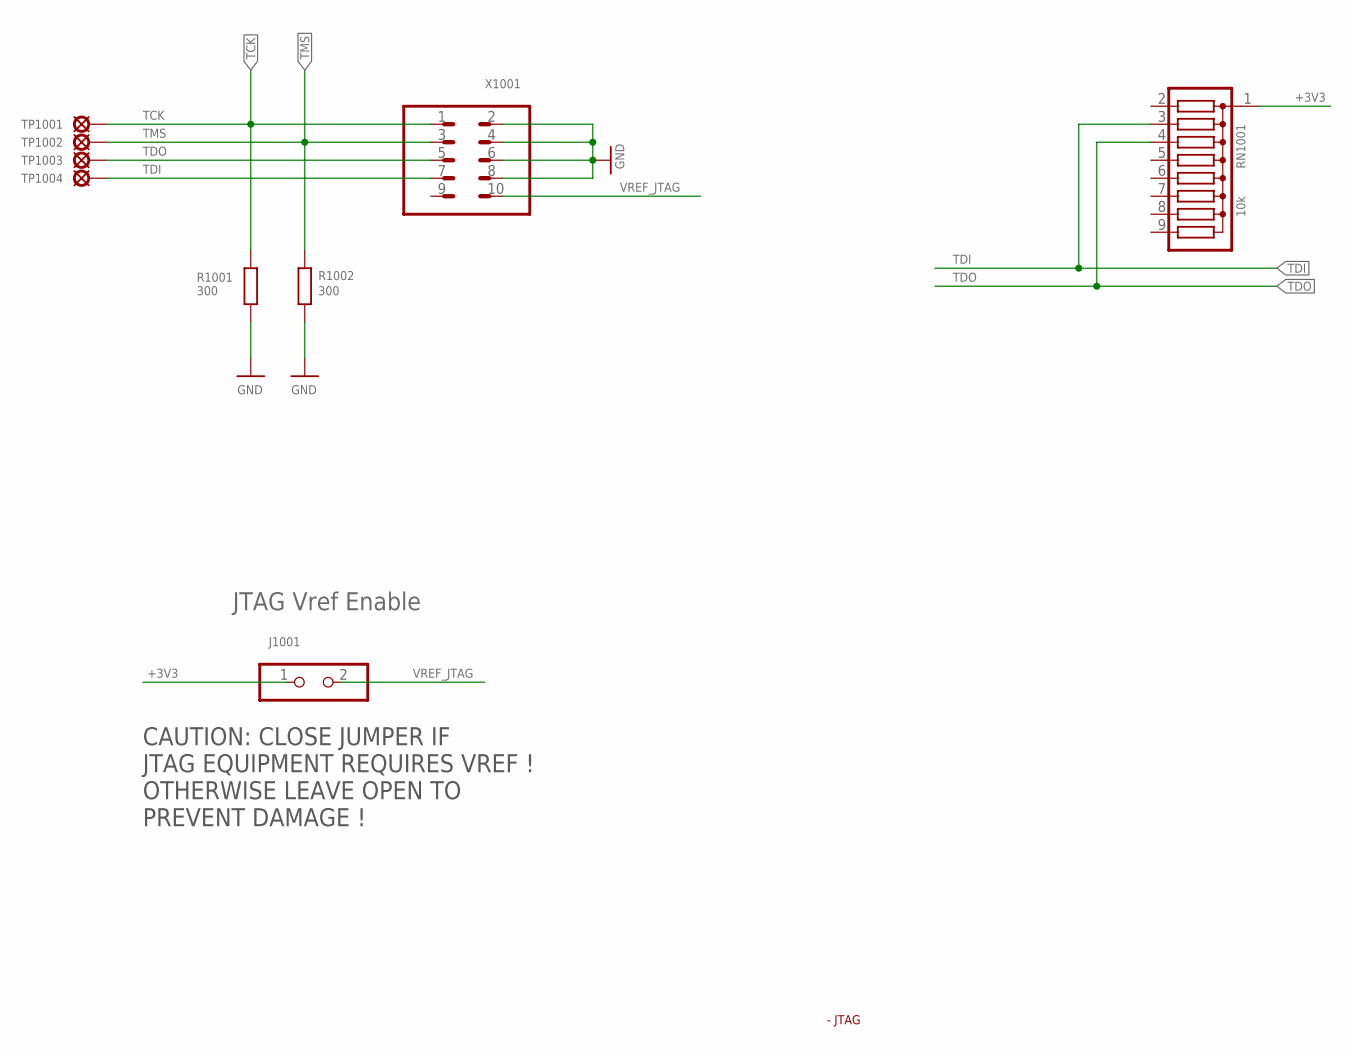
[picture p124: schematic Z80_BMO_V1.2.sch, sheet 10]

Parts:
J1001: JUMPER_1X2-T-VERTICAL; T_MALE_2X1_VERTICAL
R1001, R1002: 300; T_0207_GRID10MM; PART_CODE_BEL R_PAC_T_0207_GRID10mm_VAL_300
RN1001: 10k; T_SIL9; PART_CODE_BEL RN_PAC_T_SIL9_VAL_10k
TP1001, TP1002, TP1003, TP1004: TEST_POINT_T_SMALL; T_TEST_POINT_SMALL
X1001: MALE_2X5-T-VERTICAL_2.54MM; T_MALE_2X5_VERTICAL

Connections:
+3V3: J1001.1, RN1001.1; also elsewhere on the board
GND: R1001.2, R1002.2, X1001.2, X1001.4, X1001.6, X1001.8; also elsewhere on the board
TCK: R1001.1, TP1001.1, X1001.1; also elsewhere on the board
TDI: RN1001.3, TP1004.1, X1001.7; also elsewhere on the board
TDO: RN1001.4, TP1003.1, X1001.5; also elsewhere on the board
TMS: R1002.1, TP1002.1, X1001.3; also elsewhere on the board
VREF_JTAG: J1001.2, X1001.10

Notes on the sheet:
- JTAG
CAUTION: CLOSE JUMPER IF JTAG EQUIPMENT REQUIRES VREF ! OTHERWISE LEAVE OPEN TO PREVENT DAMAGE !

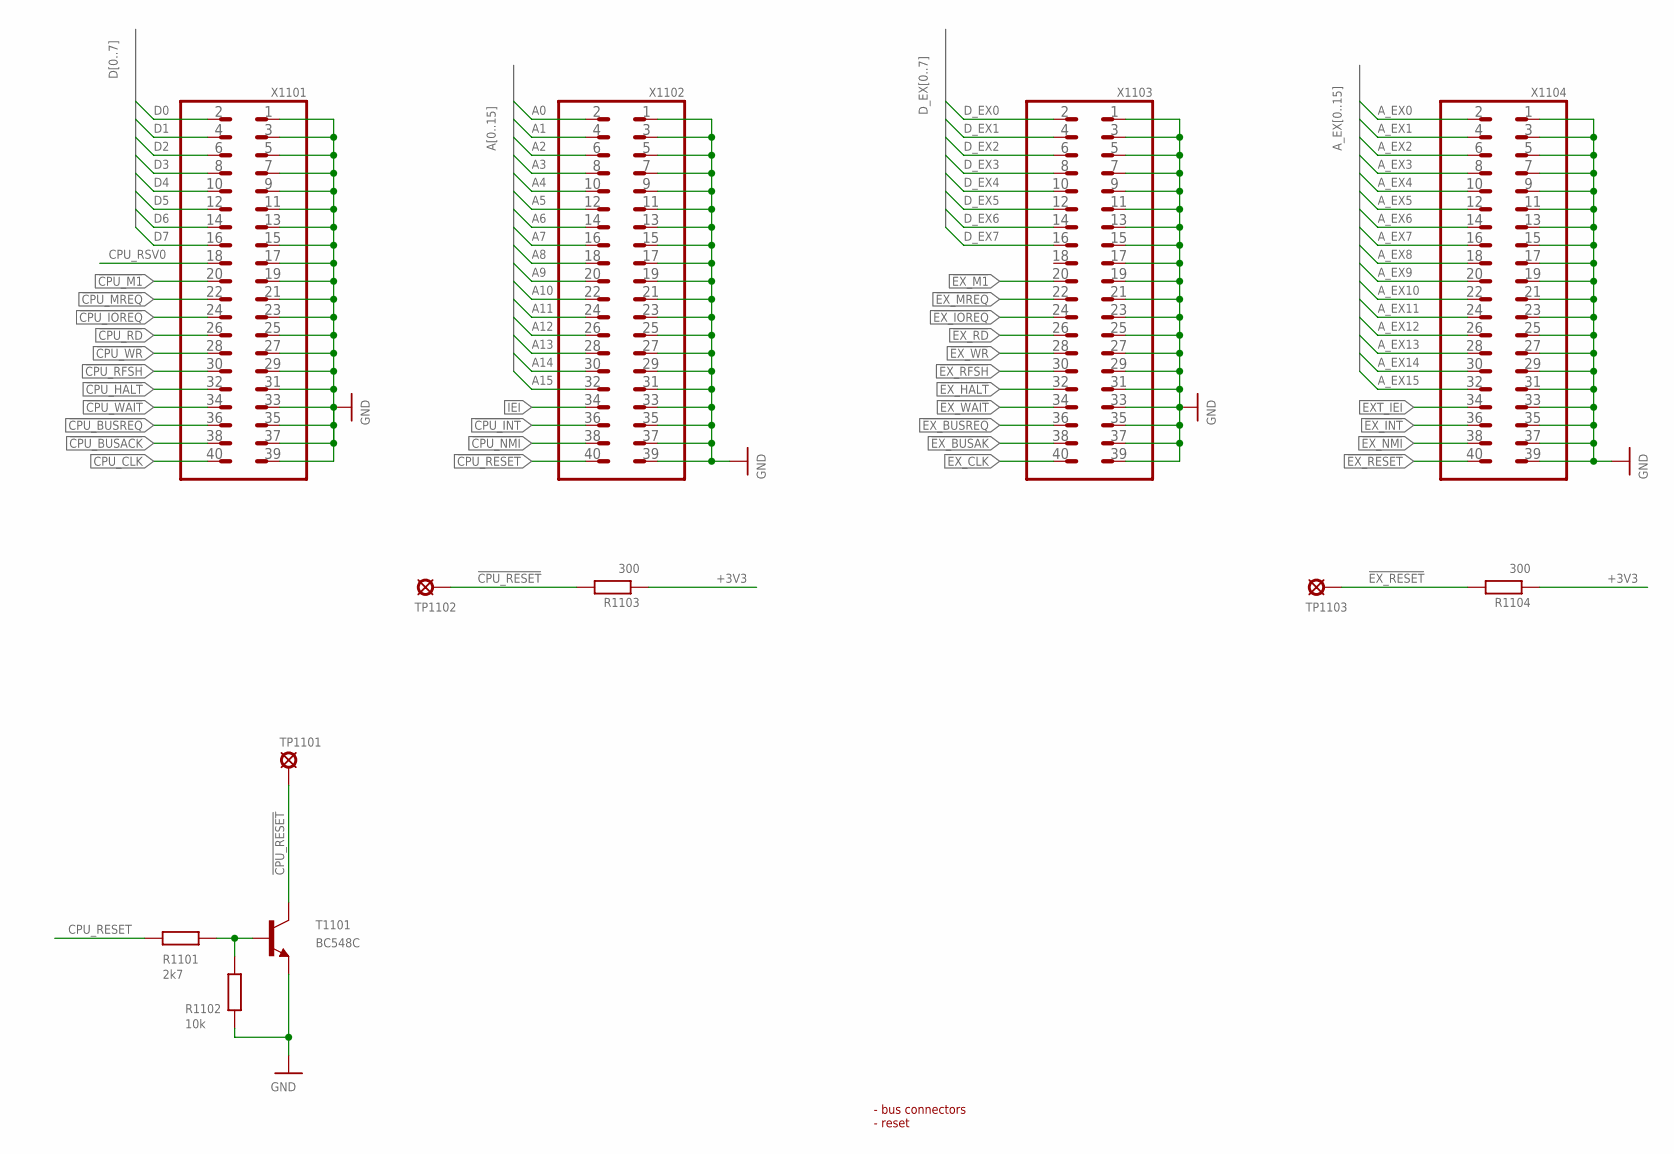
[picture p125: schematic Z80_BMO_V1.2.sch, sheet 11]

Parts:
R1101: 2k7; T_0207_GRID10MM; PART_CODE_BEL R_PAC_T_0207_GRID10mm_VAL_2k7
R1102: 10k; T_0207_GRID10MM; PART_CODE_BEL R_PAC_T_0207_GRID10mm_VAL_10k
R1103, R1104: 300; T_0207_GRID10MM; PART_CODE_BEL R_PAC_T_0207_GRID10mm_VAL_300
T1101: BC548C; T_TO92-CBE; PART_CODE_BEL T_PAC_T_TO92-CBE_VAL_BC548C
TP1101, TP1102, TP1103: TEST_POINT_T_SMALL; T_TEST_POINT_SMALL
X1101, X1102, X1103, X1104: MALE_2X20-T-VERTICAL; T_MALE_2X20_VERTICAL

Connections:
!CPU_BUSACK: X1101.38; also elsewhere on the board
!CPU_BUSREQ: X1101.36; also elsewhere on the board
!CPU_HALT: X1101.32; also elsewhere on the board
!CPU_INT: X1102.36; also elsewhere on the board
!CPU_IOREQ: X1101.24; also elsewhere on the board
!CPU_M1: X1101.20; also elsewhere on the board
!CPU_MREQ: X1101.22; also elsewhere on the board
!CPU_NMI: X1102.38; also elsewhere on the board
!CPU_RD: X1101.26; also elsewhere on the board
!CPU_RESET: R1103.2, T1101.C, TP1101.1, TP1102.1, X1102.40; also elsewhere on the board
!CPU_RFSH: X1101.30; also elsewhere on the board
!CPU_WAIT: X1101.34; also elsewhere on the board
!CPU_WR: X1101.28; also elsewhere on the board
!EX_BUSAK: X1103.38; also elsewhere on the board
!EX_BUSREQ: X1103.36; also elsewhere on the board
!EX_HALT: X1103.32; also elsewhere on the board
!EX_INT: X1104.36; also elsewhere on the board
!EX_IOREQ: X1103.24; also elsewhere on the board
!EX_M1: X1103.20; also elsewhere on the board
!EX_MREQ: X1103.22; also elsewhere on the board
!EX_NMI: X1104.38; also elsewhere on the board
!EX_RD: X1103.26; also elsewhere on the board
!EX_RESET: R1104.2, TP1103.1, X1104.40; also elsewhere on the board
!EX_RFSH: X1103.30; also elsewhere on the board
!EX_WAIT: X1103.34; also elsewhere on the board
!EX_WR: X1103.28; also elsewhere on the board
+3V3: R1103.1, R1104.1; also elsewhere on the board
A0: X1102.2; also elsewhere on the board
A1: X1102.4; also elsewhere on the board
A2: X1102.6; also elsewhere on the board
A3: X1102.8; also elsewhere on the board
A4: X1102.10; also elsewhere on the board
A5: X1102.12; also elsewhere on the board
A6: X1102.14; also elsewhere on the board
A7: X1102.16; also elsewhere on the board
A8: X1102.18; also elsewhere on the board
A9: X1102.20; also elsewhere on the board
A10: X1102.22; also elsewhere on the board
A11: X1102.24; also elsewhere on the board
A12: X1102.26; also elsewhere on the board
A13: X1102.28; also elsewhere on the board
A14: X1102.30; also elsewhere on the board
A15: X1102.32; also elsewhere on the board
A_EX0: X1104.2; also elsewhere on the board
A_EX1: X1104.4; also elsewhere on the board
A_EX2: X1104.6; also elsewhere on the board
A_EX3: X1104.8; also elsewhere on the board
A_EX4: X1104.10; also elsewhere on the board
A_EX5: X1104.12; also elsewhere on the board
A_EX6: X1104.14; also elsewhere on the board
A_EX7: X1104.16; also elsewhere on the board
A_EX8: X1104.18; also elsewhere on the board
A_EX9: X1104.20; also elsewhere on the board
A_EX10: X1104.22; also elsewhere on the board
A_EX11: X1104.24; also elsewhere on the board
A_EX12: X1104.26; also elsewhere on the board
A_EX13: X1104.28; also elsewhere on the board
A_EX14: X1104.30; also elsewhere on the board
A_EX15: X1104.32; also elsewhere on the board
CPU_CLK: X1101.40; also elsewhere on the board
CPU_RESET: R1101.2; also elsewhere on the board
CPU_RESET_B: R1101.1, R1102.1, T1101.B
CPU_RSV0: X1101.18
D0: X1101.2; also elsewhere on the board
D1: X1101.4; also elsewhere on the board
D2: X1101.6; also elsewhere on the board
D3: X1101.8; also elsewhere on the board
D4: X1101.10; also elsewhere on the board
D5: X1101.12; also elsewhere on the board
D6: X1101.14; also elsewhere on the board
D7: X1101.16; also elsewhere on the board
D_EX0: X1103.2; also elsewhere on the board
D_EX1: X1103.4; also elsewhere on the board
D_EX2: X1103.6; also elsewhere on the board
D_EX3: X1103.8; also elsewhere on the board
D_EX4: X1103.10; also elsewhere on the board
D_EX5: X1103.12; also elsewhere on the board
D_EX6: X1103.14; also elsewhere on the board
D_EX7: X1103.16; also elsewhere on the board
EXT_IEI: X1104.34; also elsewhere on the board
EX_CLK: X1103.40; also elsewhere on the board
GND: R1102.2, T1101.E, X1101.1, X1101.3, X1101.5, X1101.7, X1101.9, X1101.11, X1101.13, X1101.15, X1101.17, X1101.19, X1101.21, X1101.23, X1101.25, X1101.27, X1101.29, X1101.31, X1101.33, X1101.35, X1101.37, X1101.39, X1102.1, X1102.3, X1102.5, X1102.7, X1102.9, X1102.11, X1102.13, X1102.15, X1102.17, X1102.19, X1102.21, X1102.23, X1102.25, X1102.27, X1102.29, X1102.31, X1102.33, X1102.35, X1102.37, X1102.39, X1103.1, X1103.3, X1103.5, X1103.7, X1103.9, X1103.11, X1103.13, X1103.15, X1103.17, X1103.19, X1103.21, X1103.23, X1103.25, X1103.27, X1103.29, X1103.31, X1103.33, X1103.35, X1103.37, X1103.39, X1104.1, X1104.3, X1104.5, X1104.7, X1104.9, X1104.11, X1104.13, X1104.15, X1104.17, X1104.19, X1104.21, X1104.23, X1104.25, X1104.27, X1104.29, X1104.31, X1104.33, X1104.35, X1104.37, X1104.39; also elsewhere on the board
IEI: X1102.34; also elsewhere on the board

Notes on the sheet:
- bus connectors - reset
