Blunk-electronic/TRAIN-Z/hardware/bus_monitor/eagle/Z80_BMO_V1.2.brd

## EAGLE design hardware/bus_monitor/eagle/Z80_BMO_V1.2.brd (continued)

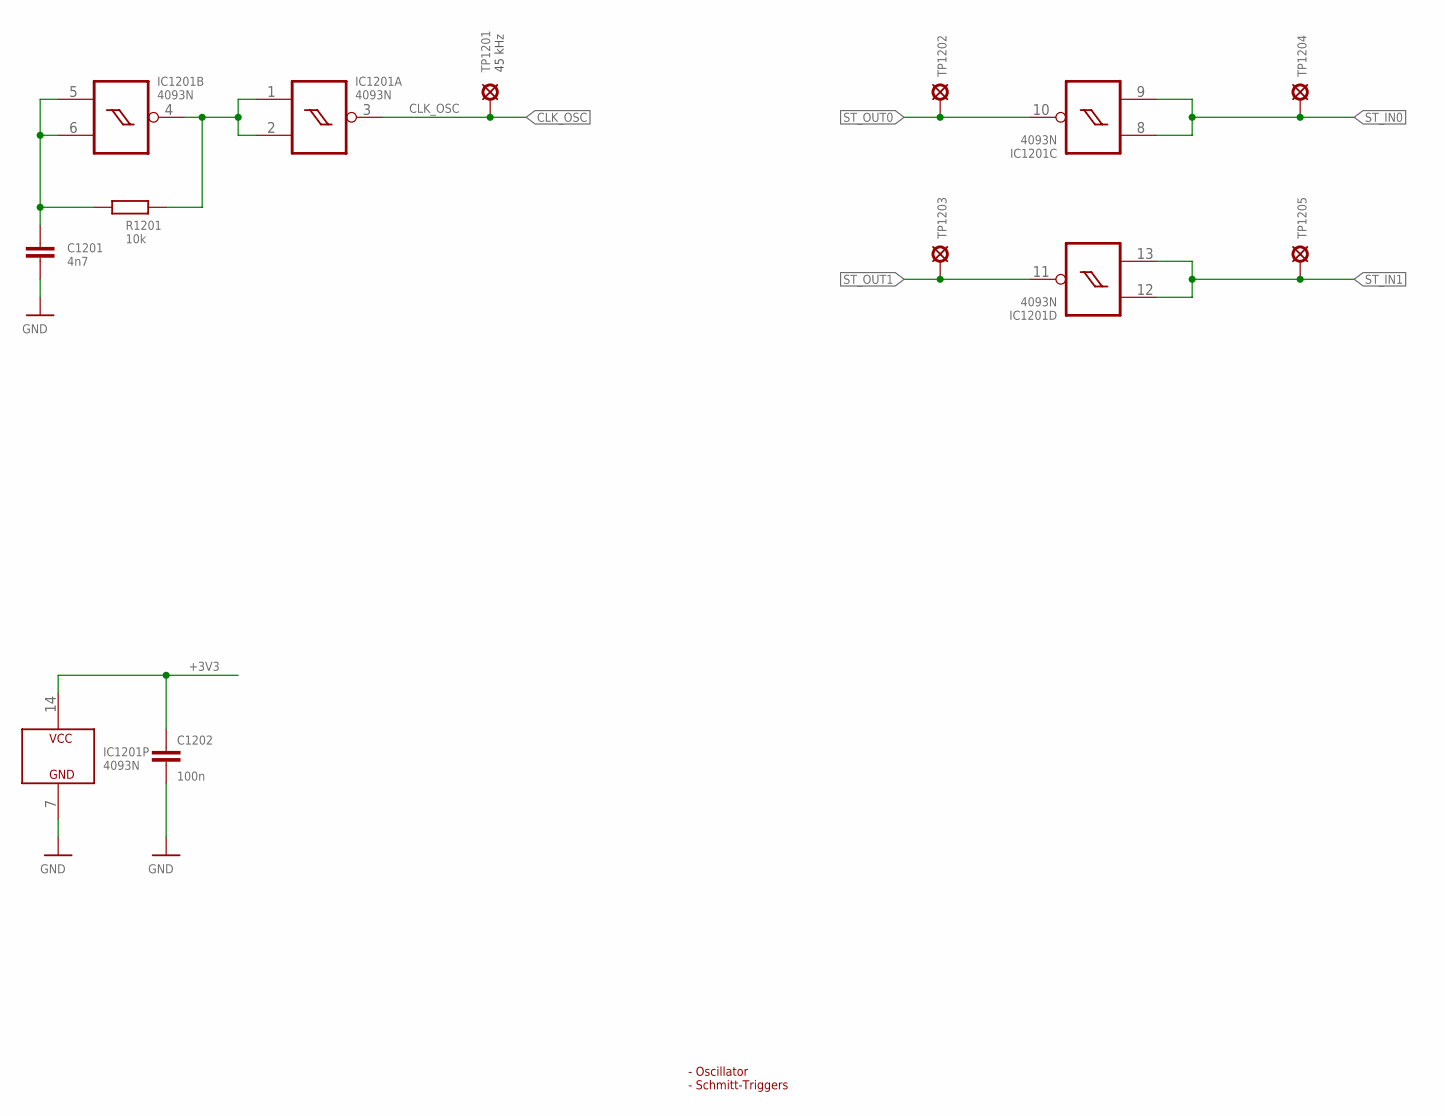
[picture p126: schematic Z80_BMO_V1.2.sch, sheet 12]

Parts:
C1201: 4n7; T_7X3MM_GRID_5MM; PART_CODE_BEL C_PAC_T_7x3mm_GRID_5mm_VAL_4n7
C1202: 100n; S_0805; PART_CODE_BEL C_PAC_S_0805_VAL_100n
IC1201: 4093N; T_NDIP14
R1201: 10k; T_0207_GRID10MM; PART_CODE_BEL R_PAC_T_0207_GRID10mm_VAL_10k
TP1201, TP1202, TP1203, TP1204, TP1205: TEST_POINT_T_SMALL; T_TEST_POINT_SMALL

Connections:
+3V3: C1202.1, IC1201.14 (VCC); also elsewhere on the board
CLK_OSC: IC1201.3 (O), TP1201.1; also elsewhere on the board
CLK_SLOW: IC1201.1 (I0), IC1201.2 (I1), IC1201.4 (O), R1201.1
GND: C1201.2, C1202.2, IC1201.7 (GND); also elsewhere on the board
unnamed: C1201.1, IC1201.5 (I0), IC1201.6 (I1), R1201.2
ST_IN0: IC1201.8 (I0), IC1201.9 (I1), TP1204.1; also elsewhere on the board
ST_IN1: IC1201.12 (I0), IC1201.13 (I1), TP1205.1; also elsewhere on the board
ST_OUT0: IC1201.10 (O), TP1202.1; also elsewhere on the board
ST_OUT1: IC1201.11 (O), TP1203.1; also elsewhere on the board

Notes on the sheet:
- Oscillator - Schmitt-Triggers
45 kHz

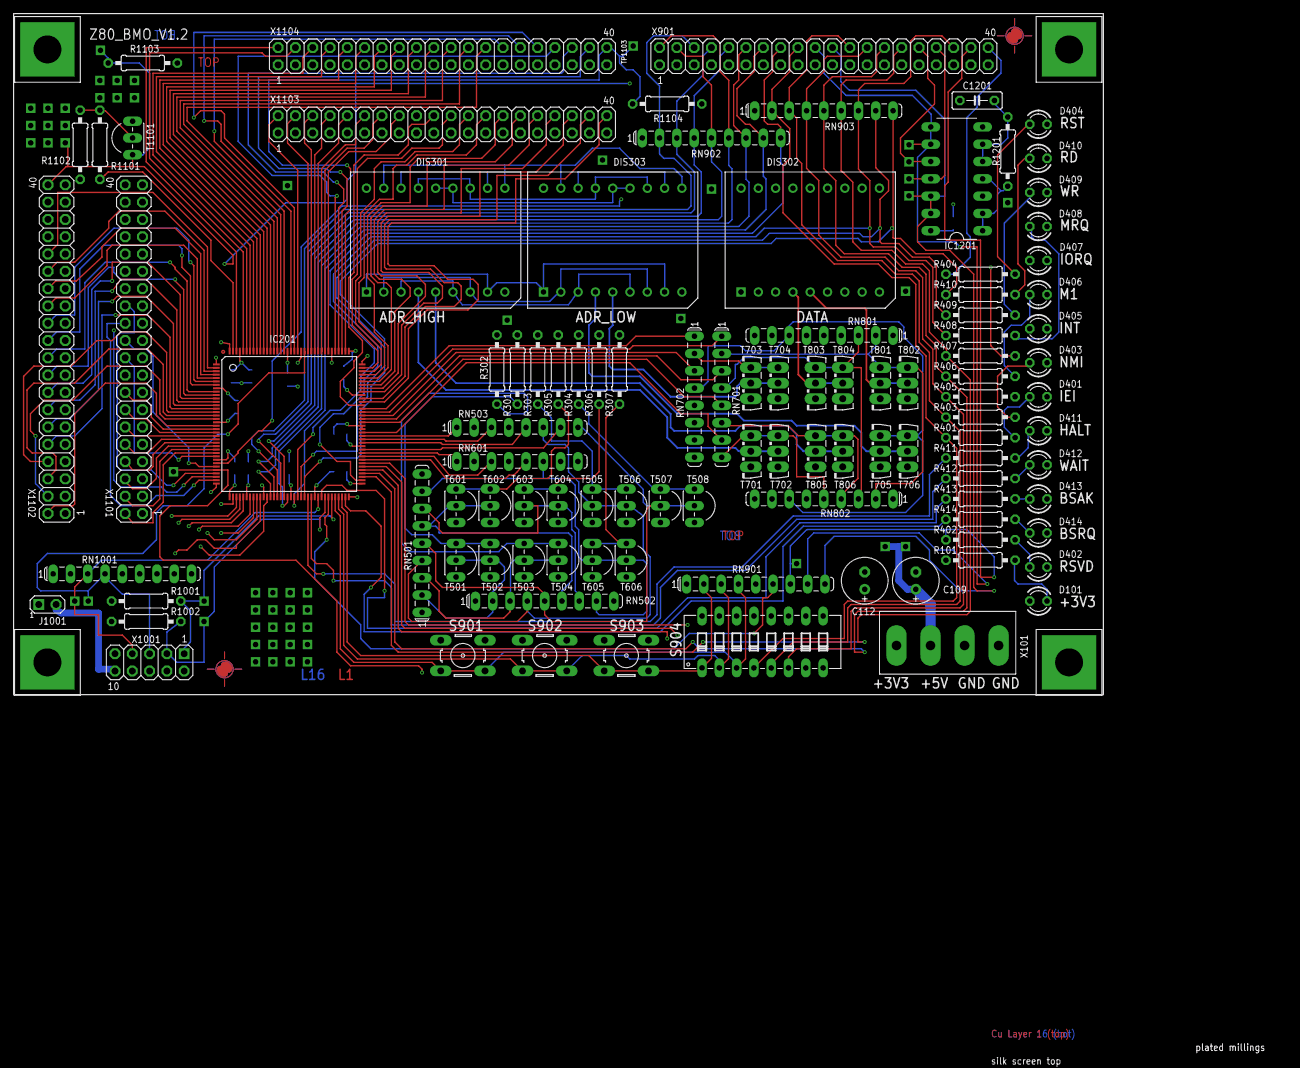
[picture p127: board Z80_BMO_V1.2.brd from above]

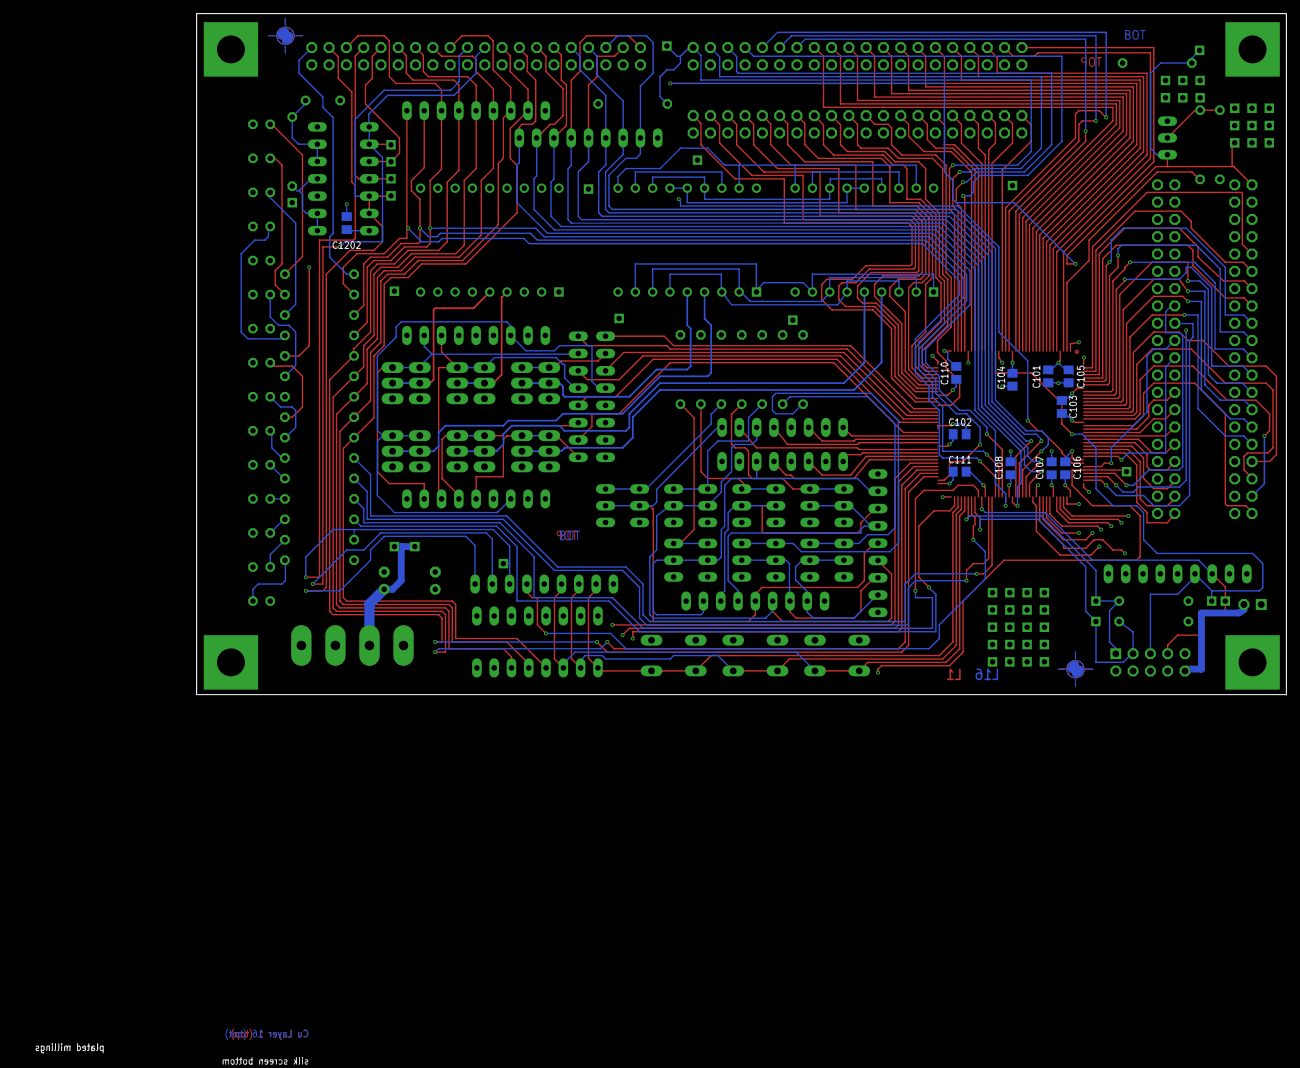
[picture p128: board Z80_BMO_V1.2.brd from below]

Board: 4 copper layers, 160.0 x 100.0 mm, 178 parts (11 on the bottom side), 188 nets.

Other parts of the board:
DRILEGEND: DRILEGEND
U$1: A4_LANDSCAPE
