Blunk-electronic/TRAIN-Z/(commit log)

2015-09-25 these are the eagle design files
    [MAIN_V093r3.brd, MAIN_V093r3.sch, MAIN_V093r4.brd, MAIN_V093r4.sch, MMU_V101r3.brd, MMU_V101r3.sch, MMU_V101r4.brd, MMU_V101r4.sch]
2015-09-27 cleaned up a lot
    [MAIN_V093r3.brd, MAIN_V093r3.sch, MAIN_V093r4.brd, MAIN_V093r4.sch, MMU_V101r3.brd, MMU_V101r3.sch, MMU_V101r4.brd, MMU_V101r4.sch]
